emiln2002/BMS/slave_v2/Sources/README.md

# foxBMS 2

foxBMS is a free, open and flexible development environment to design battery
management systems. It is the first modular open source BMS development
platform.

## Documentation

A current build of the documentation of this project can be found
here:
- [latest documentation build (of the most recent release)](https://iisb-foxbms.iisb.fraunhofer.de/foxbms/gen2/docs/html/latest/)
- [list of all available documentation builds](https://iisb-foxbms.iisb.fraunhofer.de/foxbms/gen2/docs/html/)

## Changelog

The project changelog is found in
[docs/general/changelog.rst](./docs/general/changelog.rst).

## License

The license information of the project is found in [LICENSE.md](./LICENSE.md).

Basically, the software is covered by the
[**BSD 3-Clause License (SPDX short identifier: BSD-3-Clause)**](https://opensource.org/licenses/BSD-3-Clause)
and the hardware and documentation by the
[**Creative Commons Attribution 4.0 International License (SPDX short identifier: CC-BY-4.0)**](https://creativecommons.org/licenses/by/4.0/legalcode).

## Open Source Hardware Certification

foxBMS 2 has been certified as open source hardware by the
Open Source Hardware Association under the OSHWA UID
[DE000128](https://certification.oshwa.org/de000128.html).

## Acknowledgment

For funding acknowledgements and instructions on how to acknowledge foxBMS 2
please see [foxbms.org/acknowledgements](https://foxbms.org/acknowledgements/).
