emiln2002/BMS/master-v1.2.3-0/Sources/Project Outputs for foxbms2-master/pdf/foxbms2-master-Bill of Materials-v1.2.3-0.PDF

BR2477A/HBN 22u/10V | CoinCell Battery3V 1000mAHHITEMP MLCC | BT6401 C1100, C1101, C5000, C5001, C5002, C5007, C5010, C5013, C5016, C5017, C5018, C5019, C5020, C7210, C7211, C7212, C7220, C7239, C7240, C7247, C7248, C7250, C7251 | BR2477A-HBN CAPC3216X18N | BR2477A/HBN gen_C_ceramic_22u_1 0V_X7R_1206 | 1 23

100n/50V | MLCC | C1102, C1109_1, C1109_2, C1112_1, C1112_2, C1115, C1203, C1205, C1207, C1211, C1213, C1217, C1219, C1220, C1221, C1222, C1223, C1602, C3000, C4345, C4346, C4503_1, C4503_2, C4505_1, C4505_2, C5003, C5004, C5005, C5006, C5008, C5011, C5014, C5015, C5021, C5022, C5023, C5024, C5025, C5026, C5027, C5028, C6100, C6101, C6201, C6202, C6204, C6206, C6301_1, C6301_2, C6301_3, C6400, C6401, C6403, C6500, C6600, C6605, C7113, C7114, C7213, C7215, C7221, C7222, C7223, C7227, C7228, C7230, C7231, C7232, C7234, C7238, C7242, C7246, C7249, C7300_1, C7300_2, C8003, C8007, C8009 | CAPC1005X06N | gen_C_ceramic_100n_ 50V_X7R_0402 | 78

100n/100V | MLCC | C1103_1, C1103_2, C4501_1, C4501_2, C7000, C7109, C7111, C7115, C7206, C7218, C7226 | CAPC1608X08N | gen_C_ceramic_100n_ 100V_X7R_0603 | 11

1u/100V 10u/100V | MLCC | C1104_1, C1104_2 C1105_1, C1105_2, C7105, C7106, C7107, C7108, C7207, C7208, C7209, C7301_1, C7301_2, C7302_1, C7302_2 | CAPC3216X18N CAPC5750X28N | gen_C_ceramic_1u_10 0V_X7R_1206 gen_C_ceramic_10u_1 00V_X7S_2220 | 2 13

4n7/50V | MLCC | C1106_1, C1106_2 | CAPC1005X06N | gen_C_ceramic_4n7_5 0V_X7R_0402 | 2

10u/16V | MLCC | C1107_1, C1107_2, C1110_1, C1110_2, C1200, C1208, C1214, C6402, C7216, C7224, C7229, C7233, C7235, C7241, C8006, C8008, C8012 | CAPC2012X14N | gen_C_ceramic_10u_1 6V_X7R_0805 | 17

1u/50V | MLCC | C1108_1, C1108_2, C1111_1, C1111_2, C1202, C1204, C1206, C1210, C1212, C1216, C1218, C1600, C1601, C4344, C4347, C6200, C6203, C6205, C6300_1, C6300_2, C6300_3, C6606, C7110, C7116 | CAPC1608X08N | gen_C_ceramic_1u_50 V_X7R_0603 | 24

10n/25V | MLCC | C1201, C1209, C1215, C5009, C5012, C7001, C7244, C7245 | CAPC1005X06N | gen_C_ceramic_10n_2 5V_X7R_0402 | 8

1n/3000V | MLCC | C1224 | CAPC2220(5750)230_ N | gen_C_ceramic_1n_30 00V_X7R_2220 | 1

220n/35V 4u7/25V 150p/50V | MLCC MLCC MLCC | C1604, C7305_1, C7305_2 C1603 C4400, C4401, C7118, C7119, C7201 | CAPC1005X06N CAPC2012X14N CAPC1005X06N | gen_C_ceramic_220n_ gen_C_ceramic_4u7_2 5V_X7R_0805 gen_C_ceramic_150p_ 50V_C0G_0402 35V_X7R_0402 | 1 5 3

100µF/63V 10n/100V | SMDElectrolytic Capacitor MLCC | C4500_1, C4500_2 C4502_1, C4502_2, C4504_1, C4504_2, C4506_1, C4506_2, C4507_1, C4507_2 | ELECTROLYTIC_CAP_ PANASONIC_G CAPC1608X08N | EEE-TG1J101UP gen_C_ceramic_10n_1 00V_X7R_0603 | 2 8

47n/50V | MLCC | C6601, C7117, C7214, C7243, C7303_1, C7303_2 | CAPC1005X06N | gen_C_ceramic_47n_5 0V_X7R_0402 | 6

22n/50V | MLCC | C6602, C6604, C8000, C8001, C8002, C8004, C8005, C8010, C8011, C8013, C8014 | CAPC1005X06N | gen_C_ceramic_22n_5 0V_X7R_0402 | 11

27p/50V 22u/25V | MLCC | C6603 C7100, C7101, C7102, C7103, C7104 | CAPC1608X08N CAPC3225X25N | gen_C_ceramic_27p_5 gen_C_ceramic_22u_2 5V_X7R_1210 0V_NP0_0603 | 5 1

47p/50V 8n2/50V 5n6/50V | MLCC MLCC MLCC | C7112 C7200 C7120 | CAPC1005X06N CAPC1608X08N CAPC1608X08N | gen_C_ceramic_47p_5 0V_C0G_0402 gen_C_ceramic_8n2_5 gen_C_ceramic_5n6_5 0V_C0G_0603 0V_C0G_0603 | 1 1 1

33µF/100V 47n/100V 1n/100V 4u7/100V | SMDElectrolytic Capacitor MLCC MLCC MLCC | C7205 C7217, C7225 C7219, C7236, C7237 C7304_1, C7304_2 | ELECTROLYTIC_CAP_ PANASONIC_G CAPC1608X08N CAPC1005X06N CAPC3225X25N | EEE-TG2A330P gen_C_ceramic_47n_1 00V_X7R_0603 gen_C_ceramic_1n_10 0V_X7R_0402 gen_C_ceramic_4u7_1 00V_X7S_1210 | 1 2 3 2

1N4148WQ-7-F | Diode | D1100, D4400, D4401, D6400, D7004, D7006, D7303_1, D7303_2, D7305_1, D7305_2, D8000 | SOD-123_CASE-425-04-ISSUE-G | 1N4148WQ-7-F | 11

SM24CANB-02HTG puregreen | CANESDProtection DiodeArray TLMP1100-GS08 | D1102_1, D1102_2 D1200, D1201, D5000, D6601, D7000, D7001, D7002, D7005, D7200 | LF_SOT23-3 LEDC1608X07N | SM24CANB-02HTG LED_0603_pure_green _AECQ | 2 9

SZMMSZ4688T1G | Zener Diode | D4200_1, D4200_2, D4200_3, D4200_4, D4200_5, D4200_6, D4200_7, D4200_8, D6401, D7202 D4500_1, D4500_2, | SOD-123_CASE-425-04-ISSUE-G | SZMMSZ4688T1G | 10

SMA6J60A-Q | TVS-DiodeDO-214AC (SMA) | D4501_1, D4501_2, D4502_1, D4502_2, D4503_1, D4503_2 | BOURNS_DO-214AC_SMA | SMA6J60A-Q | 8

DFLS1100Q-7 DFLS130LQ-7 SZMMSZ5261BT1G SZMMSZ5237BT1G SZNUP2301MW6T1G | SchottkyDiode SchottkyDiode Zener Diode Zener Diode TVSdiodearray | D7100, D7101, D7102, D7201 D7203 D7307_1, D7307_2 D7306_1, D7306_2 D8001 | PowerDI123 PowerDI123 SOD-123_CASE-425-SOD-123_CASE-425-04-ISSUE-G ONSEMI_SC-88_SOT-363 04-ISSUE-G | DFLS130LQ-7 DFLS1100Q-7 SZMMSZ5237BT1G SZNUP2301MW6T1G SZMMSZ5261BT1G | 1 4 2 1 2

600Ω 64900429522 | FerriteBead | FB5000, FB5001, FB5002 J2000, J2002, J2003, J2004, J2006, J2007, J2008, J2010, J2021, J2024, J2034 | RESC1005X04N 64900429522 | gen_Ferrite_600R_040 2 CMP-1502-00518-2 | 3 11

64900829522 64900229522 64900629522 samtec_FTSH-103-01-L-DV | Board-To-Board Connector, 6pin, 1.27mm | J2009 J2033 J2013 J3000 | 64900829522 64900229522 64900629522 SAMTEC_FTSH-103-01-L-DV | CMP-1502-00520-2 CMP-1502-00517-2 CMP-1502-00519-2 samtec_FTSH-103-01-L-DV | 1 1

TE_2-5767004-2 ERM8-020-09.0-L-DV-K-TR | EdgeRateruggedhigh-Connector, SMT, 38 POS, MICTOR speedconnector strips | J3008 J9000 | TE_2-5767004-2 SAMTEC_ERM8-020-09.0-L-DV-K | TE_2-5767004-2 SAMTEC_ERM8-020-09.0-L-DV-K-TR | 1 1

ERM8-030-09.0-L-DV-K-TR | EdgeRateruggedhigh-speedconnector strips | J9001 | SAMTEC_ERM8-030-09.0-L-DV-K | SAMTEC_ERM8-030-09.0-L-DV-K-TR | 1

ERM8-060-09.0-L-DV-K-TR | EdgeRateruggedhigh-speedconnector strips | J9002 | SAMTEC_ERM8-060-09.0-L-DV-K | SAMTEC_ERM8-060-09.0-L-DV-K-TR | 1

WE_615008137421 | Modular Jack WR-MJ, TabUp | J? | WE_615008137421 | WE_615008137421 | 1

2.2µH 10µH 100uH 1µH 6.8µH | Power Inductor Power Inductor CommonModeChoke Power Inductor Power Inductor | L7100 L1600 L1100_1, L1100_2 L7200 L7201 | COILCRAFT_XAL1010 INDC2012X14N MURATA_DLW32SH ASPIAIG-S4035 PA4342.XXXNLT_Foot print_2 | XAL1010-222MEB LQM21DH100M70L DLW32SH101XF2L ASPIAIG-S4035-1R0M-T PA4342.682NLT | 1 1 2 1 1

4.7µH 1µH DMP10H4D2S-7 | Power Inductor Power Inductor MOSFET-Transistor, p-Kanal, 0.27A, 100V, 4.2 ohm | L7202 L7203, L7204, L7205 Q1101_1, Q1101_2, Q4400 | ASPIAIG-S4035 TDK_TFM252012 SOT95P237X110-3N | ASPIAIG-S4035-4R7M-TFM252012ALMA1R0 MTAA T DMP10H4D2S-7 | 3 1 3

SI2302CDS-T1-GE | MOSFET, NCHANNEL, 20V, 0.045OHM, 2.6A, TO-236 | Q4200 | SOT95P237X112-3N | SI2302CDS-T1-GE | 1

DMN10H220L-7 | MOSFET-Transistor, n-Kanal, 1.6A, 100V, 0.250ohm | Q4401 | SOT95P237X110-3N | DMN10H220L-7 | 1

STL115N10F7AG | N-Channel MOSFET, 100V, 107A, 5mOhm | Q4402, Q7100, Q7101, Q7102, Q7103, Q7300_1, Q7300_2, Q7301_1, Q7301_2, Q8000 | ST_PowerFLAT_5x6_W F_type_C | STL115N10F7AG | 10

SP000870646 BUK9K13-60EX | Dual N-channel 60V, MOSFETsN-Ch100V 190mASOT-23-3 12.5 mΩlogic level MOSFET | Q6400 Q7202 | SOT95P237X110-3N NXP-SOT1205_N | SP000870646 BUK9K13-60EX | 1 1

ZXTN4240F-7 SQ2309ES-T1_GE3 0R | Single NPNTransistor MOSFET-Transistor, p-channel, -1.7A, -60V SMDResistor 0R0402 | Q7302_1, Q7302_2 Q7203 R1100, R1101, R1102, R1106, R1107_1, R1107_2, R1108_1, R1108_2, R1208, R1209, R1210, R1211, R4408, R4410, R4514_1, R4514_2, R4515_1, R4515_2, R4516_1, R4516_2, R4517_1, R4517_2, R6602, R6603, R6606, R6607, R7219, R7247, R7248, R7249, R7310_1, R7310_2, R8026, R8027 R1103_1, R1103_2, | DIODES_SOT23_NPN SOT95P237X110-3N RESC1005X04N | ZXTN4240F-7 SQ2309ES-T1_GE3 gen_R_0R_0402 | 2 1 34

10k | SMDResistor 10k 0402 | R1104_1, R1104_2, R1105_1, R1105_2, R1109_1, R1109_2, R1114_1, R1114_2, R1116_1, R1116_2, R1117_1, R1117_2, R1223, R1601, R1602, R1603, R1604, R1605, R1606, R1607, R1608, R4201, R4401, R4402, R4403, R4412, R4413, R4500, R4504_1, R4504_2, R4505_1, R4505_2, R4506_1, R4506_2, R4507_1, R4507_2, R4509_1, R4509_2, R4510_1, R4510_2, R4511_1, R4511_2, R4512_1, R4512_2, R6100, R6101, R6302_1, R6302_2, R6302_3, R6303_1, R6303_2, R6303_3, R6304_1, R6304_2, R6304_3, R6305_1, R6305_2, R6305_3, R6306_1, | RESC1005X04N | gen_R_10k_0402 | 181

120R | SMDResistor 120R 1206 | R6306_2, R6306_3, R1110_1, R1110_2, R1111_1, R1111_2, R1112_1, R1112_2, R1113_1, R1113_2 | RESC3216X06N | gen_R_120R_1206 | 8

100R | SMDResistor 100R 0402 | R1115_1, R1115_2, R4200, R4400, R6407, R7101, R7102, R7107, R7109, R7202 | RESC1005X04N | gen_R_100R_0402 | 10

2k49 | SMDResistor 2k49 0402 | R1200, R1201, R1202, R1203, R1212, R1213, R1214, R1215, R1224, R1225, R1226, R4205_1, R4205_2, R4205_3, R4205_4, R4205_5, R4205_6, R4205_7, R4205_8, R6300, R6301, R6403, R6404, R6500, R6501, R7103, R7236, R7237, R8011, R8012, R8022 | RESC1005X04N | gen_R_2k49_0402 | 31

120R 75R 11k | SMDResistor 120R SMDResistor 75R 0402 0402 SMDResistor 11k 0402 | R1204, R1205, R1206, R1207 R1216, R1217, R1218, R1219, R1220 R1221 R1222, R3000, R3004, | RESC1005X04N RESC1005X04N RESC1005X04N | gen_R_120R_0402 gen_R_75R_0402 gen_R_11k_0402 | 4 5 1

5k1 | SMDResistor 5k1 0402 | R3009, R7207, R7229, R7231, R7232, R7235, R7240, R7241, R7242, R7243 | RESC1005X04N | gen_R_5k1_0402 | 13

2k2 | SMDResistor 2k2 0402 | R1227 | RESC1005X04N | gen_R_2k2_0402 | 1

2R 390R 220R | SMDResistor 2R0805 SMDResistor 390R 0402 SMDResistor 220R 0402 | R1600, R8016 R1611, R6608, R7002, R1609, R1610, R1612, R1613 R7007, R7234, R7244, R7250 | RESC2012X05N RESC1005X04N RESC1005X04N | gen_R_2R_0805 gen_R_390R_0402 gen_R_220R_0402 | 2 4 7

22R 86R6 | SMDResistor Array 04028x SMDResistor 86R6 2010 | R4202_1, R4202_2, R3150 R4202_3, R4202_4, R4202_5, R4202_6, R4202_7, R4202_8 | PANASONIC_EXB2HV RESC5025X07N | EXB2HV220JV gen_R_86R6_2010 | 1 8

5k6 | SMDResistor 5k6 0402 | R4203_1, R4203_2, R4203_3, R4203_4, R4203_5, R4203_6, R4203_7, R4203_8, R4206_1, R4206_2, R4206_3, R4206_4, R4206_5, R4206_6, R4206_7, R4206_8, R7000, R7004, R8002, R8010 | RESC1005X04N | gen_R_5k6_0402 | 20

33R | SMDResistor 33R 2010 | R4204_1, R4204_2, R4204_3, R4204_4, R4204_5, R4204_6, R4204_7, R4204_8 | RESC5025X07N | gen_R_33R_2010 | 8

1k5 680R 47k | SMDResistor 1k5 SMDResistor 680R 0402 0402 SMDResistor 47k 0402 | R4405, R4407, R4411 R4404, R4406, R4409 R4501_1, R4501_2, R4502_1, R4502_2, R4503_1, R4503_2, R4508_1, R4508_2 | RESC1005X04N RESC1005X04N RESC1005X04N | gen_R_680R_0402 gen_R_1k5_0402 gen_R_47k_0402 | 3 3 8

47k5 33R | SMDResistor 47k5 SMDResistor 33R 0402 0402 | R5000, R7306_1, R7306_2 R4513_1, R4513_2 | RESC1005X04N | gen_R_33R_0402 gen_R_47k5_0402 | 3 2

100k | SMDResistor 100k 0402 | R6200, R6201, R6202, R6203, R6204, R6205, R6206, R6207, R6408, R6409, R6410, R6411, R7238, R7251, R7307_1, R7307_2 | RESC1005X04N | gen_R_100k_0402 | 16

10k 20k 1k91 | SMDResistor 10k 0603 SMDResistor 20k 0402 SMDResistor 1k91 0402 | R6402, R6412, R6413 R6604, R7113, R7205 R7001, R7206 | RESC1608X05N RESC1005X04N RESC1005X04N | gen_R_10k_0603 gen_R_20k_0402 gen_R_1k91_0402 | 3 3 2

0R005 866R 10R | SMDShunt Resistor SMDResistor 866R 0402 SMDResistor 10R 0R005 0402 | R7100, R7108, R7008 R7104, R7303_1, R7301_1, R7301_2 R7303_2, R8014, R8017 | RESC1005X04N PANASONIC_ERJMS4H ERJ-MS4HF5M0U RESC1005X04N | gen_R_866R_0402 gen_R_10R_0402 | 1 4 5

93k1 23k7 280k | SMDResistor 93k1 SMDResistor 23k7 0402 0402 SMDResistor 280k 0402 | R7111 R7110 R7112 | RESC1005X04N RESC1005X04N RESC1005X04N | gen_R_23k7_0402 gen_R_93k1_0402 gen_R_280k_0402 | 1 1 1

0R 4k7 26k7 | SMDResistor 0R2512 SMDResistor 4k7 0402 SMDResistor 26k7 0402 | R7115 R7114, R7209, R7210 R7208 | RESC6331X07N RESC1005X04N RESC1005X04N | gen_R_0R_2512 gen_R_4k7_0402 gen_R_26k7_0402 | 1 3 1

0R015 470k 1M | SMDShunt Resistor 0R015 SMDResistor 470k 0402 SMDResistor 1M0402 | R7226 R7233 R7227, R7228 | PANASONIC_ERJ-B1 RESC1005X04N RESC1005X04N | ERJ-B1CFR015U gen_R_470k_0402 gen_R_1M_0402 | 1 1 2

240k | SMDResistor 240k 0402 | R7304_1, R7304_2, R7305_1, R7305_2, R7311_1, R7311_2, R8021 | RESC1005X04N | gen_R_240k_0402 | 7

330R | SMDResistor 330R 0603 | R8000 | RESC1608X05N | gen_R_330R_0603 | 1

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
