emiln2002/BMS/interface-nxp-mc33664-v1.0.2/Assembly default-no-alarm/bom-online/bom-online-foxbms2-interface-mc33664(default-no-alarm).xlsx

Sheet: BOM
BOM for foxbms2-interface-mc33664, Variant default-no-alarm
Generated on 2023-01-12 18:06
Line # | Designator | Quantity | Name | Description | Case EIA | Manufacturer 1 | Manufacturer Part Number 1 | Supplier 1 | Supplier Part Number 1
1 | C200_1, C200_2, C203_1, C203_2, C204_1, C204_2 | 6 | 1u/50V | MLCC | 0805 | TDK | CGA4J3X7R1H105K125AE | Farnell | 2464630
2 | C201_1, C201_2, C202_1, C202_2 | 4 | 100n/50V | MLCC | 0603 | Murata | GCM188L81H104KA57D | Digi-Key | 490-6049-1-ND
3 | C205_1, C205_2, C206_1, C206_2, C301_1, C301_2 | 6 | 100p/50V | MLCC | 0603 | KEMET | C0603C101K5GACAUTO | Farnell | 2478236
4 | C300_1, C300_2 | 2 | 4n7/50V | MLCC | 0603 | KEMET | C0603C472J5RACAUTO | Farnell | 2904754
6 | D200_1, D200_2, D201_1, D201_2 | 4 | PESD5V0V1BB | Very low capacitance bidirectional ESD protection diode |  | Nexperia | PESD5V0V1BB,115 | Farnell | 2069367
7 | J100 | 1 | ERF8-020-05.0-L-DV-K | Edge Rate rugged high-speed connector strips |  | Samtec | ERF8-020-05.0-L-DV-L-K-TR | Digi-Key | SAM13550CT-ND
8 | J101, J102 | 2 | molex_microfit_3_01x2_THT | Micro-Fit 3.0 Right Angle Header, 3.00mm Pitch, Dual Row, 2 Circuits, with Snap-in Plastic Peg PCB Lock, Tin, Glow Wire Capable, Black, 43045-0200 |  | Molex | 43045-0200 | Farnell | 1012251
20 | MP100 | 1 | VCC_LPCR050CTP | Lightpipe Clear LPCR Series |  | Visual Communications | LPCR050CTP | Digi-Key | LPCR050CTP-ND
21 | MP101 | 1 | VCC_RTN_150 | Grommet Retainer for LPC and LPCR Series Light Pipe |  | Visual Communications | RTN_150 | Digi-Key | RTN_150-ND
22 | MP102, MP103, MP104, MP105 | 4 | WE_9774140360R | WA-SMSI SMT Steel Spacer with internal thread M 3 |  | Wurth Electronics | 9774140360R | Digi-Key | 732-5281-1-ND
11 | R100, R102, R203_1, R203_2, R204_1, R204_2, R205_1, R205_2 | 8 | 0R | SMD Resistor 0R 0603 | 0603 | Vishay Semiconductors | RCA06030000ZSEA | Farnell | 2616580
12 | R200_1, R200_2, R201_1, R201_2, R202_1, R202_2, R206_1, R206_2, R207_1, R207_2, R208_1, R208_2 | 12 | 10k | SMD Resistor 10k 0603 | 0603 | Multicomp | MCMR06X1002FTL | Farnell | 2073349
13 | R300_1, R300_2, R301_1, R301_2 | 4 | 75R | SMD Resistor 75R 0603 | 0603 | Panasonic | ERJ-UP3F75R0V | Mouser | 667-ERJ-UP3F75R0V
15 | T300_1, T300_2 | 2 | HM2102NLT | Pulse HM2102NLT BMS Transformer |  | Pulse | HM2102NLT | Mouser | 673-HM2102NLT
16 | U200_1, U200_2 | 2 | MC33664ATL1EG | Isolated network high-speed transceiver |  | NXP Freescale | MC33664ATL1EG | Farnell | 2890308

Sheet: DATA
foxbms2-interface-mc33664.PrjPcb
2023-01-12 18:06
default-no-alarm
