emiln2002/BMS/master-v1.2.3-0/Assembly production/bom/foxbms2-master-bom-v1.2.3-0.xlsx

Project: | foxbms2-master.PrjPcb
Generated: | 31.03.2025 12:12
Variant: | production
Line # | Designator | Quantity | Name | Description | Case EIA | Manufacturer 1 | Manufacturer Part Number 1 | Supplier 1 | Supplier Part Number 1 | Automotive Qualified | AEC-Q Norm | AEC-Q Grade | ECCN
81 | R1105_1, R1105_2, R1109_1, R1109_2, R1114_1, R1116_1, R1116_2, R1117_1, R1117_2, R1223, R1605, R1606, R1607, R1608, R4201, R4401, R4402, R4403, R4412, R4413, R4500, R4509_1, R4509_2, R4510_1, R4510_2, R4511_1, R4511_2, R4512_1, R4512_2, R6317_1, R6318_1, R6318_2, R6318_3, R6319_1, R6319_2, R6319_3, R6320_2, R6320_3, R6321_2, R6321_3, R6322_2, R6322_3, R6323_2, R6323_3, R6324_2, R6324_3, R6325_2, R6325_3, R6326_2, R6326_3, R6327_2, R6327_3, R6328_1, R6328_2, R6328_3, R6329_1, R6329_2, R6329_3, R6330_1, R6330_2, R6330_3, R6331_1, R6331_2, R6331_3, R6332_1, R6332_2, R6332_3, R6333_1, R6333_2, R6333_3, R6334_1, R6334_2, R6334_3, R6335_2, R6335_3, R6400, R6401, R6600, R6601, R6605, R7005, R7006, R7200, R7201, R7203, R7204, R7230, R7239, R7245, R7246, R7308_1, R7308_2, R7309_1, R7309_2, R8001, R8003, R8005, R8006, R8007, R8008, R8009, R8015, R8020, R8024 | 104 | 10k | SMD Resistor 10k 0402 | 402 | Panasonic | ERJ-2GEJ103X | Farnell | 2059239 | TRUE | AEC-Q200 |  | EAR99
2 | C1102, C1109_1, C1109_2, C1112_1, C1112_2, C1115, C1203, C1205, C1207, C1211, C1213, C1217, C1219, C1220, C1221, C1222, C1223, C1602, C3000, C4345, C4346, C4503_1, C4503_2, C4505_1, C4505_2, C5003, C5004, C5005, C5006, C5008, C5011, C5014, C5015, C5021, C5022, C5023, C5024, C5025, C5026, C5027, C5028, C6100, C6101, C6201, C6202, C6204, C6206, C6301_1, C6301_2, C6301_3, C6400, C6401, C6403, C6500, C6600, C6605, C7213, C7215, C7221, C7222, C7223, C7227, C7228, C7230, C7231, C7232, C7234, C7238, C7242, C7246, C7249, C7300_1, C7300_2, C8003, C8007, C8009 | 76 | 100n/50V | MLCC | 402 | TDK | CGA2B3X7R1H104K050BB | Farnell | 2210822 | TRUE | AEC-Q200 |  | EAR99
23 | C1100, C1101, C5000, C5001, C5002, C5007, C5010, C5013, C5016, C5017, C5018, C5019, C5020, C7210, C7211, C7212, C7220, C7239, C7240, C7247, C7248, C7250, C7251 | 23 | 22u/10V | MLCC | 1206 | Taiyo Yuden | LMJ316BB7226KLHT | Digi-Key | 587-4243-1-ND | TRUE
3 | C1108_1, C1108_2, C1111_1, C1111_2, C1202, C1204, C1206, C1210, C1212, C1216, C1218, C1600, C1601, C4344, C4347, C6200, C6203, C6205, C6300_1, C6300_2, C6300_3, C6606 | 22 | 1u/50V | MLCC | 603 | Taiyo Yuden | UMK107AB7105KA-T | Farnell | 2779055 | FALSE
108 | R4203_1, R4203_2, R4203_3, R4203_4, R4203_5, R4203_6, R4203_7, R4203_8, R4206_1, R4206_2, R4206_3, R4206_4, R4206_5, R4206_6, R4206_7, R4206_8, R7000, R7004, R8002, R8010 | 20 | 5k6 | SMD Resistor 5k6 0402 | 402 | TE Connectivity | CRGCQ0402F5K6 | Digi-Key | A129636CT-ND | TRUE | AEC-Q200 | Grade 0 | EAR99
84 | R1202, R1215, R1225, R4205_1, R4205_2, R4205_3, R4205_4, R4205_5, R4205_6, R4205_7, R4205_8, R6300, R6301, R7236, R7237, R8011, R8012, R8022 | 18 | 2k49 | SMD Resistor 2k49 0402 | 402 | Panasonic | ERJ-2RKF2491X | Farnell | 2059135 | TRUE
8 | C1107_1, C1107_2, C1110_1, C1110_2, C1200, C1208, C1214, C6402, C7216, C7224, C7229, C7233, C7235, C7241, C8006, C8008, C8012 | 17 | 10u/16V | MLCC | 805 | TDK | CGA4J1X7S1C106K125AC | Digi-Key | 445-16110-1-ND | TRUE | AEC-Q200 | Grade 1 | EAR99
80 | R1100, R1101, R1102, R1107_1, R1107_2, R1108_1, R1108_2, R1209, R1211, R4408, R6602, R7247, R7248, R7249, R8026, R8027 | 16 | 0R | SMD Resistor 0R 0402 | 402 | Panasonic | ERJ-2GE0R00X | Farnell | 2059190 | TRUE | AEC-Q200 |  | EAR99
97 | R6200, R6201, R6202, R6203, R6204, R6205, R6206, R6207, R6408, R6409, R6410, R6411, R7238, R7251, R7307_1, R7307_2 | 16 | 100k | SMD Resistor 100k 0402 | 402 | Panasonic | ERJ-2RKF1003X | Farnell | 2302839 | TRUE
88 | R1222, R3000, R3004, R3009, R7207, R7229, R7231, R7232, R7235, R7240, R7241, R7242, R7243 | 13 | 5k1 | SMD Resistor 5k1 0402 | 402 | Panasonic | ERJ-2RKF5101X | Farnell | 2302709 | TRUE | AEC-Q200 | Grade 0 | EAR99
19 | C6602, C6604, C8000, C8001, C8002, C8004, C8005, C8010, C8011, C8013, C8014 | 11 | 22n/50V | MLCC | 402 | Murata | GCM155R71H223KA55D | Digi-Key | 490-4763-1-ND | TRUE | AEC-Q200 | Grade 1 | EAR99
35 | D1100, D4400, D4401, D6400, D7004, D7006, D7303_1, D7303_2, D7305_1, D7305_2, D8000 | 11 | 1N4148WQ-7-F | Diode |  | Diodes Zetex | 1N4148WQ-7-F | Digi-Key | 1N4148WQ-7-FDICT-ND | TRUE
53 | J2000, J2002, J2003, J2004, J2006, J2007, J2008, J2010, J2021, J2024, J2034 | 11 | molex_microfit_3_02x2_THT | Micro-Fit 3.0 Right Angle Header, 3.00mm Pitch, Dual Row, 4 Circuits, with Snap-in Plastic Peg PCB Lock, Tin, Glow Wire Capable, Black, 43045-0400 |  | Molex | 430450400 | Farnell | 9733019 | FALSE |  |  | EAR99
44 | D4200_1, D4200_2, D4200_3, D4200_4, D4200_5, D4200_6, D4200_7, D4200_8, D6401, D7202 | 10 | SZMMSZ4688T1G | Zener Diode |  | ON Semiconductor | SZMMSZ4688T1G | Farnell | 2774579 | TRUE
6 | C1105_1, C1105_2, C7207, C7208, C7209, C7301_1, C7301_2, C7302_1, C7302_2 | 9 | 10u/100V | MLCC | 2220 | TDK | CGA9N3X7S2A106M230KB | Digi-Key | 445-13152-1-ND | TRUE | AEC-Q200 | Grade 0 | EAR99
37 | D1200, D1201, D5000, D6601, D7000, D7001, D7002, D7005, D7200 | 9 | pure green | TLMP1100-GS08 |  | Vishay | TLMP1100-GS08 | Farnell | 1328306 | TRUE
 | R4501_1, R4501_2, R4502_1, R4502_2, R4503_1, R4503_2, R4508_1, R4508_2 | 8 | 47k | SMD Resistor 47k 0402 | 402 | TE Connectivity | CRGCQ0402F47K | Digikey | A129647CT-ND | TRUE | AEC-Q200 | Grade 0 | EAR99
4 | C1103_1, C1103_2, C4501_1, C4501_2, C7000, C7206, C7218, C7226 | 8 | 100n/100V | MLCC | 603 | Murata | GCJ188R72A104KA01D | Digi-Key | 490-13420-1-ND | TRUE
9 | C1201, C1209, C1215, C5009, C5012, C7001, C7244, C7245 | 8 | 10n/25V | MLCC | 402 | TDK | CGA2B2X7R1E103K050BA | Farnell | 2210793 | TRUE
22 | C4502_1, C4502_2, C4504_1, C4504_2, C4506_1, C4506_2, C4507_1, C4507_2 | 8 | 10n/100V | MLCC | 603 | TDK | CGA3E2X7R2A103K080AA | Farnell | 2210878 | TRUE | AEC-Q200 |  | EAR99
48 | D4500_1, D4500_2, D4501_1, D4501_2, D4502_1, D4502_2, D4503_1, D4503_2 | 8 | SMA6J60A-Q | TVS-Diode DO-214AC (SMA) |  |  |  | Mouser | 652-SMA6J60A-Q | TRUE | AEC-Q101 | Grade 0 | EAR99
82 | R1110_1, R1110_2, R1111_1, R1111_2, R1112_1, R1112_2, R1113_1, R1113_2 | 8 | 120R | SMD Resistor 120R 1206 | 1206 | TE Connectivity | CRGCQ1206F120R | Digi-Key | A129799CT-ND | TRUE | AEC-Q200 | Grade 0 | EAR99
122 | R7304_1, R7304_2, R7305_1, R7305_2, R7311_1, R7311_2, R8021 | 7 | 240k | SMD Resistor 240k 0402 | 402 | Panasonic | ERJ-2RKF2403X | Digi-Key | P240KLCT-ND | TRUE | AEC-Q200 | Grade 0 | EAR99
76 | Q4402, Q7300_1, Q7300_2, Q7301_1, Q7301_2, Q8000 | 6 | STL115N10F7AG | N-Channel MOSFET, 100 V, 107 A, 5 mOhm |  | STMicroelectronics | STL115N10F7AG | Mouser | 511-STL115N10F7AG | TRUE | AEC-Q101 | Grade 0 | EAR99
93 | R6608, R7002, R7007, R7234, R7244, R7250 | 6 | 220R | SMD Resistor 220R 0402 | 402 | TE Connectivity | CRGCQ0402F220R | Digi-Key | A129619CT-ND | TRUE | AEC-Q200 | Grade 0 | EAR99
24 | C6601, C7214, C7243, C7303_1, C7303_2 | 5 | 47n/50V | MLCC | 402 | TDK | CGA2B3X7R1H473K050BB | Farnell | 2210827 | TRUE
83 | R1115_1, R4200, R4400, R6407, R7202 | 5 | 100R | SMD Resistor 100R 0402 | 402 | Panasonic | ERJ-2RKF1000X | Farnell | 2302528 | TRUE | AEC-Q200 |  | EAR99
86 | R1216, R1217, R1218, R1219, R1220 | 5 | 75R | SMD Resistor 75R 0402 | 402 | Panasonic | ERJ-2RKF75R0X | Farnell | 2059111 | TRUE | AEC-Q200 | Grade 0 | EAR99
102 | R7303_1, R7303_2, R8014, R8017 | 4 | 10R | SMD Resistor 10R 0402 | 402 | Panasonic | ERJ-2RKF10R0X | Farnell | 2302417 | TRUE
12 | C1604, C7305_1, C7305_2 | 3 | 220n/35V | MLCC | 402 | TDK | CGA2B1X7R1V224K050BE | Digi-Key | 445-173767-1-ND | TRUE | AEC-Q200 | Grade 1 | EAR99
15 | C7219, C7236, C7237 | 3 | 1n/100V | MLCC | 402 | Murata | GCM155R72A102KA37D | Digi-Key | 490-4764-1-ND | TRUE
28 | C4400, C4401, C7201 | 3 | 150p/50V | MLCC | 402 | Murata | GCM1555C1H151JA16D | Digi-Key | 490-4926-1-ND | TRUE
50 | FB5000, FB5001, FB5002 | 3 | 600Ω | Ferrite Bead |  | TDK | MMZ1005B601CTD25 | Digi-Key | 445-172776-1-ND | TRUE
71 | L7203, L7204, L7205 | 3 | 1µH | Power Inductor |  | TDK | TFM252012ALMA1R0MTAA | Digi-Key | 445-175183-1-ND | TRUE
104 | R4404, R4406, R4409 | 3 | 1k5 | SMD Resistor 1k5 0402 | 402 | Vishay | CRCW04021K50FKED | Farnell | 1653201 | TRUE
105 | R4405, R4407, R4411 | 3 | 680R | SMD Resistor 680R 0402 | 402 | Panasonic | ERJ-2RKF6800X | Farnell | 2302619 | TRUE | AEC-Q200 | Grade 0 | EAR99
106 | R5000, R7306_1, R7306_2 | 3 | 33R | SMD Resistor 33R 0402 | 402 | TE Connectivity | CRGCQ0402F33R | Digi-Key | A129609CT-ND | TRUE | AEC-Q200 | Grade 0 | EAR99
131 | R6402, R6412, R6413 | 3 | 10k | SMD Resistor 10k 0603 | 603 | Panasonic | ERJ-3EKF1002V | Farnell | 2303192 | TRUE | AEC-Q200 |  | EAR99
147 | U6300_1, U6300_2, U6300_3 | 3 | PCA9539PW | 16-bit I2C-bus and SMBus low power I/O port with interrupt and reset |  | NXP Semiconductors | PCA9539PW/Q900,118 | Mouser | 771-PCA9539PW/Q90011 | FALSE
 | L1100_1, L1100_2 | 2 | 100uH | Common Mode Choke |  | Murata | DLW32SH101XF2L | Farnell | 3639227 | TRUE | AEC-Q200
5 | C1104_1, C1104_2 | 2 | 1u/100V | MLCC | 1206 | Kyocera AVX | 12061C105K4Z2A | Farnell | 1833855 | TRUE
7 | C1106_1, C1106_2 | 2 | 4n7/50V | MLCC | 402 | Murata | GCM155R71H472KA37J | Digi-Key | 490-14739-1-ND | TRUE | AEC-Q200 | Grade 1 | EAR99
21 | C4500_1, C4500_2 | 2 | 100µF/63V | SMD Electrolytic Capacitor |  | Panasonic | EEE-TG1J101UP | Digi-Key | PCE4086CT-ND | TRUE
33 | C7217, C7225 | 2 | 47n/100V | MLCC | 603 | KEMET | C0603C473K1RECAUTO | Farnell | 2708699 | TRUE
34 | C7304_1, C7304_2 | 2 | 4u7/100V | MLCC | 1210 | TDK | CGA6M3X7S2A475K200AB | Farnell | 2211140 | TRUE
36 | D1102_1, D1102_2 | 2 | SM24CANB-02HTG | CAN ESD Protection Diode Array |  | Littelfuse | SM24CANB-02HTG | Digi-Key | F6707CT-ND | TRUE
46 | D7306_1, D7306_2 | 2 | SZMMSZ5237BT1G | Zener Diode |  | ON Semiconductor | SZMMSZ5237BT1G | Digi-Key | SZMMSZ5237BT1GOSCT-ND | TRUE
47 | D7307_1, D7307_2 | 2 | SZMMSZ5261BT1G | Zener Diode |  | ON Semiconductor | SZMMSZ5261BT1G | Digi-Key | SZMMSZ5261BT1GOSCT-ND | TRUE
72 | Q1101_1, Q4400 | 2 | DMP10H4D2S-7 | MOSFET-Transistor, p-Kanal, 0.27 A, 100 V, 4.2 ohm |  | Diodes | DMP10H4D2S-7 | Farnell | 3127354 | TRUE
79 | Q7302_1, Q7302_2 | 2 | ZXTN4240F-7 | Single NPN Transistor |  | Diodes | ZXTN4240F-7 | Digi-Key | ZXTN4240F-7DICT-ND | TRUE
85 | R1204, R1206 | 2 | 120R | SMD Resistor 120R 0402 | 402 | Panasonic | ERJ-2RKF1200X | Farnell | 2302535 | TRUE | AEC-Q200 |  | EAR99
91 | R1600, R8016 | 2 | 2R | SMD Resistor 2R 0805 | 805 |  |  | Digikey | P19275CT-ND | TRUE | AEC-Q200 | Grade 0 | EAR99
95 | R4513_1, R4513_2 | 2 | 47k5 | SMD Resistor 47k5 0402 | 402 | Panasonic | ERA-2AEB4752X | Farnell | 2563598 | TRUE | AEC-Q200 | Grade 0 | EAR99
107 | R6604, R7205 | 2 | 20k | SMD Resistor 20k 0402 | 402 | Panasonic | ERJ-2GEJ203X | Farnell | 2059242 | TRUE | AEC-Q200 |  | EAR99
110 | R7301_1, R7301_2 | 2 | 0R005 | SMD Shunt Resistor 0R005 | 2512 | Panasonic | ERJ-MS4HF5M0U | Digi-Key | P17093CT-ND | TRUE
115 | R7209, R7210 | 2 | 4k7 | SMD Resistor 4k7 0402 | 402 | Panasonic | ERJ-2RKF4701X | Farnell | 2302707 | TRUE
116 | R7001, R7206 | 2 | 1k91 | SMD Resistor 1k91 0402 | 402 | Panasonic | ERJ-2RKF1911X | Digi-Key | P1.91KLCT-ND | TRUE | AEC-Q200 | Grade 0 | EAR99
121 | R7227, R7228 | 2 | 1M | SMD Resistor 1M 0402 | 402 | TE Connectivity | CRGCQ0402F1M0 | Digi-Key | A129663CT-ND | TRUE | AEC-Q200 | Grade 0 | EAR99
123 | R8004, R8013 | 2 | 3k9 | SMD Resistor 3k9 0402 | 402 | Panasonic | ERJ-2RKF3901X | Farnell | 2302698 | TRUE | AEC-Q200 | Grade 0 | EAR99
126 | S4500, S6600 | 2 | WS-DISV | WS-DISV Small Compact SMT DipSwitch |  | Wurth Electronics | 416131160801 | Digi-Key | 732-3851-1-ND | FALSE
128 | T1200, T1201 | 2 | SM91074ALE | 10/100 Base-T Transformer |  | Bourns | SM91074AL-E | Farnell | 2932105 | TRUE
132 | U1101_1, U1101_2 | 2 | TCAN1043HDQ1 | Low-Power Fault Protected CAN Transceiver with CAN FD and Wake |  | Texas Instruments | TCAN1043HDQ1 | Mouser | 595-TCAN1043HDQ1 | TRUE | AEC-Q100 | Grade 1 | EAR99
141 | U4500_1, U4500_2 | 2 | MC33XS2410EL | Quad 100 mΩ / dual 50 mΩ, 3.0 V to 60 V high-side switch |  |  |  |  |  | TRUE
153 | U7300_1, U7300_2 | 2 | LTC4380HMS-4#PBF | Low Quiescent Current Surge Stopper |  | Analog Devices / Linear Technology | LTC4380HMS-4#PBF | Digi-Key | LTC4380HMS-4#PBF-ND | FALSE
 | R1227 | 1 | 2k2 | SMD Resistor 2k2 0402 | 402 | Panasonic | ERJ-U02F2201X | Farnell | 4136977 | TRUE | AEC-Q200
 | Y6101 | 1 | SiT1618BA-31-33N-25.000000 | Automotive & High Temp Oscillators |  | SiTime | SIT1618BA-31-33N-25.000000 | Digikey | 1473-SIT1618BA-31-33N-25.000000-ND | FALSE |  |  | EAR99
 | Y6100 | 1 | SiT1618BA-32-33N-20.000000 | Automotive & High Temp Oscillators |  | SiTime | SIT1618BA-32-33N-20.000000 | Digikey | 1473-SIT1618BA-32-33N-20.000000-ND | FALSE |  |  | EAR99
1 | BT6400 | 1 | SMTU_1225-1-LF | SMTU 1225-1-LF, Battery Holder 1225 |  | Renata | SMTU1225-LF | Farnell | 1216353 | FALSE
10 | C1224 | 1 | 1n/3000V | MLCC | 2220 | KEMET | C2220C102KHRACAUTO | Digi-Key | 399-16803-1-ND | TRUE | AEC-Q200 | Grade 0 | EAR99
11 | C1603 | 1 | 4u7/25V | MLCC | 805 | TDK | CGA4J1X7R1E475K125AC | Farnell | 2346968 | TRUE | AEC-Q200 |  | EAR99
25 | C6603 | 1 | 27p/50V | MLCC | 603 | KEMET | C0603X270J5GACAUTO | Farnell | 2219430 | TRUE
30 | C7200 | 1 | 8n2/50V | MLCC | 603 | TDK | CGJ3E2C0G1H822J080AA | Digi-Key | 445-8114-1-ND | TRUE
32 | C7205 | 1 | 33µF/100V | SMD Electrolytic Capacitor |  | Panasonic | EEE-TG2A330P | Digi-Key | PCE4126CT-ND | TRUE
38 | D7203 | 1 | DFLS1100Q-7 | Schottky Diode |  | Diodes | DFLS1100Q-7 | Farnell | 3127293 | TRUE
45 | D7201 | 1 | DFLS130LQ-7 | Schottky Diode |  | Diodes | DFLS130LQ-7 | Digi-Key | DFLS130LQ-7DICT-ND | TRUE
49 | D8001 | 1 | SZNUP2301MW6T1G | TVS diode array |  | ON Semiconductor | SZNUP2301MW6T1G | Mouser | 863-SZNUP2301MW6T1G | TRUE | AEC-Q101 | Grade 0 | EAR99
54 | J2001 | 1 | WE_615008137421 | Modular Jack WR-MJ, Tab Up |  | Wurth Electronics | 615008137421 | Mouser | 710-615008137421 | FALSE |  |  | EAR99
55 | J2009 | 1 | molex_microfit_3_04x2_THT | Micro-Fit 3.0 Right Angle Header, 3.00mm Pitch, Dual Row, 8 Circuits, with Snap-in Plastic Peg PCB Lock, Tin, Glow Wire Capable, Black, 43045-0800 |  | Molex | 43045-0800 | Farnell | 1012254 | FALSE |  |  | EAR99
56 | J2013 | 1 | molex_microfit_3_03x2_THT | Micro-Fit 3.0 Right Angle Header, 3.00mm Pitch, Dual Row, 6 Circuits, with Snap-in Plastic Peg PCB Lock, Tin, Glow Wire Capable, Black, 43045-0600 |  | Molex | 430450600 | Farnell | 1012252 | FALSE |  |  | EAR99
57 | J2033 | 1 | molex_microfit_3_01x2_THT | Micro-Fit 3.0 Right Angle Header, 3.00mm Pitch, Dual Row, 2 Circuits, with Snap-in Plastic Peg PCB Lock, Tin, Glow Wire Capable, Black, 43045-0200 |  | Molex | 43045-0200 | Farnell | 1012251 | FALSE |  |  | EAR99
62 | J3008 | 1 | TE_2-5767004-2 | Connector, SMT, 38 POS, MICTOR |  | AMP - TE CONNECTIVITY | 2-5767004-2 | Farnell | 1076633 | FALSE |  |  | EAR99
63 | J9000 | 1 | ERM8-020-09.0-L-DV-K-TR | Edge Rate rugged high-speed connector strips |  | Samtec | ERM8-020-09.0-L-DV-K-TR | Farnell | 3551150 | FALSE |  |  | EAR99
65 | L1600 | 1 | 10µH | Power Inductor |  | Murata | LQM21DH100M70L | Digi-Key | 490-18463-1-ND | TRUE
66 | J9001 | 1 | ERM8-030-09.0-L-DV-K-TR | Edge Rate rugged high-speed connector strips |  | Samtec | ERM8-030-09.0-L-DV-K-TR | Mouser | 200-ERM8030090LDVKTR | FALSE |  |  | EAR99
68 | L7200 | 1 | 1µH | Power Inductor |  | Abracon | ASPIAIG-S4035-1R0M-T | Farnell | 2848347 | TRUE
69 | L7201 | 1 | 6.8µH | Power Inductor |  | Pulse | PA4342.682NLT | Mouser | 673-PA4342.682NLT | TRUE
70 | L7202 | 1 | 4.7µH | Power Inductor |  | Abracon | ASPIAIG-S4035-4R7M-T | Digikey | 535-14227-1-ND | TRUE
73 | Q4200 | 1 | SI2302CDS-T1-GE | MOSFET, N CHANNEL, 20V, 0.045OHM, 2.6A, TO-236 |  | Vishay Siliconix | SI2302CDS-T1-E3 | Digi-Key | SI2302CDS-T1-E3CT-ND | FALSE
74 | Q4401 | 1 | DMN10H220L-7 | MOSFET-Transistor, n-Kanal, 1.6 A, 100 V, 0.250 ohm |  | Diodes | DMN10H220L-7 | Digi-Key | DMN10H220L-7DICT-ND | TRUE
75 | J9002 | 1 | ERM8-060-09.0-L-DV-K-TR | Edge Rate rugged high-speed connector strips |  | Samtec | ERM8-060-09.0-L-DV-K-TR | Mouser | 200-ERM8060090LDVKTR | FALSE |  |  | EAR99
77 | Q7203 | 1 | SQ2309ES-T1_GE3 | MOSFET-Transistor, p-channel, -1.7 A, -60 V |  | Vishay | SQ2309ES-T1_GE3 | Farnell | 2617108 | TRUE
78 | Q7202 | 1 | BUK9K13-60EX | Dual N-channel 60 V, 12.5 mΩ logic level MOSFET |  | Nexperia | BUK9K13-60EX | Mouser | 771-BUK9K13-60EX | TRUE | AEC-Q101 | Grade 0 | EAR99
87 | R1221 | 1 | 11k | SMD Resistor 11k 0402 | 402 | Panasonic | ERA-2AEB113X | Farnell | 2324762 | TRUE | AEC-Q200 |  | EAR99
90 | R8018 | 1 | 1k | SMD Resistor 1k 0402 | 402 | Panasonic | ERJ-2RKF1001X | Farnell | 2302638 | TRUE | AEC-Q200 |  | EAR99
94 | R8019 | 1 | 22k1 | SMD Resistor 22k1 0402 | 402 | Panasonic | ERA-2AEB2212X | Farnell | 2563485 | TRUE | AEC-Q200 | Grade 0 | EAR99
96 | R3150 | 1 | 22R | SMD Resistor Array 0402 8x | EXB2HV | Panasonic | EXB-2HV220JV | Farnell | 2060065 | TRUE | AEC-Q200 | Grade 1 | EAR99
99 | R7008 | 1 | 866R | SMD Resistor 866R 0402 | 402 | Panasonic | ERJ-2RKF8660X | Farnell | 2302631 | TRUE | AEC-Q200 | Grade 0 | EAR99
101 | R8025 | 1 | 330R | SMD Resistor 330R 0402 | 402 | Panasonic | ERJ-2RKF3300X | Farnell | 2302581 | TRUE | AEC-Q200 | Grade 0 | EAR99
117 | R7208 | 1 | 26k7 | SMD Resistor 26k7 0402 | 402 | Panasonic | ERJ-2RKF2672X | Digi-Key | P26.7KLCT-ND | TRUE | AEC-Q200 | Grade 0 | EAR99
120 | R7226 | 1 | 0R015 | SMD Shunt Resistor 0R015 | ERJ-B1 | Panasonic | ERJ-B1CFR015U | Farnell | 2294050 | TRUE
124 | R7115 | 1 | 0R | SMD Resistor 0R 2512 | 2512 | Vishay Dale | CRCW25120000Z0EG | Farnell | 2309110 | TRUE
125 | R8023 | 1 | 10R | SMD Resistor 10R 0805 | 805 | Panasonic | ERJ-P06F10R0V | Farnell | 1750728 | TRUE | AEC-Q200 | Grade 0 | EAR99
127 | S7200 | 1 | WS-DISV | WS-DISV Small Compact SMT DipSwitch |  | Wurth Electronics | 416131160802 | Digi-Key | 732-3852-1-ND | FALSE
129 | U6601 | 1 | TPS7A1650AQDGNRQ1 | Automotive 60-V, 5-µA IQ, 100-mA low-dropout (LDO) voltage regulator with enable and power good |  | Texas Instruments | TPS7A1650AQDGNRQ1 | Mouser | 595-PS7A1650AQDGNRQ1 | TRUE | AEC-Q100 | Grade 1 | EAR99
130 | R8000 | 1 | 330R | SMD Resistor 330R 0603 | 603 | Multicomp | MCMR06X3300FTL | Farnell | 2692155 | TRUE
133 | U1200 | 1 | DP83869HMRGZT | High Immunity 10/100/1000 Ethernet Physical Layer Transceiver and Fiber Interface |  | Texas Instruments | DP83869HMRGZT | Mouser | 595-DP83869HMRGZT | FALSE
135 | U1600 | 1 | LTC2870HUFD | RS-232-IC-Interface RS232/RS485 Multiprotocol Transceiver with Integrated Termination |  | Analog Devices / Linear Technology | LTC2870HUFD#TRPBF | Mouser | 584-LTC2870HUFD#PBF | FALSE
140 | U4301 | 1 | ADR4550BRZ | Ultralow Noise, High Accuracy Voltage Reference |  | Analog Devices | ADR4550BRZ | Farnell | 2112695 | TRUE | AEC-Q100 | unknown | EAR99
142 | U5000 | 1 | TMS5704357BZWTQQ1
143 | U6200 | 1 | S25FL512SDSMFM010 | 512 Mbit (64 Mbyte), 3.0 V SPI Flash Memory |  | Cypress | S25FL512SDSMFM010 | Mouser | 727-S25FL512SSMFM010 | TRUE
144 | U6201 | 1 | CY15B102QN-50SXE | Excelon™-Auto 2-Mbit (256K × 8) Automotive-E Serial (SPI) F-RAM |  | Cypress | CY15B102QN-50SXE | Mouser | 727-CY15B102QN-50SXE | TRUE
148 | U6400 | 1 | PCF2131TF | Ultra low power and high accurate RTC with integrated quartz crystal |  |  |  |  |  | TRUE | AEC-Q100
149 | U6500 | 1 | SHT35-DIS-F | Humidity/Temp Sensor, Digital, Dfn-8 |  | Sensirion | SHT35-DIS-F2.5KS | Farnell | 2886656 | TRUE
150 | U6600 | 1 | MAX16998DAUA/V+ | High-Voltage Watchdog Timers with Adjustable Timeout Delay |  | Maxim | MAX16998DAUA/V+ | Mouser | 700-MAX16998DAUA/V+ | TRUE
152 | U7200 | 1 | MC33FS8530A0ES | Fail-safe system basis chip with multiple SMPS and LDO |  | NXP Semiconductors | MC33FS8530A0ES | Mouser | 771-MC33FS8530A0ES | TRUE | AEC-Q100 | Grade 1 | EAR99
155 | U8001 | 1 | INA240A1QPWRQ1 | Automotive, Wide Common-Mode Range, High- and Low-Side, Bidirectional, Zero-Drift, Current-Sense Amplifier With Enhanced PWM Rejection |  | Texas Instruments | INA240A1QPWRQ1 | Digi-Key | 296-50472-1-ND | TRUE | AEC-Q100 | Grade 1 | EAR99
156 | U8002 | 1 | LM2903QDRQ1 | Automotive Dual Comparators |  | Texas Instruments | LM2903QDRQ1 | Digi-Key | 296-15183-1-ND | TRUE | AEC-Q100 | Grade 1 | EAR99
158 | R7233 | 1 | 470k | SMD Resistor 470k 0402 | 402 | Panasonic | ERJ-2RKF4703X | Farnell | 2302916 | TRUE
159 | U1100 | 1 | ADUM6401CRIZ | Digital Isolator, 4 channel, with power |  | Analog Devices | ADUM6401CRIZ | Digikey | 505-ADUM6401CRIZ-ND | FALSE |  |  | EAR99
161 | Q6400 | 1 | SP000870646 | MOSFETs N-Ch 100V 190mA SOT-23-3 |  | Infineon | BSS123NH6327XTSA1 | Mouser | 726-SP000870646 | TRUE | AEC-Q101 |  | EAR99
