emiln2002/BMS/slave_v2/Sources/bom-online/bom-online-slave-14-mc33775.xlsx

Sheet: BOM
BOM for slave-14-mc33775, Variant None
Generated on 2024-12-18 10:22
Line # | Designator | Quantity | Name | Description | Case EIA | Manufacturer 1 | Manufacturer Part Number 1 | Supplier 1 | Supplier Part Number 1
2 | C200_1, C200_2, C203_1, C203_2, C220_1, C220_2 | 6 | 1u/35V | MLCC | 0603 | TDK | CGA3E1X7R1V105K080AC | Farnell | 2906941
3 | C201_1, C201_2, C212_1, C212_2, C213_1, C213_2, C214_1, C214_2, C215_1, C215_2, C216_1, C216_2, C217_1, C217_2, C218_1, C218_2, C219_1, C219_2, C221_1, C221_2, C400, C601, C603, C604, C605, C606, C613, C617, C807, C850, C852, C900, C920, C921, C922, C923, C924, C925 | 38 | 100n/100V | MLCC | 0603 | Murata | GCJ188R72A104KA01D | Digikey | 490-13420-1-ND
1 | C202_1, C202_2, C204_1, C204_2, C205_1, C205_2, C206_1, C206_2, C207_1, C207_2, C208_1, C208_2, C209_1, C209_2, C210_1, C210_2, C211_1, C211_2, C607, C610 | 20 | 10n/100V | MLCC | 0603 | Kyocera AVX | 06031C103K4Z2A | Farnell | 1301715
4 | C500, C501, C502, C503, C504, C505, C506, C507, C508, C509, C510, C511, C512, C513, C514, C515, C516, C517, C518, C519, C520, C521, C522, C523, C524, C525, C526, C527, C528, C529, C530, C531, C600, C700, C701, C702, C703 | 37 | 47n/100V | MLCC | 0603 | KEMET | C0603C473K1RACAUTO | Farnell | 2478249
5 | C602, C608, C609, C612 | 4 | 220p/50V | MLCC | 0603 | Yageo | AC0603JRNPO9BN221 | Mouser | 603-AC603JRNPO9BN221
6 | C611 | 1 | 470n/50V | MLCC | 0603 | TDK | CGA3E3X7R1H474K080AE | Farnell | 2547051
7 | C614, C615, C616, C618 | 4 | 22p/50V | MLCC | 0402 | Multicomp | MCMT15N220F500CT | Farnell | 1856067
8 | C800, C801 | 2 | 15u/100V | Stacked MLCC | 2220 | Murata | KCM55WR72A156MH01K | Farnell | 2781468
9 | C802, C803 | 2 | 1u/100V | MLCC | 1210 | Kyocera AVX | 12101C105K4Z2A | Farnell | 1301722
10 | C804 | 1 | 3u3/100V | MLCC | 1812 | KEMET | C1812C335K1RACAUTO | Farnell | 2579025
11 | C805, C808 | 2 | 2n2/100V | MLCC | 0402 | Murata | GCM155R72A222KA37D | Digikey | 490-4911-1-ND
12 | C806 | 1 | 2u2/100V | MLCC | 1210 | KEMET | C1210X225K1RACAUTO | Farnell | 2781417
13 | C809 | 1 | 100p/200V | MLCC | 0402 | KEMET | C0402C101J2GACAUTO | Farnell | 2426878
14 | C810 | 1 | 22u/6.3V | MLCC | 1206 | TDK | CGA5L1X7R0J226M160AC | Farnell | 2672216
15 | C851 | 1 | 2u2/10V | MLCC | 0805 | KEMET | C1206C225K8RACAUTO | Farnell | 2478259
16 | D600, D601, D608 | 3 | DFLS1100Q-7 | Schottky Diode |  | Diodes | DFLS1100Q-7 | Mouser | 621-DFLS1-100Q-7
17 | D602 | 1 | PTVS60VS1UR | 400W Transient Voltage Suppressor |  | Nexperia | PTVS60VS1UR,115 | Mouser | 771-PTVS60VS1UR115
20 | D603 | 1 | S1MSP1-7 | 1.0A surface mount glass passivated rectifier |  | Diodes | S1MSP1-7 | Mouser | 621-S1MSP1-7
18 | D604, D605, D606, D607 | 4 | PESD5V0V1BB | Very low capacitance bidirectional ESD protection diode |  | Nexperia | PESD5V0V1BB,115 | Mouser | 771-PESD5V0V1BB115
19 | D609, D610 | 2 | PACDN042Y3R | ESD-Schutzbaustein |  | ON Semiconductor | PACDN042Y3R | Farnell | 2317483
21 | IC920 | 1 | MCP9800A0T-M/OT | 2-Wire High-Accuracy Temperature Sensor, Slave Address 000, 5-Pin SOT-23, -55°C to +125°C Temperature, Tape and Reel |  | Microchip | MCP9800A0T-M/OT
22 | J300 | 1 | molex_microfit_3_12x2_THT | Micro-Fit 3.0 Right Angle Header, 3.00mm Pitch, Dual Row, 24 Circuits, with Snap-in Plastic Peg PCB Lock, Tin, Glow Wire Capable, Black, 43045-2400 |  | Molex | 43045-2400 | Farnell | 1012245
23 | J301, J302, J305, J306 | 4 | molex_microfit_3_01x2_THT | Micro-Fit 3.0 Right Angle Header, 3.00mm Pitch, Dual Row, 2 Circuits, with Snap-in Plastic Peg PCB Lock, Tin, Glow Wire Capable, Black, 43045-0200 |  | Molex | 43045-0200 | Farnell | 1012251
24 | J303 | 1 | gen_pinheader_2.54_2x9 | Standard Pinheader, THD, gerade, 2.54mm, 2-reihig |  | Samtec | TSW-109-07-G-D | Farnell | 2025256
25 | J304, J307 | 2 | molex_microfit_3_08x2_THT | Micro-Fit 3.0 Right Angle Header, 3.00mm Pitch, Dual Row, 16 Circuits, with Snap-in Plastic Peg PCB Lock, Tin, Glow Wire Capable, Black, 43045-1600 |  | Molex | 43045-1600 | Farnell | 9961380
26 | J308, J309 | 2 | gen_pinheader_2.54_2x7 | Standard Pinheader, THD, gerade, 2.54mm, 2-reihig |  | Samtec | TSW-107-07-G-D | Mouser | 200-TSW10707GD
27 | J310, J311, J312 | 3 | gen_pinheader_2.54_2 | Standard Pinheader, THD, gerade, 2.54mm |  | Samtec | TSW-102-07-G-S | Farnell | 2505044
28 | L800 | 1 | 470nH | FIXED IND 470NH 17.5A 4.2 MOHM |  | Bourns | SRP7028A-R47M | Digikey | SRP7028A-R47MCT-ND
29 | L801 | 1 | 47µH | Power Inductor |  | Laird Steward | TYS6045470M-10 | Digikey | 240-2745-1-ND
30 | LD600, LD601, LD800, LD850 | 4 | green | TLMG1100-GS08 |  | Vishay Semiconductors | TLMG1100-GS08 | Farnell | 2293494
31 | Q600 | 1 | MJD31CAJ | 100V, 3A NPN high power bipolar transistor |  | Nexperia | MJD31CAJ | Mouser | 771-MJD31CAJ
32 | Q601, Q602 | 2 | DMN10H220L-7 | MOSFET-Transistor, n-Kanal, 1.6 A, 100 V, 0.250 ohm |  | Diodes | DMN10H220L-7 | Digikey | DMN10H220L-7DICT-ND
33 | R100, R200_1, R200_2, R201_1, R201_2, R202_1, R202_2, R203_1, R203_2, R204_1, R204_2, R205_1, R205_2, R210_1, R210_2, R211_1, R211_2, R212_1, R212_2, R213_1, R213_2, R214_1, R214_2, R215_1, R215_2, R216_1, R216_2, R217_1, R217_2, R230_1, R230_2, R232_1, R232_2, R516, R517, R518, R519, R520, R521, R522, R523, R524, R525, R526, R601, R602, R603, R606, R607, R608, R609, R610, R612, R613, R614, R615, R619, R620, R622, R623, R624, R625, R626, R629, R630, R631, R633, R635, R636, R637, R639, R640, R801, R803, R807, R850, R851, R853 | 78 | 0R | SMD Resistor 0R 0603 | 0603 | Vishay Semiconductors | RCA06030000ZSEA | Farnell | 2616580
34 | R206_1, R206_2, R207_1, R207_2, R208_1, R208_2, R209_1, R209_2, R218_1, R218_2, R219_1, R219_2, R220_1, R220_2, R221_1, R221_2, R500, R501, R502, R503, R504, R505, R506, R507, R508, R509, R510, R511, R512, R513, R514, R515, R700, R701, R702, R703, R810, R916, R920 | 39 | 10k | SMD Resistor 10k 0603 | 0603 | Multicomp | MCMR06X1002FTL | Farnell | 2303192
35 | R222_1, R222_2, R223_1, R223_2, R224_1, R224_2, R225_1, R225_2, R226_1, R226_2, R227_1, R227_2, R228_1, R228_2, R229_1, R229_2, R231_1, R231_2 | 18 | 1k | SMD Resistor 1k 0603 | 0603 | Vishay Dale | CRCW06031K00FKTA | Farnell | 1652848
36 | R400, R401, R616, R617, R627, R641 | 6 | 5k1 | SMD Resistor 5k1 0603 | 0603 | Panasonic | ERJ-3GEYJ512V | Mouser | 667-ERJ-3GEYJ512V
37 | R600 | 1 | 10R | SMD Resistor 10R 0805 | 0805 | Panasonic | ERJ-P06F10R0V | Farnell | 1750728
38 | R604 | 1 | 270R | SMD Resistor 270R 0603 | 0603 | Vishay | CRCW0603270RFKEA | Farnell | 2141320
38-2 | R605 | 1 | 2k7 | SMD Resistor 2k7 0603 | 0603
39 | R611, R621, R628, R632, R634, R642 | 6 | 150R | SMD Resistor 150R 0603 | 0603 | Panasonic | ERJ3EKF1500V | Farnell | 2303076
40 | R618 | 1 | 13R7 | SMD Resistor 13R7 0603 | 0603 |  |  | Farnell | 2561781
41 | R638, R643, R808, R900, R901, R902, R903, R904, R905, R906, R907, R908, R909, R910, R911, R912, R913, R914, R915, R917, R918, R919, R921, R922, R923, R924, R925, R926, R927, R928, R929, R930, R931, R932, R933 | 35 | 100k | SMD Resistor 100k 0603 | 0603 | Panasonic | ERJ3EKF1003V | Farnell | 2303232
42 | R704, R705 | 2 | 10k NTC | SMD Resistor 10k NTC 0402 | 0402 | TDK EPCOS | B57251V5103J060 | Farnell | 2432559
43 | R706, R707, R708, R709, R710, R711, R712, R713 | 8 | ThermaWick | ThermaWick thermal coupling 0603 | 0603 | Vishay | THJP0603AST1 | Mouser | 71-THJP0603AST1
44 | R714, R715, R716, R717, R718, R719, R720, R721, R722, R723, R724, R725, R726, R727, R728, R729, R730, R731, R732, R733, R734, R735, R736, R737, R738, R739, R740, R741 | 28 | 68R | SMD Resistor 68R 2010 | 2010 | Panasonic | ERJ-12ZYJ680U | Farnell | 2323988
45 | R800 | 1 | 100R | SMD Resistor 100R 0603 | 0603 | Panasonic | ERJ3EKF1000V | Mouser | 667-ERJ-PA3F1000V
46 | R802 | 1 | 0R1 | SMD Resistor 0R1 0805 | 0805 | Bourns | CRM0805AJX-R100ELF | Farnell | 2824733
47 | R804, R854 | 2 | 240R | SMD Resistor 240R 0603 | 0603 | Panasonic | ERJ-3EKF2400V | Mouser | 667-ERJ-3EKF2400V
48 | R805 | 1 | 287k | SMD Resistor 287k 0603 | 0603 | Panasonic | ERJ-3EKF2873V | Mouser | 667-ERJ-3EKF2873V
49 | R806 | 1 | 174k | SMD Resistor 174k 0603 | 0603 | Panasonic | ERJ-3EKF1743V | Mouser | 667-ERJ-3EKF1743V
50 | R809 | 1 | 27k4 | SMD Resistor 27k4 0603 | 0603 | Panasonic | ERJ-3EKF2742V | Mouser | 667-ERJ-3EKF2742V
51 | R852 | 1 | 1M | SMD Resistor 1M 0603 | 0603 | Vishay | CRCW06031M00FKEA | Farnell | 2303325
52 | T600, T601 | 2 | HM2102NLT | Pulse HM2102NLT BMS Transformer |  | Pulse | HM2102NLT | Mouser | 673-HM2102NLT
55 | U200_1, U200_2 | 2 | ADR4540BRZ | Ultralow Noise, High Accuracy 4.096V Reference |  | Analog Devices | ADR4540BRZ | Farnell | 2112692
53 | U201_1, U201_2 | 2 | ADG728BRUZ | CMOS, Low Voltage, 2-Wire Serially Controlled, Matrix Switch, -40 to 85 degC, 16-pin SOP (RU-16), Tube |  | Analog Devices | ADG728BRUZ
54 | U202_1, U202_2 | 2 | AD8628ARTZ-R2 | Single Channel RRIO Operational Amplifier, 2.5 MHz BW, 1 V/us SR, Industrial, 5-pin SOT23 (RJ-5), Reel |  | Analog Devices | AD8628ARTZ-R2
 | U400 | 1 | M24M02-DWMN3TP/K | Automotive 2-Mbit serial I²C bus EEPROM with 1 MHz clock |  |  |  | Digikey | 497-16238-1-ND
57 | U600 | 1 | MC33775A | 14 Cells Battery Cell Controller IC
58 | U601 | 1 | ACFL-6211T-000E | 15MBd Dual-channel Bi-directional Optocoupler |  | Broadcom Avago | ACFL-6211T-000E | Digikey | 516-3808-ND
59 | U800 | 1 | LM5163-Q1 | 100-V Input, 0.5-A SynchronousBuck DC/DCConverterwith Ultra-lowIQ |  | Texas Instruments | LM5163QDDARQ1 | Digikey | 296-53561-1-ND
60 | U850 | 1 | TPS7A1633AQDGNRQ1 | Automotive 60-V, 5-µA IQ, 100-mA low-dropout (LDO) voltage regulator with enable and power good |  | Texas Instruments | TPS7A1633AQDGNRQ1 | Digikey | 296-TPS7A1633AQDGNRQ1TR-ND
61 | U851 | 1 | TPS7A1633DRBR | Automotive 60-V, 5-µA IQ, 100-mA low-dropout (LDO) voltage regulator with enable and power good |  |  |  | Mouser | 595-TPS7A1633DRBR 595-TPS7A1633DRBR 595-TPS7A1633DRBR
62 | U900 | 1 | TCA9539PWR | Remote 16-Bit I2C and SMBus, Low-Power I/O Expander with Interrupt Output, Reset & Config. Register, 1.65 to 5.5 V, -40 to 85 degC, 24-pin TSSOP (PW), Green (RoHS & no Sb/Br) |  | Texas Instruments | TCA9539PWR
63 | U920 | 1 | BME280 | Low power pressure, temperature & humidity sensor |  | Bosch Tools | BME280 | Digikey | 828-1063-1-ND
64 | U921 | 1 | SHT35-DIS-F | Humidity/Temp Sensor, Digital, Dfn-8 |  | Sensirion | 1-101465-01 | Farnell | 2886656
65 | U922 | 1 | BME680 | Low power gas, pressure, temperature & humidity sensor |  | Bosch Tools | BME680 | Digikey | 828-1077-1-ND

Sheet: DATA
slave-14-mc33775.PrjPcb
2024-12-18 10:22
None
