emiln2002/BMS/BMS_Slave_KiCad/FootPrints/KCM55WR72A156MH01K/KCM55WR72A156MH01K.step

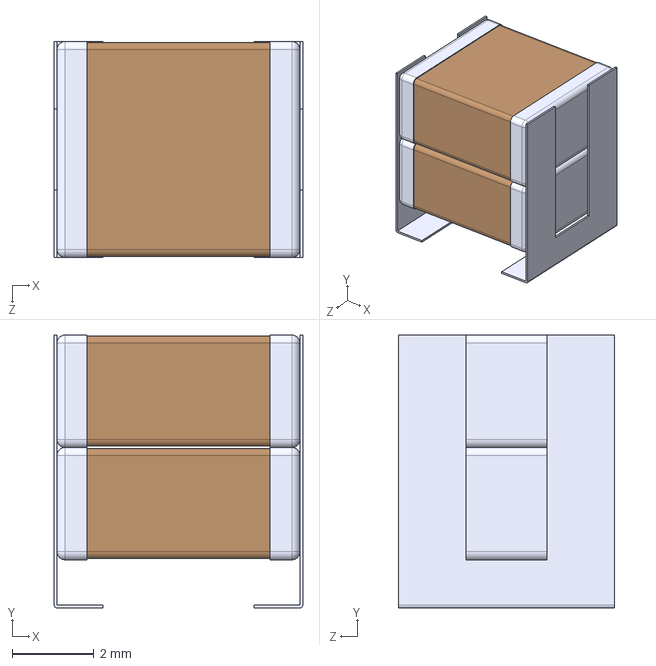
[picture p1: CAD file, 2026-02-12]
BMS_Slave_KiCad/FootPrints/KCM55WR72A156MH01K/KCM55WR72A156MH01K.step
6.10 x 6.70 x 5.30 mm
