emiln2002/BMS/Slave-18-cell/Assembly automotive/step-model/slave(automotive).step

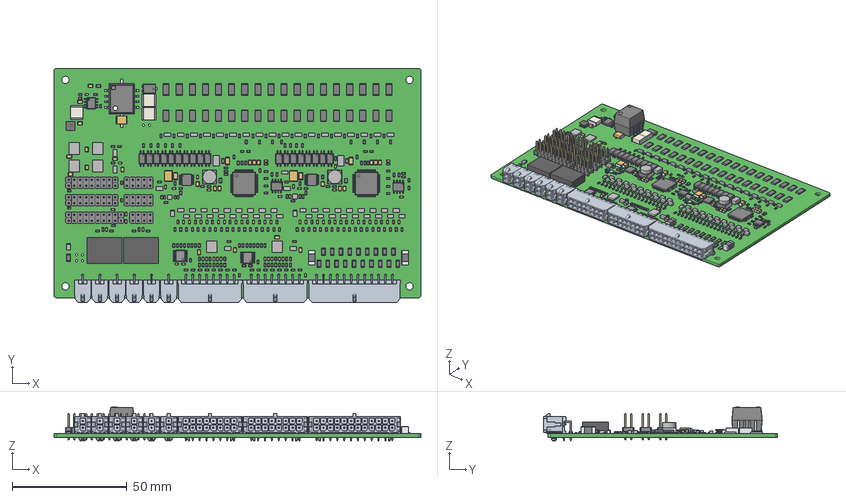
[picture p2: CAD file, 2026-02-16]
Slave-18-cell/Assembly automotive/step-model/slave(automotive).step
160.0 x 102.1 x 14.6 mm
Mid_Body x 230
Mark x 230
Extruded x 89
Leader x 252
BODY_MTC16 x 2
LEAD_MTC16 x 32
SOIC_LT-S8E-8
lead x 3
housing x 3
contact x 2
spule
Glue
STIFTLEISTE_STIFT x 84
STIFTLEISTE_KUNSTSTOFF2 x 36
STIFTLEISTE_KUNSTSTOFF x 12
cover x 2
base x 4
Polarity Mark x 2
