emiln2002/BMS/slave_v2/Assembly foxBMS_14cell_BMS-Slave_NXP775A/step-model/slave-14-mc33775(foxBMS_14cell_BMS-Slave_NXP775A).step

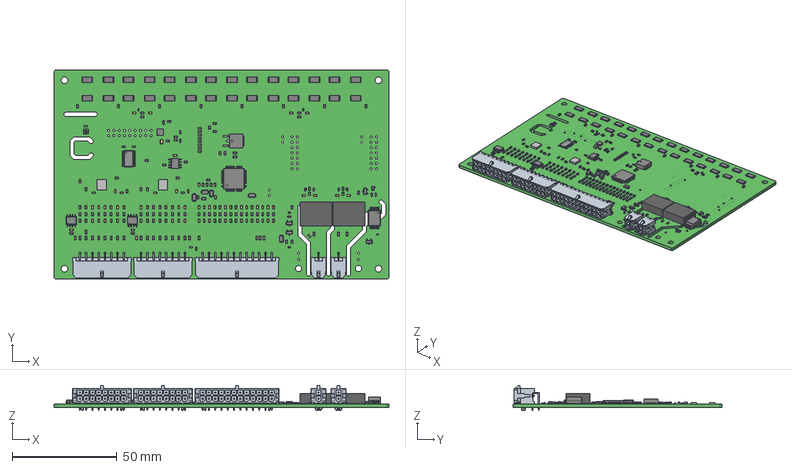
[picture p4: CAD file, 2026-02-12]
slave_v2/Assembly foxBMS_14cell_BMS-Slave_NXP775A/step-model/slave-14-mc33775(foxBMS_14cell_BMS-Slave_NXP775A).step
160.0 x 100.0 x 11.9 mm
Thermal_Shape
Lead x 2
Trimmed_Lead
Leader x 112
Mid_Body x 138
Mark x 138
lead x 18
housing x 3
cover x 3
base x 6
Polarity Mark x 3
Sensirion_Humidity_SHT3x_STEP-file
BODY_MTC24
LEAD_MTC24 x 24
Extruded x 4
