emiln2002/BMS/slave_v2/Assembly foxBMS_14cell_BMS-Slave_NXP775A_minimal/step-model/slave-14-mc33775(foxBMS_14cell_BMS-Slave_NXP775A_minimal).step

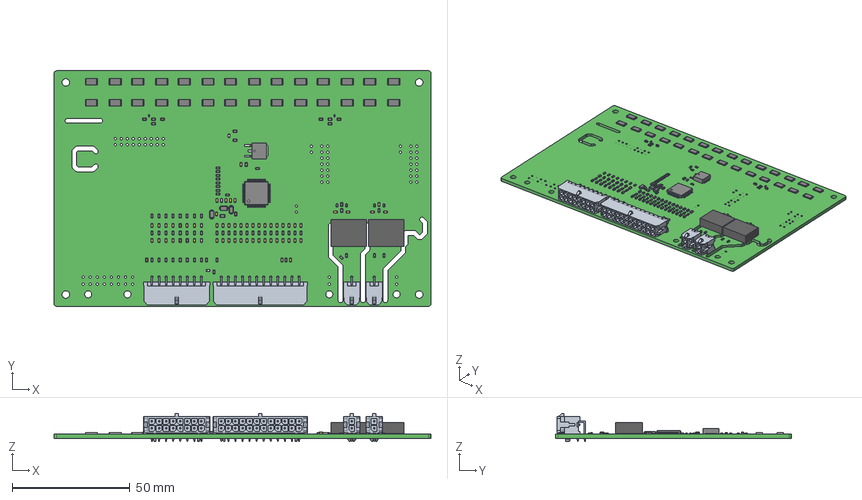
[picture p5: CAD file, 2026-02-12]
slave_v2/Assembly foxBMS_14cell_BMS-Slave_NXP775A_minimal/step-model/slave-14-mc33775(foxBMS_14cell_BMS-Slave_NXP775A_minimal).step
160.0 x 100.0 x 11.9 mm
Lead x 2
Trimmed_Lead
Mid_Body x 97
Mark x 97
lead x 14
housing x 2
cover x 2
base x 4
Polarity Mark x 2
Leader x 64
Extruded x 2
