emiln2002/BMS/slave_v2/Sources/step-model/slave-14-mc33775.step

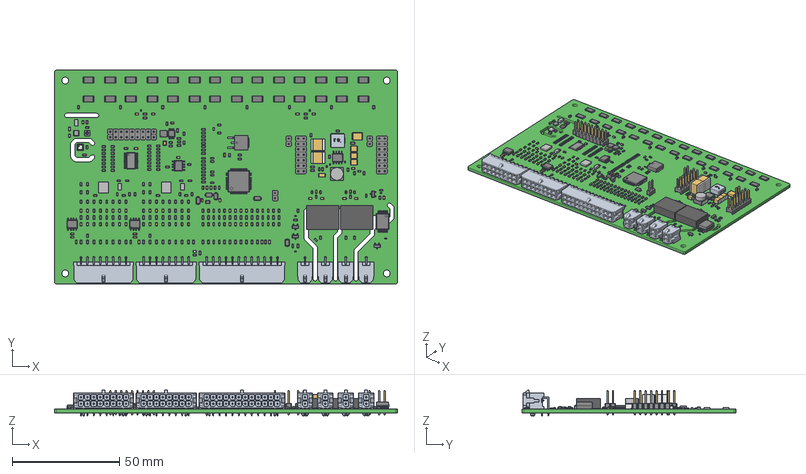
[picture p6: CAD file, 2026-02-12]
slave_v2/Sources/step-model/slave-14-mc33775.step
160.0 x 100.0 x 11.9 mm
Thermal_Shape
Mid_Body x 232
Mark x 232
Lead x 2
Trimmed_Lead
Leader x 128
lead x 18
housing x 4
cover x 4
base x 8
Polarity Mark x 4
STIFTLEISTE_STIFT x 52
STIFTLEISTE_KUNSTSTOFF x 10
BME680--3DModel-STEP-56544
Sensirion_Humidity_SHT3x_STEP-file
Extruded x 9
BODY_MTC24
LEAD_MTC24 x 24
SRP 7028A series
STIFTLEISTE_KUNSTSTOFF2 x 21
