emiln2002/BMS/Slave-18-cell/Fabrication/drc/slave.html

Altium

# Design Rule Verification Report

Date: | | 2024-12-17
Time: | | 17:34:37
Elapsed Time: | | 00:00:06
Filename: | | C:\Users\schwarz\AppData\Local\TempReleases\Snapshot\1\slave.PcbDoc

Warnings: | | 0
Rule Violations: | | 0
Waived Violations: | | 34

## Summary

Warnings | Count
Total | 0

Rule Violations | Count
Clearance Constraint (Gap=0.102mm) (All),(All) | 0
Clearance Constraint (Gap=0.127mm) (IsStitchingVia and InNet('FUSED_CELL_10+')),((IsVia and (Not IsStitchingVia)) Or IsPad) | 0
Short-Circuit Constraint (Allowed=No) (All),(All) | 0
Un-Routed Net Constraint ( (All) ) | 0
Modified Polygon (Allow modified: No), (Allow shelved: No) | 0
Width Constraint (Min=0.102mm) (Max=1.524mm) (Preferred=0.152mm) (All) | 0
SMD To Corner (Distance=0.102mm) (All) | 0
SMD Entry (Side = Allowed) (Corner = Allowed) (Any Angle = Not Allowed) (Ignore First Corner = Allowed) | 0
Power Plane Connect Rule(Direct Connect )(Expansion=0.508mm) (Conductor Width=0.254mm) (Air Gap=0.254mm) (Entries=4) (All) | 0
Minimum Annular Ring (Minimum=0.102mm) (All) | 0
Hole Size Constraint (Min=0.2mm) (Max=5.994mm) (All) | 0
Hole To Hole Clearance (Gap=0.152mm) (All),(All) | 0
Silk To Solder Mask (Clearance=0.102mm) (IsPad),(All) | 0
Silk to Silk (Clearance=0.254mm) (All),(All) | 0
Net Antennae (Tolerance=0mm) (All) | 0
Board Clearance Constraint (Gap=0mm) (All) | 0
Component Clearance Constraint ( Horizontal Gap = 0.254mm, Vertical Gap = 0.254mm ) (All),(All) | 0
Height Constraint (Min=0mm) (Max=25.4mm) (Prefered=12.7mm) (All) | 0
Total | 0

Waived Violations | Count
Silk to Silk (Clearance=0.254mm) (All),(All) | 29
Board Clearance Constraint (Gap=0mm) (All) | 5
Total | 34

## Rule Violations

## Waived Violations

Silk to Silk (Clearance=0.254mm) (All),(All)

Silk To Silk Clearance Constraint: (0.189mm < 0.254mm) Between Text "DC-" (2.54mm,19.05mm) on Top Overlay And Track (1.587mm,17.609mm)(1.587mm,21.273mm) on Top Overlay Silk Text to Silk Clearance [0.189mm]
Waived by Sebastian Wacker at 2018-05-28 14:16:50
checked - ok

Silk To Silk Clearance Constraint: (0.205mm < 0.254mm) Between Text "DC-" (2.54mm,19.05mm) on Top Overlay And Track (2.857mm,18.224mm)(2.857mm,21.273mm) on Top Overlay Silk Text to Silk Clearance [0.205mm]
Waived by Sebastian Wacker at 2018-05-28 14:16:50
checked - ok

Silk To Silk Clearance Constraint: (0.189mm < 0.254mm) Between Text "DC-" (4.128mm,19.05mm) on Top Overlay And Track (3.175mm,18.098mm)(3.175mm,21.273mm) on Top Overlay Silk Text to Silk Clearance [0.189mm]
Waived by Sebastian Wacker at 2018-05-28 14:16:50
checked - ok

Silk To Silk Clearance Constraint: (0.205mm < 0.254mm) Between Text "DC-" (4.128mm,19.05mm) on Top Overlay And Track (4.445mm,18.098mm)(4.445mm,21.273mm) on Top Overlay Silk Text to Silk Clearance [0.205mm]
Waived by Sebastian Wacker at 2018-05-28 14:16:50
checked - ok

Silk To Silk Clearance Constraint: (0.189mm < 0.254mm) Between Text "DC+" (2.54mm,15.875mm) on Top Overlay And Track (1.587mm,14.91mm)(1.587mm,17.609mm) on Top Overlay Silk Text to Silk Clearance [0.189mm]
Waived by Sebastian Wacker at 2018-05-28 14:16:50
checked - ok

Silk To Silk Clearance Constraint: (0.205mm < 0.254mm) Between Text "DC+" (2.54mm,15.875mm) on Top Overlay And Track (2.857mm,14.91mm)(2.857mm,18.244mm) on Top Overlay Silk Text to Silk Clearance [0.205mm]
Waived by Sebastian Wacker at 2018-05-28 14:16:50
checked - ok

Silk To Silk Clearance Constraint: (0.189mm < 0.254mm) Between Text "DC+" (4.128mm,15.875mm) on Top Overlay And Track (3.175mm,14.922mm)(3.175mm,18.244mm) on Top Overlay Silk Text to Silk Clearance [0.189mm]
Waived by Sebastian Wacker at 2018-05-28 14:16:50
checked - ok

Silk To Silk Clearance Constraint: (0.205mm < 0.254mm) Between Text "DC+" (4.128mm,15.875mm) on Top Overlay And Track (4.445mm,14.922mm)(4.445mm,18.244mm) on Top Overlay Silk Text to Silk Clearance [0.205mm]
Waived by Sebastian Wacker at 2018-05-28 14:16:50
checked - ok

Silk To Silk Clearance Constraint: (0.187mm < 0.254mm) Between Text "IC101_1" (7.303mm,68.104mm) on Top Overlay And Track (7.29mm,67.637mm)(10.49mm,67.637mm) on Top Overlay Silk Text to Silk Clearance [0.187mm]
Waived by Sebastian Wacker at 2018-09-10 14:50:10
checked - ok

Silk To Silk Clearance Constraint: (0.187mm < 0.254mm) Between Text "IC104_1" (17.462mm,68.104mm) on Top Overlay And Track (17.45mm,67.637mm)(20.65mm,67.637mm) on Top Overlay Silk Text to Silk Clearance [0.187mm]
Waived by Sebastian Wacker at 2018-09-10 14:50:10
checked - ok

Silk To Silk Clearance Constraint: (0.2mm < 0.254mm) Between Text "IN-" (49.53mm,19.05mm) on Top Overlay And Track (48.578mm,18.098mm)(48.578mm,21.273mm) on Top Overlay Silk Text to Silk Clearance [0.2mm]
Waived by Sebastian Wacker at 2018-05-28 14:16:50
checked - ok

Silk To Silk Clearance Constraint: (0.216mm < 0.254mm) Between Text "IN-" (49.53mm,19.05mm) on Top Overlay And Track (49.847mm,18.098mm)(49.847mm,21.273mm) on Top Overlay Silk Text to Silk Clearance [0.216mm]
Waived by Sebastian Wacker at 2018-05-28 14:16:50
checked - ok

Silk To Silk Clearance Constraint: (0.2mm < 0.254mm) Between Text "IN+" (49.53mm,15.875mm) on Top Overlay And Track (48.578mm,14.922mm)(48.578mm,18.244mm) on Top Overlay Silk Text to Silk Clearance [0.2mm]
Waived by Sebastian Wacker at 2018-05-28 14:16:50
checked - ok

Silk To Silk Clearance Constraint: (0.216mm < 0.254mm) Between Text "IN+" (49.53mm,15.875mm) on Top Overlay And Track (49.847mm,14.922mm)(49.847mm,18.244mm) on Top Overlay Silk Text to Silk Clearance [0.216mm]
Waived by Sebastian Wacker at 2018-05-28 14:16:50
checked - ok

Silk To Silk Clearance Constraint: (0.189mm < 0.254mm) Between Text "OUT-" (47.943mm,18.733mm) on Top Overlay And Track (46.99mm,17.609mm)(46.99mm,21.273mm) on Top Overlay Silk Text to Silk Clearance [0.189mm]
Waived by Sebastian Wacker at 2018-05-28 14:16:50
checked - ok

Silk To Silk Clearance Constraint: (0.204mm < 0.254mm) Between Text "OUT-" (47.943mm,18.733mm) on Top Overlay And Track (48.26mm,18.224mm)(48.26mm,21.273mm) on Top Overlay Silk Text to Silk Clearance [0.204mm]
Waived by Sebastian Wacker at 2018-05-28 14:16:50
checked - ok

Silk To Silk Clearance Constraint: (0.189mm < 0.254mm) Between Text "OUT+" (47.943mm,15.24mm) on Top Overlay And Track (46.99mm,14.91mm)(46.99mm,17.609mm) on Top Overlay Silk Text to Silk Clearance [0.189mm]
Waived by Sebastian Wacker at 2018-05-28 14:16:50
checked - ok

Silk To Silk Clearance Constraint: (0.228mm < 0.254mm) Between Text "OUT+" (47.943mm,15.24mm) on Top Overlay And Track (46.99mm,14.91mm)(48.26mm,14.91mm) on Top Overlay Silk Text to Silk Clearance [0.228mm]
Waived by Sebastian Wacker at 2018-05-28 14:16:50
checked - ok

Silk To Silk Clearance Constraint: (0.204mm < 0.254mm) Between Text "OUT+" (47.943mm,15.24mm) on Top Overlay And Track (48.26mm,14.91mm)(48.26mm,18.244mm) on Top Overlay Silk Text to Silk Clearance [0.204mm]
Waived by Sebastian Wacker at 2018-05-28 14:16:50
checked - ok

Silk To Silk Clearance Constraint: (0.216mm < 0.254mm) Between Text "Primary" (133.826mm,61.436mm) on Top Overlay And Track (133.509mm,60.96mm)(133.509mm,62.675mm) on Top Overlay Silk Text to Silk Clearance [0.216mm]
Waived by Sebastian Wacker at 2018-09-10 14:50:10
checked - ok

Silk To Silk Clearance Constraint: (0.086mm < 0.254mm) Between Text "Primary" (133.826mm,61.436mm) on Top Overlay And Track (133.509mm,60.96mm)(139.065mm,60.96mm) on Top Overlay Silk Text to Silk Clearance [0.086mm]
Waived by Sebastian Wacker at 2018-09-10 14:50:10
checked - ok

Silk To Silk Clearance Constraint: (0.16mm < 0.254mm) Between Text "Primary" (133.826mm,61.436mm) on Top Overlay And Track (133.509mm,62.675mm)(139.065mm,62.675mm) on Top Overlay Silk Text to Silk Clearance [0.16mm]
Waived by Sebastian Wacker at 2018-09-10 14:50:10
checked - ok

Silk To Silk Clearance Constraint: (0.18mm < 0.254mm) Between Text "Primary" (133.826mm,61.436mm) on Top Overlay And Track (139.065mm,60.96mm)(139.065mm,62.675mm) on Top Overlay Silk Text to Silk Clearance [0.18mm]
Waived by Sebastian Wacker at 2018-09-10 14:50:10
checked - ok

Silk To Silk Clearance Constraint: (0.216mm < 0.254mm) Between Text "Secondary" (81.28mm,61.404mm) on Top Overlay And Track (80.963mm,60.96mm)(80.963mm,62.675mm) on Top Overlay Silk Text to Silk Clearance [0.216mm]
Waived by Sebastian Wacker at 2018-09-10 14:50:10
checked - ok

Silk To Silk Clearance Constraint: (0.055mm < 0.254mm) Between Text "Secondary" (81.28mm,61.404mm) on Top Overlay And Track (80.963mm,60.96mm)(88.582mm,60.96mm) on Top Overlay Silk Text to Silk Clearance [0.055mm]
Waived by Sebastian Wacker at 2018-09-10 14:50:10
checked - ok

Silk To Silk Clearance Constraint: (0.174mm < 0.254mm) Between Text "Secondary" (81.28mm,61.404mm) on Top Overlay And Track (80.963mm,62.675mm)(88.582mm,62.675mm) on Top Overlay Silk Text to Silk Clearance [0.174mm]
Waived by Sebastian Wacker at 2018-09-10 14:50:10
checked - ok

Silk To Silk Clearance Constraint: (0.131mm < 0.254mm) Between Text "TP902" (42.704mm,70.644mm) on Top Overlay And Text "TP903" (41.751mm,71.438mm) on Top Overlay Silk Text to Silk Clearance [0.131mm]
Waived by Sebastian Wacker at 2018-09-11 12:07:55
checked - ok

Silk To Silk Clearance Constraint: (0.11mm < 0.254mm) Between Text "X900" (40.481mm,73.184mm) on Top Overlay And Track (38.052mm,74.047mm)(42.593mm,74.047mm) on Top Overlay Silk Text to Silk Clearance [0.11mm]
Waived by Sebastian Wacker at 2018-09-11 12:07:55
checked - ok

Silk To Silk Clearance Constraint: (0.179mm < 0.254mm) Between Text "X900" (40.481mm,73.184mm) on Top Overlay And Track (42.593mm,74.047mm)(42.793mm,74.247mm) on Top Overlay Silk Text to Silk Clearance [0.179mm]
Waived by Sebastian Wacker at 2018-09-11 12:07:55
checked - ok

Back to top

Board Clearance Constraint (Gap=0mm) (All)

Board Outline Clearance(Cutout Edge): (Collision < 0.203mm) Between Board Cutout (Multi-Layer)Region (0 hole(s)) Multi-Layer And Track (24.103mm,80.027mm)(34.953mm,80.027mm) on Top Overlay
Waived by Sebastian Wacker at 2018-09-11 12:07:55
checked - ok

Board Outline Clearance(Cutout Edge): (Collision < 0.203mm) Between Board Cutout (Multi-Layer)Region (0 hole(s)) Multi-Layer And Track (24.103mm,93.327mm)(34.953mm,93.327mm) on Top Overlay
Waived by Sebastian Wacker at 2018-09-11 12:07:55
checked - ok

Board Outline Clearance(Cutout Edge): (Collision < 0.203mm) Between Board Cutout (Multi-Layer)Region (0 hole(s)) Multi-Layer And Track (28.777mm,75.82mm)(30.277mm,75.82mm) on Top Overlay
Waived by Sebastian Wacker at 2018-09-11 12:07:55
checked - ok

Board Outline Clearance(Cutout Edge): (Collision < 0.203mm) Between Board Cutout (Multi-Layer)Region (0 hole(s)) Multi-Layer And Track (28.777mm,79.12mm)(30.277mm,79.12mm) on Top Overlay
Waived by Sebastian Wacker at 2018-09-11 12:07:55
checked - ok

Board Outline Clearance(Cutout Edge): (0.057mm < 0.203mm) Between Board Cutout (Multi-Layer)Region (0 hole(s)) Multi-Layer And Track (29.527mm,95.567mm)(29.527mm,98.108mm) on Top Overlay
Waived by Sebastian Wacker at 2018-09-11 12:07:55
checked - ok

Back to top
