emiln2002/BMS/interface-nxp-mc33664-v1.0.2/Fabrication/erc/foxbms2-interface-mc33664.html

Altium

# Electrical Rule Check Report

Date: | | 2023-01-12
Time: | | 18:03:11
Filename: | | C:\Users\schwarz\AppData\Local\TempReleases\Snapshot\2\Fabrication\erc\foxbms2-interface-mc33664.html

Class | Document | Message
Warning | alarm-interface.SchDoc | GND_1 contains Input Sheet Entry and Unspecified Sheet Entry objects (Sheet Entry digital-isolator-alarm-1_INA(Input), Sheet Entry digital-isolator-alarm-1_INB(Input), Sheet Entry digital-isolator-alarm-1_INC(Input), Sheet Entry digital-isolator-alarm-1_GND(Passive)).
Warning | alarm-interface.SchDoc | GND_1 contains Unspecified Port and Input Sheet Entry objects (Port GND, Sheet Entry digital-isolator-alarm-1_INA(Input), Sheet Entry digital-isolator-alarm-1_INB(Input), Sheet Entry digital-isolator-alarm-1_INC(Input)).
Warning | alarm-interface.SchDoc | GND_2 contains Input Sheet Entry and Unspecified Sheet Entry objects (Sheet Entry digital-isolator-alarm-1_INA(Input), Sheet Entry digital-isolator-alarm-1_INB(Input), Sheet Entry digital-isolator-alarm-1_INC(Input), Sheet Entry digital-isolator-alarm-1_GND(Passive)).
Warning | alarm-interface.SchDoc | GND_2 contains Unspecified Port and Input Sheet Entry objects (Port GND, Sheet Entry digital-isolator-alarm-1_INA(Input), Sheet Entry digital-isolator-alarm-1_INB(Input), Sheet Entry digital-isolator-alarm-1_INC(Input)).
Warning | foxbms2-interface-mc33664.SchDoc | Net \MCU_SPI1.CS1 has no driving source (Pin J100-6, Pin R200-1, Pin TP_SPI1.CS1-1, Pin U200-2)
Warning | foxbms2-interface-mc33664.SchDoc | Net \MCU_SPI1.CS2 has no driving source (Pin J100-7, Pin R200-1, Pin TP_SPI1.CS2-1, Pin U200-2)
Warning | foxbms2-interface-mc33664.SchDoc | Net ALARM_1_IND has no driving source (Pin C401-2, Pin D400-1, Pin R401-1, Pin R402-1, Pin U400-11)
Warning | foxbms2-interface-mc33664.SchDoc | Net ALARM_2_IND has no driving source (Pin C401-2, Pin D400-1, Pin R401-1, Pin R402-1, Pin U400-11)
Warning | foxbms2-interface-mc33664.SchDoc | Net EN_1 has no driving source (Pin R100-2, Pin R101-2, Pin R206-2, Pin TP_EN1-1, Pin U200-4)
Warning | foxbms2-interface-mc33664.SchDoc | Net EN_2 has no driving source (Pin R102-2, Pin R103-2, Pin R206-2, Pin TP_EN2-1, Pin U200-4)
Warning | foxbms2-interface-mc33664.SchDoc | Net MCU_SPI1.CLK has no driving source (Pin J100-5, Pin TP_SPI1.CLK-1, Pin U200-1, Pin U200-1)
Warning | foxbms2-interface-mc33664.SchDoc | Net MCU_SPI1.SIMO0 has no driving source (Pin J100-3, Pin TP_SPI1.SIMO0-1, Pin U200-3, Pin U200-3)
Warning | foxbms2-interface-mc33664.SchDoc | Nets Wire \IF_INT0 has multiple names (Net Label \IF_INT0 (2), Net Label \INT_1 (2), Port \INT_1, Sheet Entry TPL-transceiver-1-\INT(Output))
Warning | foxbms2-interface-mc33664.SchDoc | Nets Wire \IF_INT1 has multiple names (Net Label \IF_INT1 (2), Net Label \INT_2 (2), Port \INT_2, Sheet Entry TPL-transceiver-2-\INT(Output))
Warning | foxbms2-interface-mc33664.SchDoc | Nets Wire \MCU_SPI1.CS1 has multiple names (Net Label \MCU_SPI1.CS1 (2), Port \CS_TX_1, Sheet Entry TPL-transceiver-1-\CS_TX(Input))
Warning | foxbms2-interface-mc33664.SchDoc | Nets Wire \MCU_SPI1.CS2 has multiple names (Net Label \MCU_SPI1.CS2 (2), Port \CS_TX_2, Sheet Entry TPL-transceiver-2-\CS_TX(Input))
Warning | foxbms2-interface-mc33664.SchDoc | Nets Wire \MCU_SPI4.CS0 has multiple names (Net Label \MCU_SPI4.CS0 (2), Port \CS_RX_1, Sheet Entry TPL-transceiver-1-\CS_RX(Output))
Warning | foxbms2-interface-mc33664.SchDoc | Nets Wire \MCU_SPI4.CS1 has multiple names (Net Label \MCU_SPI4.CS1 (2), Port \CS_RX_2, Sheet Entry TPL-transceiver-2-\CS_RX(Output))
Warning | foxbms2-interface-mc33664.SchDoc | Nets Wire ALARM_1._P has multiple names (Net Label ALARM_1._P, Net Label ALARM_1_P, Port ALARM_IN._P_1, Sheet Entry alarm-interface-1-ALARM_IN._P(Passive))
Warning | foxbms2-interface-mc33664.SchDoc | Nets Wire ALARM_1_IND has multiple names (Net Label ALARM_1_IND, Net Label IND_1 (2), Port 2_IND_1, Port ALARM_UNUSED.6_1, Sheet Entry alarm-interface-1-ALARM_UNUSED.6(Passive), Sheet Entry digital-isolator-alarm-2_IND_1(Input))
Warning | foxbms2-interface-mc33664.SchDoc | Nets Wire ALARM_2._P has multiple names (Net Label ALARM_2._P, Net Label ALARM_2_P, Port ALARM_IN._P_2, Sheet Entry alarm-interface-2-ALARM_IN._P(Passive))
Warning | foxbms2-interface-mc33664.SchDoc | Nets Wire ALARM_2_IND has multiple names (Net Label ALARM_2_IND, Net Label IND_2 (2), Port 2_IND_2, Port ALARM_UNUSED.6_2, Sheet Entry alarm-interface-2-ALARM_UNUSED.6(Passive), Sheet Entry digital-isolator-alarm-2_IND_2(Input))
Warning | foxbms2-interface-mc33664.SchDoc | Nets Wire EN_1 has multiple names (Net Label EN_1 (2), Port EN_1, Sheet Entry TPL-transceiver-1-EN(Input))
Warning | foxbms2-interface-mc33664.SchDoc | Nets Wire EN_2 has multiple names (Net Label EN_2 (2), Port EN_2, Sheet Entry TPL-transceiver-2-EN(Input))

Warning

foxbms2-interface-mc33664.SchDoc

Nets Wire GND has multiple names (Port 1_GND_1, Port 1_GND_2, Port 1_INA_1, Port 1_INA_2, Port 1_INB_1, Port 1_INB_2, Port 1_INC_1, Port 1_INC_2, Port GND_1 (3), Port GND_2 (3), Power Object GND (9), Power Object GND1_1, Power Object GND1_2, Power Object GND_1 (16), Power Object GND_2 (16), Sheet Entry alarm-interface-1-GND(Passive), Sheet Entry alarm-interface-2-GND(Passive), Sheet Entry digital-isolator-alarm-1_GND_1(Passive), Sheet Entry digital-isolator-alarm-1_GND_2(Passive), Sheet Entry digital-isolator-alarm-1_INA_1(Input), Sheet Entry digital-isolator-alarm-1_INA_2(Input), Sheet Entry digital-isolator-alarm-1_INB_1(Input), Sheet Entry digital-isolator-alarm-1_INB_2(Input), Sheet Entry digital-isolator-alarm-1_INC_1(Input), Sheet Entry digital-isolator-alarm-1_INC_2(Input), Sheet Entry TPL-transceiver-1-GND(Passive), Sheet Entry TPL-transceiver-2-GND(Passive), Sheet Entry TPL-transformer-1-GND(Passive), Sheet Entry TPL-transformer-2-GND(Passive))
Warning | foxbms2-interface-mc33664.SchDoc | Nets Wire GND_ISO_1 has multiple names (Net Label ALARM_1._N, Net Label ALARM_1_N, Port 2_GND_1, Port ALARM_IN._N_1, Power Object GND2_1 (2), Power Object GND_ISO_1, Sheet Entry alarm-interface-1-ALARM_IN._N(Passive), Sheet Entry digital-isolator-alarm-2_GND_1(Passive))
Warning | foxbms2-interface-mc33664.SchDoc | Nets Wire GND_ISO_2 has multiple names (Net Label ALARM_2._N, Net Label ALARM_2_N, Port 2_GND_2, Port ALARM_IN._N_2, Power Object GND2_2 (2), Power Object GND_ISO_2, Sheet Entry alarm-interface-2-ALARM_IN._N(Passive), Sheet Entry digital-isolator-alarm-2_GND_2(Passive))
Warning | foxbms2-interface-mc33664.SchDoc | Nets Wire MCU_SPI1.CLK has multiple names (Net Label MCU_SPI1.CLK (3), Port SCLK_TX_1, Port SCLK_TX_2, Sheet Entry TPL-transceiver-1-SCLK_TX(Input), Sheet Entry TPL-transceiver-2-SCLK_TX(Input))
Warning | foxbms2-interface-mc33664.SchDoc | Nets Wire MCU_SPI1.SIMO0 has multiple names (Net Label MCU_SPI1.SIMO0 (3), Port DATA_TX_1, Port DATA_TX_2, Sheet Entry TPL-transceiver-1-DATA_TX(Input), Sheet Entry TPL-transceiver-2-DATA_TX(Input))
Warning | foxbms2-interface-mc33664.SchDoc | Nets Wire MCU_SPI4.CLK has multiple names (Net Label MCU_SPI4.CLK (3), Port SCLK_RX_1, Port SCLK_RX_2, Sheet Entry TPL-transceiver-1-SCLK_RX(Output), Sheet Entry TPL-transceiver-2-SCLK_RX(Output))
Warning | foxbms2-interface-mc33664.SchDoc | Nets Wire MCU_SPI4.SIMO has multiple names (Net Label MCU_SPI4.SIMO (3), Port DATA_RX_1, Port DATA_RX_2, Sheet Entry TPL-transceiver-1-DATA_RX(Output), Sheet Entry TPL-transceiver-2-DATA_RX(Output))
Warning | foxbms2-interface-mc33664.SchDoc | Nets Wire PER_3.3V has multiple names (Port 1_VCC_1, Port 1_VCC_2, Port VCC_1, Port VCC_2, Port VIO_1, Port VIO_2, Power Object PER_3.3V (7), Power Object VCC1_1, Power Object VCC1_2, Power Object VCC_1, Power Object VCC_2, Power Object VIO_1 (4), Power Object VIO_2 (4), Sheet Entry alarm-interface-1-VCC(Passive), Sheet Entry alarm-interface-2-VCC(Passive), Sheet Entry digital-isolator-alarm-1_VCC_1(Passive), Sheet Entry digital-isolator-alarm-1_VCC_2(Passive), Sheet Entry TPL-transceiver-1-VIO(Passive), Sheet Entry TPL-transceiver-2-VIO(Passive))
Warning | foxbms2-interface-mc33664.SchDoc | Nets Wire PER_5.0V has multiple names (Port VCC_5.0V_1, Port VCC_5.0V_2, Power Object PER_5.0V (4), Power Object VCC_5.0V_1, Power Object VCC_5.0V_2, Sheet Entry TPL-transceiver-1-VCC_5.0V(Passive), Sheet Entry TPL-transceiver-2-VCC_5.0V(Passive))
Warning | foxbms2-interface-mc33664.SchDoc | Nets Wire TPL_1._N has multiple names (Net Label TPL_1._N, Net Label TPL_1_N, Net Label TPL_EXT_1_N, Port TPL_EXT._N_1, Sheet Entry TPL-transformer-1-TPL_EXT._N(Passive))
Warning | foxbms2-interface-mc33664.SchDoc | Nets Wire TPL_1._P has multiple names (Net Label TPL_1._P, Net Label TPL_1_P, Net Label TPL_EXT_1_P, Port TPL_EXT._P_1, Sheet Entry TPL-transformer-1-TPL_EXT._P(Passive))
Warning | foxbms2-interface-mc33664.SchDoc | Nets Wire TPL_2._N has multiple names (Net Label TPL_2._N, Net Label TPL_2_N, Net Label TPL_EXT_2_N, Port TPL_EXT._N_2, Sheet Entry TPL-transformer-2-TPL_EXT._N(Passive))
Warning | foxbms2-interface-mc33664.SchDoc | Nets Wire TPL_2._P has multiple names (Net Label TPL_2._P, Net Label TPL_2_P, Net Label TPL_EXT_2_P, Port TPL_EXT._P_2, Sheet Entry TPL-transformer-2-TPL_EXT._P(Passive))
Warning | foxbms2-interface-mc33664.SchDoc | Nets Wire TPL_INT_1_N has multiple names (Net Label TPL_1_N, Net Label TPL_INT_1_N, Port TPL._N_1, Port TPL_INT._N_1, Sheet Entry TPL-transceiver-1-TPL._N(Passive), Sheet Entry TPL-transformer-1-TPL_INT._N(Passive))
Warning | foxbms2-interface-mc33664.SchDoc | Nets Wire TPL_INT_1_P has multiple names (Net Label TPL_1_P, Net Label TPL_INT_1_P, Port TPL._P_1, Port TPL_INT._P_1, Sheet Entry TPL-transceiver-1-TPL._P(Passive), Sheet Entry TPL-transformer-1-TPL_INT._P(Passive))
Warning | foxbms2-interface-mc33664.SchDoc | Nets Wire TPL_INT_2_N has multiple names (Net Label TPL_2_N, Net Label TPL_INT_2_N, Port TPL._N_2, Port TPL_INT._N_2, Sheet Entry TPL-transceiver-2-TPL._N(Passive), Sheet Entry TPL-transformer-2-TPL_INT._N(Passive))
Warning | foxbms2-interface-mc33664.SchDoc | Nets Wire TPL_INT_2_P has multiple names (Net Label TPL_2_P, Net Label TPL_INT_2_P, Port TPL._P_2, Port TPL_INT._P_2, Sheet Entry TPL-transceiver-2-TPL._P(Passive), Sheet Entry TPL-transformer-2-TPL_INT._P(Passive))

Back to top
