emiln2002/BMS/master-v1.2.3-0/Fabrication/drc/foxbms2-master-drc-v1.2.3-0.html

Altium

# Design Rule Verification Report

Date: | | 31.03.2025
Time: | | 12:06:28
Elapsed Time: | | 00:00:35
Filename: | | C:\Users\grau\AppData\Local\TempReleases\Snapshot\2\foxbms2-master.PcbDoc

Warnings: | | 0
Rule Violations: | | 0
Waived Violations: | | 20

## Summary

Warnings | Count
Total | 0

Rule Violations | Count
Clearance Constraint (Gap=0.3mm) (InNetClass('iso_CAN2')),(Not InNetClass('iso_CAN2')) | 0
Clearance Constraint (Gap=0.102mm) (All),(All) | 0
Clearance Constraint (Gap=0.102mm) (WithinRoom('mcu_fanout')),(All) | 0
Clearance Constraint (Gap=0.3mm) (InNetClass('ETHERNET')),(Not InNetClass('ETHERNET')) | 0
Short-Circuit Constraint (Allowed=No) (All),(All) | 0
Un-Routed Net Constraint ( (All) ) | 0
Modified Polygon (Allow modified: No), (Allow shelved: No) | 0
Creepage Distance Constraint =(10mm) (InNetClass('ETHERNET')),(Not InNetClass('ETHERNET')) | 0
Creepage Distance Constraint =(10mm) (InNetClass('iso_CAN2')),(Not InNetClass('iso_CAN2')) | 0
Width Constraint (Min=0.102mm) (Max=0.102mm) (Preferred=0.102mm) (WithinRoom('mcu_fanout')) | 0
Width Constraint (Min=0.152mm) (Max=1.524mm) (Preferred=0.152mm) (All) | 0
Routing Via (MinHoleWidth=0.2mm) (MaxHoleWidth=0.2mm) (PreferredHoleWidth=0.2mm) (MinWidth=0.45mm) (MaxWidth=0.45mm) (PreferedWidth=0.45mm) (WithinRoom('mcu_fanout')) | 0
Routing Via (Templates Used To Check Via: 0.2mm_tented, 0.3mm_tented, 0.4mm_tented, 0.5mm_tented, 0.6mm_tented, 0.8mm_tented, 1.0mm_tented) (All) | 0
Differential Pairs Uncoupled Length using the Gap Constraints (Min=0.152mm) (Max=0.318mm) (Prefered=0.318mm) and Width Constraints (Min=0.102mm) (Max=0.254mm) (Prefered=0.152mm) (InNet('ETHERNET.RX1_1_P')) | 0
Differential Pairs Uncoupled Length using the Gap Constraints (Min=0.152mm) (Max=0.318mm) (Prefered=0.318mm) and Width Constraints (Min=0.102mm) (Max=0.254mm) (Prefered=0.152mm) (InNet('ETHERNET.RX1_1_N')) | 0
Differential Pairs Uncoupled Length using the Gap Constraints (Min=0.152mm) (Max=0.318mm) (Prefered=0.318mm) and Width Constraints (Min=0.102mm) (Max=0.254mm) (Prefered=0.152mm) (InNet('ETHERNET.TX1_1_P')) | 0
Differential Pairs Uncoupled Length using the Gap Constraints (Min=0.152mm) (Max=0.318mm) (Prefered=0.318mm) and Width Constraints (Min=0.102mm) (Max=0.254mm) (Prefered=0.152mm) (InNet('ETHERNET.TX2_1_N')) | 0
Differential Pairs Uncoupled Length using the Gap Constraints (Min=0.152mm) (Max=0.318mm) (Prefered=0.318mm) and Width Constraints (Min=0.102mm) (Max=0.254mm) (Prefered=0.152mm) (InNet('ETHERNET.TX2_1_P')) | 0
Differential Pairs Uncoupled Length using the Gap Constraints (Min=0.152mm) (Max=0.318mm) (Prefered=0.318mm) and Width Constraints (Min=0.102mm) (Max=0.254mm) (Prefered=0.152mm) (InNet('ETHERNET.RX2_1_N')) | 0
Differential Pairs Uncoupled Length using the Gap Constraints (Min=0.152mm) (Max=0.318mm) (Prefered=0.318mm) and Width Constraints (Min=0.102mm) (Max=0.254mm) (Prefered=0.152mm) (InNet('ETHERNET.RX2_1_P')) | 0
Differential Pairs Uncoupled Length using the Gap Constraints (Min=0.152mm) (Max=0.318mm) (Prefered=0.318mm) and Width Constraints (Min=0.102mm) (Max=0.254mm) (Prefered=0.152mm) (InNet('ETHERNET.TX1_1_N')) | 0
Differential Pairs Uncoupled Length using the Gap Constraints (Min=0.152mm) (Max=0.318mm) (Prefered=0.318mm) and Width Constraints (Min=0.102mm) (Max=0.254mm) (Prefered=0.152mm) (InNetClass('ETHERNET_INT')) | 0
SMD To Corner (Distance=0.102mm) (All) | 0
SMD Entry (Side = Allowed) (Corner = Allowed) (Any Angle = Not Allowed) (Ignore First Corner = Allowed) | 0
Power Plane Connect Rule(Direct Connect )(Expansion=0.508mm) (Conductor Width=0.254mm) (Air Gap=0.254mm) (Entries=4) (All) | 0
Minimum Annular Ring (Minimum=0.102mm) (All) | 0
Hole Size Constraint (Min=0.2mm) (Max=5.994mm) (All) | 0
Pads and Vias to follow the Drill pairs settings | 0
Hole To Hole Clearance (Gap=0.152mm) (All),(All) | 0
Silk To Solder Mask (Clearance=0.102mm) (IsPad),(All) | 0
Silk to Silk (Clearance=0.254mm) (All),(All) | 0
Net Antennae (Tolerance=0mm) (All) | 0
Board Clearance Constraint (Gap=0mm) (All) | 0
Room flash (Bounding Region = (152.241mm, 115.094mm, 169.069mm, 129.222mm) (InComponentClass('flash')) | 0
Room smart-switch2 (Bounding Region = (111.601mm, 45.403mm, 136.684mm, 65.881mm) (InComponentClass('smart-switch2')) | 0
Room sensor-hum-temp (Bounding Region = (91.757mm, 106.362mm, 96.52mm, 111.919mm) (InComponentClass('sensor-hum-temp')) | 0
Room smart-switches (Bounding Region = (58.42mm, 48.895mm, 67.627mm, 59.214mm) (InComponentClass('smart-switches')) | 0
Room can-transceiver2 (Bounding Region = (210.185mm, 38.1mm, 223.361mm, 70.168mm) (InComponentClass('can-transceiver2')) | 0
Room contactor-feedback (Bounding Region = (58.42mm, 44.609mm, 67.627mm, 48.736mm) (InComponentClass('contactor-feedback')) | 0
Room window-watchdog (Bounding Region = (192.088mm, 73.978mm, 207.963mm, 85.566mm) (InComponentClass('window-watchdog')) | 0
Room port-expander1 (Bounding Region = (98.266mm, 46.831mm, 110.966mm, 65.881mm) (InComponentClass('port-expander1')) | 0
Room mram (Bounding Region = (143.034mm, 120.968mm, 150.812mm, 130.493mm) (InComponentClass('mram')) | 0
Room fram (Bounding Region = (141.923mm, 111.919mm, 152.083mm, 120.968mm) (InComponentClass('fram')) | 0
Room port-expander2 (Bounding Region = (100.013mm, 107.156mm, 119.062mm, 119.856mm) (InComponentClass('port-expander2')) | 0
Room rs232-rs485-transceiver (Bounding Region = (181.61mm, 60.325mm, 194.469mm, 71.914mm) (InComponentClass('rs232-rs485-transceiver')) | 0
Room port-expanders (Bounding Region = (115.888mm, 117.475mm, 119.062mm, 119.856mm) (InComponentClass('port-expanders')) | 0
Room port-expander3 (Bounding Region = (122.237mm, 107.156mm, 141.287mm, 119.856mm) (InComponentClass('port-expander3')) | 0
Room oscillator-25MHz (Bounding Region = (174.308mm, 60.325mm, 180.657mm, 66.04mm) (InComponentClass('oscillator-25MHz')) | 0
Room insulation-monitoring (Bounding Region = (154.623mm, 44.45mm, 167.799mm, 60.642mm) (InComponentClass('insulation-monitoring')) | 0
Room mcu_fanout (Bounding Region = (160.814mm, 83.344mm, 178.911mm, 101.441mm) (InComponent('U5000')) | 0
Room oscillator-20MHz (Bounding Region = (188.912mm, 90.329mm, 195.262mm, 96.044mm) (InComponentClass('oscillator-20MHz')) | 0
Room rtc (Bounding Region = (59.531mm, 105.251mm, 88.582mm, 144.145mm) (InComponentClass('rtc')) | 0
Room smart-switch1 (Bounding Region = (67.786mm, 45.403mm, 92.869mm, 65.881mm) (InComponentClass('smart-switch1')) | 0
Room can-transceiver1 (Bounding Region = (194.786mm, 43.974mm, 207.963mm, 74.49mm) (InComponentClass('can-transceiver1')) | 0
Room vref-5.0V (Bounding Region = (139.382mm, 76.835mm, 148.114mm, 84.455mm) (InComponentClass('vref-5.0V')) | 0
Room ethernet-phy (Bounding Region = (188.278mm, 88.106mm, 223.202mm, 136.366mm) (InComponentClass('ethernet-phy')) | 0
Room digital-isolator-can (Bounding Region = (209.391mm, 66.516mm, 223.202mm, 86.201mm) (InComponentClass('digital-isolator-can')) | 0
Room sbc-mcu (Bounding Region = (99.695mm, 66.675mm, 139.224mm, 104.14mm) (InComponentClass('sbc-mcu')) | 0
Room interlock (Bounding Region = (167.958mm, 38.894mm, 194.469mm, 59.69mm) (InComponentClass('interlock')) | 0
Room buck-boost-converter (Bounding Region = (29.369mm, 80.328mm, 56.197mm, 133.35mm) (InComponentClass('buck-boost-converter')) | 0
Room supply-protection-30C (Bounding Region = (29.369mm, 59.214mm, 54.292mm, 80.01mm) (InComponentClass('supply-protection-30C')) | 0
Room supply-protection-30 (Bounding Region = (29.369mm, 38.1mm, 54.292mm, 58.896mm) (InComponentClass('supply-protection-30')) | 0
Component Clearance Constraint ( Horizontal Gap = 0.2mm, Vertical Gap = 0.5mm ) (All),(All) | 0
Component Clearance Constraint ( Horizontal Gap = -100mm, Vertical Gap = -100mm ) (InComponent('BT6401')),(All) | 0
Height Constraint (Min=0mm) (Max=25.4mm) (Prefered=12.7mm) (All) | 0
Total | 0

Waived Violations | Count
Routing Via (Templates Used To Check Via: 0.2mm_tented, 0.3mm_tented, 0.4mm_tented, 0.5mm_tented, 0.6mm_tented, 0.8mm_tented, 1.0mm_tented) (All) | 20
Total | 20

## Rule Violations

## Waived Violations

Routing Via (Templates Used To Check Via: 0.2mm_tented, 0.3mm_tented, 0.4mm_tented, 0.5mm_tented, 0.6mm_tented, 0.8mm_tented, 1.0mm_tented) (All)

Routing Via Style: Via (45.584mm,30.724mm) from Top to Bottom Actual Size : 0.5mm Actual Hole Size : 0.2mm
Waived by Oliver Grau at 17.12.2024 17:10:30

Routing Via Style: Via (45.584mm,31.824mm) from Top to Bottom Actual Size : 0.5mm Actual Hole Size : 0.2mm
Waived by Oliver Grau at 17.12.2024 17:10:39

Routing Via Style: Via (46.684mm,30.724mm) from Top to Bottom Actual Size : 0.5mm Actual Hole Size : 0.2mm
Waived by Oliver Grau at 17.12.2024 17:10:46

Routing Via Style: Via (46.684mm,31.824mm) from Top to Bottom Actual Size : 0.5mm Actual Hole Size : 0.2mm
Waived by Oliver Grau at 17.12.2024 17:10:53

Routing Via Style: Via (47.784mm,30.724mm) from Top to Bottom Actual Size : 0.5mm Actual Hole Size : 0.2mm
Waived by Oliver Grau at 17.12.2024 17:11:00

Routing Via Style: Via (47.784mm,31.824mm) from Top to Bottom Actual Size : 0.5mm Actual Hole Size : 0.2mm
Waived by Oliver Grau at 17.12.2024 17:11:07

Routing Via Style: Via (48.884mm,30.724mm) from Top to Bottom Actual Size : 0.5mm Actual Hole Size : 0.2mm
Waived by Oliver Grau at 17.12.2024 17:11:13

Routing Via Style: Via (48.884mm,31.824mm) from Top to Bottom Actual Size : 0.5mm Actual Hole Size : 0.2mm
Waived by Oliver Grau at 17.12.2024 17:11:21

Routing Via Style: Via (49.984mm,30.724mm) from Top to Bottom Actual Size : 0.5mm Actual Hole Size : 0.2mm
Waived by Oliver Grau at 17.12.2024 17:11:29

Routing Via Style: Via (49.984mm,31.824mm) from Top to Bottom Actual Size : 0.5mm Actual Hole Size : 0.2mm
Waived by Oliver Grau at 17.12.2024 17:11:36

Routing Via Style: Via (89.557mm,30.724mm) from Top to Bottom Actual Size : 0.5mm Actual Hole Size : 0.2mm
Waived by Oliver Grau at 17.12.2024 17:11:43

Routing Via Style: Via (89.557mm,31.824mm) from Top to Bottom Actual Size : 0.5mm Actual Hole Size : 0.2mm
Waived by Oliver Grau at 17.12.2024 17:11:50

Routing Via Style: Via (90.657mm,30.724mm) from Top to Bottom Actual Size : 0.5mm Actual Hole Size : 0.2mm
Waived by Oliver Grau at 17.12.2024 17:11:56

Routing Via Style: Via (90.657mm,31.824mm) from Top to Bottom Actual Size : 0.5mm Actual Hole Size : 0.2mm
Waived by Oliver Grau at 17.12.2024 17:12:08

Routing Via Style: Via (91.757mm,30.724mm) from Top to Bottom Actual Size : 0.5mm Actual Hole Size : 0.2mm
Waived by Oliver Grau at 17.12.2024 17:12:08

Routing Via Style: Via (91.757mm,31.824mm) from Top to Bottom Actual Size : 0.5mm Actual Hole Size : 0.2mm
Waived by Oliver Grau at 17.12.2024 17:12:08

Routing Via Style: Via (92.857mm,30.724mm) from Top to Bottom Actual Size : 0.5mm Actual Hole Size : 0.2mm
Waived by Oliver Grau at 17.12.2024 17:12:08

Routing Via Style: Via (92.857mm,31.824mm) from Top to Bottom Actual Size : 0.5mm Actual Hole Size : 0.2mm
Waived by Oliver Grau at 17.12.2024 17:12:08

Routing Via Style: Via (93.957mm,30.724mm) from Top to Bottom Actual Size : 0.5mm Actual Hole Size : 0.2mm
Waived by Oliver Grau at 17.12.2024 17:12:08

Routing Via Style: Via (93.957mm,31.824mm) from Top to Bottom Actual Size : 0.5mm Actual Hole Size : 0.2mm
Waived by Oliver Grau at 17.12.2024 17:12:08

Back to top
