emiln2002/BMS/slave_v2/Fabrication/drc/slave-14-mc33775.html

Altium

# Design Rule Verification Report

Date: | | 2024-12-18
Time: | | 10:20:31
Elapsed Time: | | 00:00:14
Filename: | | C:\Users\schwarz\AppData\Local\TempReleases\Snapshot\2\slave-14-mc33775.PcbDoc

Warnings: | | 0
Rule Violations: | | 0
Waived Violations: | | 38

## Summary

Warnings | Count
Total | 0

Rule Violations | Count
Clearance Constraint (Gap=43.307mil) (InNetClass('TPL_high')),(Not InNetClass('TPL_high')) | 0
Clearance Constraint (Gap=43.307mil) (InNetClass('ALARM_in')),(Not InNetClass('ALARM_in')) | 0
Clearance Constraint (Gap=43.307mil) (InNetClass('TPL_low')),(Not InNetClass('TPL_low')) | 0
Clearance Constraint (Gap=4mil) (All),(All) | 0
Short-Circuit Constraint (Allowed=No) (All),(All) | 0
Un-Routed Net Constraint ( (All) ) | 0
Modified Polygon (Allow modified: No), (Allow shelved: No) | 0
Creepage Distance Constraint =(629.921mil) (InNetClass('TPL_low')),(Not InNetClass('TPL_low')) | 0
Creepage Distance Constraint =(629.921mil) (InNetClass('TPL_high')),(Not InNetClass('TPL_high')) | 0
Creepage Distance Constraint =(4mil) (Disabled)(All),(All) | 0
Creepage Distance Constraint =(629.921mil) (InNetClass('ALARM_in')),(Not InNetClass('ALARM_in')) | 0
Width Constraint (Min=4mil) (Max=60mil) (Preferred=6mil) (All) | 0
SMD To Corner (Distance=4mil) (All) | 0
SMD Entry (Side = Allowed) (Corner = Allowed) (Any Angle = Not Allowed) (Ignore First Corner = Allowed) | 0
Power Plane Connect Rule(Direct Connect )(Expansion=20mil) (Conductor Width=10mil) (Air Gap=10mil) (Entries=4) (All) | 0
Minimum Annular Ring (Minimum=3.93mil) (All) | 0
Hole Size Constraint (Min=7.874mil) (Max=236mil) (All) | 0
Hole To Hole Clearance (Gap=6mil) (All),(All) | 0
Minimum Solder Mask Sliver (Gap=4mil) (All),(All) | 0
Silk To Solder Mask (Clearance=4mil) (IsPad),(All) | 0
Silk to Silk (Clearance=10mil) (All),(All) | 0
Net Antennae (Tolerance=0mil) (All) | 0
Board Clearance Constraint (Gap=0mil) (All) | 0
Room U_ldo (Bounding Region = (4926.909mil, 5348.513mil, 5360.492mil, 5900.354mil) (InComponentClass('U_ldo')) | 0
Room U_input_filter (Bounding Region = (5692.362mil, 3599.646mil, 7173.386mil, 4303.898mil) (InComponentClass('U_input_filter')) | 0
Room U_passive_balancing (Bounding Region = (3404.862mil, 5901.221mil, 8910.886mil, 6713.74mil) (InComponentClass('U_passive_balancing')) | 0
Room U_analog_in_bank1 (Bounding Region = (3208.701mil, 3600.63mil, 4446.417mil, 4828.307mil) (InComponentClass('U_analog_in_bank1')) | 0
Room U_sensors (Bounding Region = (3242.362mil, 5224.252mil, 3694.646mil, 5928.898mil) (InComponentClass('U_sensors')) | 0
Room U_eeprom (Bounding Region = (5020.709mil, 4947.48mil, 5545.039mil, 5255.276mil) (InComponentClass('U_eeprom')) | 0
Room U_analog_in_bank0 (Bounding Region = (4358.701mil, 3600.63mil, 5596.417mil, 4828.307mil) (InComponentClass('U_analog_in_bank0')) | 0
Room U_dcdc-converter (Bounding Region = (7681.831mil, 4769.921mil, 8733.917mil, 5740.807mil) (InComponentClass('U_dcdc-converter')) | 0
Room U_digital_io (Bounding Region = (3850.63mil, 4941.969mil, 4974.961mil, 5469.055mil) (InComponentClass('U_digital_io')) | 0
Height Constraint (Min=0mil) (Max=1000mil) (Prefered=500mil) (All) | 0
Total | 0

Waived Violations | Count
Minimum Solder Mask Sliver (Gap=4mil) (All),(All) | 38
Total | 38

## Rule Violations

## Waived Violations

Minimum Solder Mask Sliver (Gap=4mil) (All),(All)

Minimum Solder Mask Sliver Constraint: (3.874mil < 4mil) Between Pad U601-1(6103.74mil,1337.992mil) on Top Copper And Pad U601-2(6072.244mil,1337.992mil) on Top Copper [Top Solder] Mask Sliver [3.874mil]
Waived by Patrick Kanzler at 2021-06-25 16:24:44
Allow minimum solder mask sliver violations.

Minimum Solder Mask Sliver Constraint: (3.874mil < 4mil) Between Pad U601-10(6040.748mil,962.008mil) on Top Copper And Pad U601-11(6072.244mil,962.008mil) on Top Copper [Top Solder] Mask Sliver [3.874mil]
Waived by Patrick Kanzler at 2021-06-25 16:24:44
Allow minimum solder mask sliver violations.

Minimum Solder Mask Sliver Constraint: (3.874mil < 4mil) Between Pad U601-10(6040.748mil,962.008mil) on Top Copper And Pad U601-9(6009.252mil,962.008mil) on Top Copper [Top Solder] Mask Sliver [3.874mil]
Waived by Patrick Kanzler at 2021-06-25 16:24:44
Allow minimum solder mask sliver violations.

Minimum Solder Mask Sliver Constraint: (3.874mil < 4mil) Between Pad U601-11(6072.244mil,962.008mil) on Top Copper And Pad U601-12(6103.74mil,962.008mil) on Top Copper [Top Solder] Mask Sliver [3.874mil]
Waived by Patrick Kanzler at 2021-06-25 16:24:44
Allow minimum solder mask sliver violations.

Minimum Solder Mask Sliver Constraint: (3.874mil < 4mil) Between Pad U601-2(6072.244mil,1337.992mil) on Top Copper And Pad U601-3(6040.748mil,1337.992mil) on Top Copper [Top Solder] Mask Sliver [3.874mil]
Waived by Patrick Kanzler at 2021-06-25 16:24:44
Allow minimum solder mask sliver violations.

Minimum Solder Mask Sliver Constraint: (3.874mil < 4mil) Between Pad U601-3(6040.748mil,1337.992mil) on Top Copper And Pad U601-4(6009.252mil,1337.992mil) on Top Copper [Top Solder] Mask Sliver [3.874mil]
Waived by Patrick Kanzler at 2021-06-25 16:24:44
Allow minimum solder mask sliver violations.

Minimum Solder Mask Sliver Constraint: (3.874mil < 4mil) Between Pad U601-4(6009.252mil,1337.992mil) on Top Copper And Pad U601-5(5977.756mil,1337.992mil) on Top Copper [Top Solder] Mask Sliver [3.874mil]
Waived by Patrick Kanzler at 2021-06-25 16:24:44
Allow minimum solder mask sliver violations.

Minimum Solder Mask Sliver Constraint: (3.874mil < 4mil) Between Pad U601-5(5977.756mil,1337.992mil) on Top Copper And Pad U601-6(5946.26mil,1337.992mil) on Top Copper [Top Solder] Mask Sliver [3.874mil]
Waived by Patrick Kanzler at 2021-06-25 16:24:44
Allow minimum solder mask sliver violations.

Minimum Solder Mask Sliver Constraint: (3.874mil < 4mil) Between Pad U601-7(5946.26mil,962.008mil) on Top Copper And Pad U601-8(5977.756mil,962.008mil) on Top Copper [Top Solder] Mask Sliver [3.874mil]
Waived by Patrick Kanzler at 2021-06-25 16:24:44
Allow minimum solder mask sliver violations.

Minimum Solder Mask Sliver Constraint: (3.874mil < 4mil) Between Pad U601-8(5977.756mil,962.008mil) on Top Copper And Pad U601-9(6009.252mil,962.008mil) on Top Copper [Top Solder] Mask Sliver [3.874mil]
Waived by Patrick Kanzler at 2021-06-25 16:24:44
Allow minimum solder mask sliver violations.

Minimum Solder Mask Sliver Constraint: (1.906mil < 4mil) Between Pad U850-1(2111.614mil,2674.902mil) on Top Copper And Pad U850-2(2137.205mil,2674.902mil) on Top Copper [Top Solder] Mask Sliver [1.906mil]
Waived by Patrick Kanzler at 2021-07-13 10:00:23
Allow minimum solder mask sliver violation.

Minimum Solder Mask Sliver Constraint: (1.906mil < 4mil) Between Pad U850-2(2137.205mil,2674.902mil) on Top Copper And Pad U850-3(2162.795mil,2674.902mil) on Top Copper [Top Solder] Mask Sliver [1.906mil]
Waived by Patrick Kanzler at 2021-07-13 10:00:23
Allow minimum solder mask sliver violation.

Minimum Solder Mask Sliver Constraint: (1.906mil < 4mil) Between Pad U850-3(2162.795mil,2674.902mil) on Top Copper And Pad U850-4(2188.386mil,2674.902mil) on Top Copper [Top Solder] Mask Sliver [1.906mil]
Waived by Patrick Kanzler at 2021-07-13 10:00:23
Allow minimum solder mask sliver violation.

Minimum Solder Mask Sliver Constraint: (1.906mil < 4mil) Between Pad U850-5(2188.386mil,2850.099mil) on Top Copper And Pad U850-6(2162.795mil,2850.099mil) on Top Copper [Top Solder] Mask Sliver [1.906mil]
Waived by Patrick Kanzler at 2021-06-25 16:24:44
Allow minimum solder mask sliver violations.

Minimum Solder Mask Sliver Constraint: (1.906mil < 4mil) Between Pad U850-6(2162.795mil,2850.099mil) on Top Copper And Pad U850-7(2137.205mil,2850.099mil) on Top Copper [Top Solder] Mask Sliver [1.906mil]
Waived by Patrick Kanzler at 2021-07-13 10:00:23
Allow minimum solder mask sliver violation.

Minimum Solder Mask Sliver Constraint: (1.906mil < 4mil) Between Pad U850-7(2137.205mil,2850.099mil) on Top Copper And Pad U850-8(2111.614mil,2850.099mil) on Top Copper [Top Solder] Mask Sliver [1.906mil]
Waived by Patrick Kanzler at 2021-07-13 10:00:23
Allow minimum solder mask sliver violation.

Minimum Solder Mask Sliver Constraint: (3.874mil < 4mil) Between Pad U900-1(1284.842mil,2406.496mil) on Top Copper And Pad U900-2(1284.842mil,2380.905mil) on Top Copper [Top Solder] Mask Sliver [3.874mil]
Waived by Patrick Kanzler at 2021-06-25 16:24:44
Allow minimum solder mask sliver violations.

Minimum Solder Mask Sliver Constraint: (3.874mil < 4mil) Between Pad U900-10(1284.842mil,2176.181mil) on Top Copper And Pad U900-11(1284.842mil,2150.591mil) on Top Copper [Top Solder] Mask Sliver [3.874mil]
Waived by Patrick Kanzler at 2021-06-25 16:24:44
Allow minimum solder mask sliver violations.

Minimum Solder Mask Sliver Constraint: (3.874mil < 4mil) Between Pad U900-10(1284.842mil,2176.181mil) on Top Copper And Pad U900-9(1284.842mil,2201.772mil) on Top Copper [Top Solder] Mask Sliver [3.874mil]
Waived by Patrick Kanzler at 2021-06-25 16:24:44
Allow minimum solder mask sliver violations.

Minimum Solder Mask Sliver Constraint: (3.874mil < 4mil) Between Pad U900-11(1284.842mil,2150.591mil) on Top Copper And Pad U900-12(1284.842mil,2125mil) on Top Copper [Top Solder] Mask Sliver [3.874mil]
Waived by Patrick Kanzler at 2021-06-25 16:24:44
Allow minimum solder mask sliver violations.

Minimum Solder Mask Sliver Constraint: (3.874mil < 4mil) Between Pad U900-13(1525mil,2125mil) on Top Copper And Pad U900-14(1525mil,2150.591mil) on Top Copper [Top Solder] Mask Sliver [3.874mil]
Waived by Patrick Kanzler at 2021-06-25 16:24:44
Allow minimum solder mask sliver violations.

Minimum Solder Mask Sliver Constraint: (3.874mil < 4mil) Between Pad U900-14(1525mil,2150.591mil) on Top Copper And Pad U900-15(1525mil,2176.181mil) on Top Copper [Top Solder] Mask Sliver [3.874mil]
Waived by Patrick Kanzler at 2021-06-25 16:24:44
Allow minimum solder mask sliver violations.

Minimum Solder Mask Sliver Constraint: (3.874mil < 4mil) Between Pad U900-15(1525mil,2176.181mil) on Top Copper And Pad U900-16(1525mil,2201.772mil) on Top Copper [Top Solder] Mask Sliver [3.874mil]
Waived by Patrick Kanzler at 2021-06-25 16:24:44
Allow minimum solder mask sliver violations.

Minimum Solder Mask Sliver Constraint: (3.874mil < 4mil) Between Pad U900-16(1525mil,2201.772mil) on Top Copper And Pad U900-17(1525mil,2227.362mil) on Top Copper [Top Solder] Mask Sliver [3.874mil]
Waived by Patrick Kanzler at 2021-06-25 16:24:44
Allow minimum solder mask sliver violations.

Minimum Solder Mask Sliver Constraint: (3.874mil < 4mil) Between Pad U900-17(1525mil,2227.362mil) on Top Copper And Pad U900-18(1525mil,2252.953mil) on Top Copper [Top Solder] Mask Sliver [3.874mil]
Waived by Patrick Kanzler at 2021-06-25 16:24:44
Allow minimum solder mask sliver violations.

Minimum Solder Mask Sliver Constraint: (3.874mil < 4mil) Between Pad U900-18(1525mil,2252.953mil) on Top Copper And Pad U900-19(1525mil,2278.543mil) on Top Copper [Top Solder] Mask Sliver [3.874mil]
Waived by Patrick Kanzler at 2021-06-25 16:24:44
Allow minimum solder mask sliver violations.

Minimum Solder Mask Sliver Constraint: (3.874mil < 4mil) Between Pad U900-19(1525mil,2278.543mil) on Top Copper And Pad U900-20(1525mil,2304.134mil) on Top Copper [Top Solder] Mask Sliver [3.874mil]
Waived by Patrick Kanzler at 2021-06-25 16:24:44
Allow minimum solder mask sliver violations.

Minimum Solder Mask Sliver Constraint: (3.874mil < 4mil) Between Pad U900-2(1284.842mil,2380.905mil) on Top Copper And Pad U900-3(1284.842mil,2355.315mil) on Top Copper [Top Solder] Mask Sliver [3.874mil]
Waived by Patrick Kanzler at 2021-06-25 16:24:44
Allow minimum solder mask sliver violations.

Minimum Solder Mask Sliver Constraint: (3.874mil < 4mil) Between Pad U900-20(1525mil,2304.134mil) on Top Copper And Pad U900-21(1525mil,2329.724mil) on Top Copper [Top Solder] Mask Sliver [3.874mil]
Waived by Patrick Kanzler at 2021-06-25 16:24:44
Allow minimum solder mask sliver violations.

Minimum Solder Mask Sliver Constraint: (3.874mil < 4mil) Between Pad U900-21(1525mil,2329.724mil) on Top Copper And Pad U900-22(1525mil,2355.315mil) on Top Copper [Top Solder] Mask Sliver [3.874mil]
Waived by Patrick Kanzler at 2021-06-25 16:24:44
Allow minimum solder mask sliver violations.

Minimum Solder Mask Sliver Constraint: (3.874mil < 4mil) Between Pad U900-22(1525mil,2355.315mil) on Top Copper And Pad U900-23(1525mil,2380.905mil) on Top Copper [Top Solder] Mask Sliver [3.874mil]
Waived by Patrick Kanzler at 2021-06-25 16:24:44
Allow minimum solder mask sliver violations.

Minimum Solder Mask Sliver Constraint: (3.874mil < 4mil) Between Pad U900-23(1525mil,2380.905mil) on Top Copper And Pad U900-24(1525mil,2406.496mil) on Top Copper [Top Solder] Mask Sliver [3.874mil]
Waived by Patrick Kanzler at 2021-06-25 16:24:44
Allow minimum solder mask sliver violations.

Minimum Solder Mask Sliver Constraint: (3.874mil < 4mil) Between Pad U900-3(1284.842mil,2355.315mil) on Top Copper And Pad U900-4(1284.842mil,2329.724mil) on Top Copper [Top Solder] Mask Sliver [3.874mil]
Waived by Patrick Kanzler at 2021-06-25 16:24:44
Allow minimum solder mask sliver violations.

Minimum Solder Mask Sliver Constraint: (3.874mil < 4mil) Between Pad U900-4(1284.842mil,2329.724mil) on Top Copper And Pad U900-5(1284.842mil,2304.134mil) on Top Copper [Top Solder] Mask Sliver [3.874mil]
Waived by Patrick Kanzler at 2021-06-25 16:24:44
Allow minimum solder mask sliver violations.

Minimum Solder Mask Sliver Constraint: (3.874mil < 4mil) Between Pad U900-5(1284.842mil,2304.134mil) on Top Copper And Pad U900-6(1284.842mil,2278.543mil) on Top Copper [Top Solder] Mask Sliver [3.874mil]
Waived by Patrick Kanzler at 2021-06-25 16:24:44
Allow minimum solder mask sliver violations.

Minimum Solder Mask Sliver Constraint: (3.874mil < 4mil) Between Pad U900-6(1284.842mil,2278.543mil) on Top Copper And Pad U900-7(1284.842mil,2252.953mil) on Top Copper [Top Solder] Mask Sliver [3.874mil]
Waived by Patrick Kanzler at 2021-06-25 16:24:44
Allow minimum solder mask sliver violations.

Minimum Solder Mask Sliver Constraint: (3.874mil < 4mil) Between Pad U900-7(1284.842mil,2252.953mil) on Top Copper And Pad U900-8(1284.842mil,2227.362mil) on Top Copper [Top Solder] Mask Sliver [3.874mil]
Waived by Patrick Kanzler at 2021-06-25 16:24:44
Allow minimum solder mask sliver violations.

Minimum Solder Mask Sliver Constraint: (3.874mil < 4mil) Between Pad U900-8(1284.842mil,2227.362mil) on Top Copper And Pad U900-9(1284.842mil,2201.772mil) on Top Copper [Top Solder] Mask Sliver [3.874mil]
Waived by Patrick Kanzler at 2021-06-25 16:24:44
Allow minimum solder mask sliver violations.

Back to top
