emiln2002/BMS/slave_v2/Fabrication/erc/slave-14-mc33775.html

Altium

# Electrical Rule Check Report

Date: | | 2024-12-18
Time: | | 10:20:27
Filename: | | C:\Users\schwarz\AppData\Local\TempReleases\Snapshot\2\Fabrication\erc\slave-14-mc33775.html

Class | Document | Message
Warning | digital_io.SchDoc | DIGITAL-IO_1 contains IO Pin and Output Pin objects (Pin U900-5, Pin U921-3).
Warning | mc33775.SchDoc | Global Power-Object VMODULE at 1800mil,8700mil has been reduced to local level by presence of port at 300mil,8600mil
Warning | analog_in.SchDoc | Net A0_1 has no driving source (Pin R201-1, Pin R204-2, Pin U201-16)
Warning | analog_in.SchDoc | Net A0_2 has no driving source (Pin R201-1, Pin R204-2, Pin U201-16)
Warning | analog_in.SchDoc | Net A1_1 has no driving source (Pin R202-1, Pin R205-2, Pin U201-15)
Warning | analog_in.SchDoc | Net A1_2 has no driving source (Pin R202-1, Pin R205-2, Pin U201-15)
Warning | slave-14-mc33775.SchDoc | Net AL_IN._P has no driving source (Pin C616-1, Pin D610-1, Pin D610-2, Pin J305-1, Pin U601-11)
Warning | slave-14-mc33775.SchDoc | Net CT0 has no driving source (Pin C527-2, Pin R513-1, Pin U600-16)
Warning | slave-14-mc33775.SchDoc | Net CT1 has no driving source (Pin C523-2, Pin R511-1, Pin U600-15)
Warning | slave-14-mc33775.SchDoc | Net CT2 has no driving source (Pin C519-2, Pin R509-1, Pin U600-14)
Warning | slave-14-mc33775.SchDoc | Net CT3 has no driving source (Pin C515-2, Pin R507-1, Pin U600-13)
Warning | slave-14-mc33775.SchDoc | Net CT4 has no driving source (Pin C511-2, Pin R505-1, Pin U600-12)
Warning | slave-14-mc33775.SchDoc | Net CT5 has no driving source (Pin C507-2, Pin R503-1, Pin U600-11)
Warning | slave-14-mc33775.SchDoc | Net CT6 has no driving source (Pin C503-2, Pin R501-1, Pin U600-10)
Warning | slave-14-mc33775.SchDoc | Net CT7 has no driving source (Pin C529-2, Pin R514-1, Pin U600-9)
Warning | slave-14-mc33775.SchDoc | Net CT8 has no driving source (Pin C525-2, Pin R512-1, Pin U600-8)
Warning | slave-14-mc33775.SchDoc | Net CT9 has no driving source (Pin C521-2, Pin R510-1, Pin U600-7)
Warning | slave-14-mc33775.SchDoc | Net CT10 has no driving source (Pin C517-2, Pin R508-1, Pin U600-6)
Warning | slave-14-mc33775.SchDoc | Net CT11 has no driving source (Pin C513-2, Pin R506-1, Pin U600-5)
Warning | slave-14-mc33775.SchDoc | Net CT12 has no driving source (Pin C509-2, Pin R504-1, Pin U600-4)
Warning | slave-14-mc33775.SchDoc | Net CT13 has no driving source (Pin C505-2, Pin R502-1, Pin U600-3)
Warning | slave-14-mc33775.SchDoc | Net CT14 has no driving source (Pin C501-2, Pin R500-1, Pin U600-2)
Warning | analog_in.SchDoc | Net D_1 has no driving source (Pin R230-1, Pin R232-1, Pin U201-8, Pin U202-3)
Warning | analog_in.SchDoc | Net D_2 has no driving source (Pin R230-1, Pin R232-1, Pin U201-8, Pin U202-3)
Warning | dcdc-converter.SchDoc | Net Enable_DCDC has no driving source (Pin enable_DCDC-1, Pin R807-2, Pin R810-1, Pin U800-3)
Warning | ldo.SchDoc | Net Enable_LDO has no driving source (Pin R851-1, Pin U850-5, Pin U851-5)
Warning | dcdc-converter.SchDoc | Net Feedback has no driving source (Pin C809-1, Pin R806-1, Pin R808-2, Pin U800-5)
Warning | mc33775.SchDoc | Net Imon_VDDC has no driving source (Pin Q600-3, Pin R618-2, Pin U600-41)
Warning | dcdc-converter.SchDoc | Net NetC805_1 has no driving source (Pin C805-1, Pin U800-7)
Warning | digital_io.SchDoc | Net PE_NRESET has no driving source (Pin R916-2, Pin U900-3)
Warning | dcdc-converter.SchDoc | Net Ron has no driving source (Pin R809-2, Pin U800-4)
Warning | slave-14-mc33775.SchDoc | Net VMODULE has no driving source (Pin C531-2, Pin R515-1, Pin U600-17, Pin Vmodule-1)
Warning | slave-14-mc33775.SchDoc | Nets Bus Slice T-SENSOR_[8..15] has multiple names (Net Label T-SENSOR_[0..7]_2, Net Label T-SENSOR_[8..15])
Warning | slave-14-mc33775.SchDoc | Nets Element[0]: T-SENSOR_8 has multiple names (Net Label T-SENSOR_0_2, Net Label T-SENSOR_0_2 (Inferred), Net Label T-SENSOR_8, Net Label T-SENSOR_8 (Inferred))
Warning | slave-14-mc33775.SchDoc | Nets Element[1]: CIN1 has multiple names (Net Label BAL.CB_COM1 (2), Net Label CB_COM1 (3), Net Label CIN1 (3), Net Label CIN1 (Inferred) (4))
Warning | slave-14-mc33775.SchDoc | Nets Element[1]: T-SENSOR_9 has multiple names (Net Label T-SENSOR_1_2, Net Label T-SENSOR_1_2 (Inferred), Net Label T-SENSOR_9, Net Label T-SENSOR_9 (Inferred))
Warning | slave-14-mc33775.SchDoc | Nets Element[2]: T-SENSOR_10 has multiple names (Net Label T-SENSOR_2_2, Net Label T-SENSOR_2_2 (Inferred), Net Label T-SENSOR_10, Net Label T-SENSOR_10 (Inferred))
Warning | slave-14-mc33775.SchDoc | Nets Element[3]: CIN3 has multiple names (Net Label BAL.CB_COM3 (2), Net Label CB_COM3 (3), Net Label CIN3 (3), Net Label CIN3 (Inferred) (4))
Warning | slave-14-mc33775.SchDoc | Nets Element[3]: T-SENSOR_11 has multiple names (Net Label T-SENSOR_3_2, Net Label T-SENSOR_3_2 (Inferred), Net Label T-SENSOR_11, Net Label T-SENSOR_11 (Inferred))
Warning | slave-14-mc33775.SchDoc | Nets Element[4]: T-SENSOR_12 has multiple names (Net Label T-SENSOR_4_2, Net Label T-SENSOR_4_2 (Inferred), Net Label T-SENSOR_12, Net Label T-SENSOR_12 (Inferred))
Warning | slave-14-mc33775.SchDoc | Nets Element[5]: CIN5 has multiple names (Net Label BAL.CB_COM5 (2), Net Label CB_COM5 (3), Net Label CIN5 (4), Net Label CIN5 (Inferred) (4))
Warning | slave-14-mc33775.SchDoc | Nets Element[5]: T-SENSOR_13 has multiple names (Net Label T-SENSOR_5_2, Net Label T-SENSOR_5_2 (Inferred), Net Label T-SENSOR_13, Net Label T-SENSOR_13 (Inferred))
Warning | slave-14-mc33775.SchDoc | Nets Element[6]: T-SENSOR_14 has multiple names (Net Label T-SENSOR_6_2, Net Label T-SENSOR_6_2 (Inferred), Net Label T-SENSOR_14, Net Label T-SENSOR_14 (Inferred))
Warning | slave-14-mc33775.SchDoc | Nets Element[7]: CIN7 has multiple names (Net Label BAL.CB_COM7 (2), Net Label CB_COM7 (3), Net Label CIN7 (4), Net Label CIN7 (Inferred) (4))
Warning | slave-14-mc33775.SchDoc | Nets Element[7]: T-SENSOR_15 has multiple names (Net Label T-SENSOR_7_2, Net Label T-SENSOR_7_2 (Inferred), Net Label T-SENSOR_15, Net Label T-SENSOR_15 (Inferred))
Warning | slave-14-mc33775.SchDoc | Nets Element[9]: CIN9 has multiple names (Net Label BAL.CB_COM9 (2), Net Label CB_COM9 (3), Net Label CIN9 (4), Net Label CIN9 (Inferred) (4))
Warning | slave-14-mc33775.SchDoc | Nets Element[11]: CIN11 has multiple names (Net Label BAL.CB_COM11 (2), Net Label CB_COM11 (3), Net Label CIN11 (4), Net Label CIN11 (Inferred) (4))
Warning | slave-14-mc33775.SchDoc | Nets Element[13]: CIN13 has multiple names (Net Label BAL.CB_COM13 (2), Net Label CB_COM13 (4), Net Label CIN13 (4), Net Label CIN13 (Inferred) (4))
Warning | slave-14-mc33775.SchDoc | Nets Wire BAL.CB_HI2 has multiple names (Net Label BAL.CB_HI2 (2), Net Label CB_HI2 (3))
Warning | slave-14-mc33775.SchDoc | Nets Wire BAL.CB_HI4 has multiple names (Net Label BAL.CB_HI4 (2), Net Label CB_HI4 (3))
Warning | slave-14-mc33775.SchDoc | Nets Wire BAL.CB_HI6 has multiple names (Net Label BAL.CB_HI6 (2), Net Label CB_HI6 (3))
Warning | slave-14-mc33775.SchDoc | Nets Wire BAL.CB_HI8 has multiple names (Net Label BAL.CB_HI8 (2), Net Label CB_HI8 (3))
Warning | slave-14-mc33775.SchDoc | Nets Wire BAL.CB_HI10 has multiple names (Net Label BAL.CB_HI10 (2), Net Label CB_HI10 (3))
Warning | slave-14-mc33775.SchDoc | Nets Wire BAL.CB_HI12 has multiple names (Net Label BAL.CB_HI12 (2), Net Label CB_HI12 (3))
Warning | slave-14-mc33775.SchDoc | Nets Wire BAL.CB_HI14 has multiple names (Net Label BAL.CB_HI14 (2), Net Label CB_HI14 (3))
Warning | slave-14-mc33775.SchDoc | Nets Wire BAL.CB_LO0 has multiple names (Net Label BAL.CB_LO0 (2), Net Label CB_LO0 (3))
Warning | slave-14-mc33775.SchDoc | Nets Wire BAL.CB_LO2 has multiple names (Net Label BAL.CB_LO2 (2), Net Label CB_LO2 (3))
Warning | slave-14-mc33775.SchDoc | Nets Wire BAL.CB_LO4 has multiple names (Net Label BAL.CB_LO4 (2), Net Label CB_LO4 (3))
Warning | slave-14-mc33775.SchDoc | Nets Wire BAL.CB_LO6 has multiple names (Net Label BAL.CB_LO6 (2), Net Label CB_LO6 (3))
Warning | slave-14-mc33775.SchDoc | Nets Wire BAL.CB_LO8 has multiple names (Net Label BAL.CB_LO8 (2), Net Label CB_LO8 (3))
Warning | slave-14-mc33775.SchDoc | Nets Wire BAL.CB_LO10 has multiple names (Net Label BAL.CB_LO10 (2), Net Label CB_LO10 (3))
Warning | slave-14-mc33775.SchDoc | Nets Wire BAL.CB_LO12 has multiple names (Net Label BAL.CB_LO12 (2), Net Label CB_LO12 (3))
Warning | slave-14-mc33775.SchDoc | Nets Wire GPIO2_ext has multiple names (Net Label GPIO2_ext (4), Net Label GPIO_ext.GPIO2_ext (2))
Warning | slave-14-mc33775.SchDoc | Nets Wire GPIO3_ext has multiple names (Net Label GPIO3_ext (4), Net Label GPIO_ext.GPIO3_ext (2))
Warning | slave-14-mc33775.SchDoc | Nets Wire GPIO6_ext has multiple names (Net Label GPIO6_ext (4), Net Label GPIO_ext.GPIO6_ext (2))
Warning | slave-14-mc33775.SchDoc | Nets Wire GPIO7_ext has multiple names (Net Label GPIO7_ext (4), Net Label GPIO_ext.GPIO7_ext (2))
Warning | slave-14-mc33775.SchDoc | Nets Wire I2C.SCL has multiple names (Net Label I2C.SCL (5), Net Label I2C.SCL_1, Net Label I2C.SCL_2, Net Label SCL (11), Net Label SCL_1, Net Label SCL_2)
Warning | slave-14-mc33775.SchDoc | Nets Wire I2C.SDA has multiple names (Net Label I2C.SDA (5), Net Label I2C.SDA_1, Net Label I2C.SDA_2, Net Label SDA (11), Net Label SDA_1, Net Label SDA_2)
Warning | analog_in.SchDoc | Nets Wire VDDC has multiple names (Net Label Vin (2), Power Object VDDC (12))
Warning | sensors.SchDoc | VDDIO contains IO Pin and Power Pin objects (Pin U922-5, Pin IC920-1, Pin U201-13, Pin U201-13, Pin U202-5, Pin U202-5, Pin U400-8, Pin U600-39, Pin U900-24, Pin U920-6, Pin U920-8, Pin U921-5, Pin U922-6).
Warning | mc33775.SchDoc | VMODULE contains Input Pin and Unspecified Port objects (Pin U600-17, Port Vmodule).

Back to top
