emiln2002/BMS/interface-nxp-mc33664-v1.0.2/Sources/CHANGELOG.rst

.. include:: ./../../../macros.txt
.. include:: ./../../../units.txt

.. _CHANGELOG_FOR_INTERFACE_MC33664:

Changelog for Interface MC33664
===============================

.. _CHANGELOG_FOR_INTERFACE_MC33664_V1_0_2:

v1.0.2
------

- added detailed license description to hardware release

.. _CHANGELOG_FOR_INTERFACE_MC33664_V1_0_1:

v1.0.1
------

- connected DATA_RX of TPL transceivers to MCU SIMO instead of SOMI (MCU acts as slave)
- adjusted mounting holes to fit SMT spacers

.. _CHANGELOG_FOR_INTERFACE_MC33664_V1_0_0:

v1.0.0
------

- initial release
