emiln2002/BMS/slave_v2/Sources/CHANGELOG.rst

.. include:: ./../../../macros.txt
.. include:: ./../../../units.txt

.. _CHANGELOG_FOR_SLAVE_MC33775:

Changelog for Slave MC33775
=============================

.. _CHANGELOG_FOR_SLAVE_MC33775_V1_0_2:

v1.0.2
------

- design variants updated and variant "foxBMS_14cell_BMS-Slave_reduced" added
- option to bypass supply diode with 0R added
- cleanup and reduction of design variants
- adding design variants readme

.. _CHANGELOG_FOR_SLAVE_MC33775_V1_0_1:

v1.0.1
------

- project settings update

.. _CHANGELOG_FOR_SLAVE_MC33775_V1_0_0:

v1.0.0
------

- initial release
