emiln2002/BMS/Slave-18-cell/Assembly automotive/pdf/placement-plan.PDF

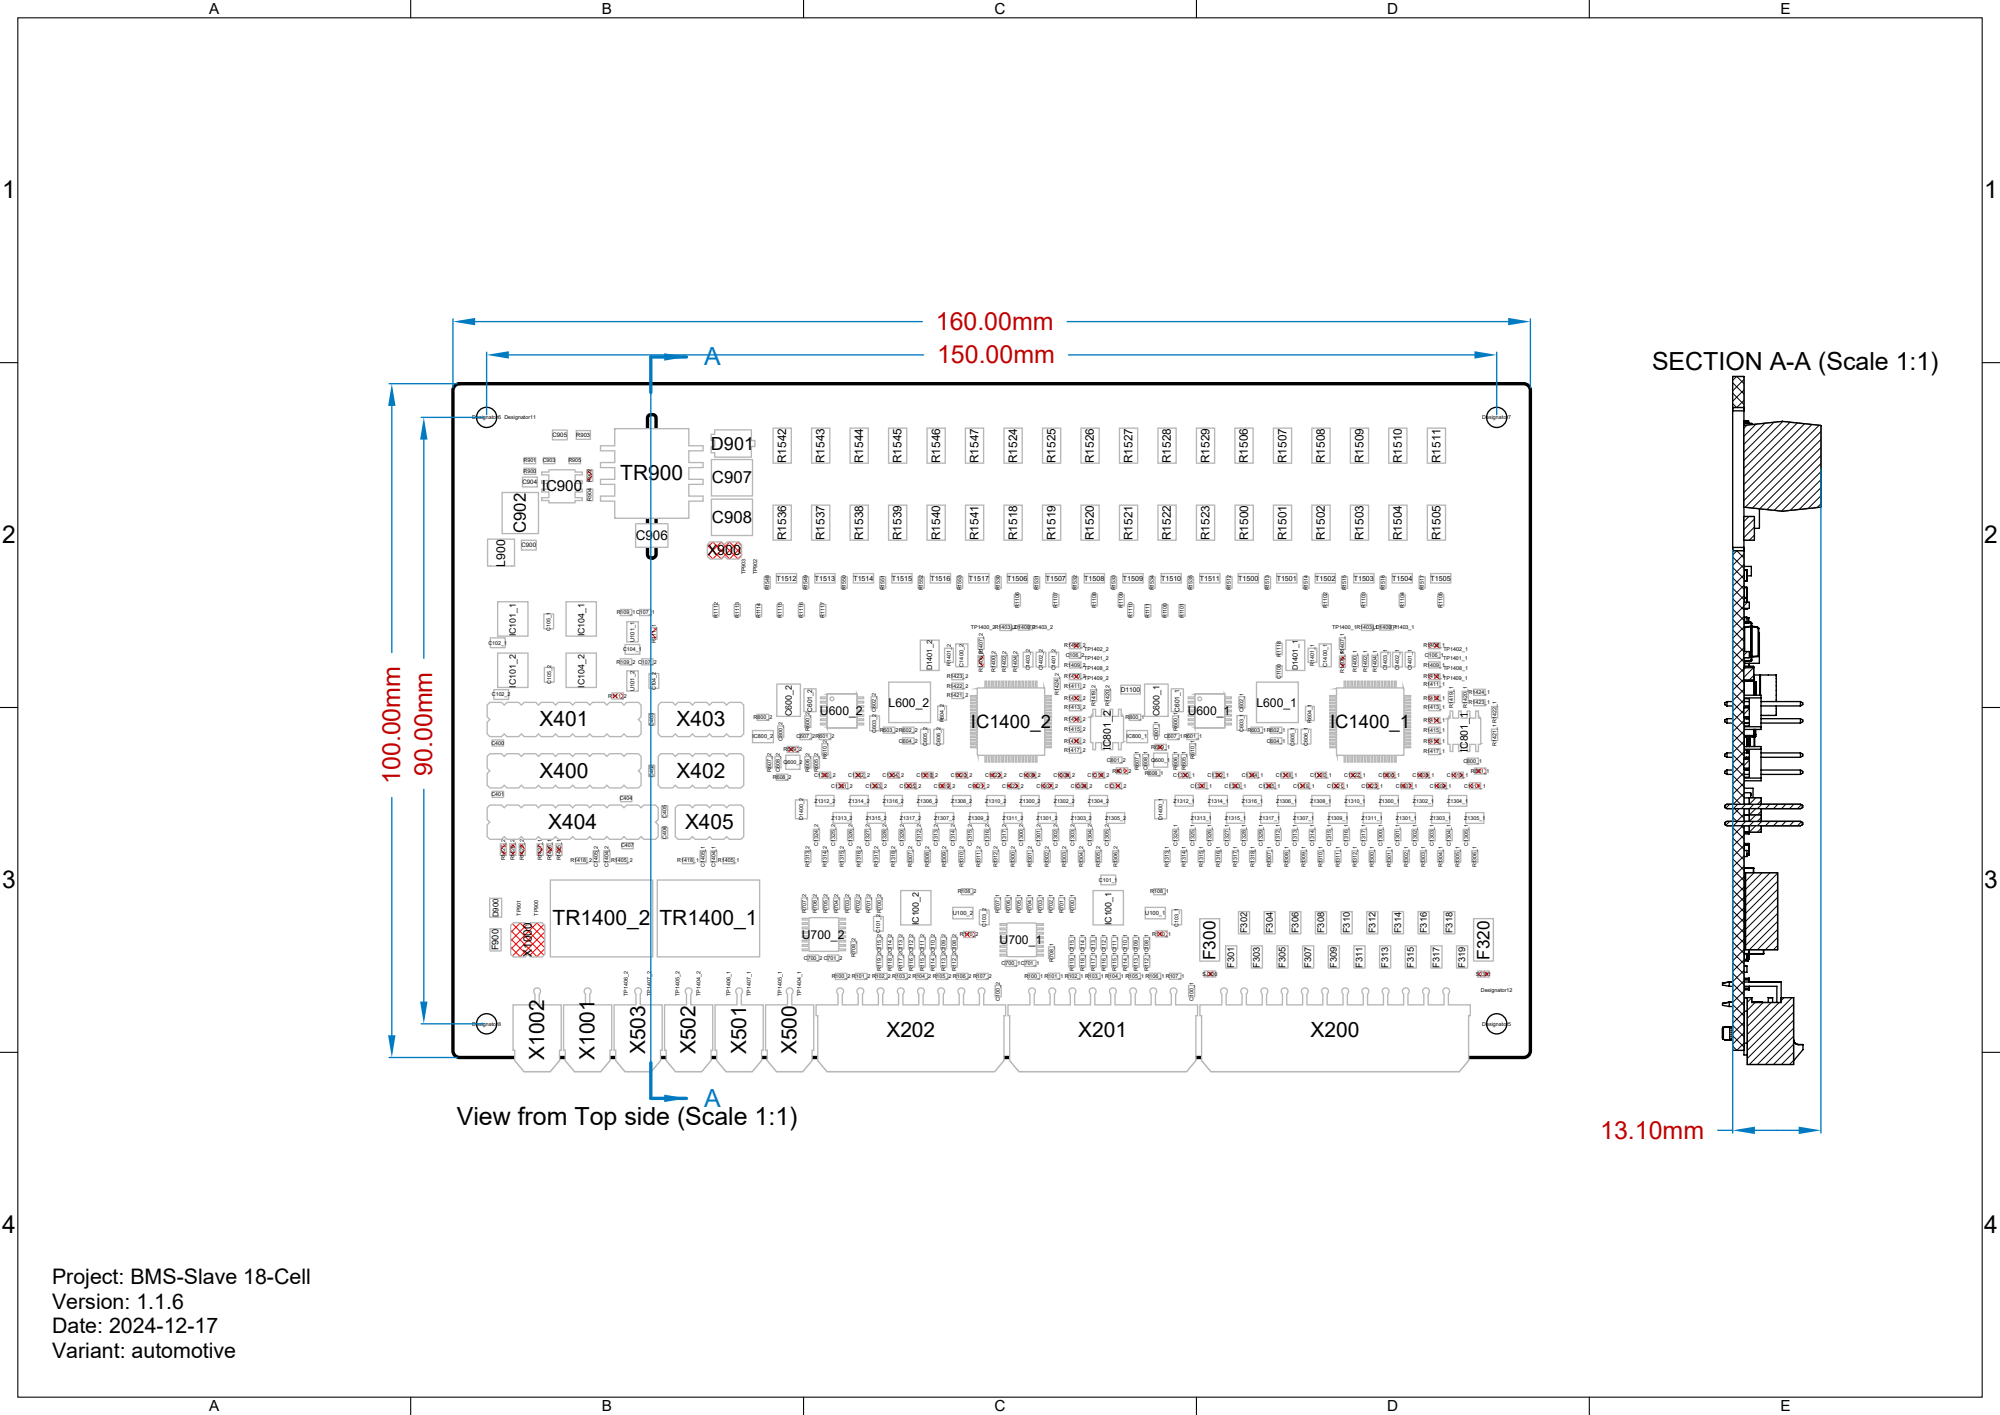
[picture p7: page 1]

View from Top side (Scale 1:1)

Project: BMS-Slave 18-Cell
Version: 1.1.6
Date: 2024-12-17
Variant: automotive

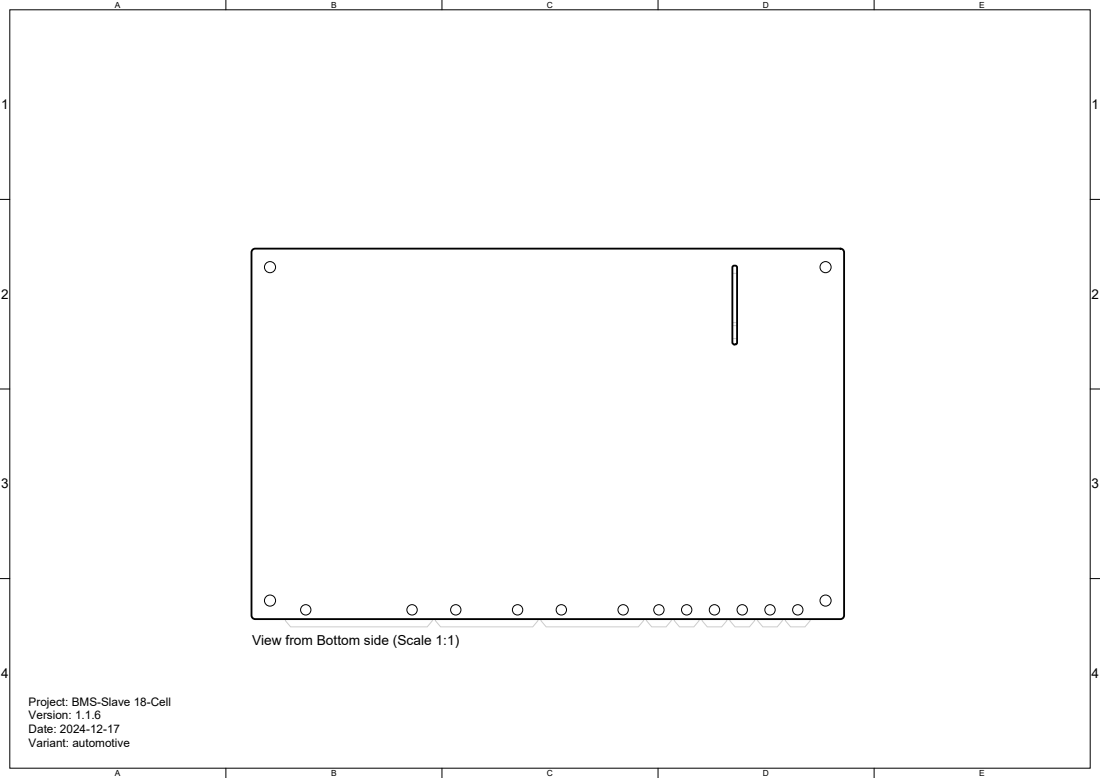
[picture p8: page 2]

View from Bottom side (Scale 1:1)

Project: BMS-Slave 18-Cell
Version: 1.1.6
Date: 2024-12-17
Variant: automotive
