emiln2002/BMS/Slave-18-cell/Assembly automotive/pdf/schematics.PDF

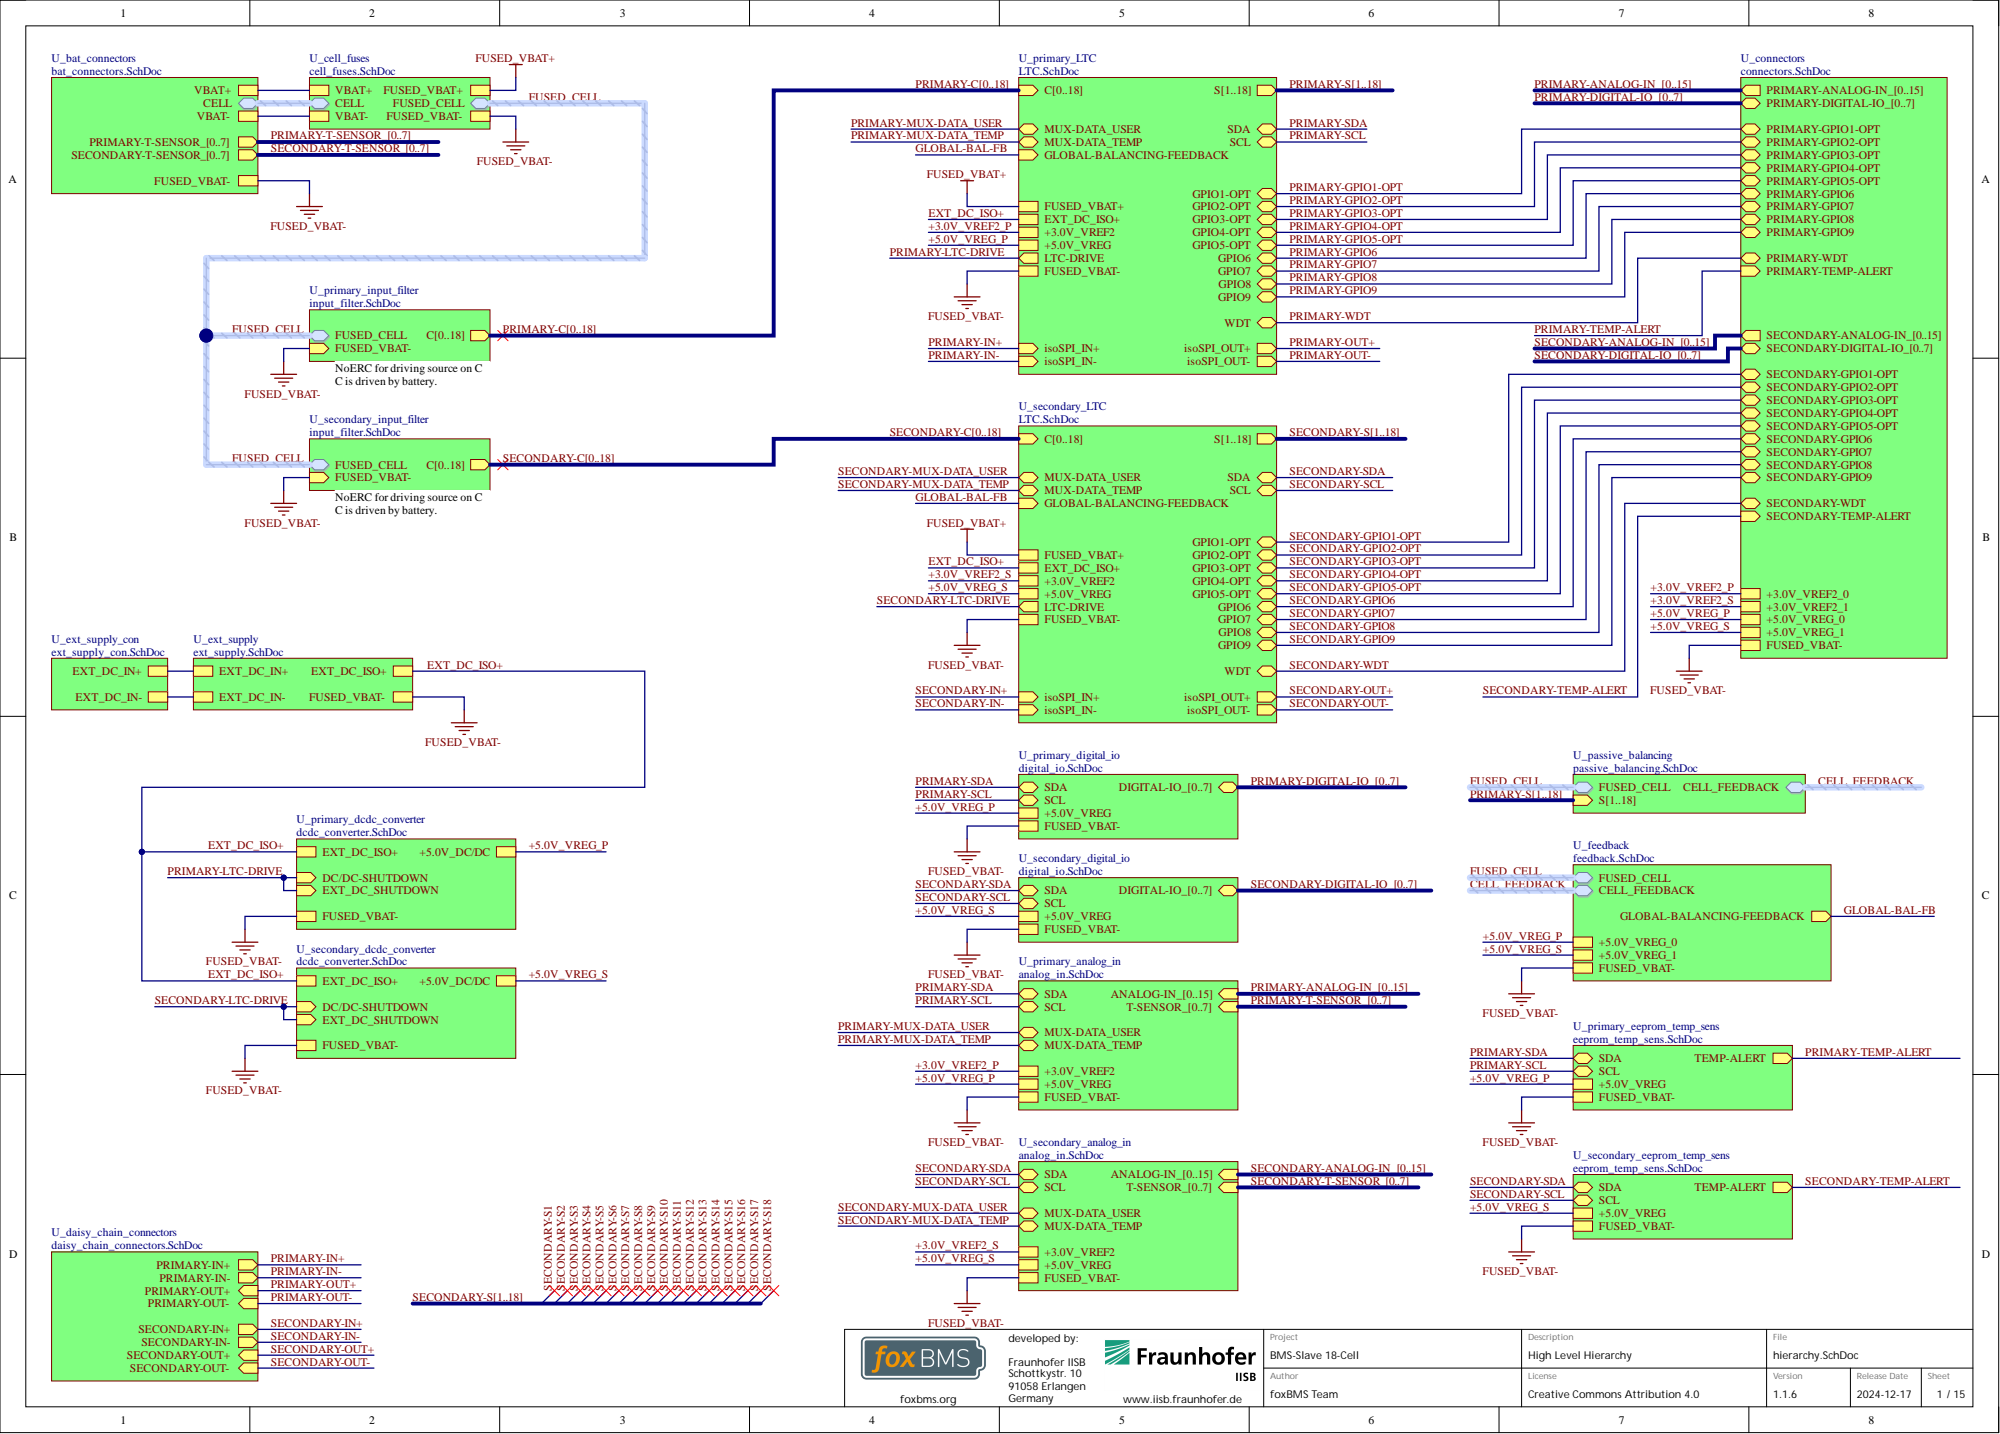
[picture p9: page 1]

PRIMARY-WDT

FUSED_VBAT-
NoERC for driving source on C
C is driven by battery.

PRIMARY-TEMP-ALERT

C[0..18] S[1..18] MUX-DATA_USER SDA MUX-DATA_TEMP SCL GLOBAL-BALANCING-FEEDBACK GPIO1-OPT LTC-DRIVE GPIO6 GPIO8 GPIO9 WDT isoSPI_IN+ isoSPI_OUT+ isoSPI_IN-isoSPI_OUT- | SECONDARY-S[1..18]

FUSED_CELL C[0..18] FUSED_VBAT- | SECONDARY-C[0..18]

SECONDARY-GPIO2-OPT
SECONDARY-GPIO3-OPT
SECONDARY-GPIO4-OPT
SECONDARY-GPIO5-OPT | +3.0V_VREF2_P
SECONDARY-GPIO6 | +3.0V_VREF2_S
SECONDARY-GPIO7 | +5.0V_VREG_P
SECONDARY-GPIO8 | +5.0V_VREG_S
SECONDARY-GPIO9

SECONDARY-WDT

SECONDARY-TEMP-ALERT FUSED_VBAT-

MUX-DATA_USER
PRIMARY-TEMP-ALERT MUX-DATA_TEMP

www.iisb.fraunhofer.de

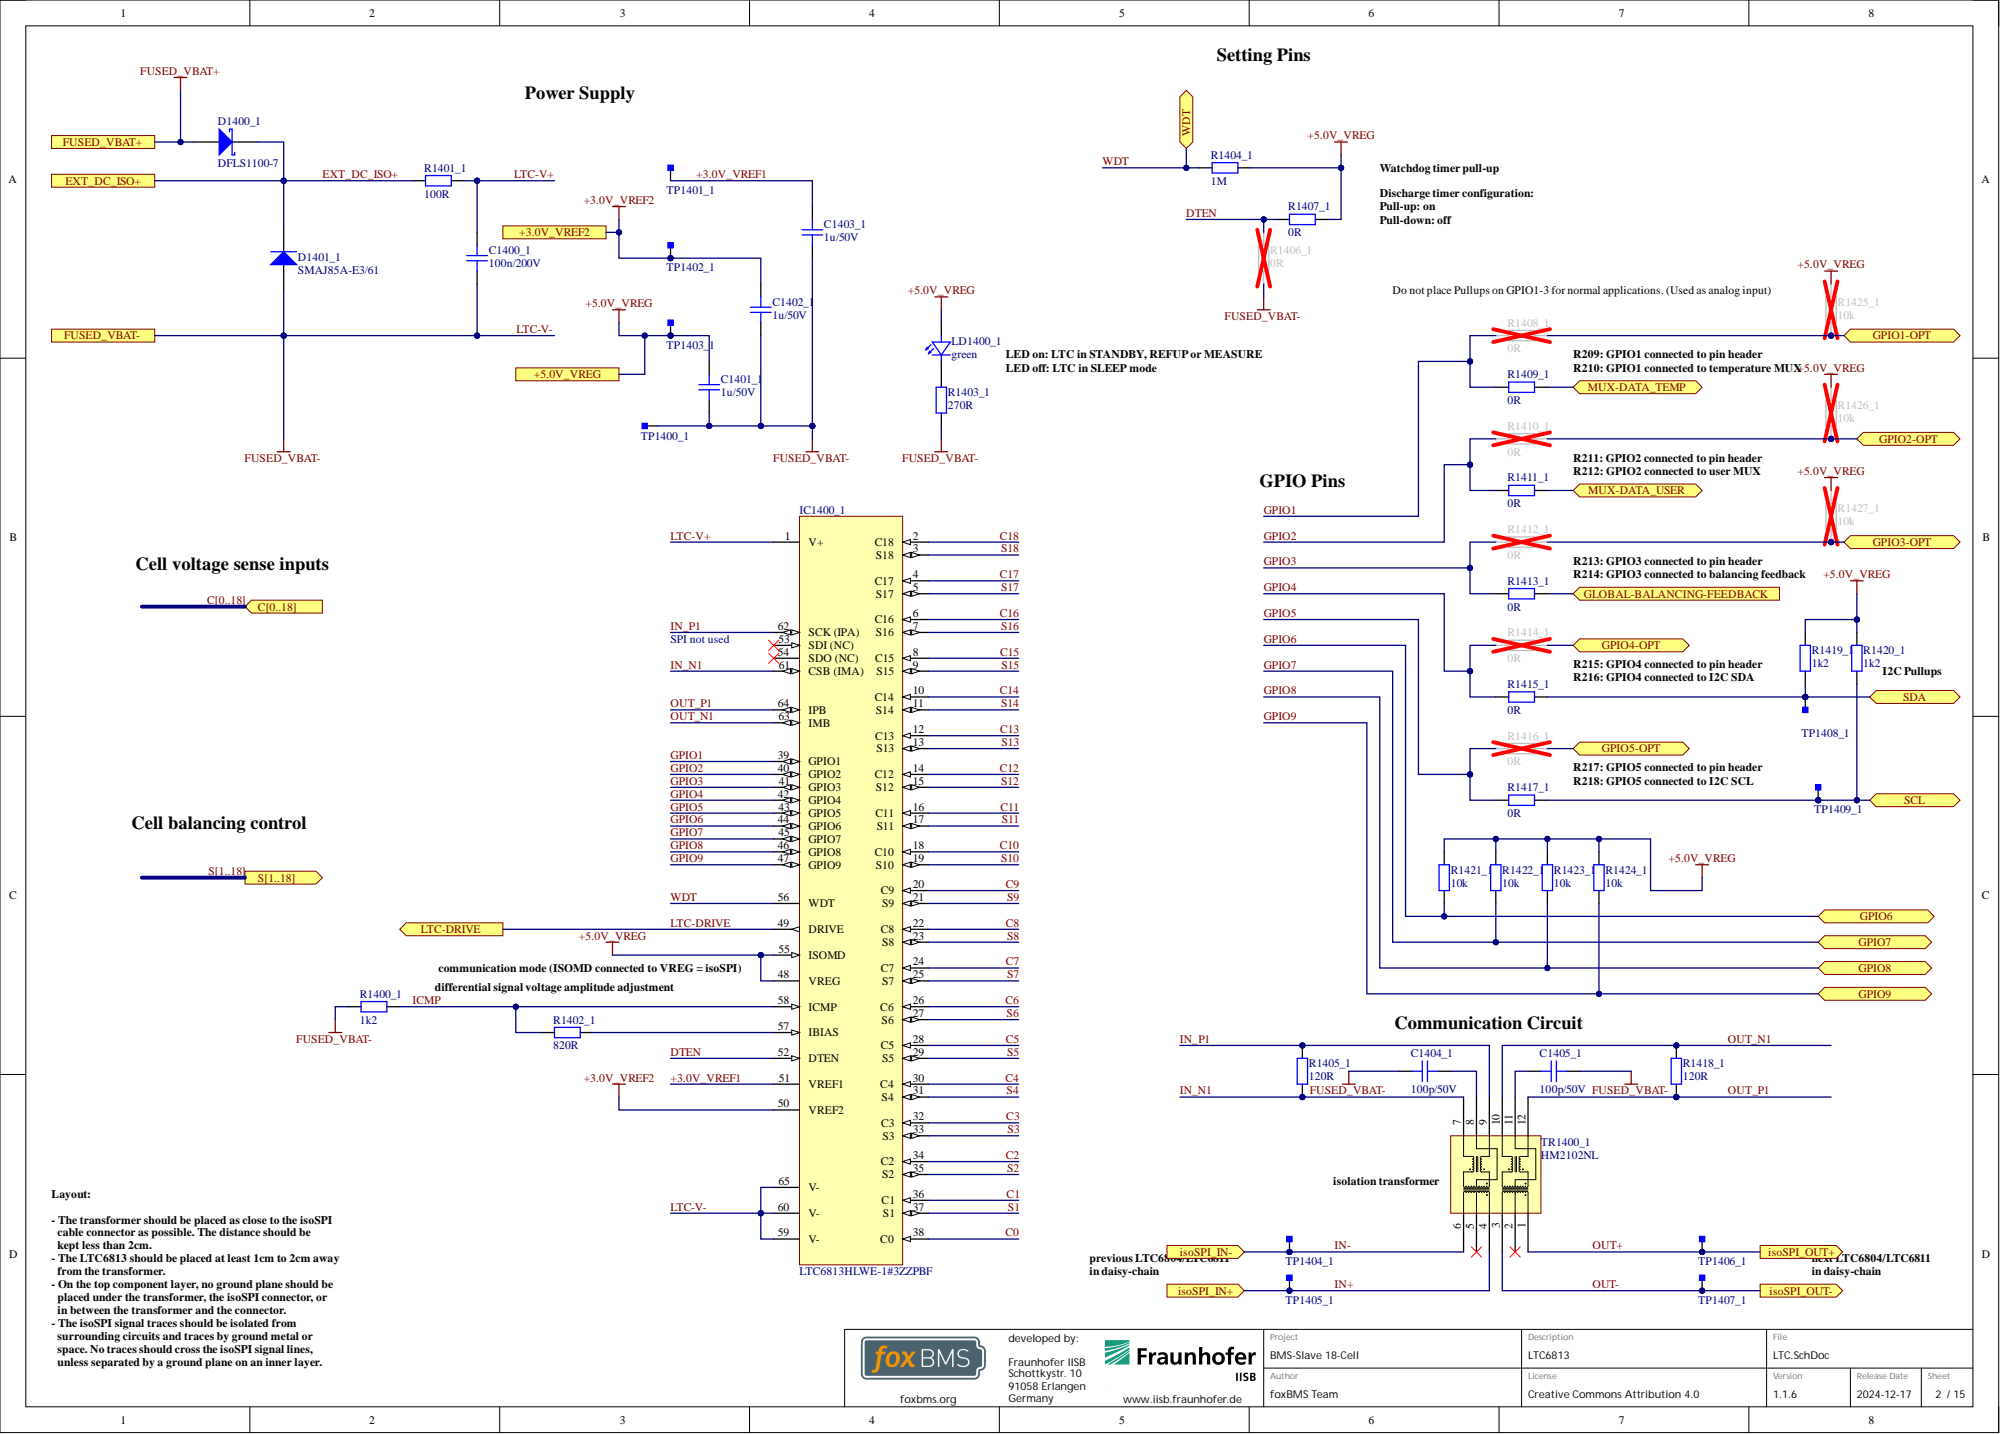
[picture p10: page 2]

Watchdog timer pull-up

Do not place Pullups on GPIO1-3 for normal applications. (Used as analog input)

LED on: LTC in STANDBY, REFUP or MEASURE
LED off: LTC in SLEEP mode

R209: GPIO1 connected to pin header
R210: GPIO1 connected to temperature MUX
MUX-DATA_TEMP

R211: GPIO2 connected to pin header
R212: GPIO2 connected to user MUX
MUX-DATA_USER

Cell voltage sense inputs

R213: GPIO3 connected to pin header
R214: GPIO3 connected to balancing feedback
GLOBAL-BALANCING-FEEDBACK

GPIO4-OPT
R215: GPIO4 connected to pin header
R216: GPIO4 connected to I2C SDA

GPIO5-OPT
R217: GPIO5 connected to pin header
R218: GPIO5 connected to I2C SCL

ISOMD 55

communication mode (ISOMD connected to VREG = isoSPI)
differential signal voltage amplitude adjustment
ICMP

VREG 48

- The transformer should be placed as close to the isoSPI
cable connector as possible. The distance should be
kept less than 2cm.
- The LTC6813 should be placed at least 1cm to 2cm away
from the transformer.
- On the top component layer, no ground plane should be
placed under the transformer, the isoSPI connector, or
in between the transformer and the connector.
- The isoSPI signal traces should be isolated from
surrounding circuits and traces by ground metal or
space. No tracesshould cross the isoSPI signal lines,
unless separated by a ground plane on an inner layer.

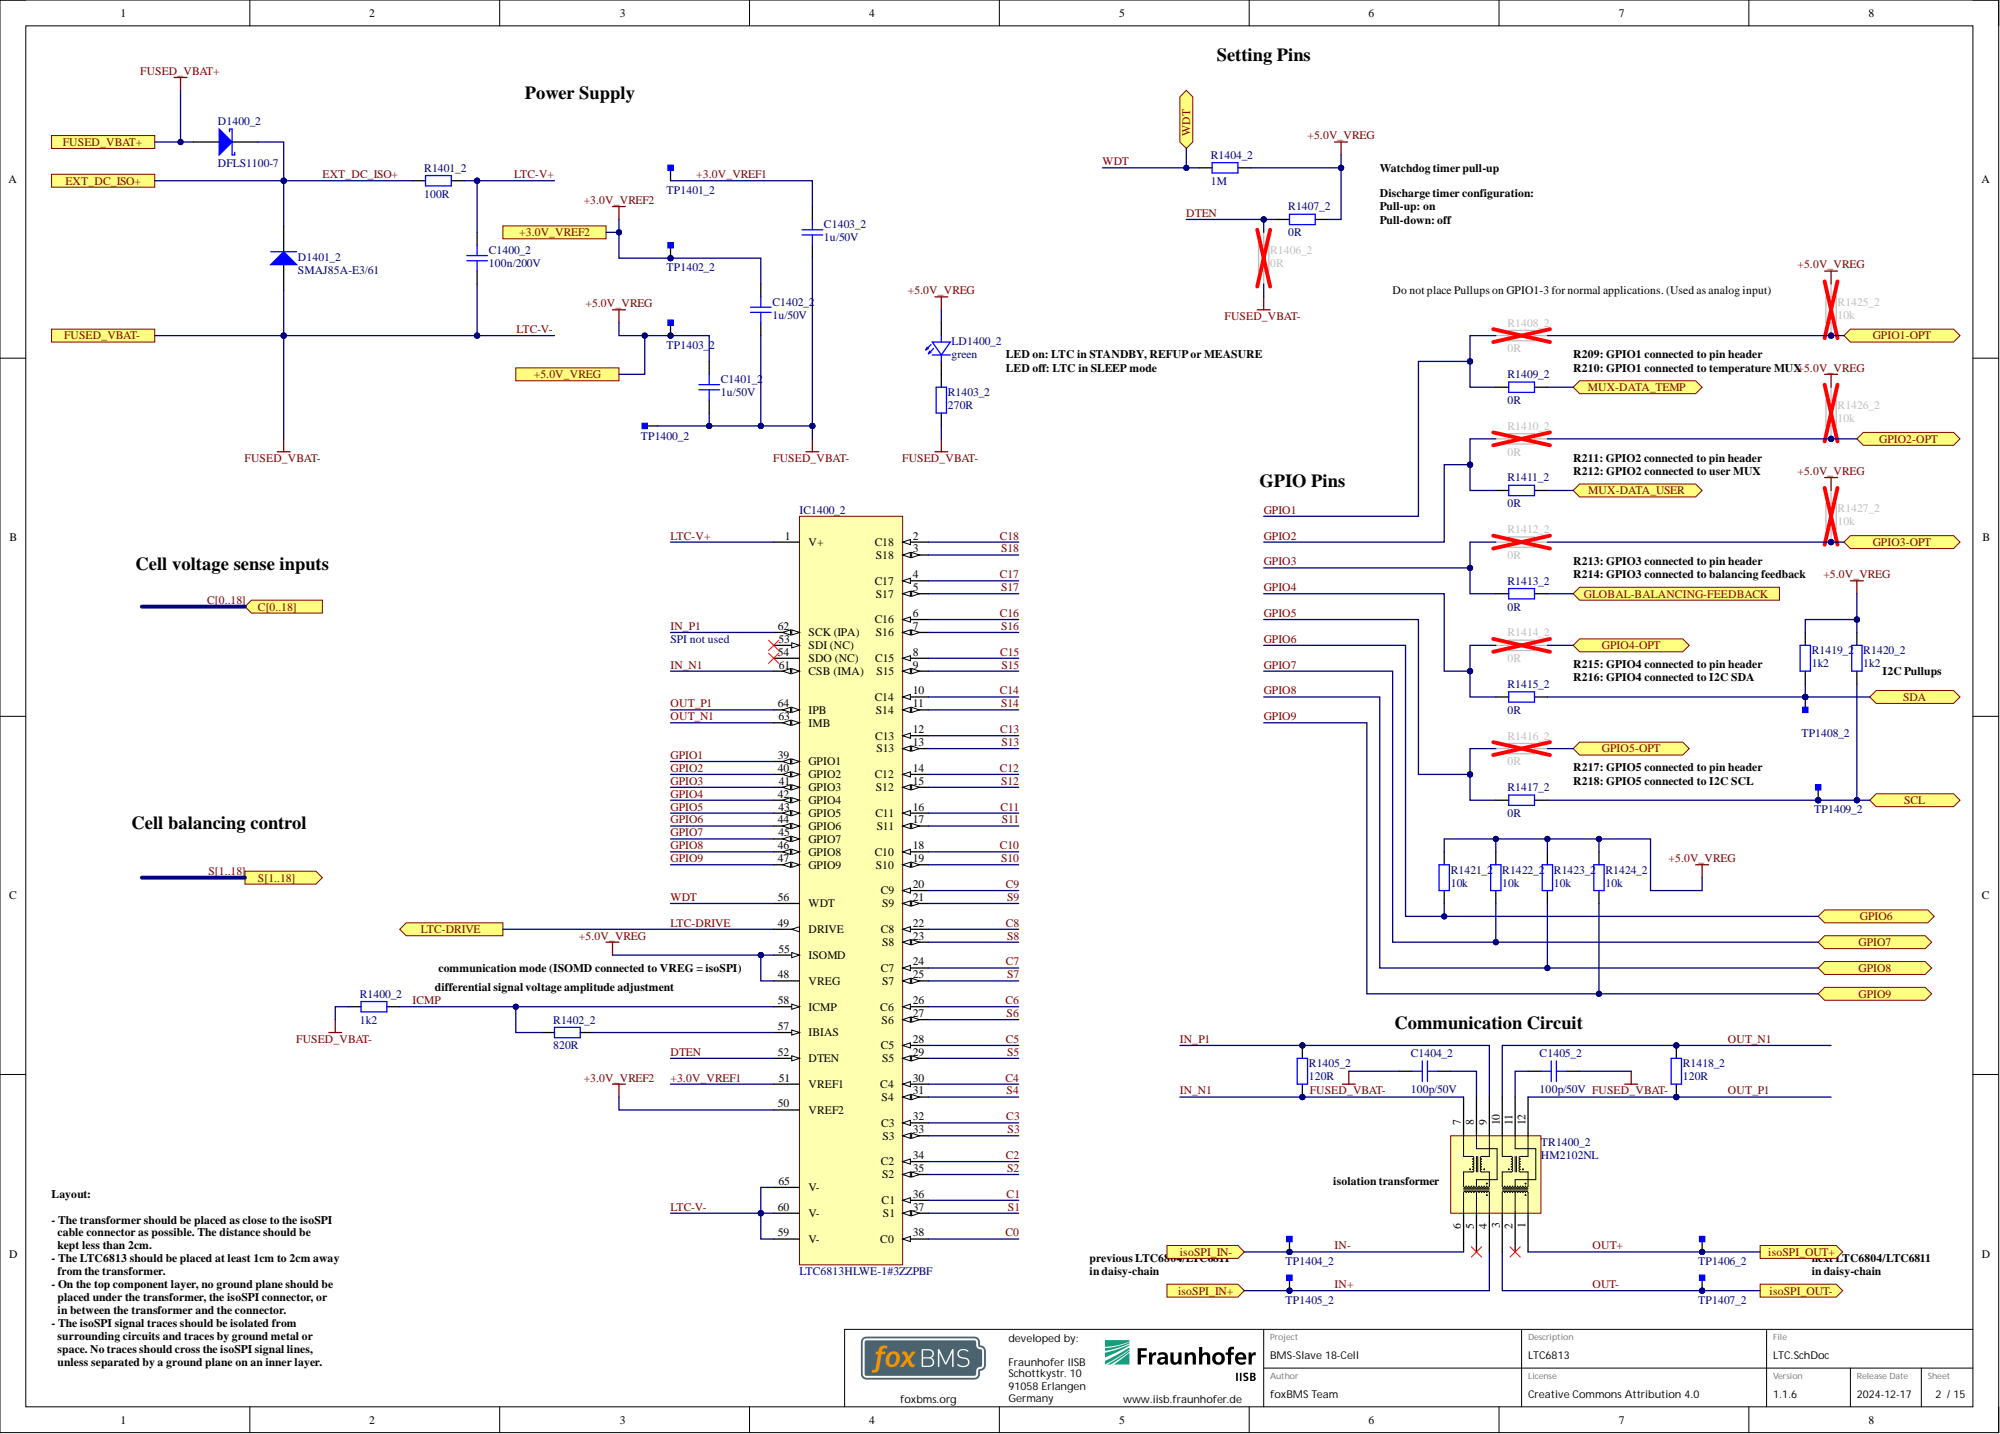
[picture p11: page 3]

Watchdog timer pull-up

Do not place Pullups on GPIO1-3 for normal applications. (Used as analog input)

LED on: LTC in STANDBY, REFUP or MEASURE
LED off: LTC in SLEEP mode

R209: GPIO1 connected to pin header
R210: GPIO1 connected to temperature MUX
MUX-DATA_TEMP

R211: GPIO2 connected to pin header
R212: GPIO2 connected to user MUX
MUX-DATA_USER

Cell voltage sense inputs

R213: GPIO3 connected to pin header
R214: GPIO3 connected to balancing feedback
GLOBAL-BALANCING-FEEDBACK

GPIO4-OPT
R215: GPIO4 connected to pin header
R216: GPIO4 connected to I2C SDA

GPIO5-OPT
R217: GPIO5 connected to pin header
R218: GPIO5 connected to I2C SCL

ISOMD 55

communication mode (ISOMD connected to VREG = isoSPI)
differential signal voltage amplitude adjustment
ICMP

VREG 48

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

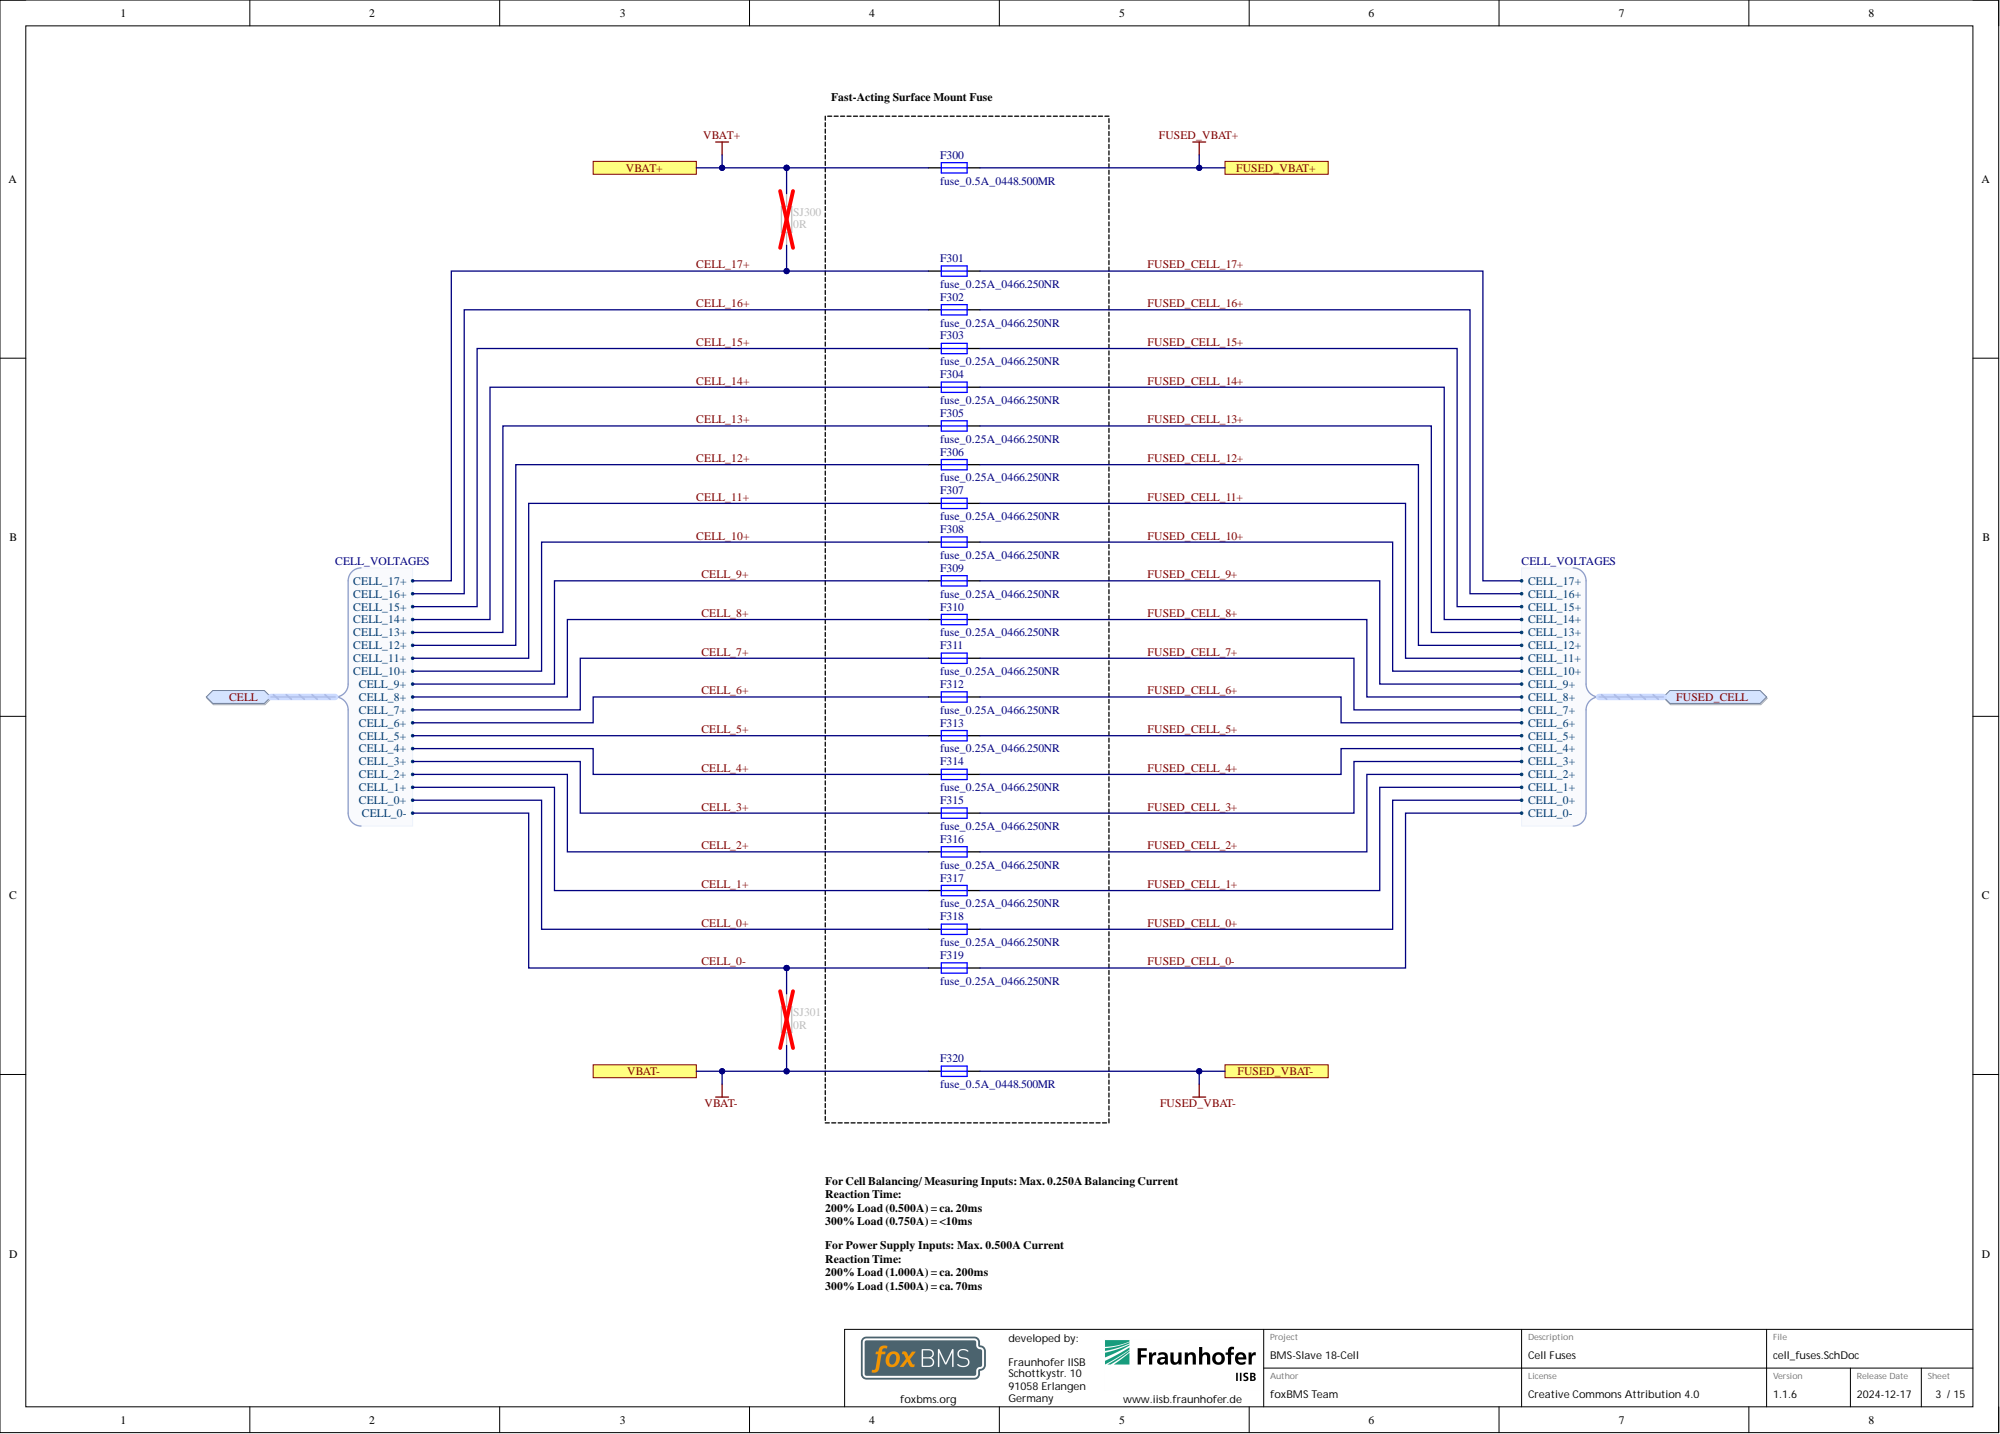
[picture p12: page 4]

CE L L_ 1 6 + | 0.2 | 5 A _ 0 4 6 6 . 2 5 0 N R FUSE D _CE L L_ 1 6 +

CE L L_ 1 5 + | fu se_ 0.2 F3 0 3 | 5 A _ 0 4 6 6 . 2 5 0 N R FUSE D _CE L L_ 1 5 +

CE L L_ 1 4 + | 0.2 | 5 A _ 0 4 6 6 . 2 5 0 N R FUSE D _CE L L_ 1 4 +

CE L L_ 1 3 + | 0.2 | 5 A _ 0 4 6 6 . 2 5 0 N R FUSE D _CE L L_ 1 3 +

CE L L_ 1 2 + | 0.2 | 5 A _ 0 4 6 6 . 2 5 0 N R FUSE D _CE L L_ 1 2 +

CE L L_ 1 1 + | 0.2 | 5 A _ 0 4 6 6 . 2 5 0 N R FUSE D _CE L L_ 1 1 +

CE L L_ 1 0 + | 0.2 | 5 A _ 0 4 6 6 . 2 5 0 N R FUSE D _CE L L_ 1 0 +

E S CE L L_ 9 + | 0.2 | 5 A _ 0 4 6 6 . 2 5 0 N R FUSE D _CE L L_ 9 +

CE L L_ 8 + | | FUSE D _CE L L_ 8 +

CE L L_ 7 + | | FUSE D _CE L L_ 7 +

CE L L_ 6 + | | FUSE D _CE L L_ 6 +

CE L L_ 2 + | | 0.2 | 5 A _ 0 4 6 6 . 2 5 0 N R FUSE D _CE L L_ 2 +

CE L L_ 1 + | | 0.2 | 5 A _ 0 4 6 6 . 2 5 0 N R FUSE D _CE L L_ 1 +

CE L L_ 0 + | | 0.2 | 5 A _ 0 4 6 6 . 2 5 0 N R FUSE D _CE L L_ 0 +

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

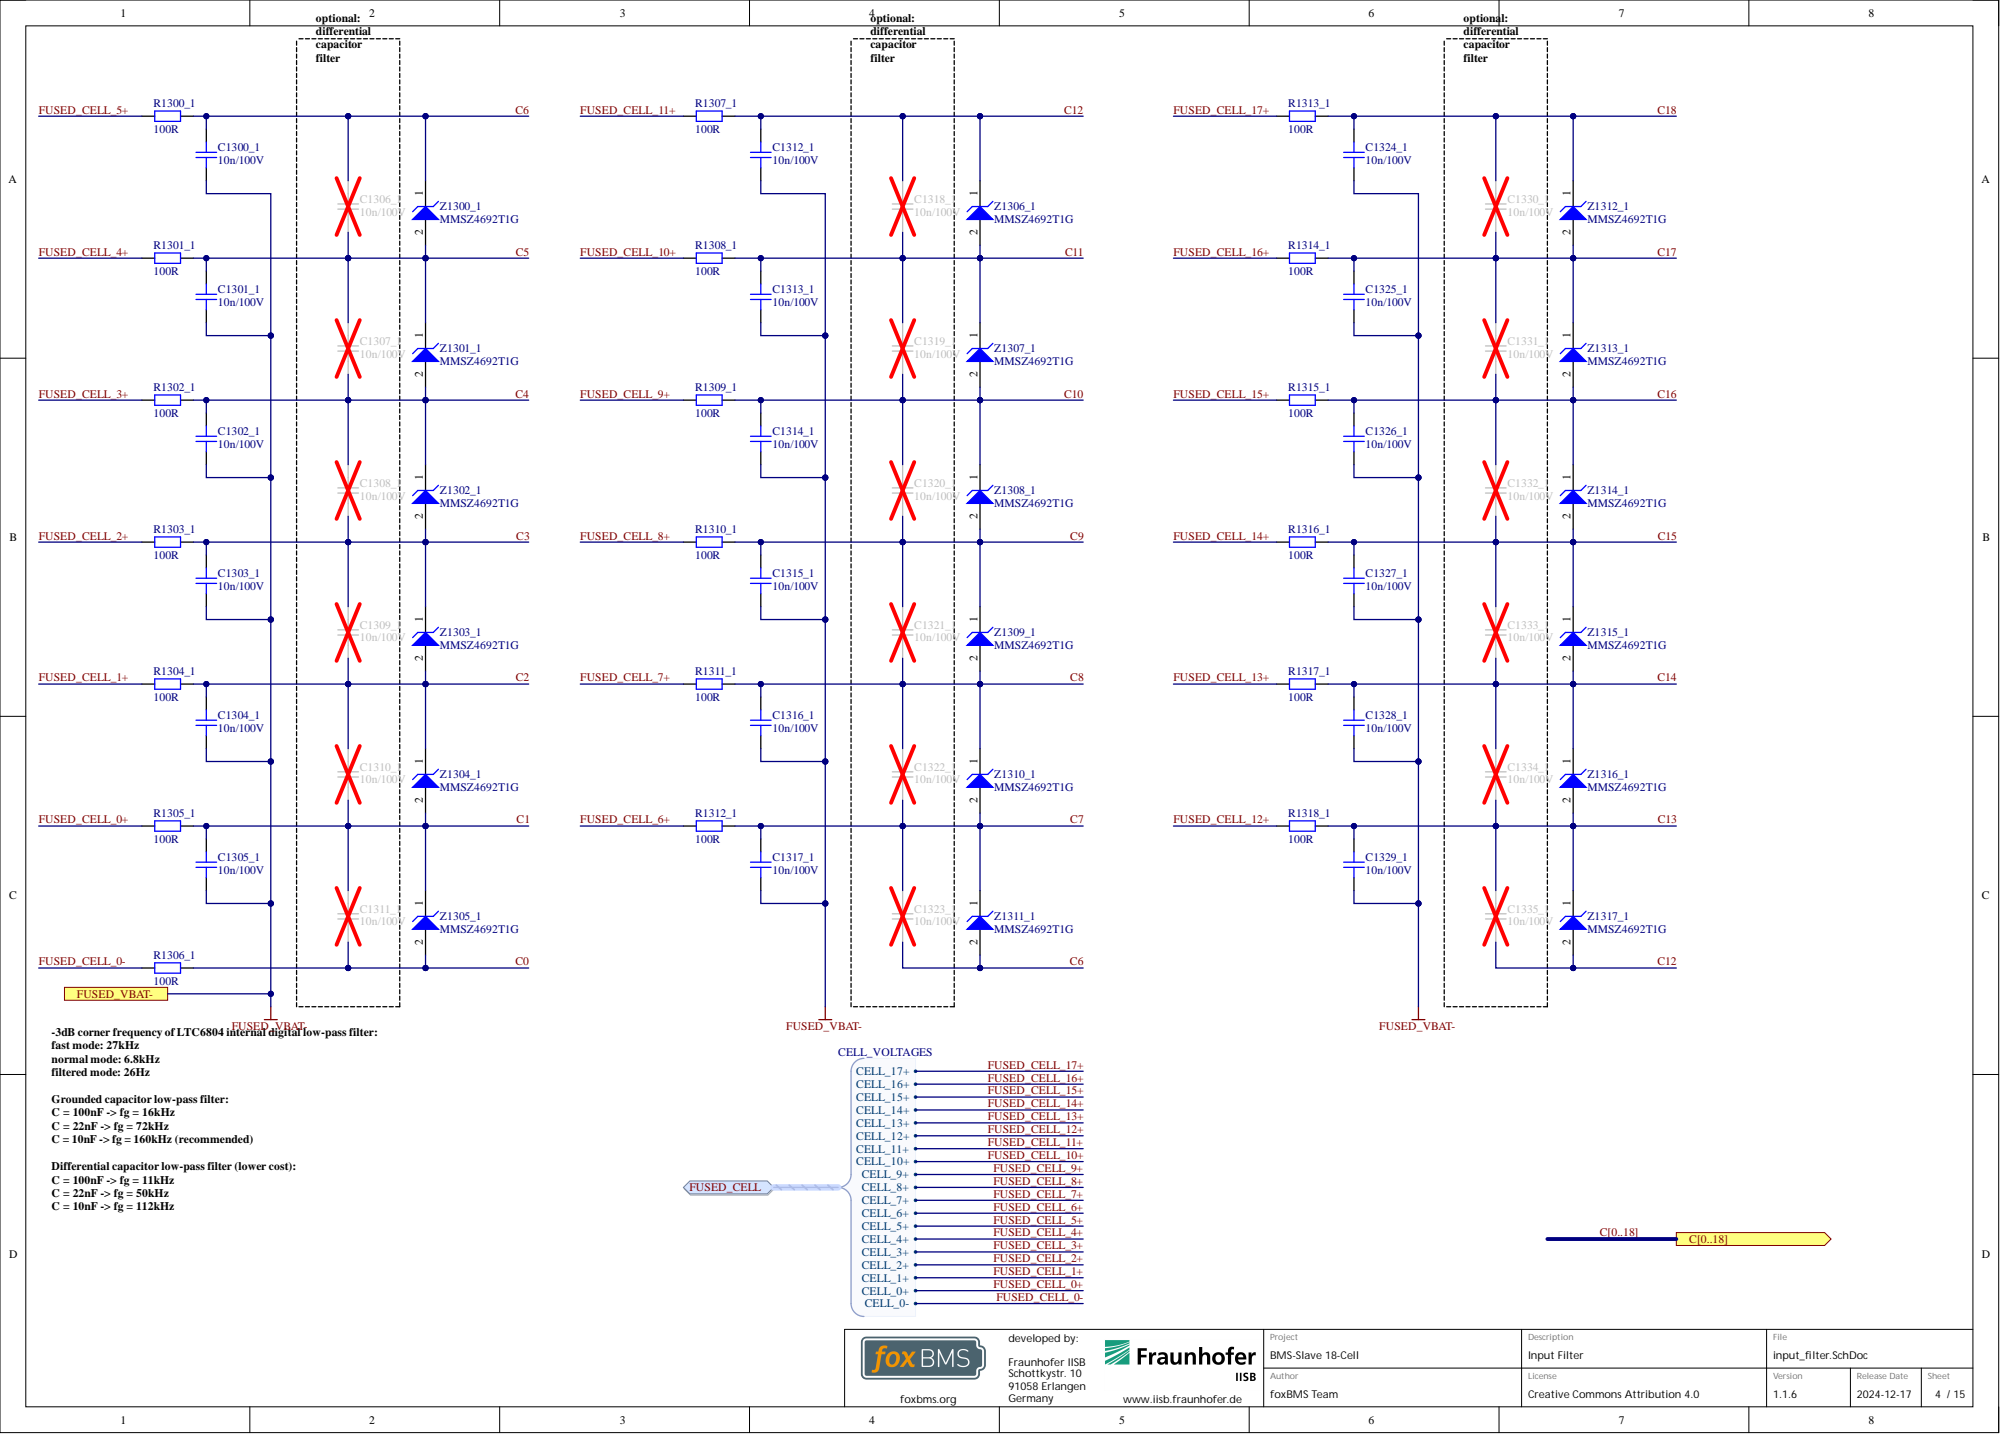
[picture p13: page 5]

-3dB corner frequency of LTC6804 internal digital low-pass filter:
fast mode: 27kHz
normal mode: 6.8kHz
filtered mode: 26Hz

Grounded capacitor low-pass filter:
C = 100nF -> fg = 16kHz
C = 22nF -> fg = 72kHz
C = 10nF -> fg = 160kHz (recommended)

Differential capacitor low-pass filter (lower cost):
C = 100nF -> fg = 11kHz
C = 22nF -> fg = 50kHz
C = 10nF -> fg = 112kHz

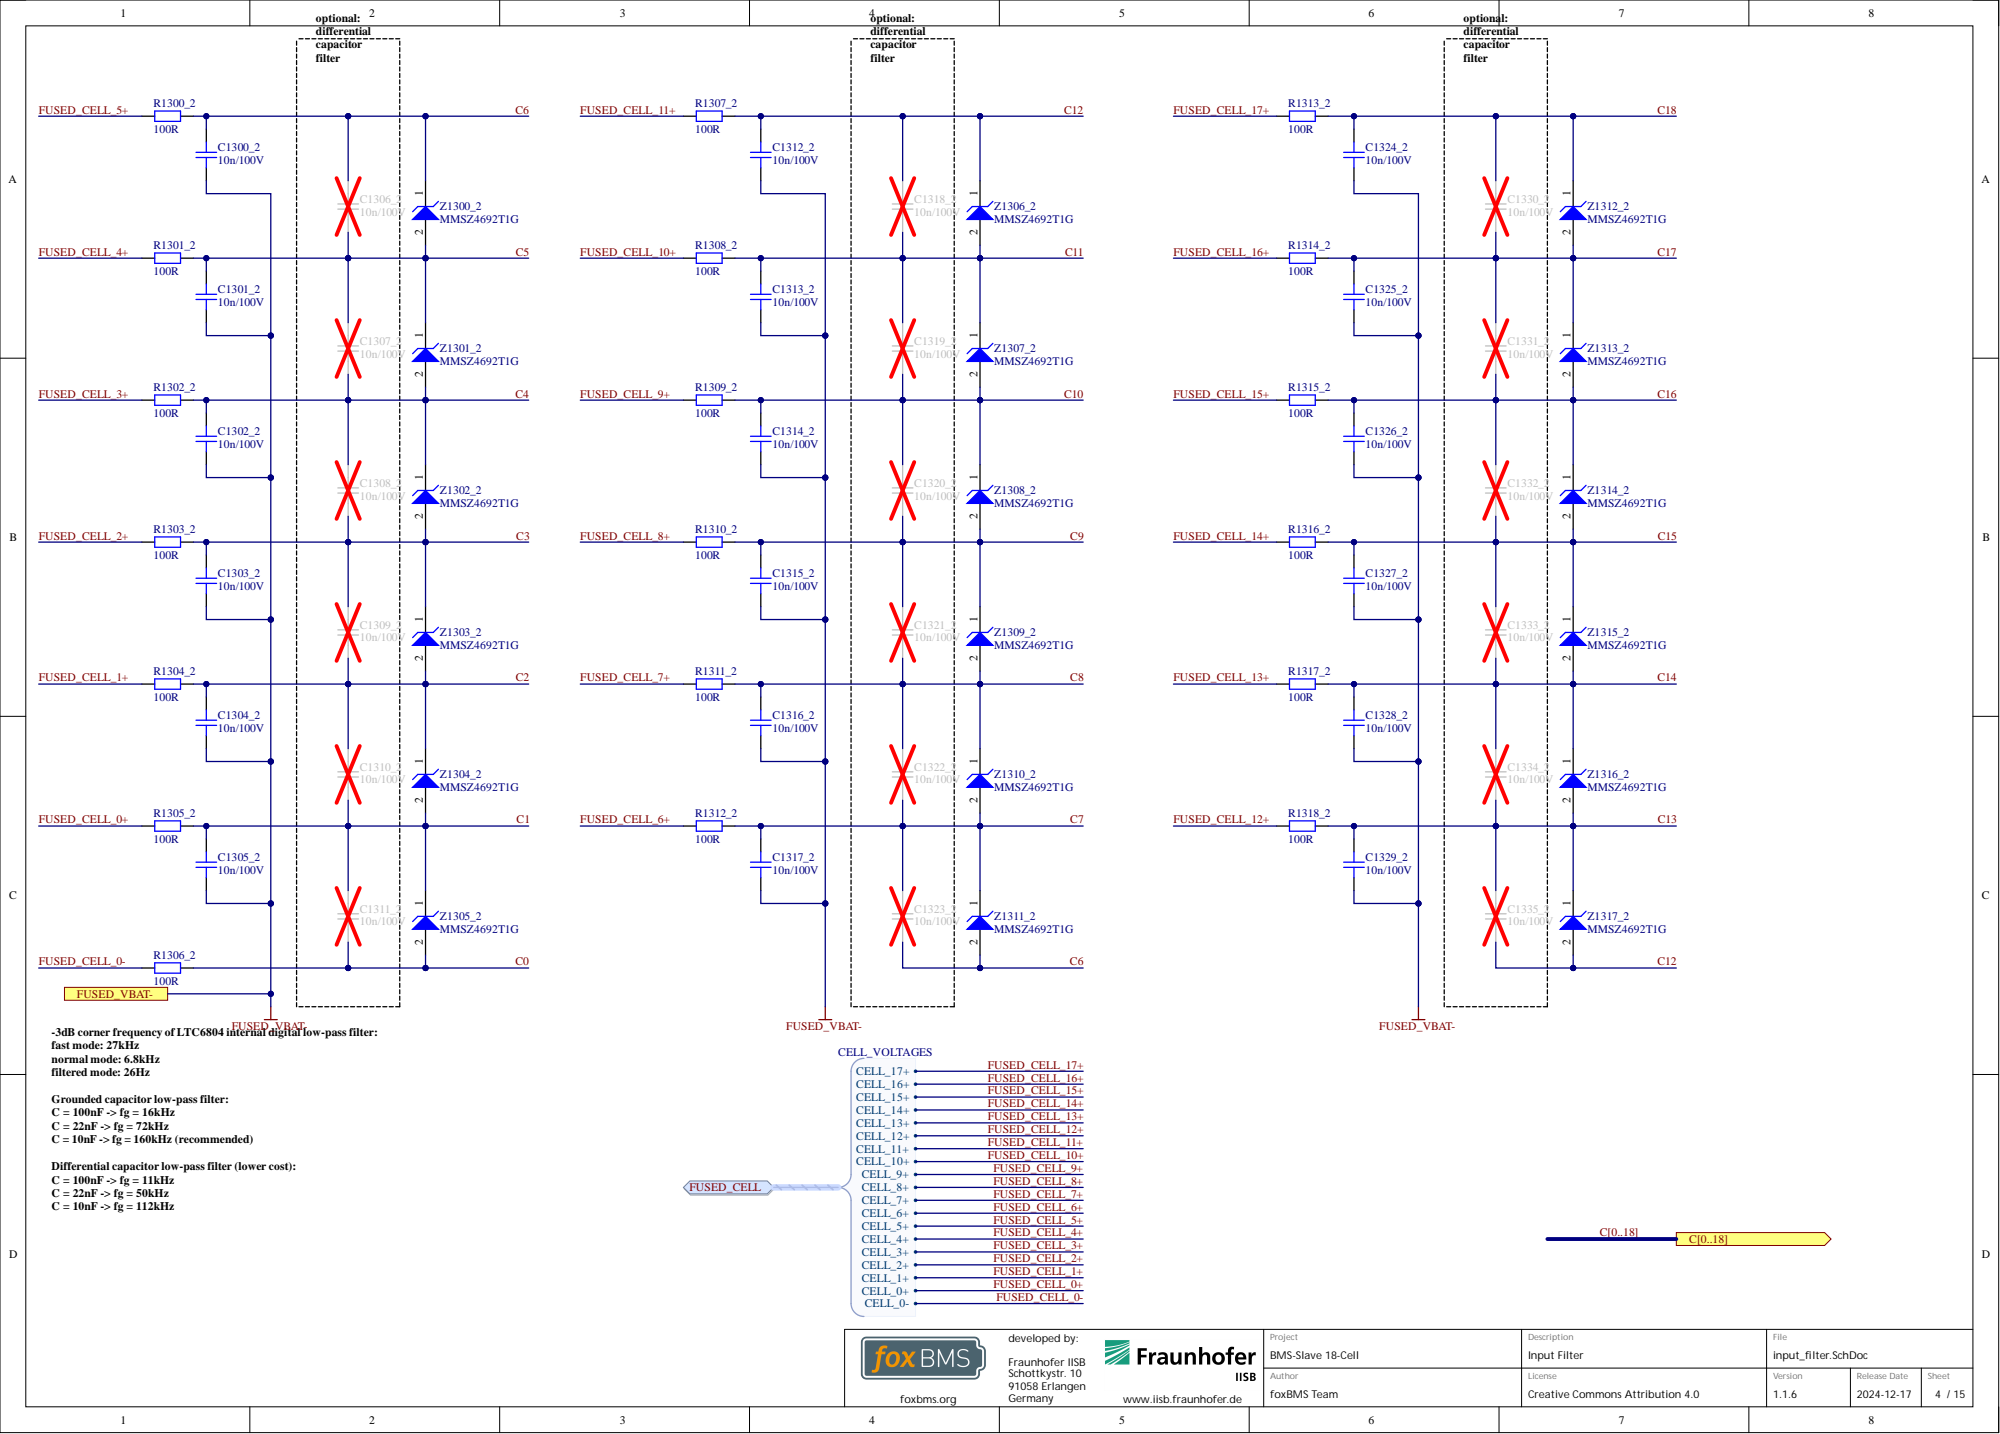
[picture p14: page 6]

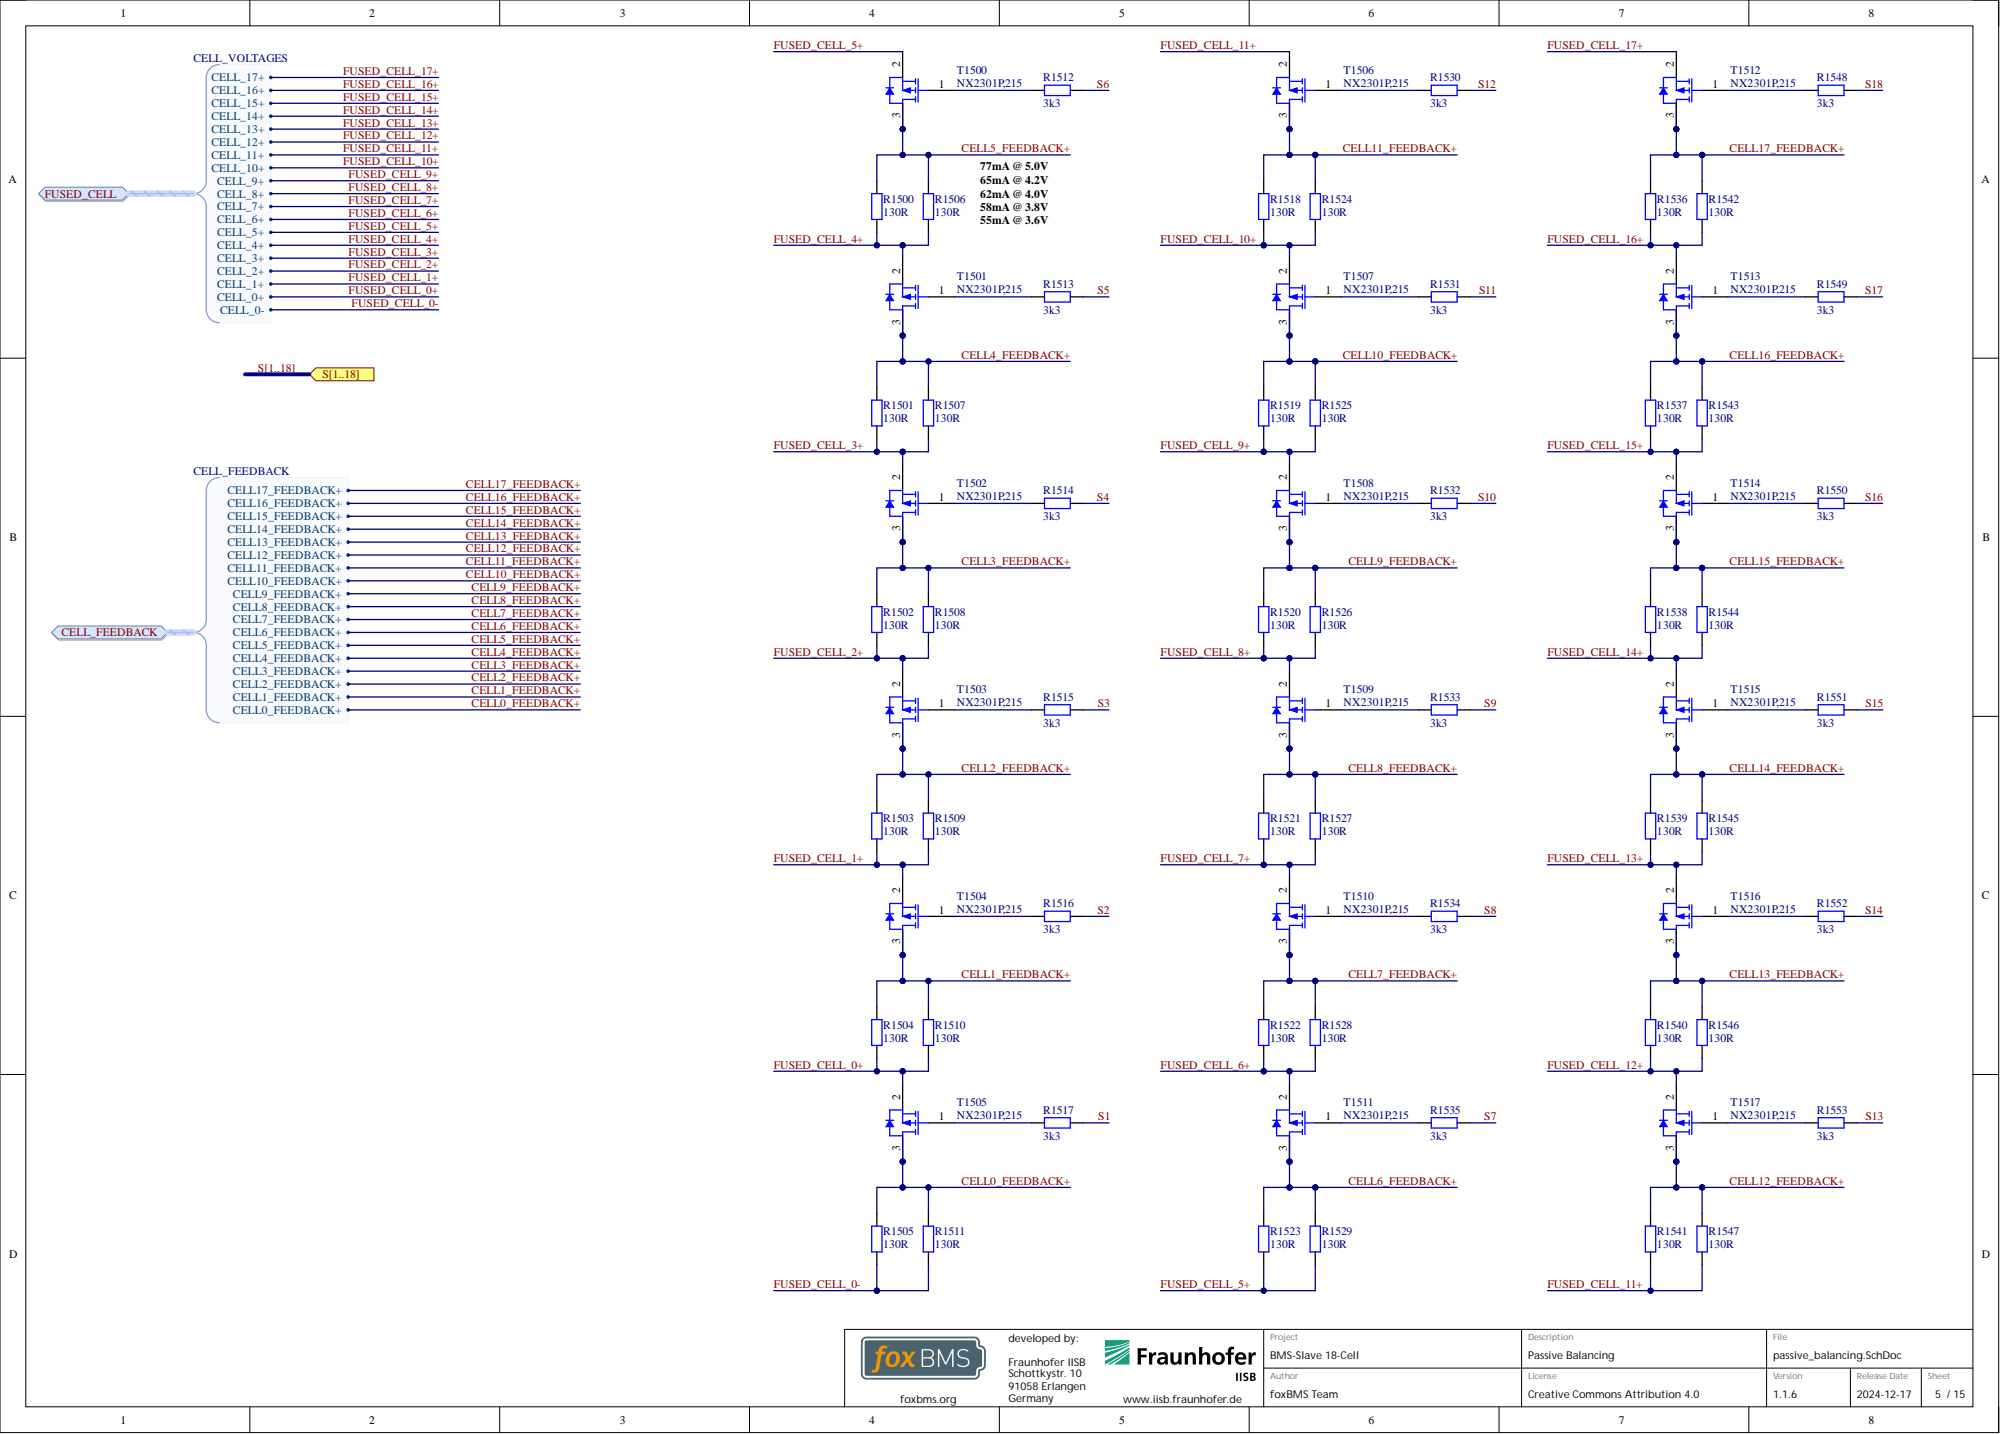
[picture p15: page 7]

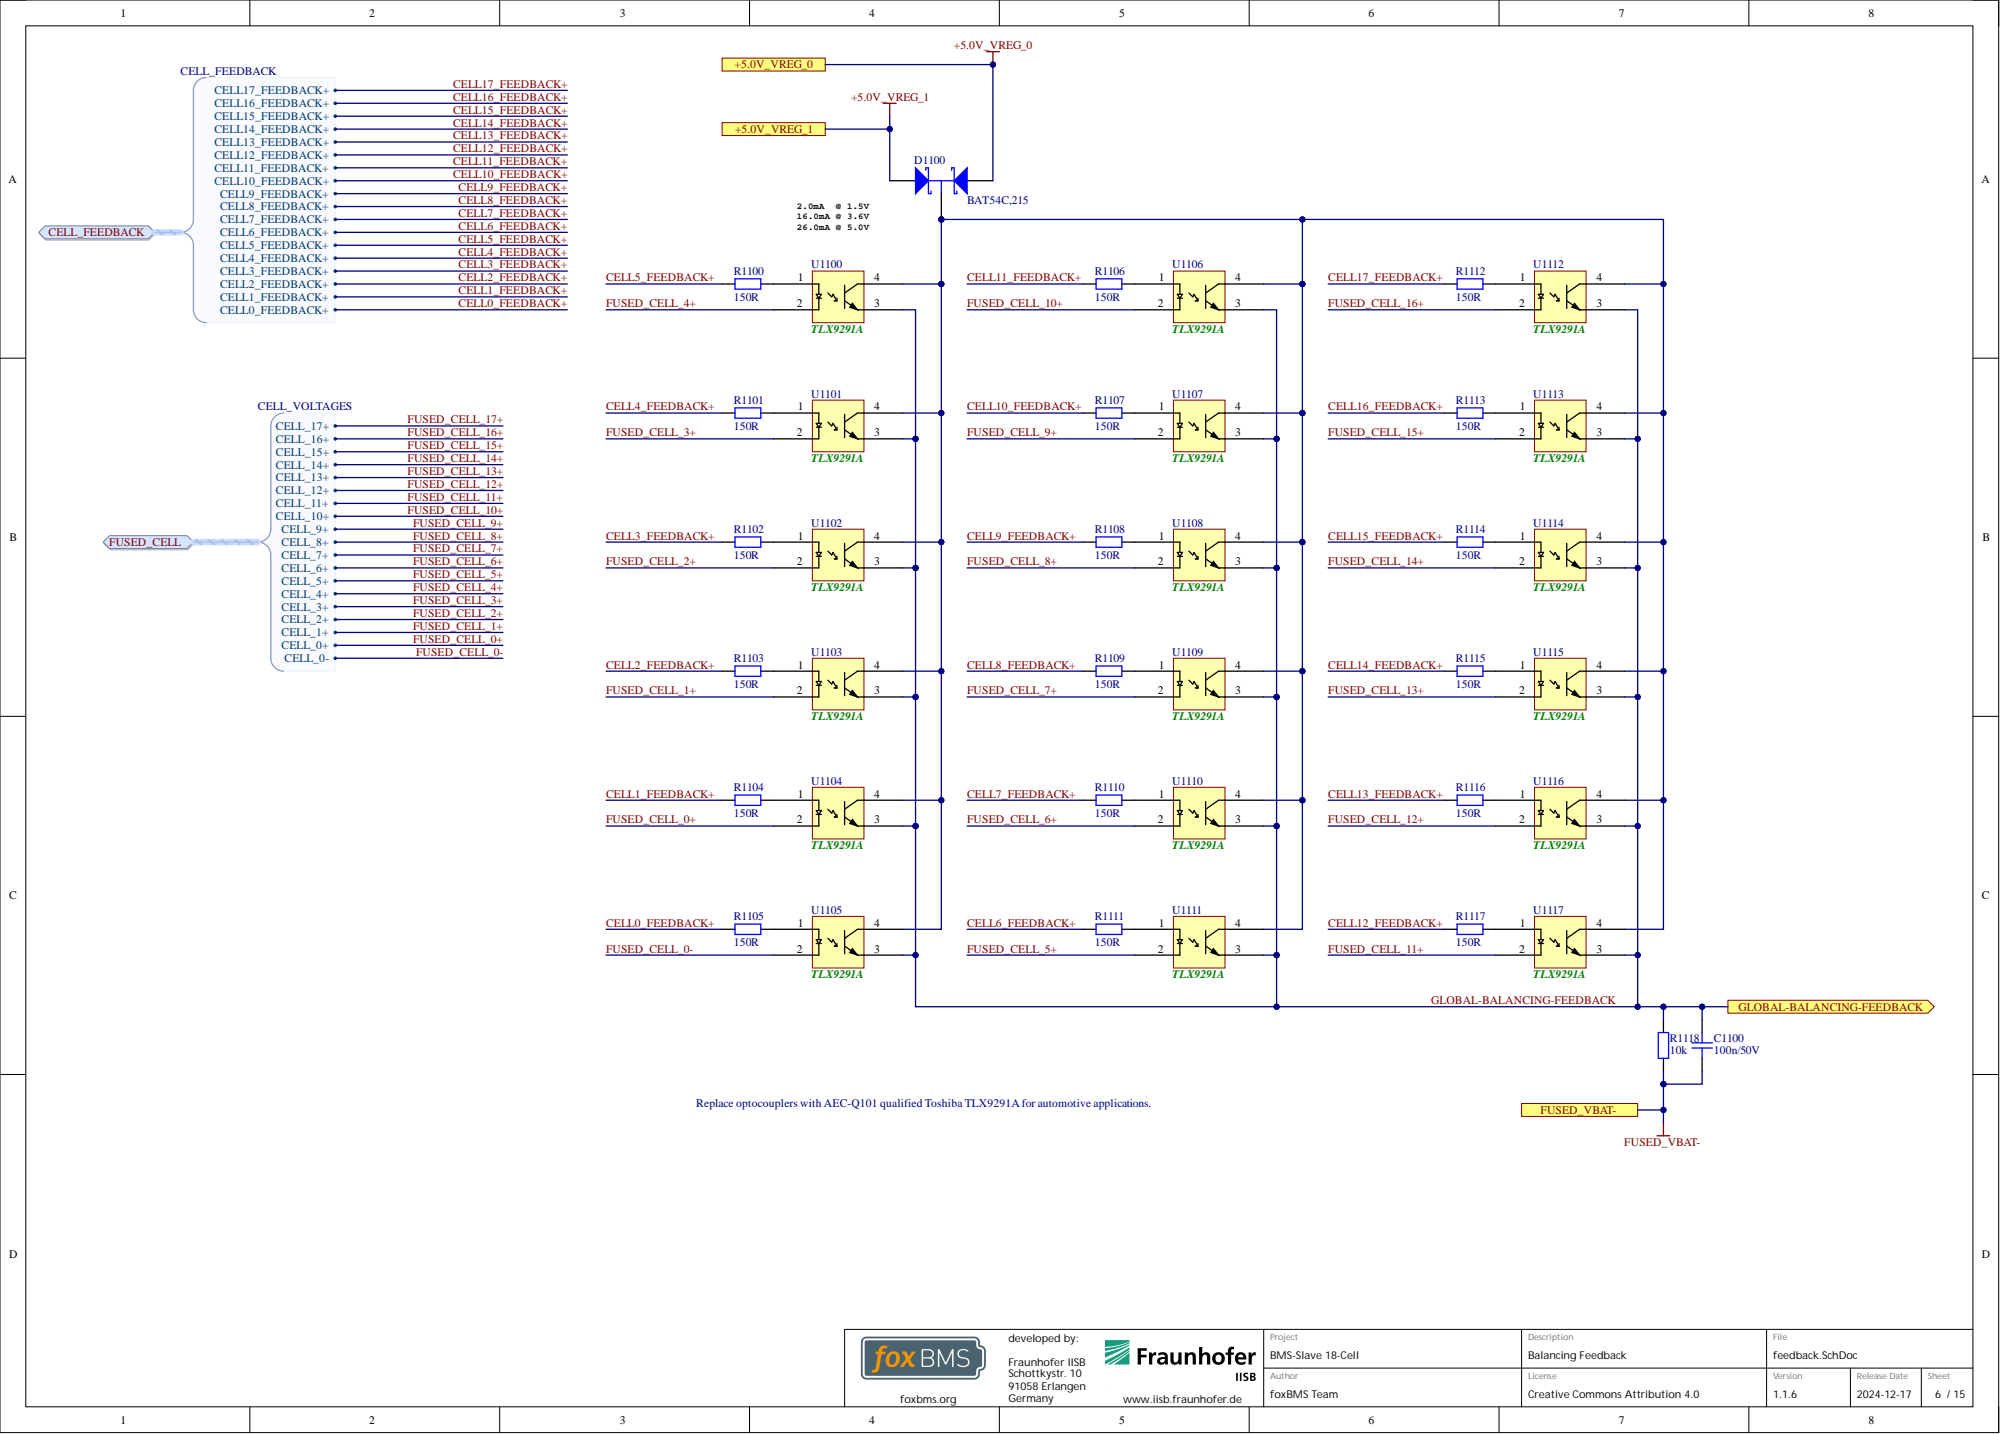
[picture p16: page 8]

Replace optocouplers with AEC-Q101 qualified Toshiba TLX9291A for automotive applications.

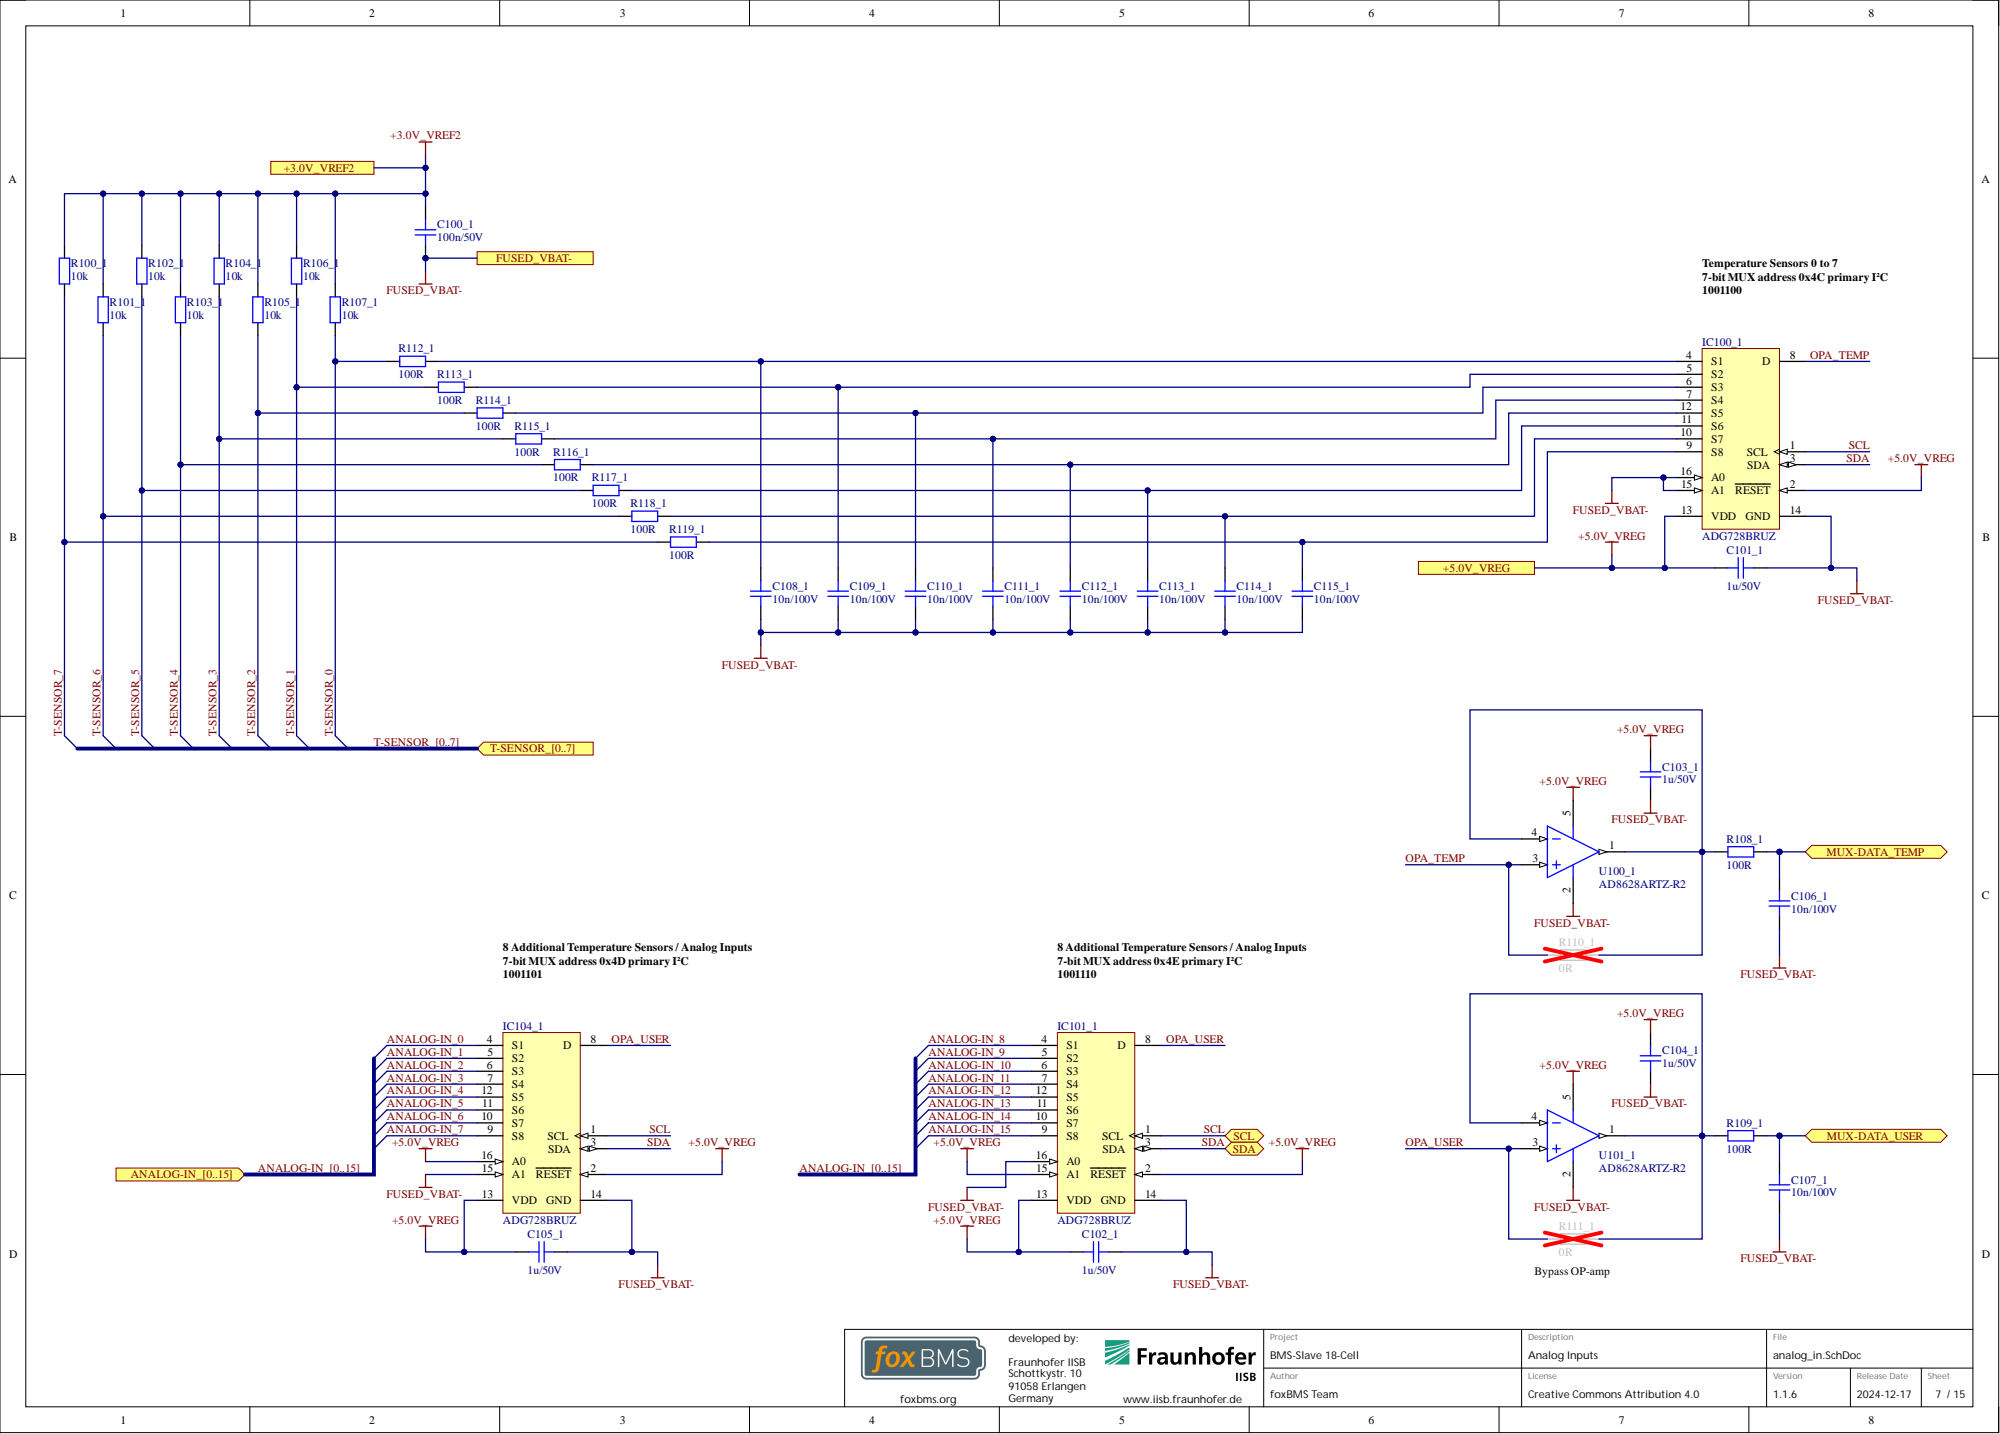
[picture p17: page 9]

Temperature Sensors 0 to 7
7-bit MUX address 0x4C primary I²C

+5.0V_VREG

R110_1 | U100_1 AD8628ARTZ-R2

8 Additional Temperature Sensors / Analog Inputs
7-bit MUX address 0x4D primary I²C

7-bit MUX address 0x4E primary I²C

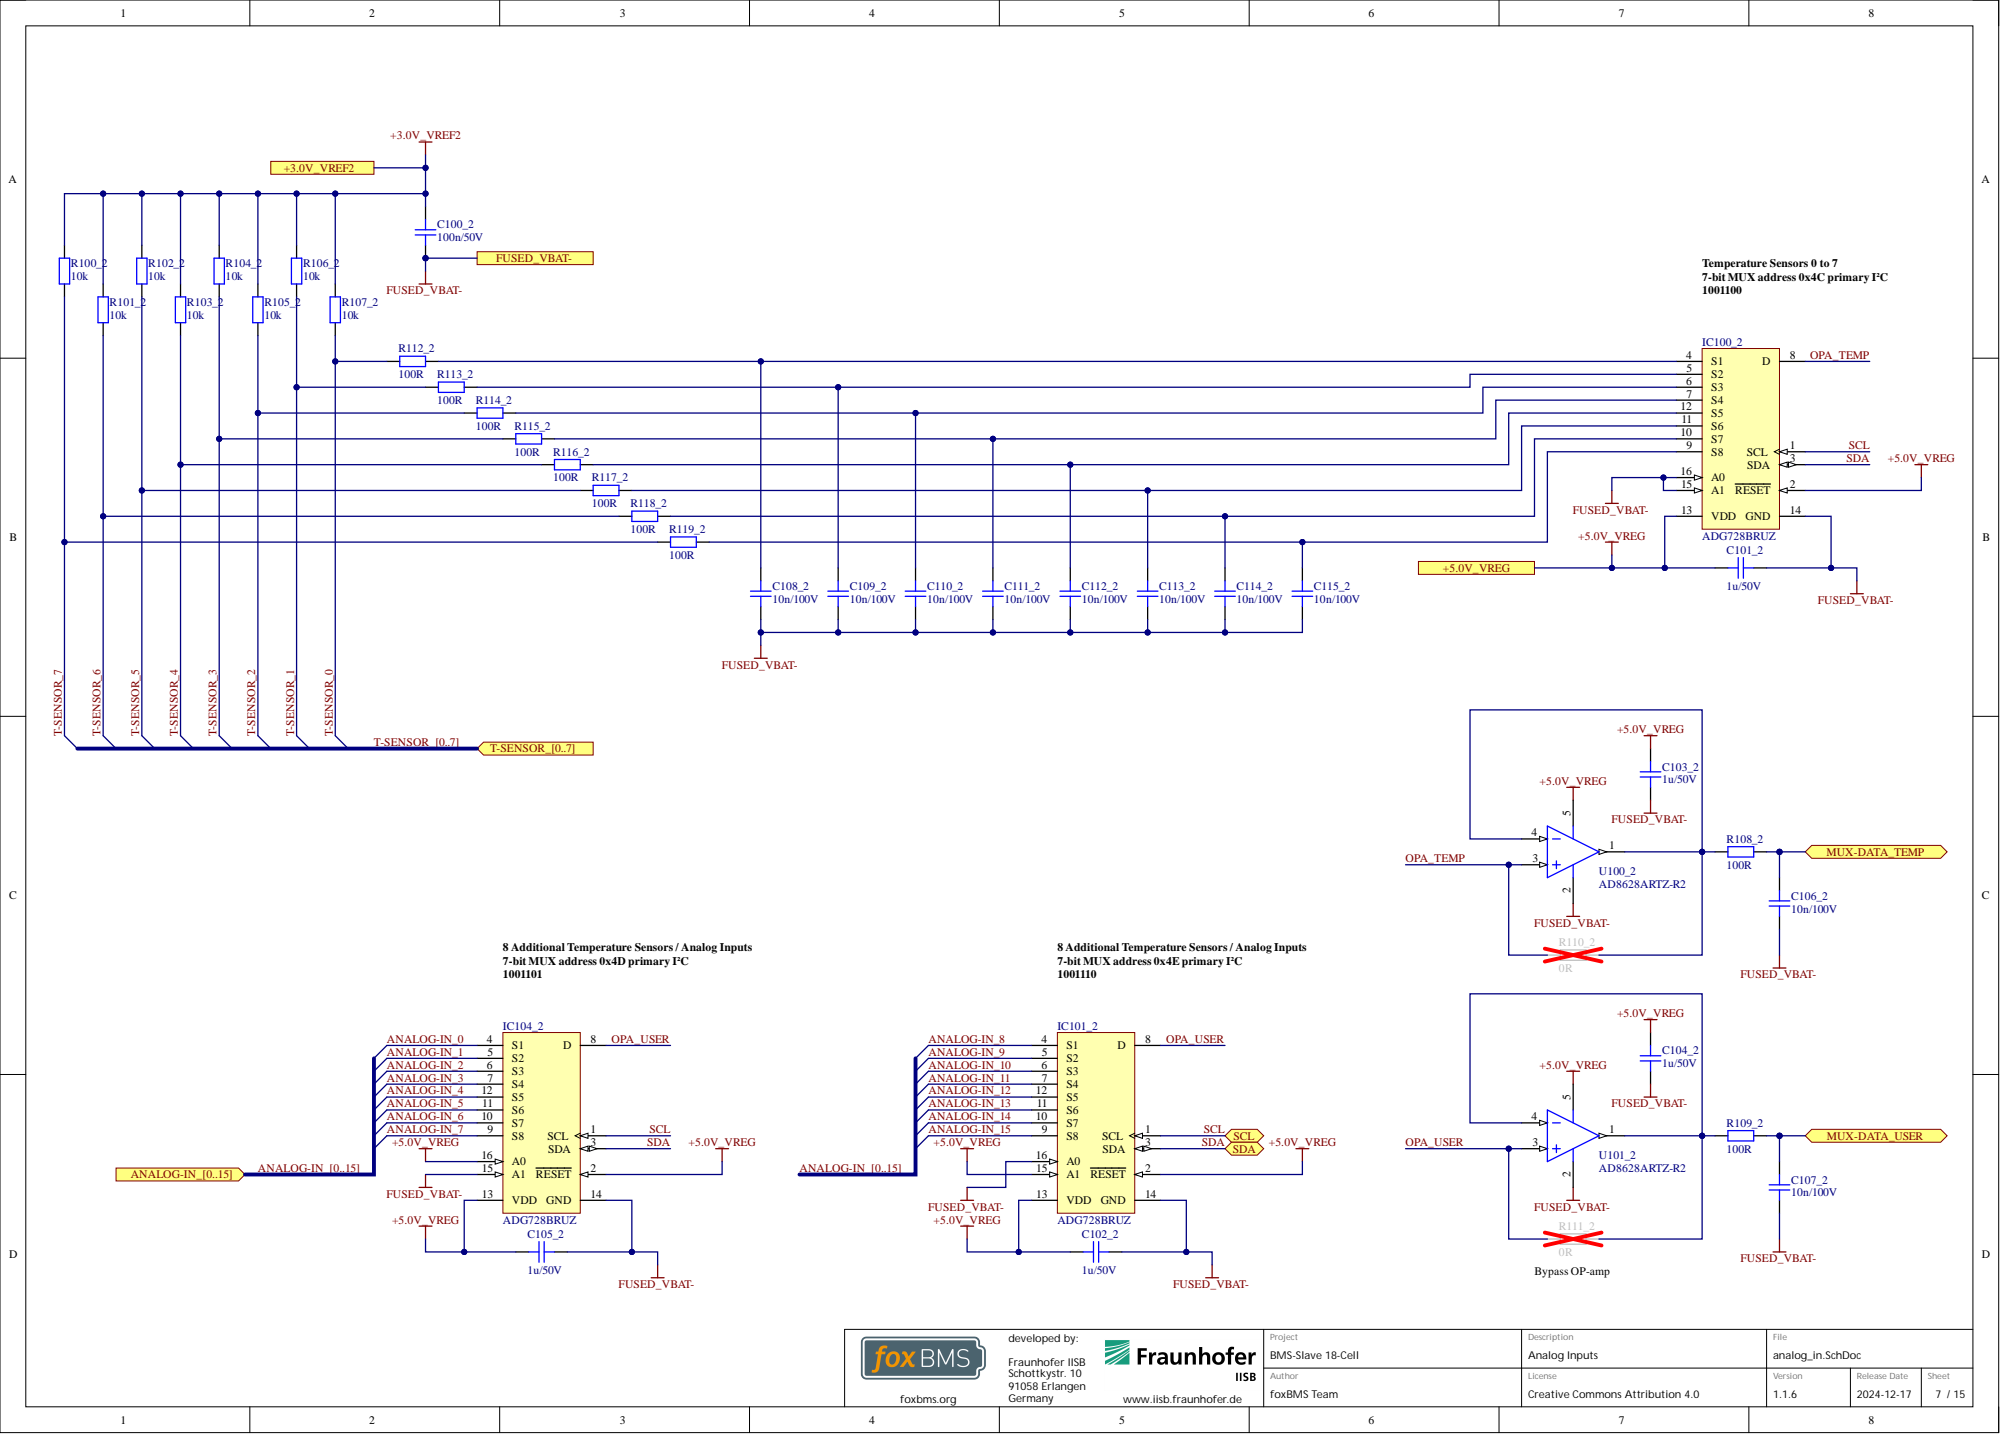
[picture p18: page 10]

Temperature Sensors 0 to 7
7-bit MUX address 0x4C primary I²C

+5.0V_VREG

R110_2 | U100_2 AD8628ARTZ-R2

8 Additional Temperature Sensors / Analog Inputs
7-bit MUX address 0x4D primary I²C

7-bit MUX address 0x4E primary I²C

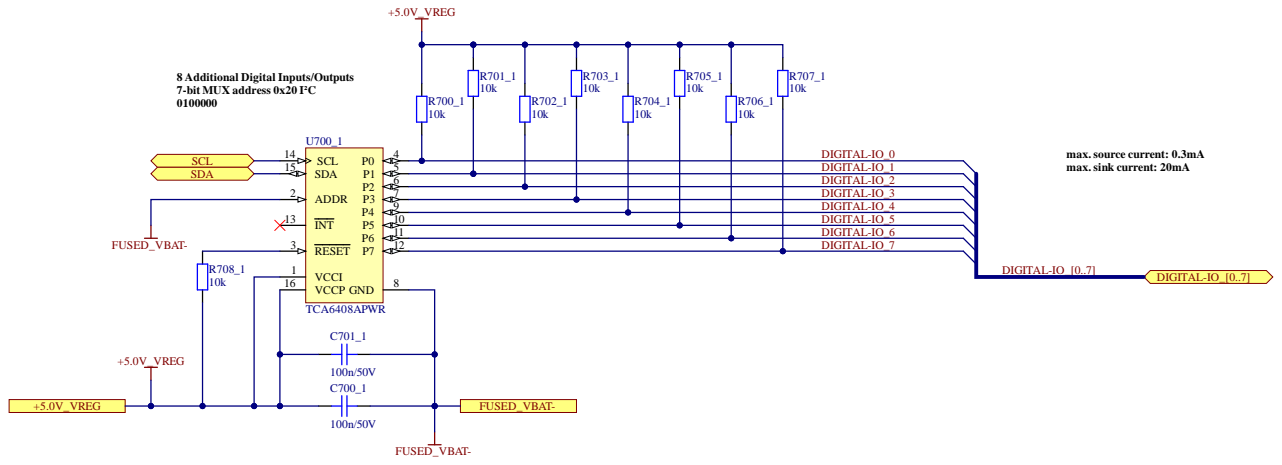
[picture p19: page 11]

8 Additional Digital Inputs/Outputs
7-bit MUX address 0x20 I²C

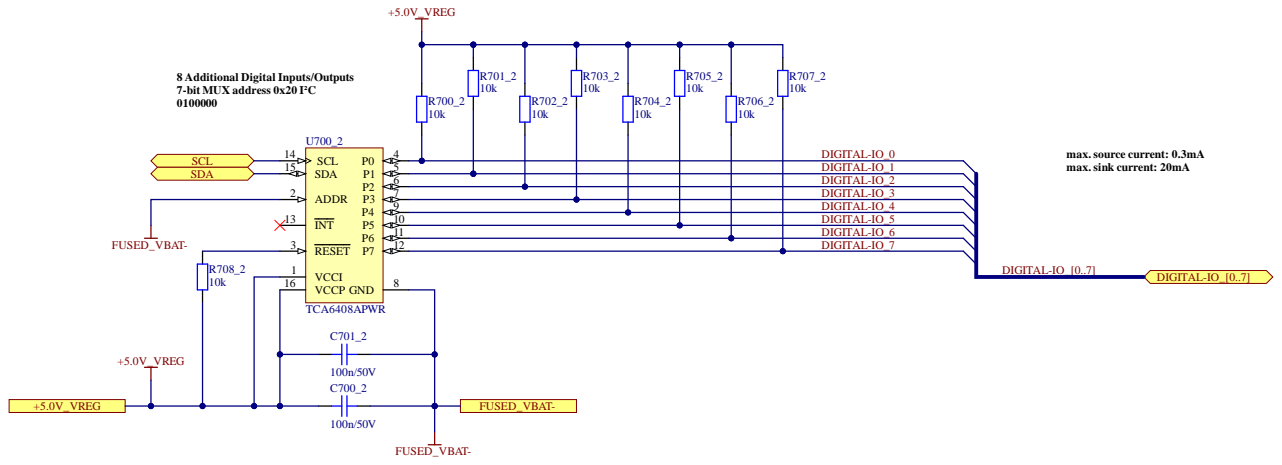
[picture p20: page 12]

8 Additional Digital Inputs/Outputs
7-bit MUX address 0x20 I²C

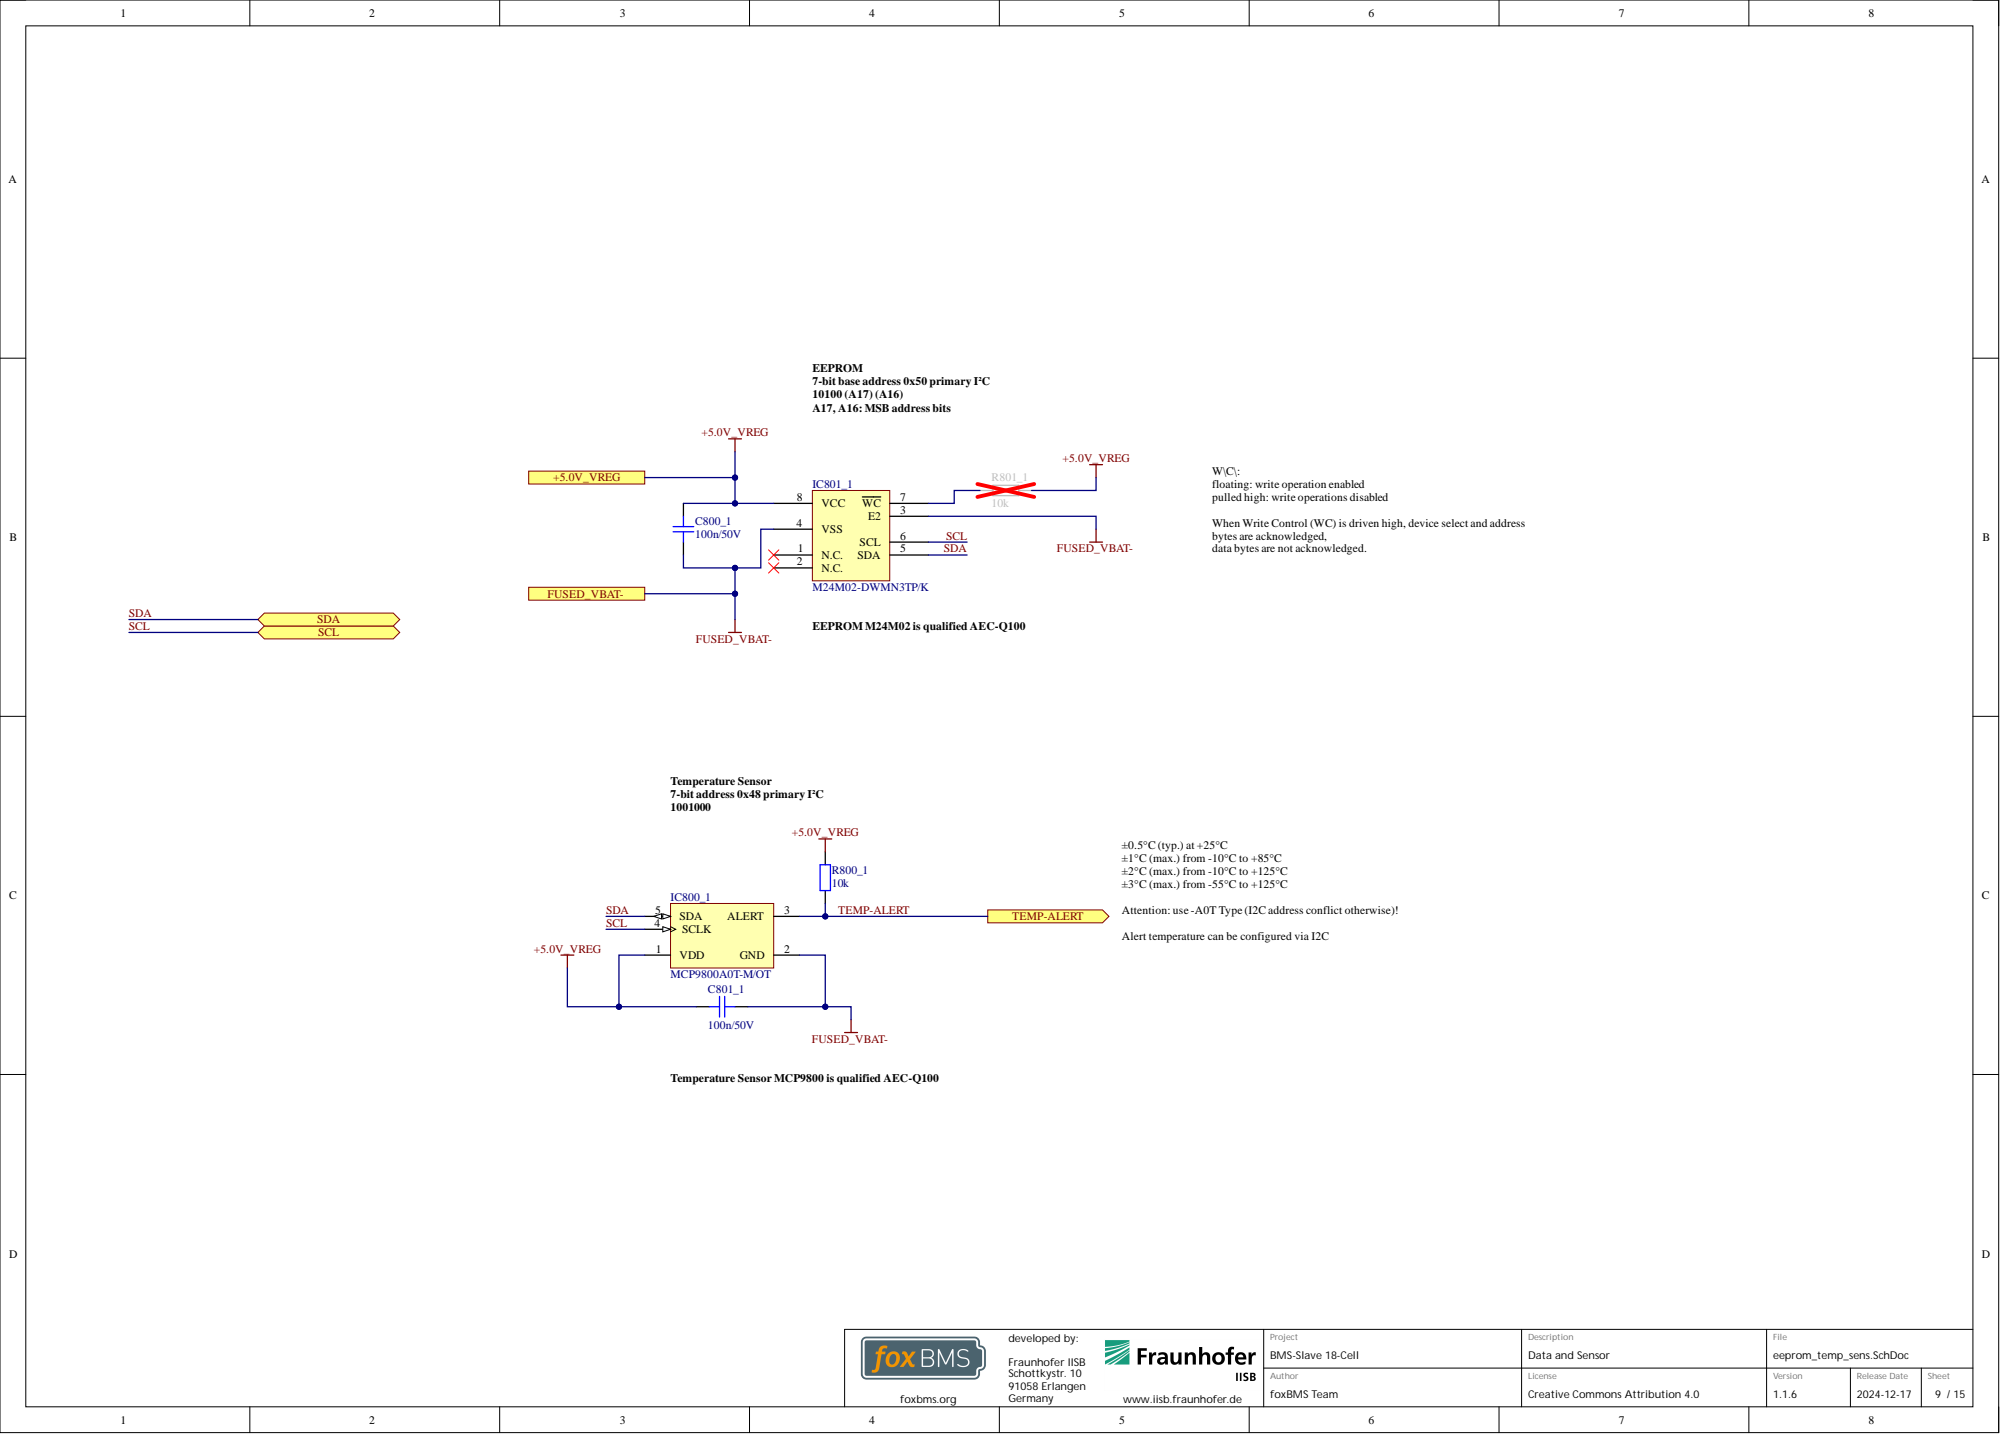
[picture p21: page 13]

EEPROM
7-bit base address 0x50 primary I²C
A17, A16: MSB address bits

floating: write operation enabled
pulled high: write operations disabled

When Write Control (WC) is driven high, device select and address
bytes are acknowledged,
data bytes are not acknowledged.

EEPROM M24M02 is qualified AEC-Q100

Temperature Sensor
7-bit address 0x48 primary I²C

Attention: use -A0T Type (I2C address conflict otherwise)!

Alert temperature can be configured via I2C

Temperature Sensor MCP9800 is qualified AEC-Q100

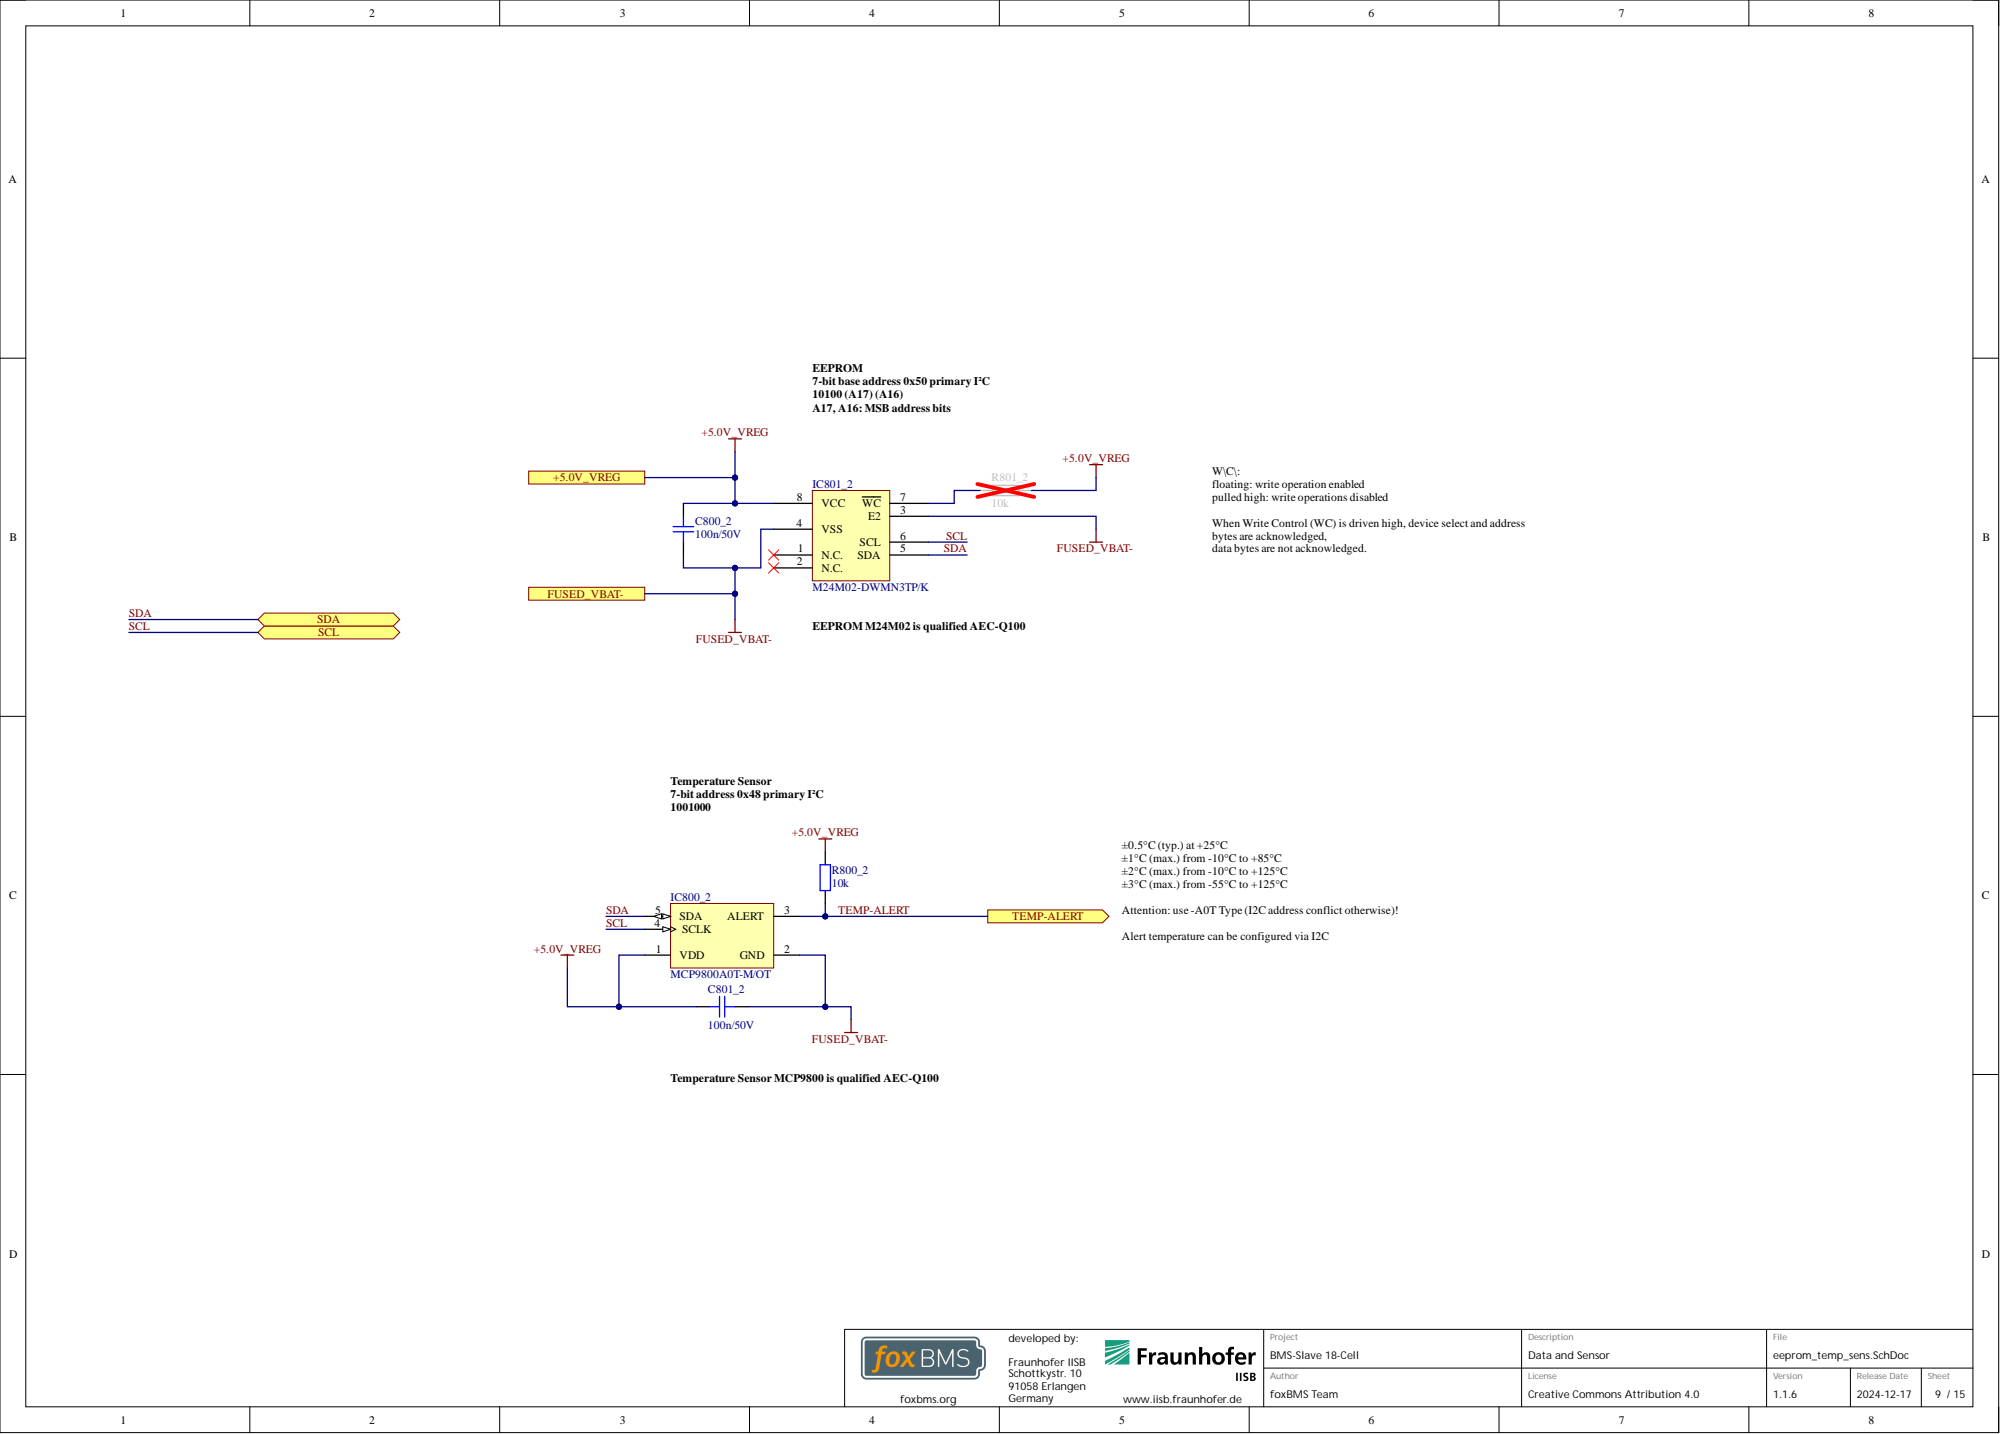
[picture p22: page 14]

EEPROM
7-bit base address 0x50 primary I²C
A17, A16: MSB address bits

floating: write operation enabled
pulled high: write operations disabled

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

EEPROM M24M02 is qualified AEC-Q100

Temperature Sensor
7-bit address 0x48 primary I²C

Attention: use -A0T Type (I2C address conflict otherwise)!

Alert temperature can be configured via I2C

Temperature Sensor MCP9800 is qualified AEC-Q100

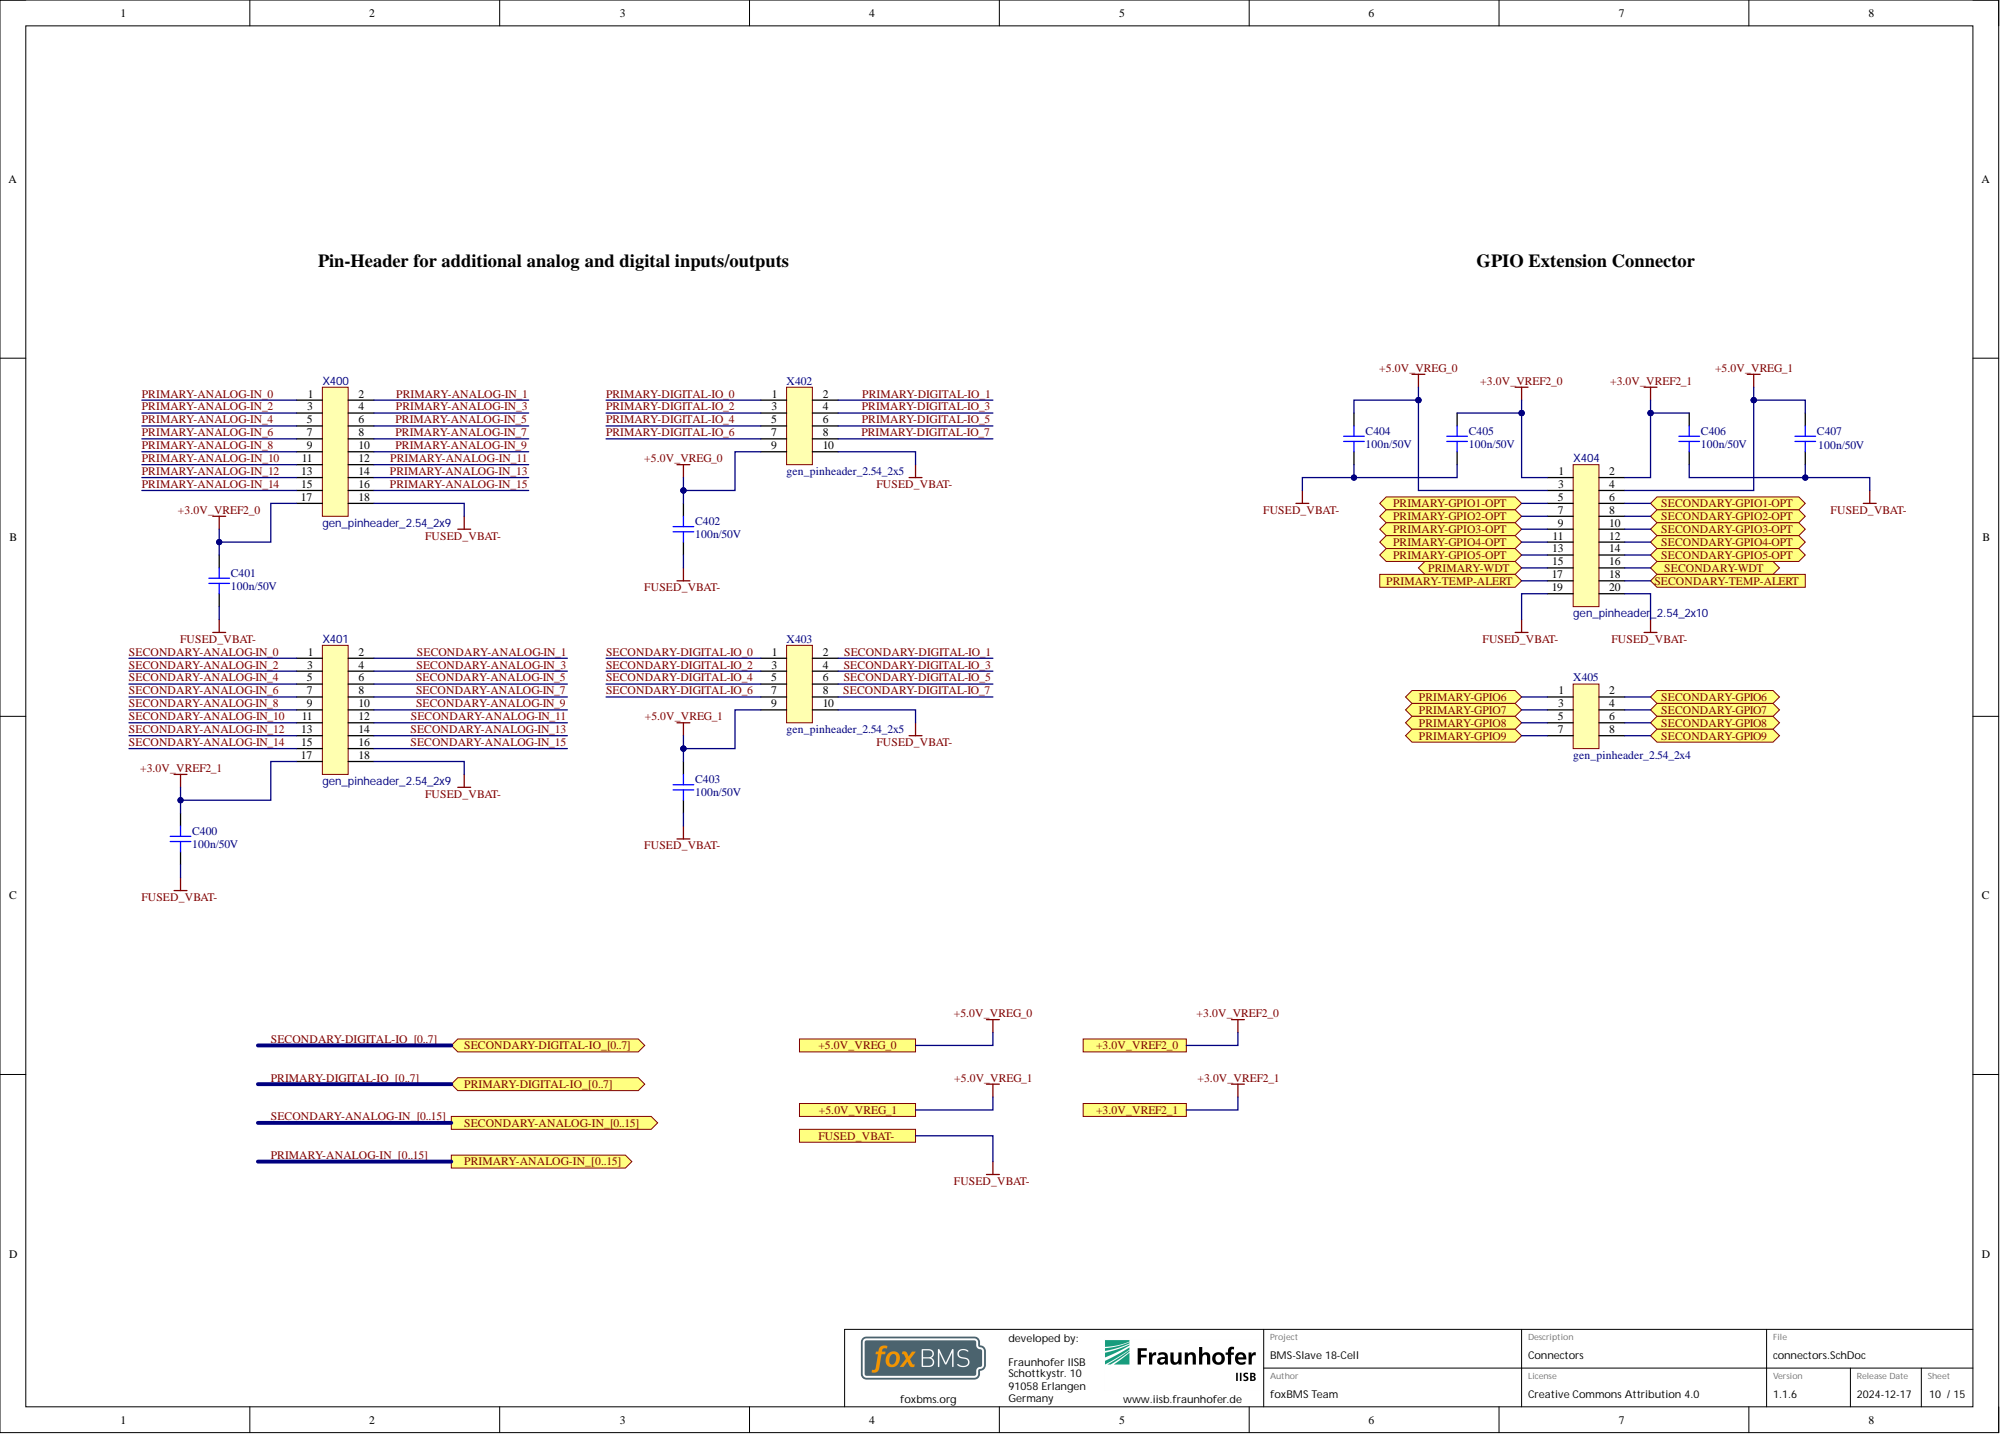
[picture p23: page 15]

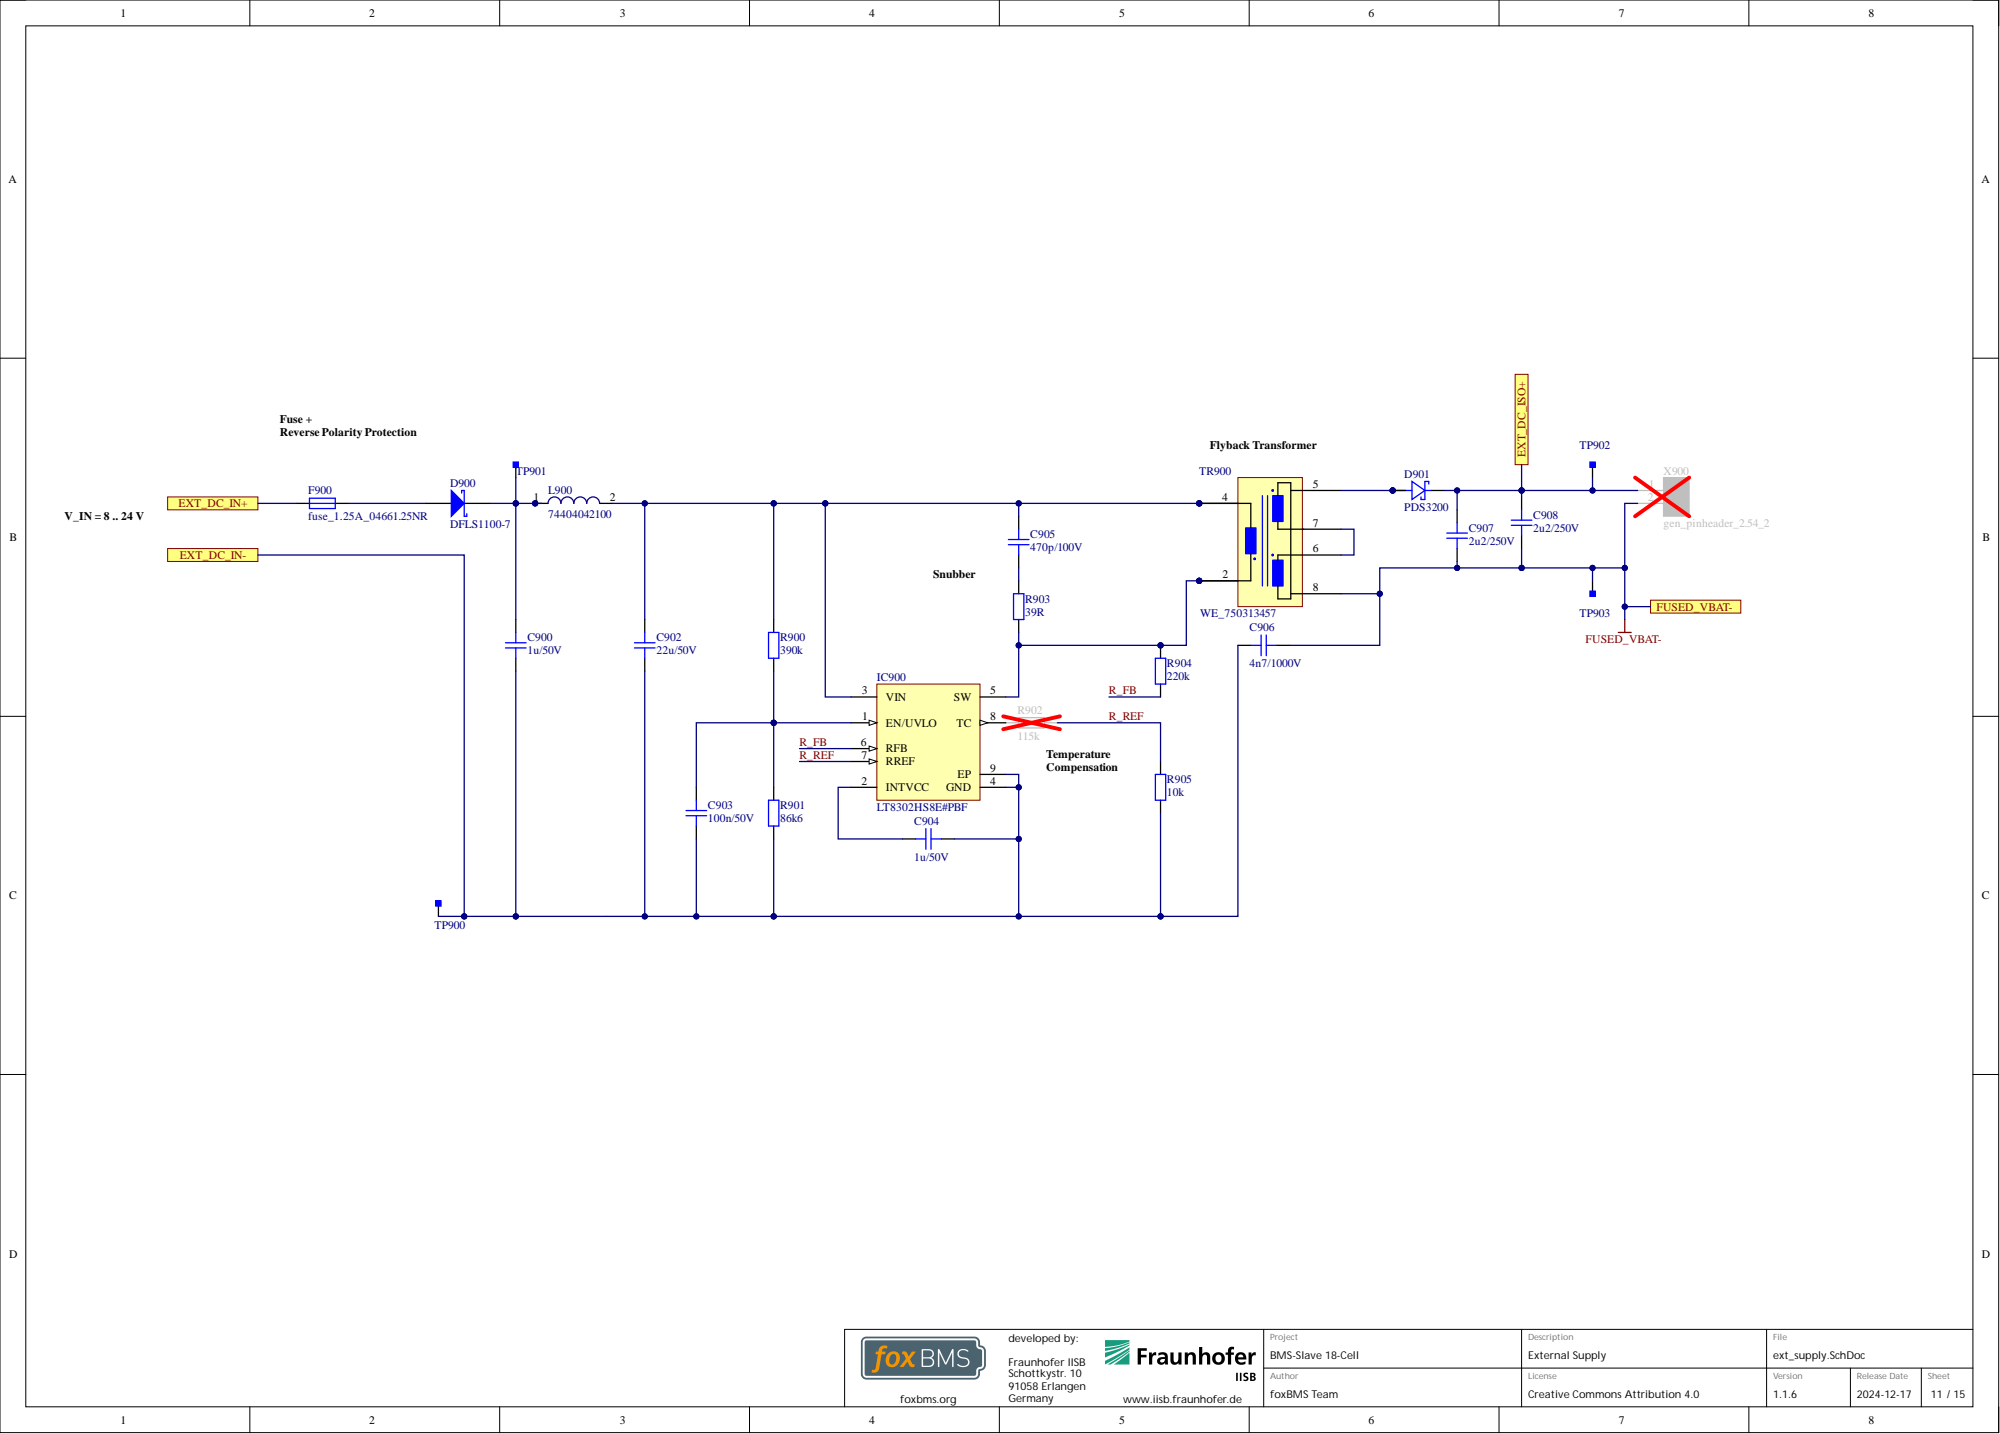
[picture p24: page 16]

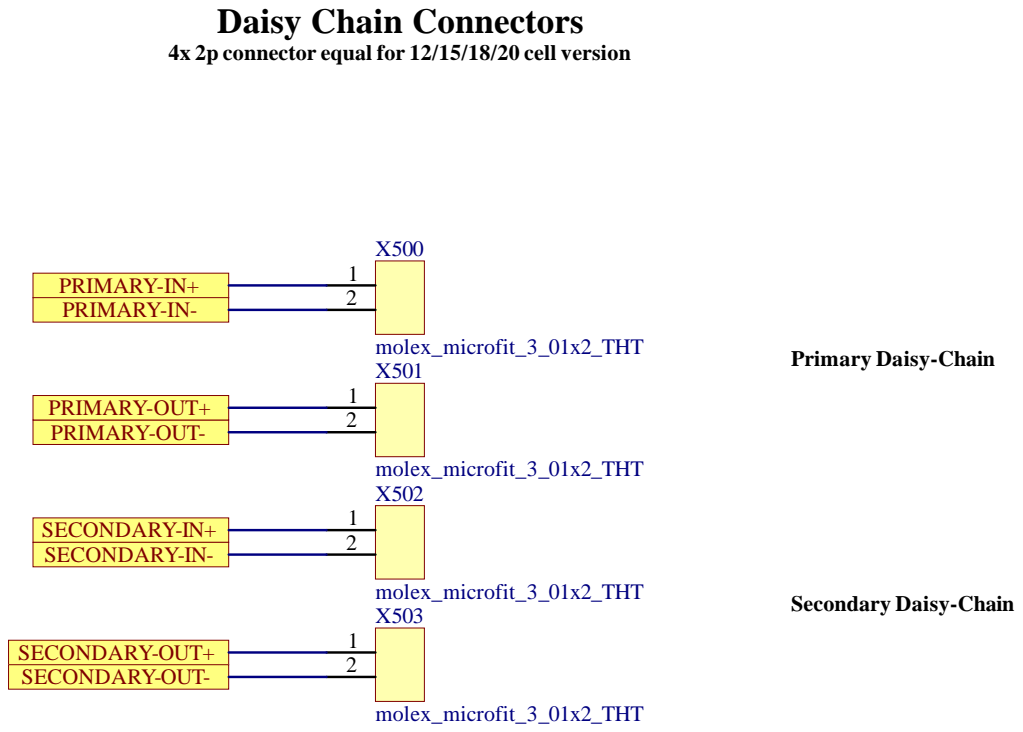
[picture p25: page 17]

Daisy Chain Connectors
4x 2p connector equal for 12/15/18/20 cell version

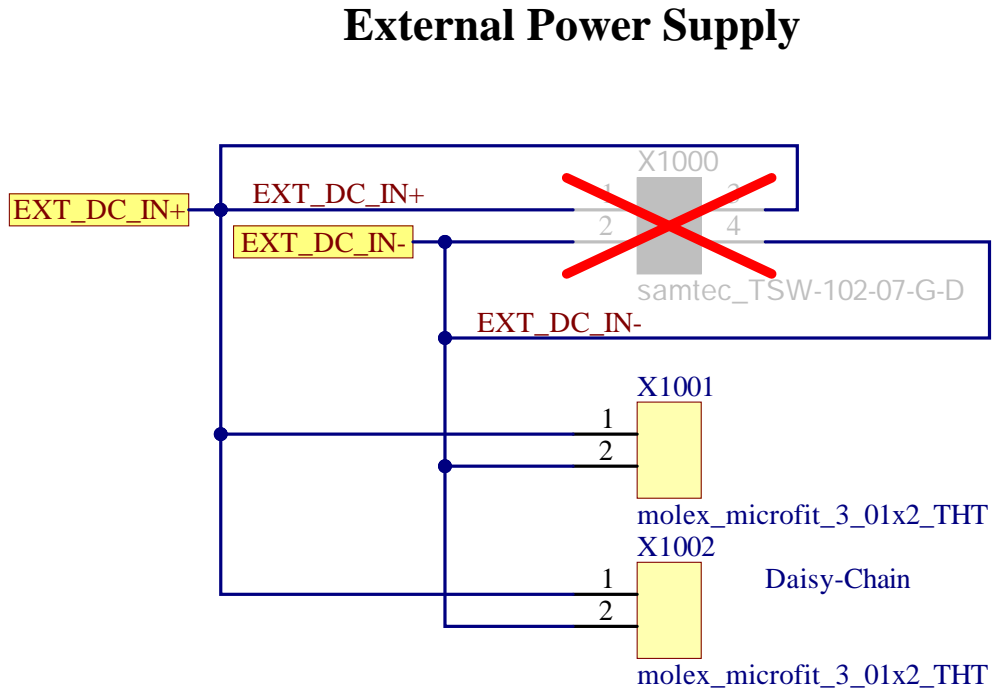
[picture p26: page 18]

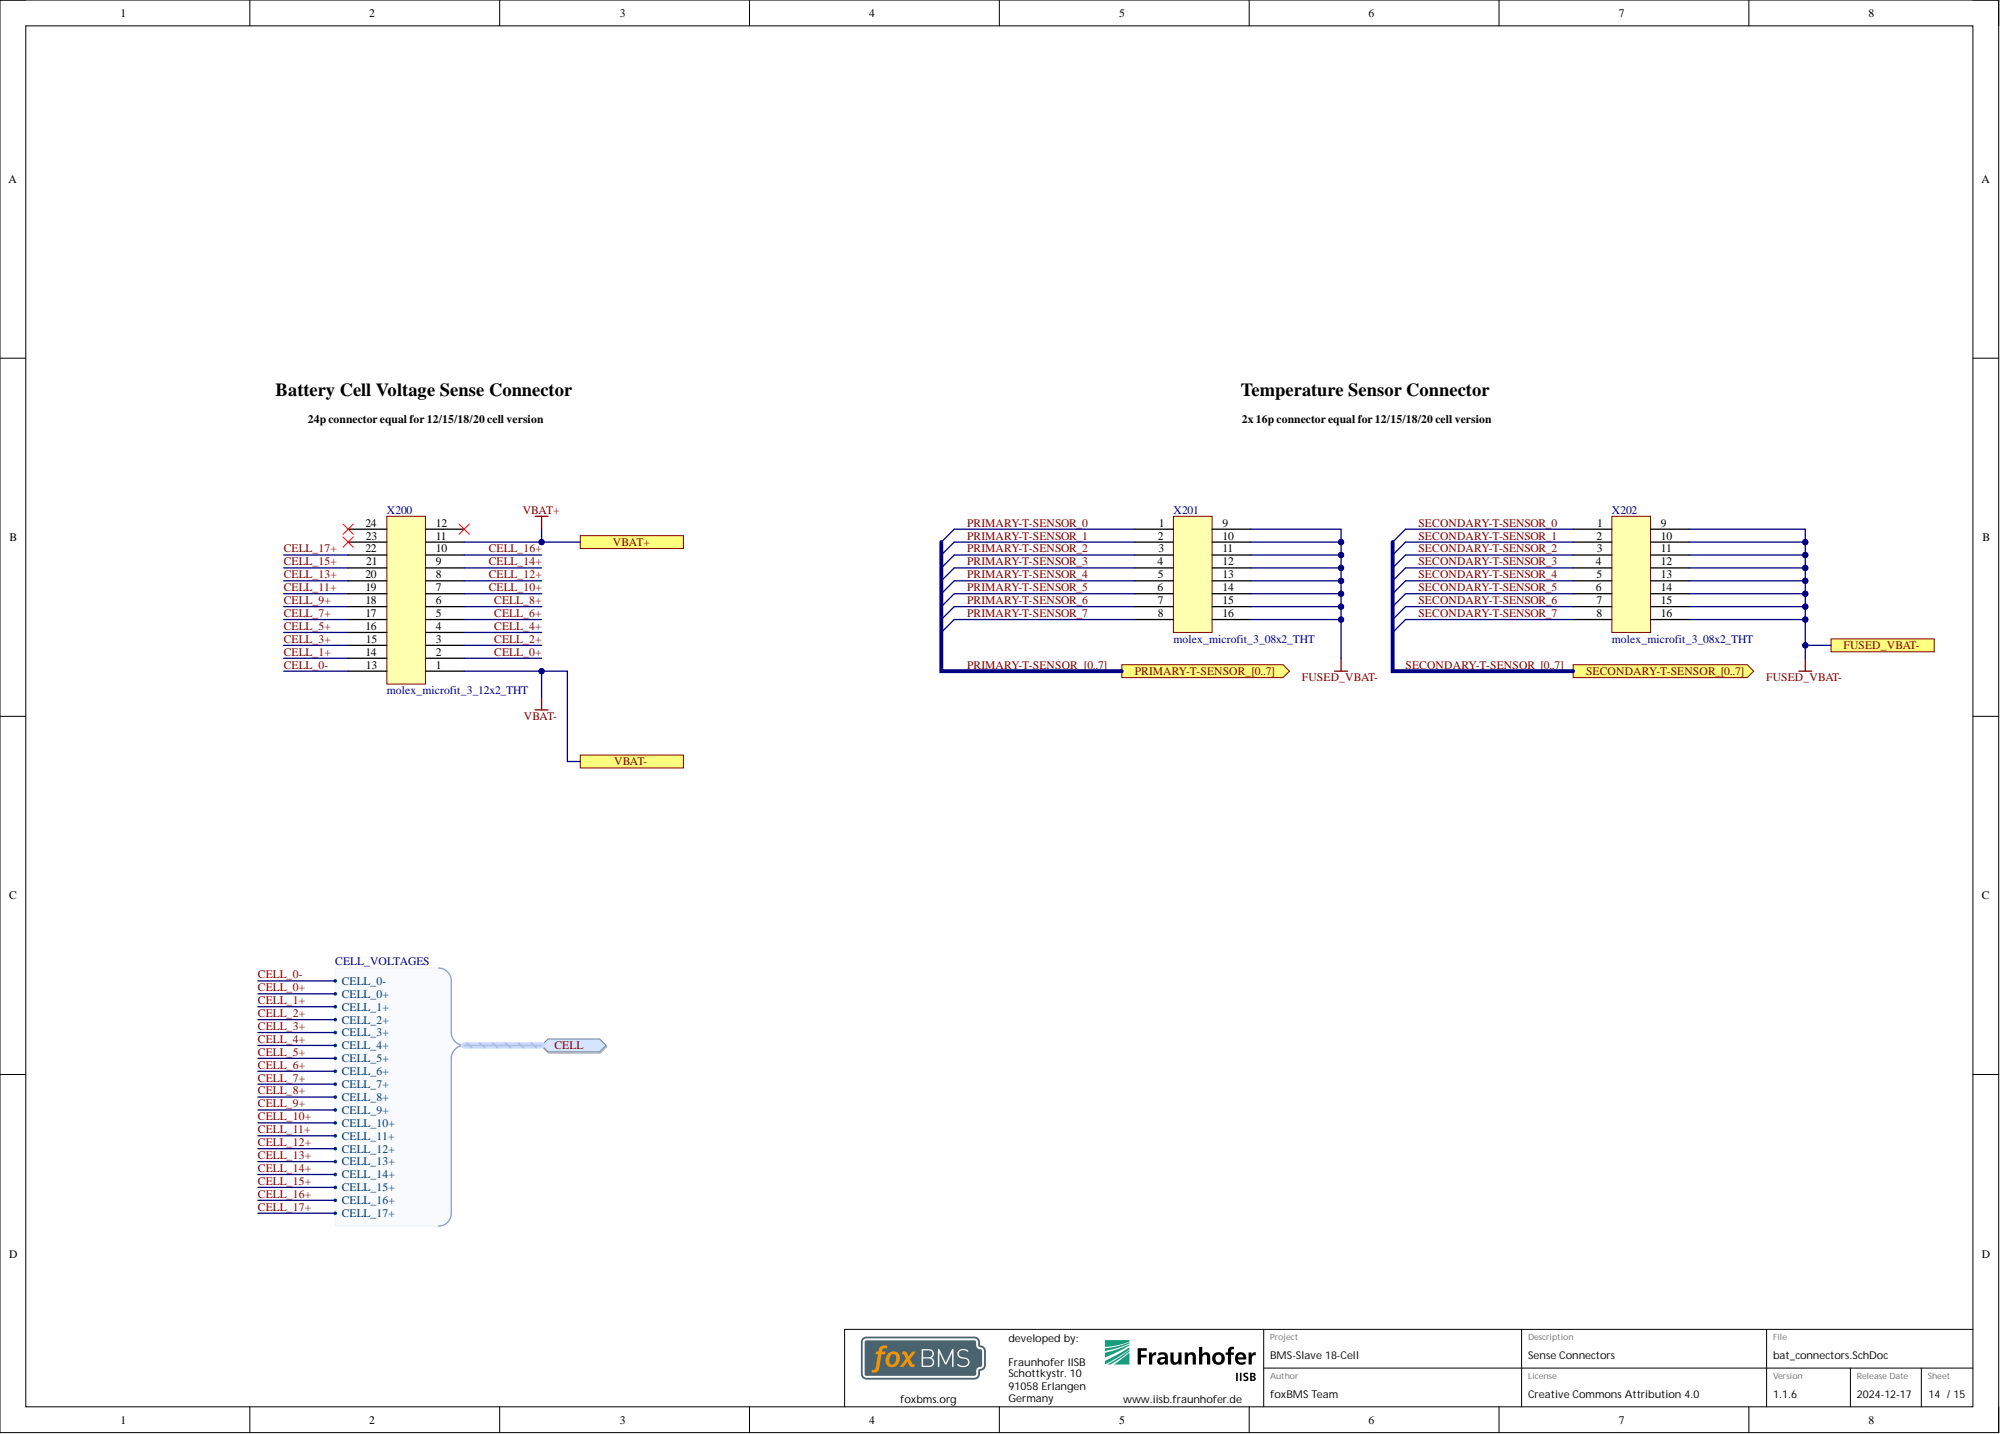
[picture p27: page 19]

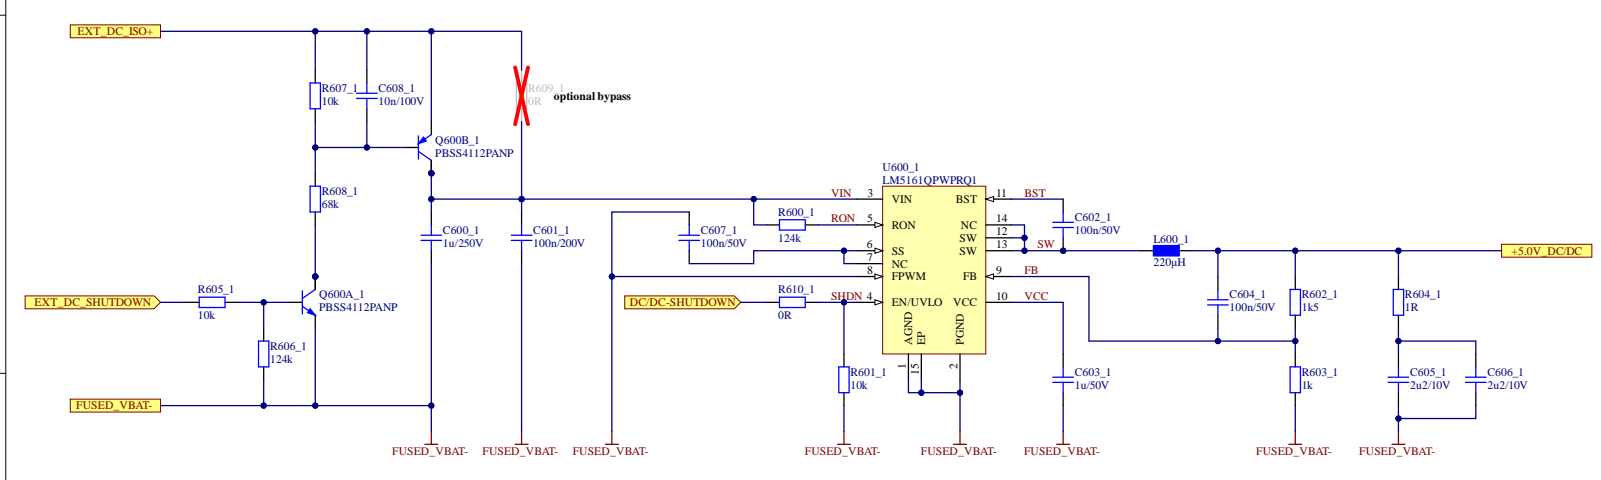
[picture p28: page 20]

RON 5

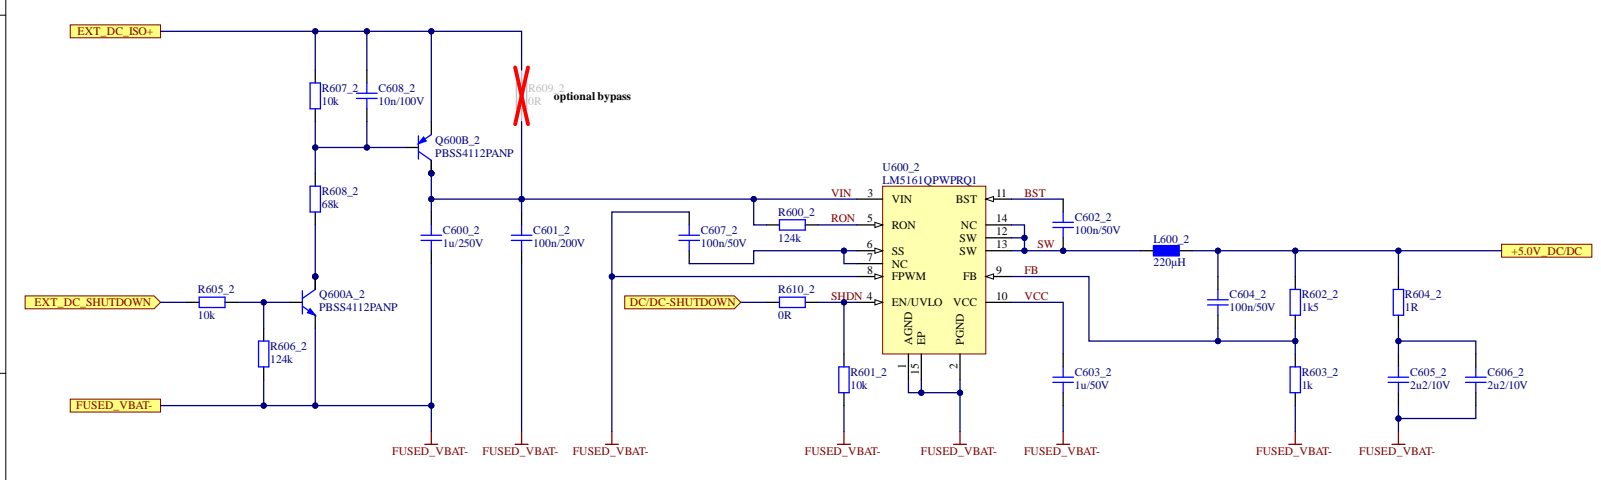
[picture p29: page 21]
