emiln2002/BMS/Slave-18-cell/Assembly automotive_single-AFE/pdf/placement-plan.PDF

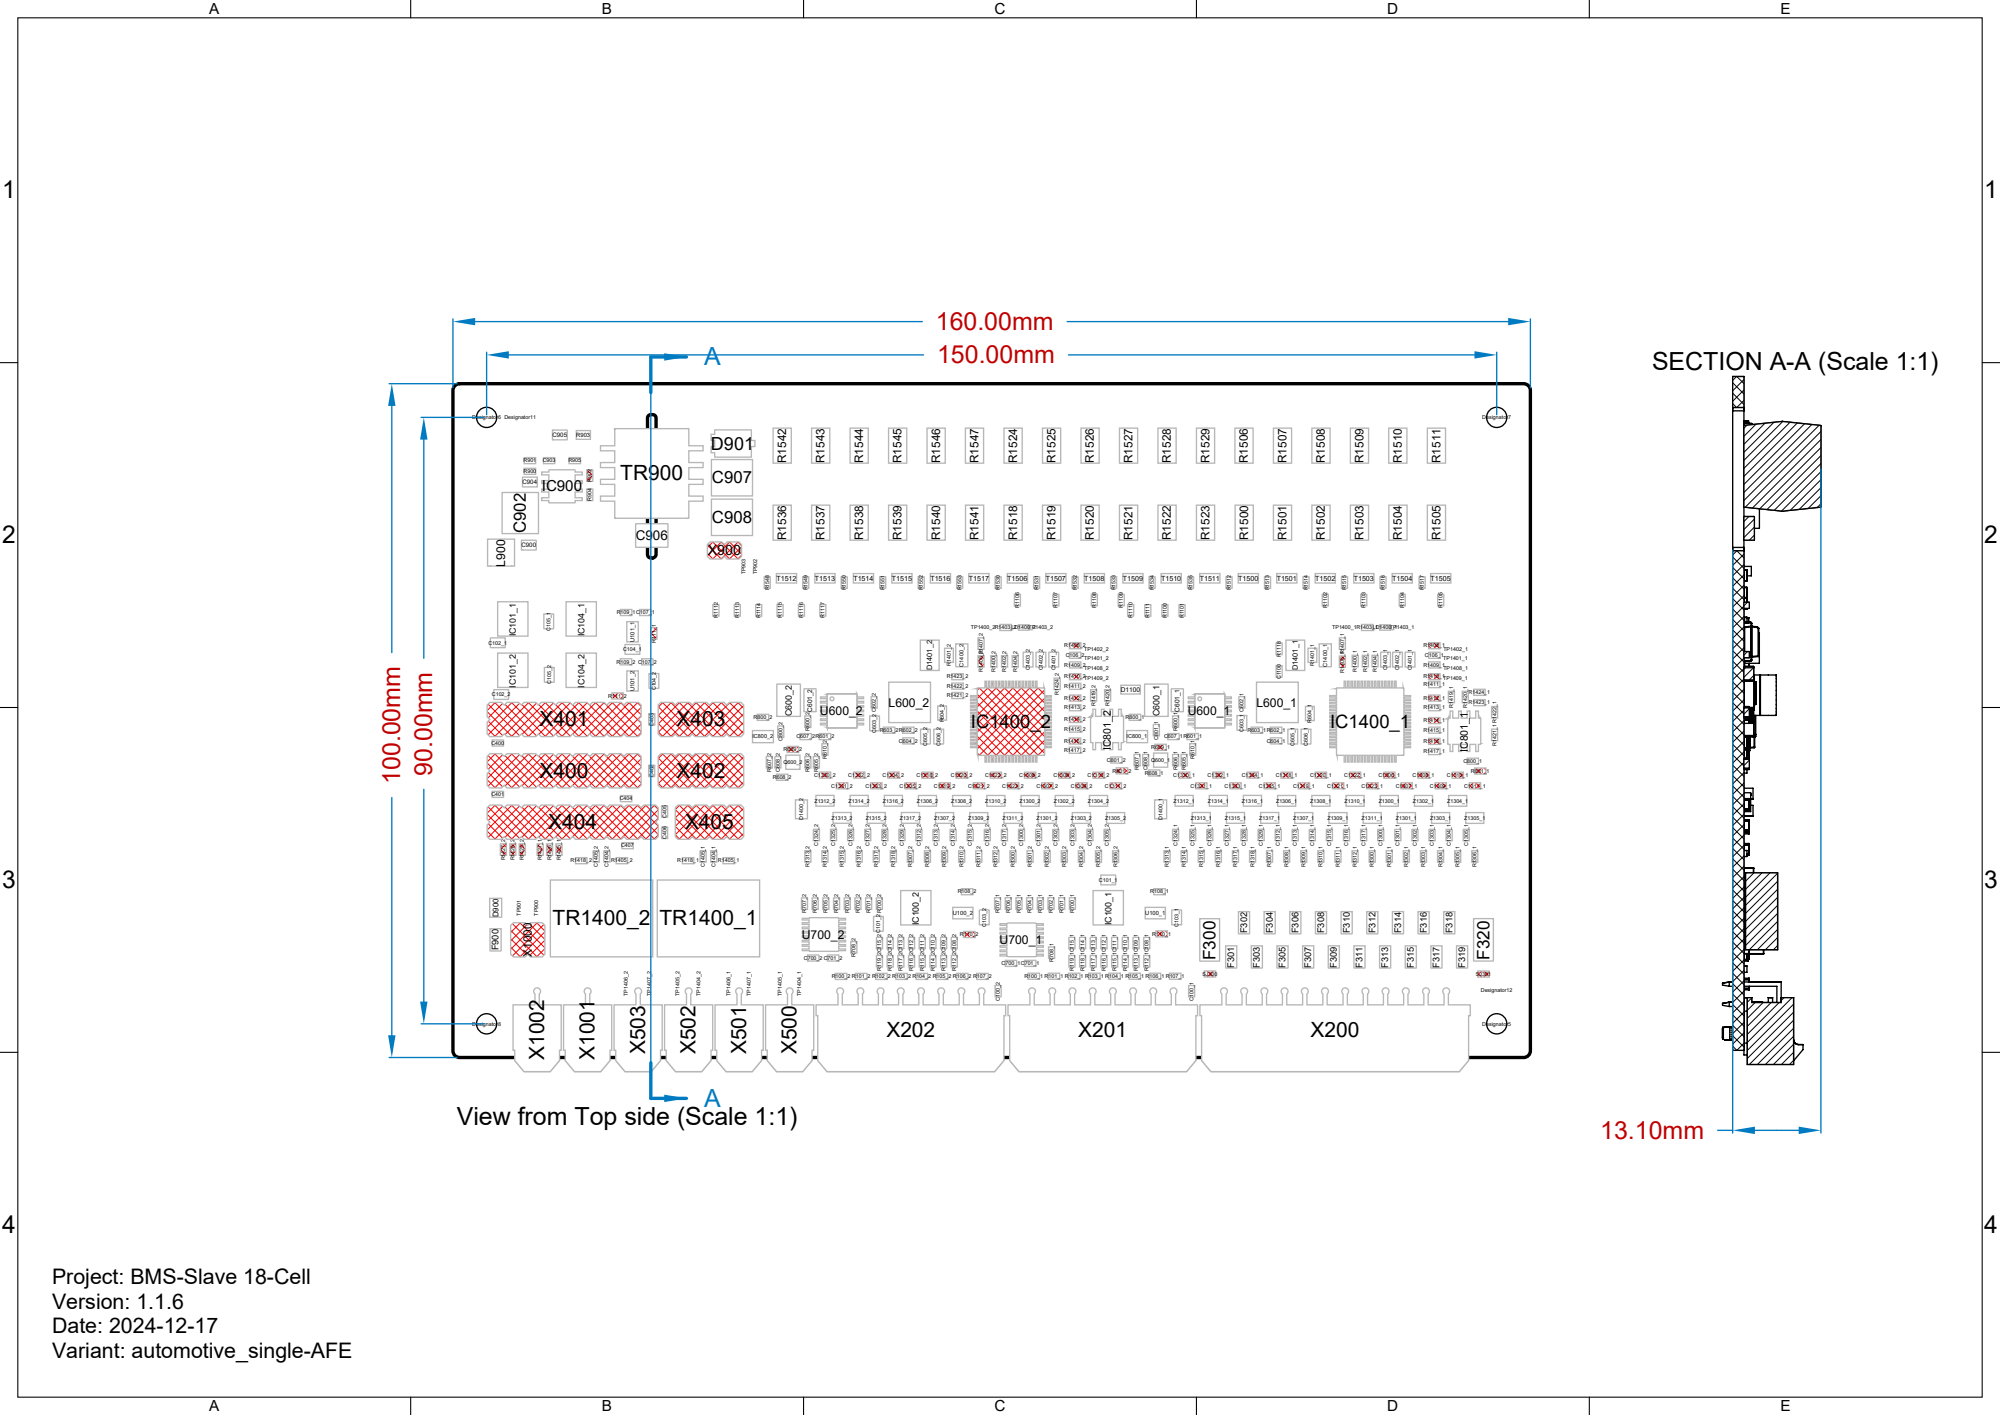
[picture p30: page 1]

View from Top side (Scale 1:1)

Project: BMS-Slave 18-Cell
Version: 1.1.6
Date: 2024-12-17
Variant: automotive_single-AFE

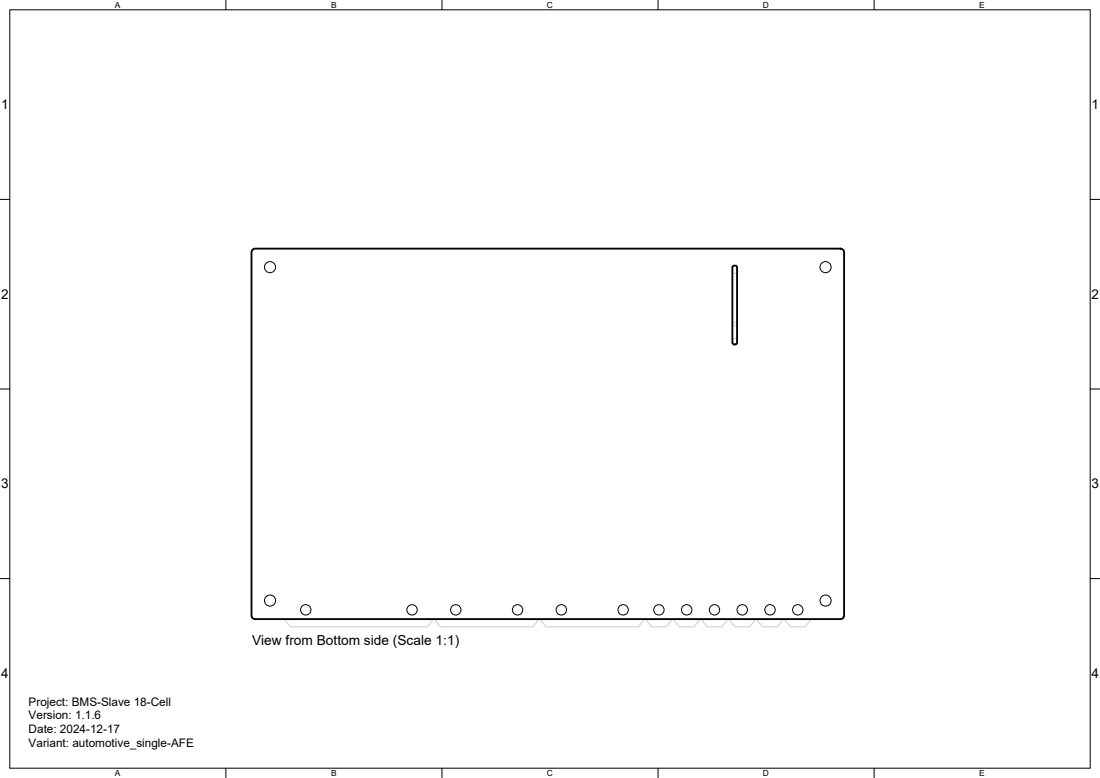
[picture p31: page 2]

View from Bottom side (Scale 1:1)

Project: BMS-Slave 18-Cell
Version: 1.1.6
Date: 2024-12-17
Variant: automotive_single-AFE
