emiln2002/BMS/Slave-18-cell/Fabrication/pdf/board-stack.PDF

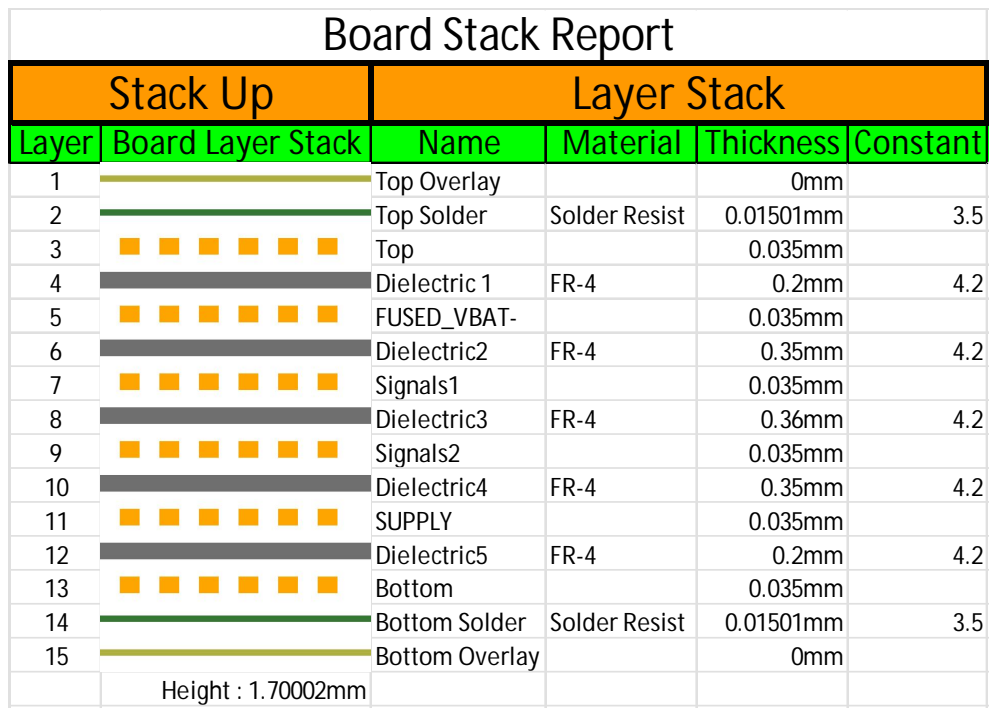
[picture p34: page 1]

Layer | Board Layer Stack | Name | Material | Thickness | Constant
1 | | Top Overlay | | 0mm
2 | | Top Solder | Solder Resist | 0.01501mm | 3.5
3 | | Top | | 0.035mm
4 | | Dielectric 1 | FR-4 | 0.2mm | 4.2
5 | | FUSED_VBAT- | | 0.035mm
6 | | Dielectric2 | FR-4 | 0.35mm | 4.2
7 | | Signals1 | | 0.035mm
8 | | Dielectric3 | FR-4 | 0.36mm | 4.2
9 | | Signals2 | | 0.035mm
10 | | Dielectric4 | FR-4 | 0.35mm | 4.2
11 | | SUPPLY | | 0.035mm
12 | | Dielectric5 | FR-4 | 0.2mm | 4.2
13 | | Bottom | | 0.035mm
14 | | Bottom Solder | Solder Resist | 0.01501mm | 3.5
15 | | Bottom Overlay | | 0mm

Height : 1.70002mm
