emiln2002/BMS/master-v1.2.3-0/Sources/Project Outputs for foxbms2-master/pdf/foxbms2-master-dimensions-mechanical-v1.2.3-0.PDF

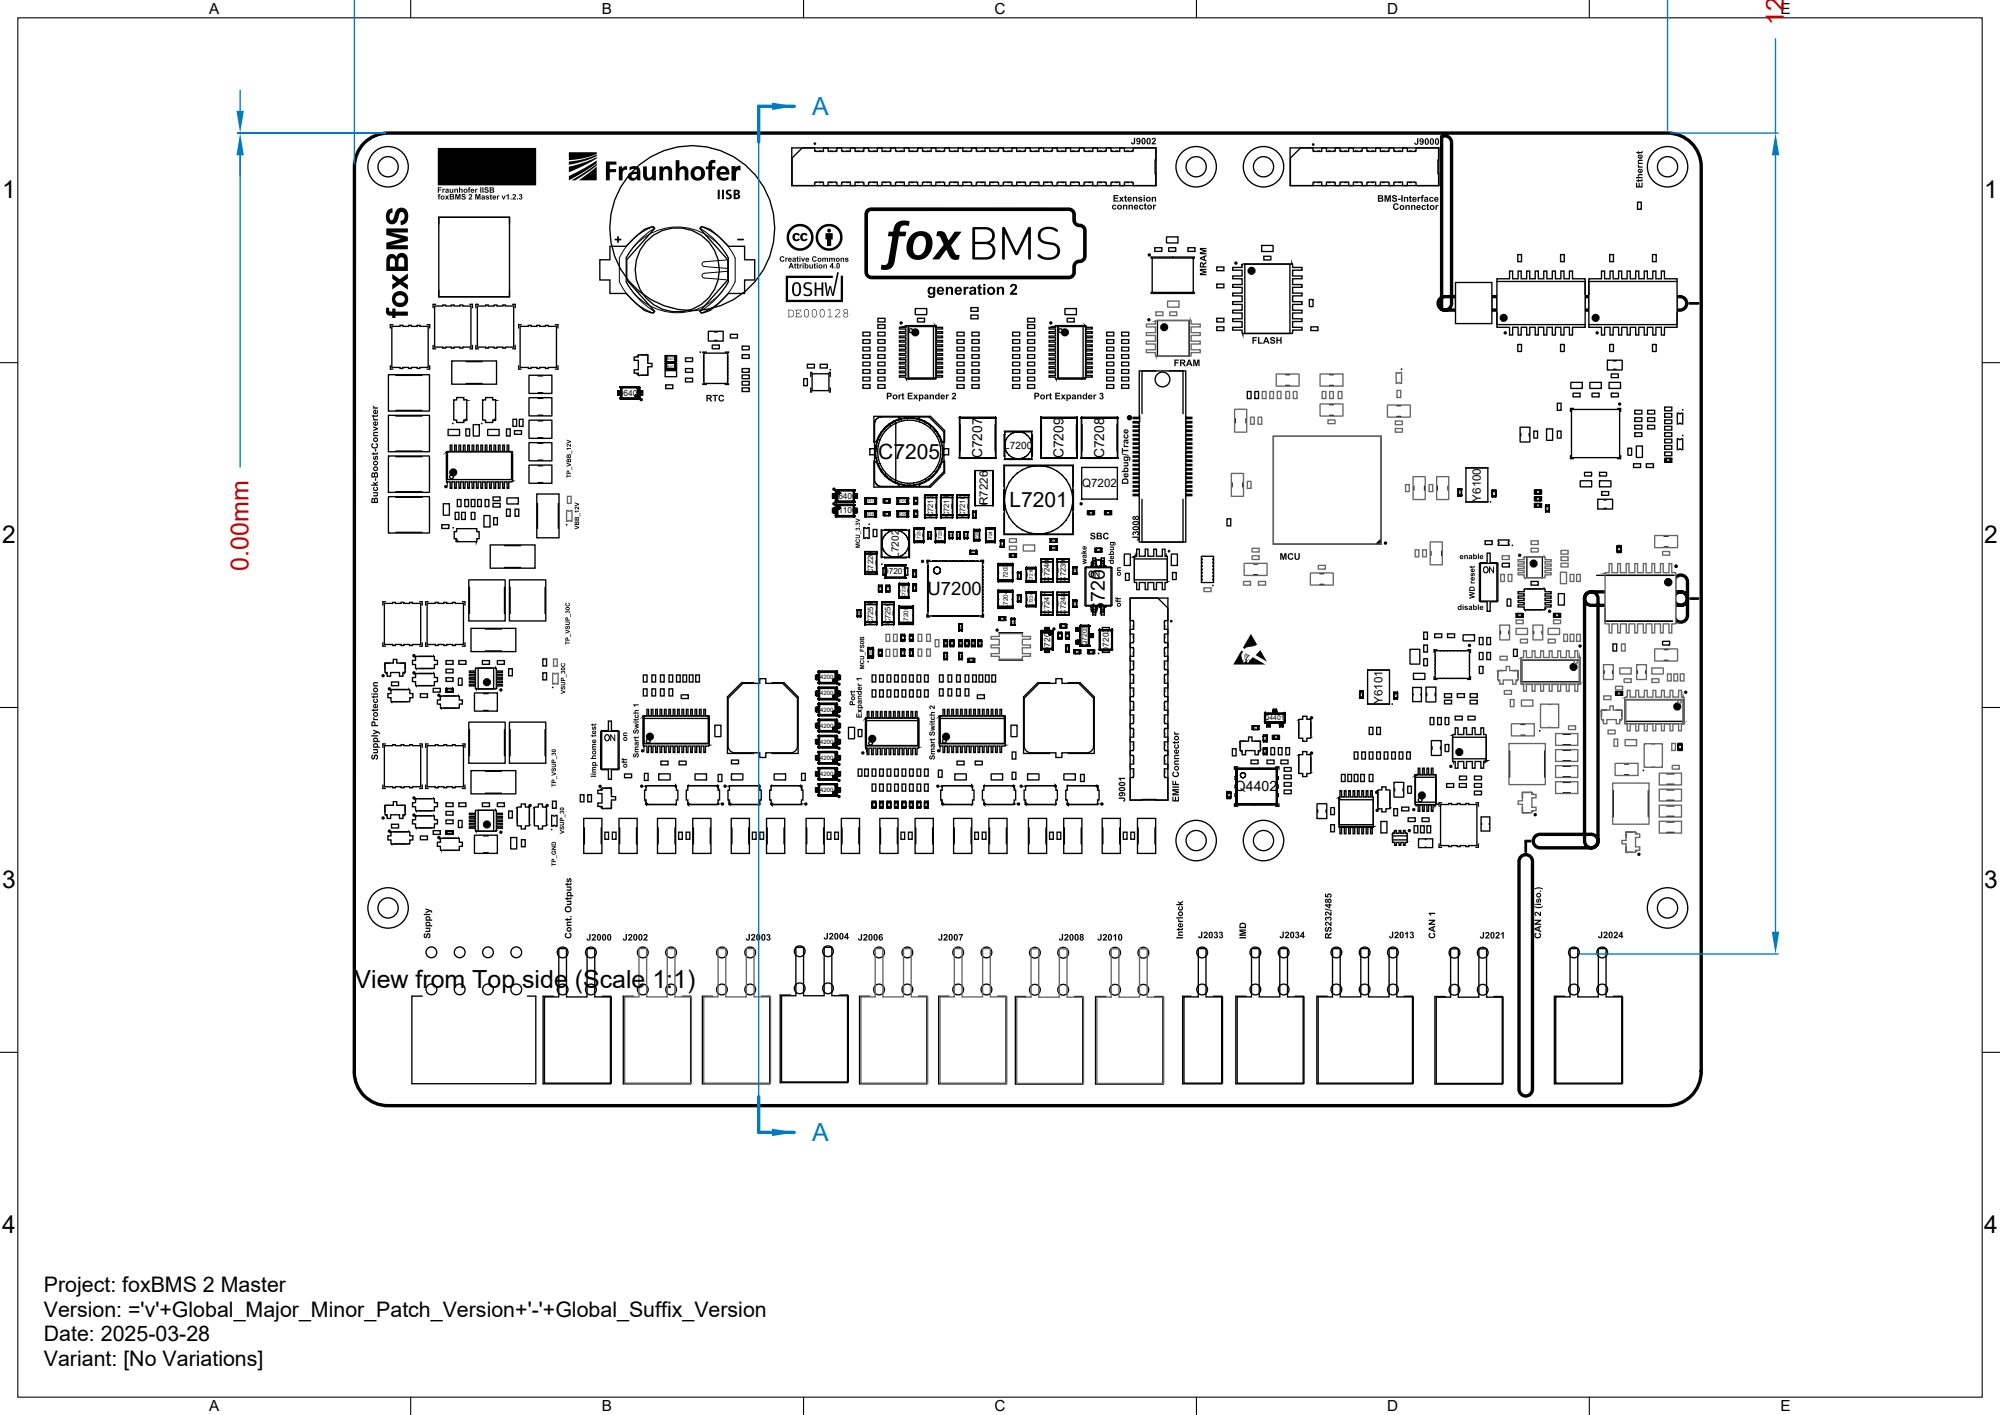
[picture p44: page 1]

View from Top side (Scale 1:1)

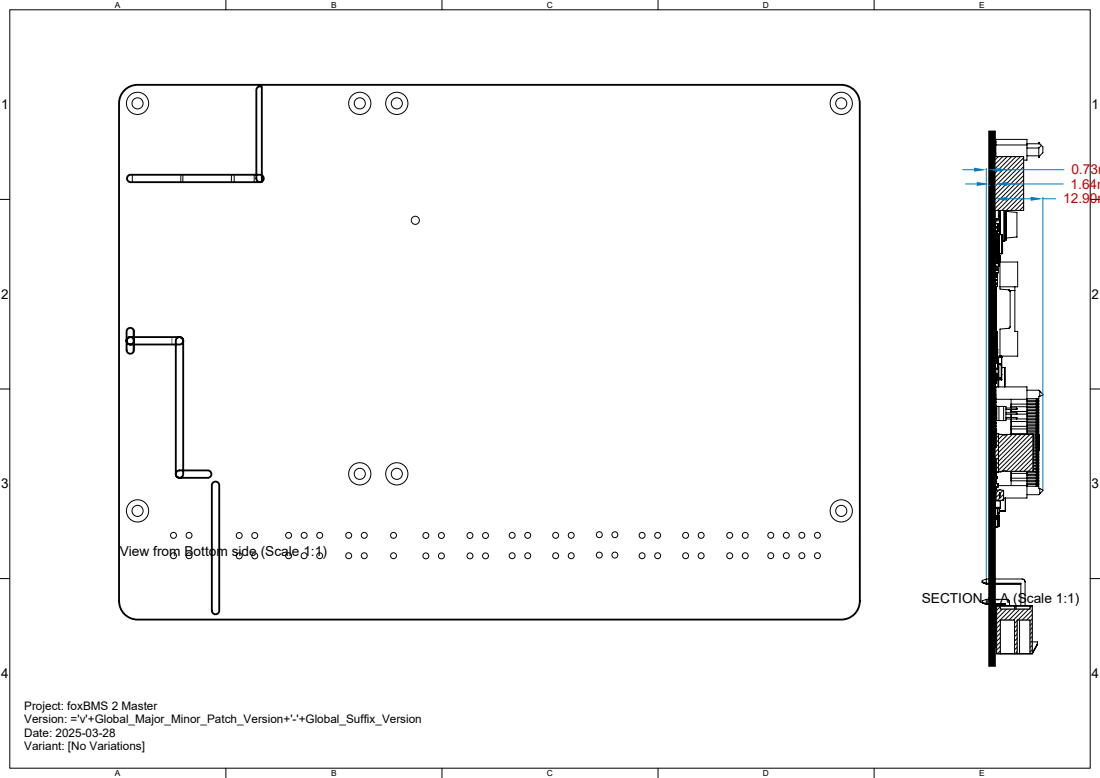
[picture p45: page 2]

View from Bottom side (Scale 1:1)
