emiln2002/BMS/master-v1.2.3-0/Sources/Project Outputs for foxbms2-master/pdf/foxbms2-master-placement-plan-v1.2.3-0.PDF

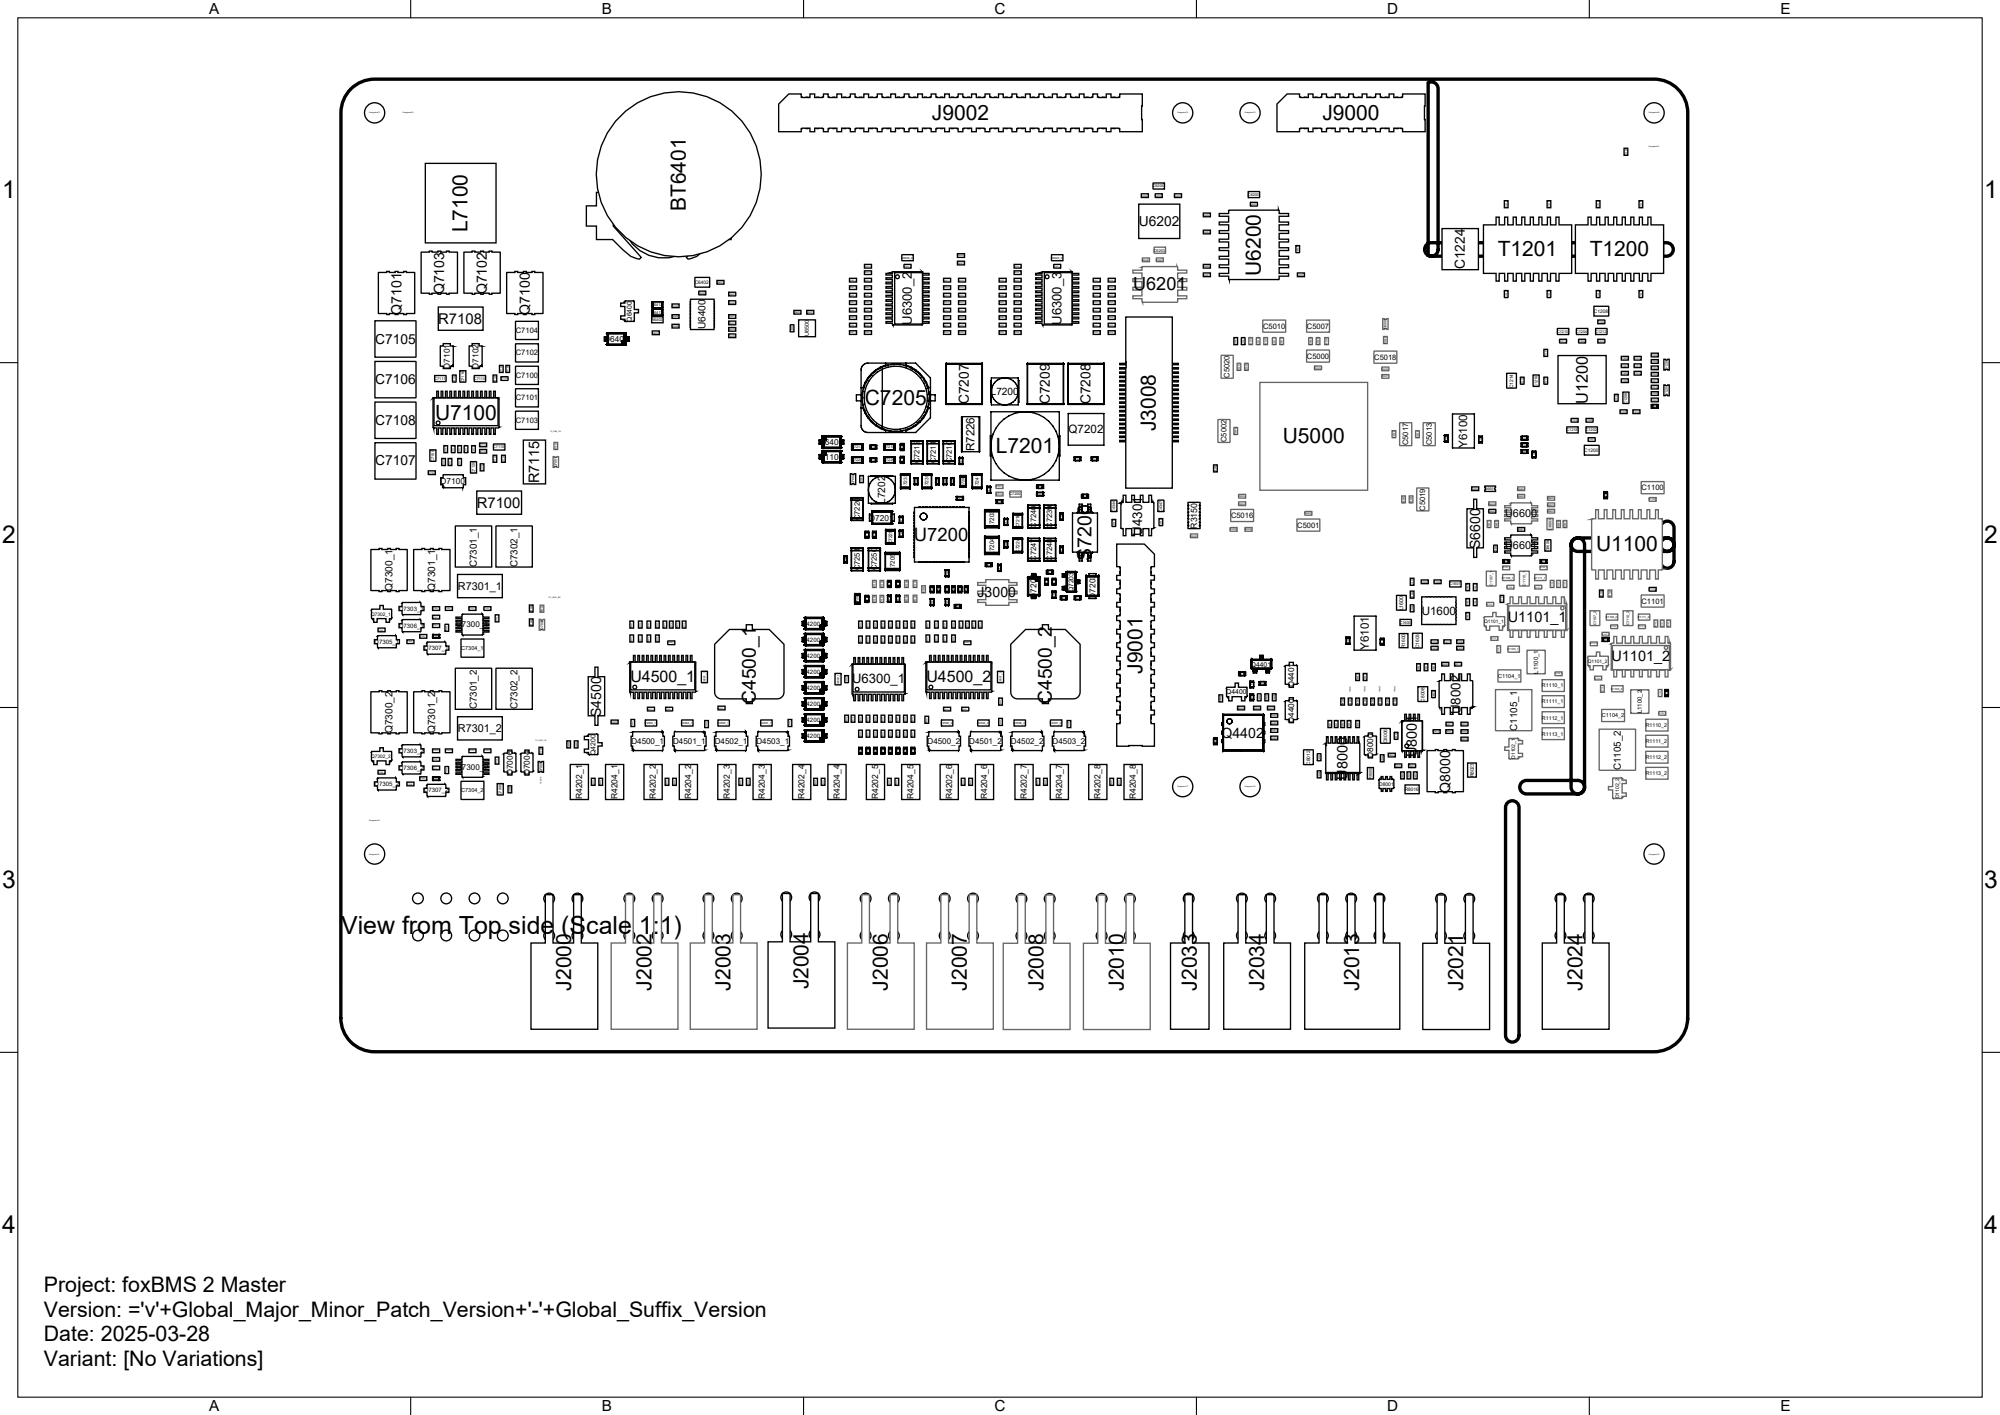
[picture p46: page 1]

View from Top side (Scale 1:1)

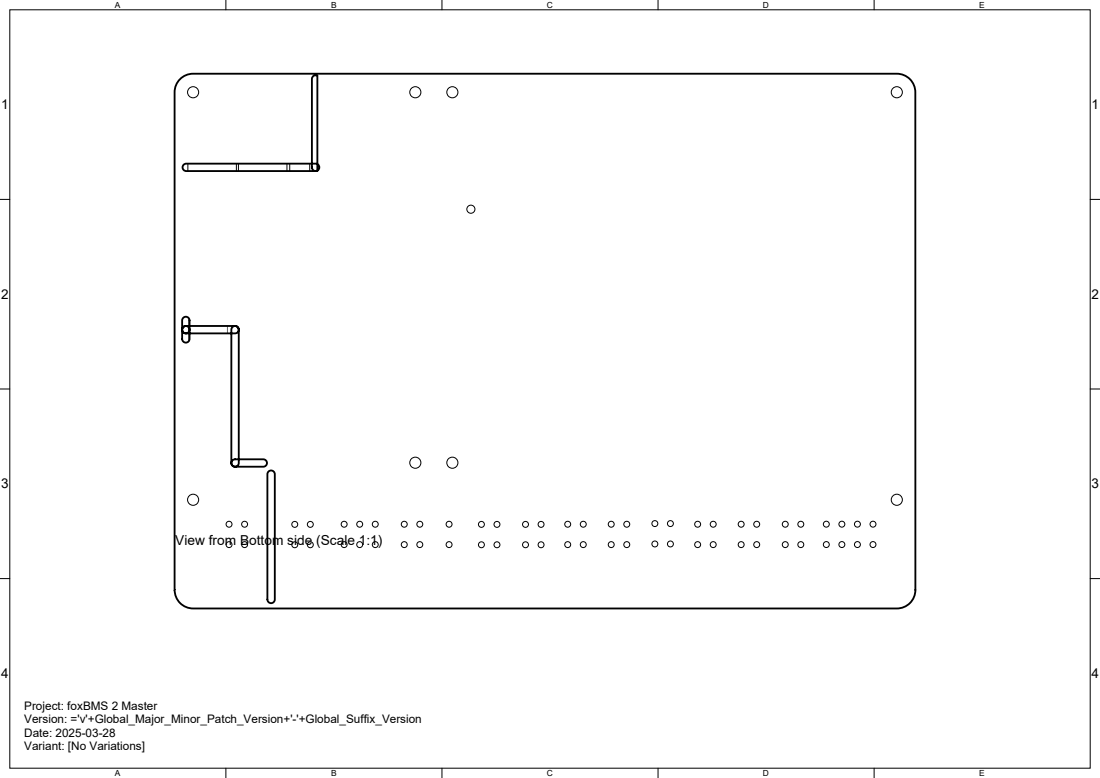
[picture p47: page 2]

View from Bottom side (Scale 1:1)
