emiln2002/BMS/slave_v2/Assembly foxBMS_14cell_BMS-Slave_NXP775A/pdf/schematics.PDF

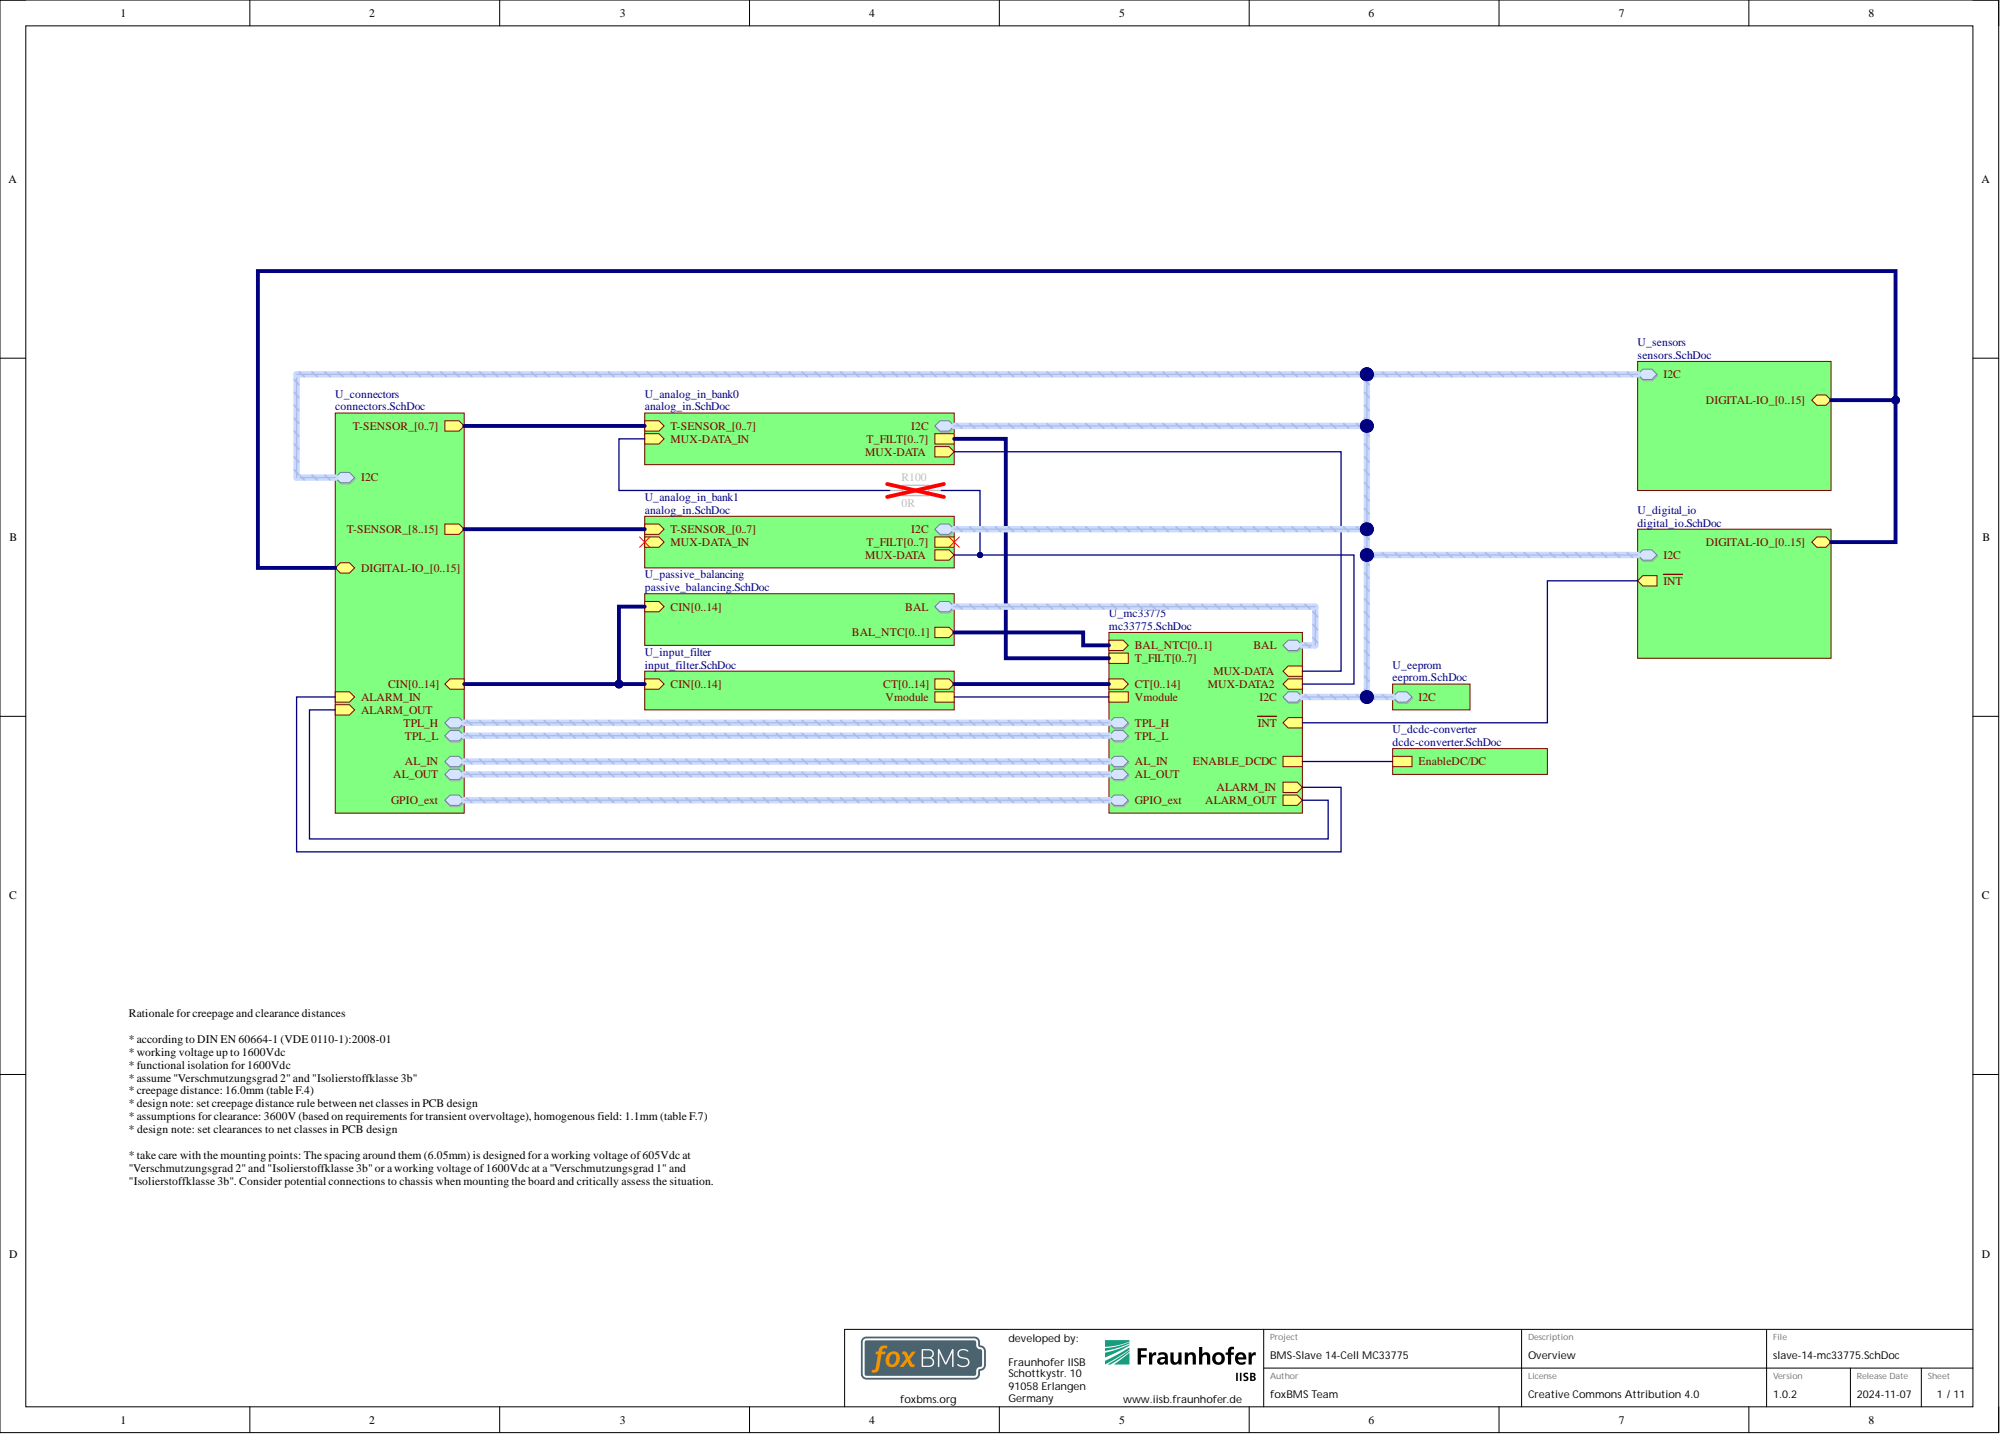
[picture p48: page 1]

U_mc33775 mc33775.SchDoc

U_input_filter input_filter.SchDoc

BAL_NTC[0..1] BAL MUX-DATA

U_eeprom

CT[0..14] | CT[0..14] MUX-DATA2 | eeprom.SchDoc CIN[0..14]

TPL_H TPL_L AL_OUT ALARM_IN GPIO_ext ALARM_OUT | I2C

Rationale for creepage and clearance distances

* according to DIN EN 60664-1 (VDE 0110-1):2008-01
* working voltage up to 1600Vdc
* functional isolation for 1600Vdc
* assume "Verschmutzungsgrad 2" and "Isolierstoffklasse 3b"
* creepage distance: 16.0mm (table F.4)
* design note:set creepage distance rule between net classes in PCB design
* assumptions for clearance: 3600V (based on requirements for transient overvoltage), homogenous field: 1.1mm (table F.7)
* design note: set clearances to net classes in PCB design

* take care with the mounting points: The spacing around them (6.05mm) is designed for a working voltage of 605Vdc at
"Verschmutzungsgrad 2" and "Isolierstoffklasse 3b" or a working voltage of 1600Vdc at a "Verschmutzungsgrad 1" and
"Isolierstoffklasse 3b". Consider potential connections to chassis when mounting the board and critically assess the situation.

www.iisb.fraunhofer.de

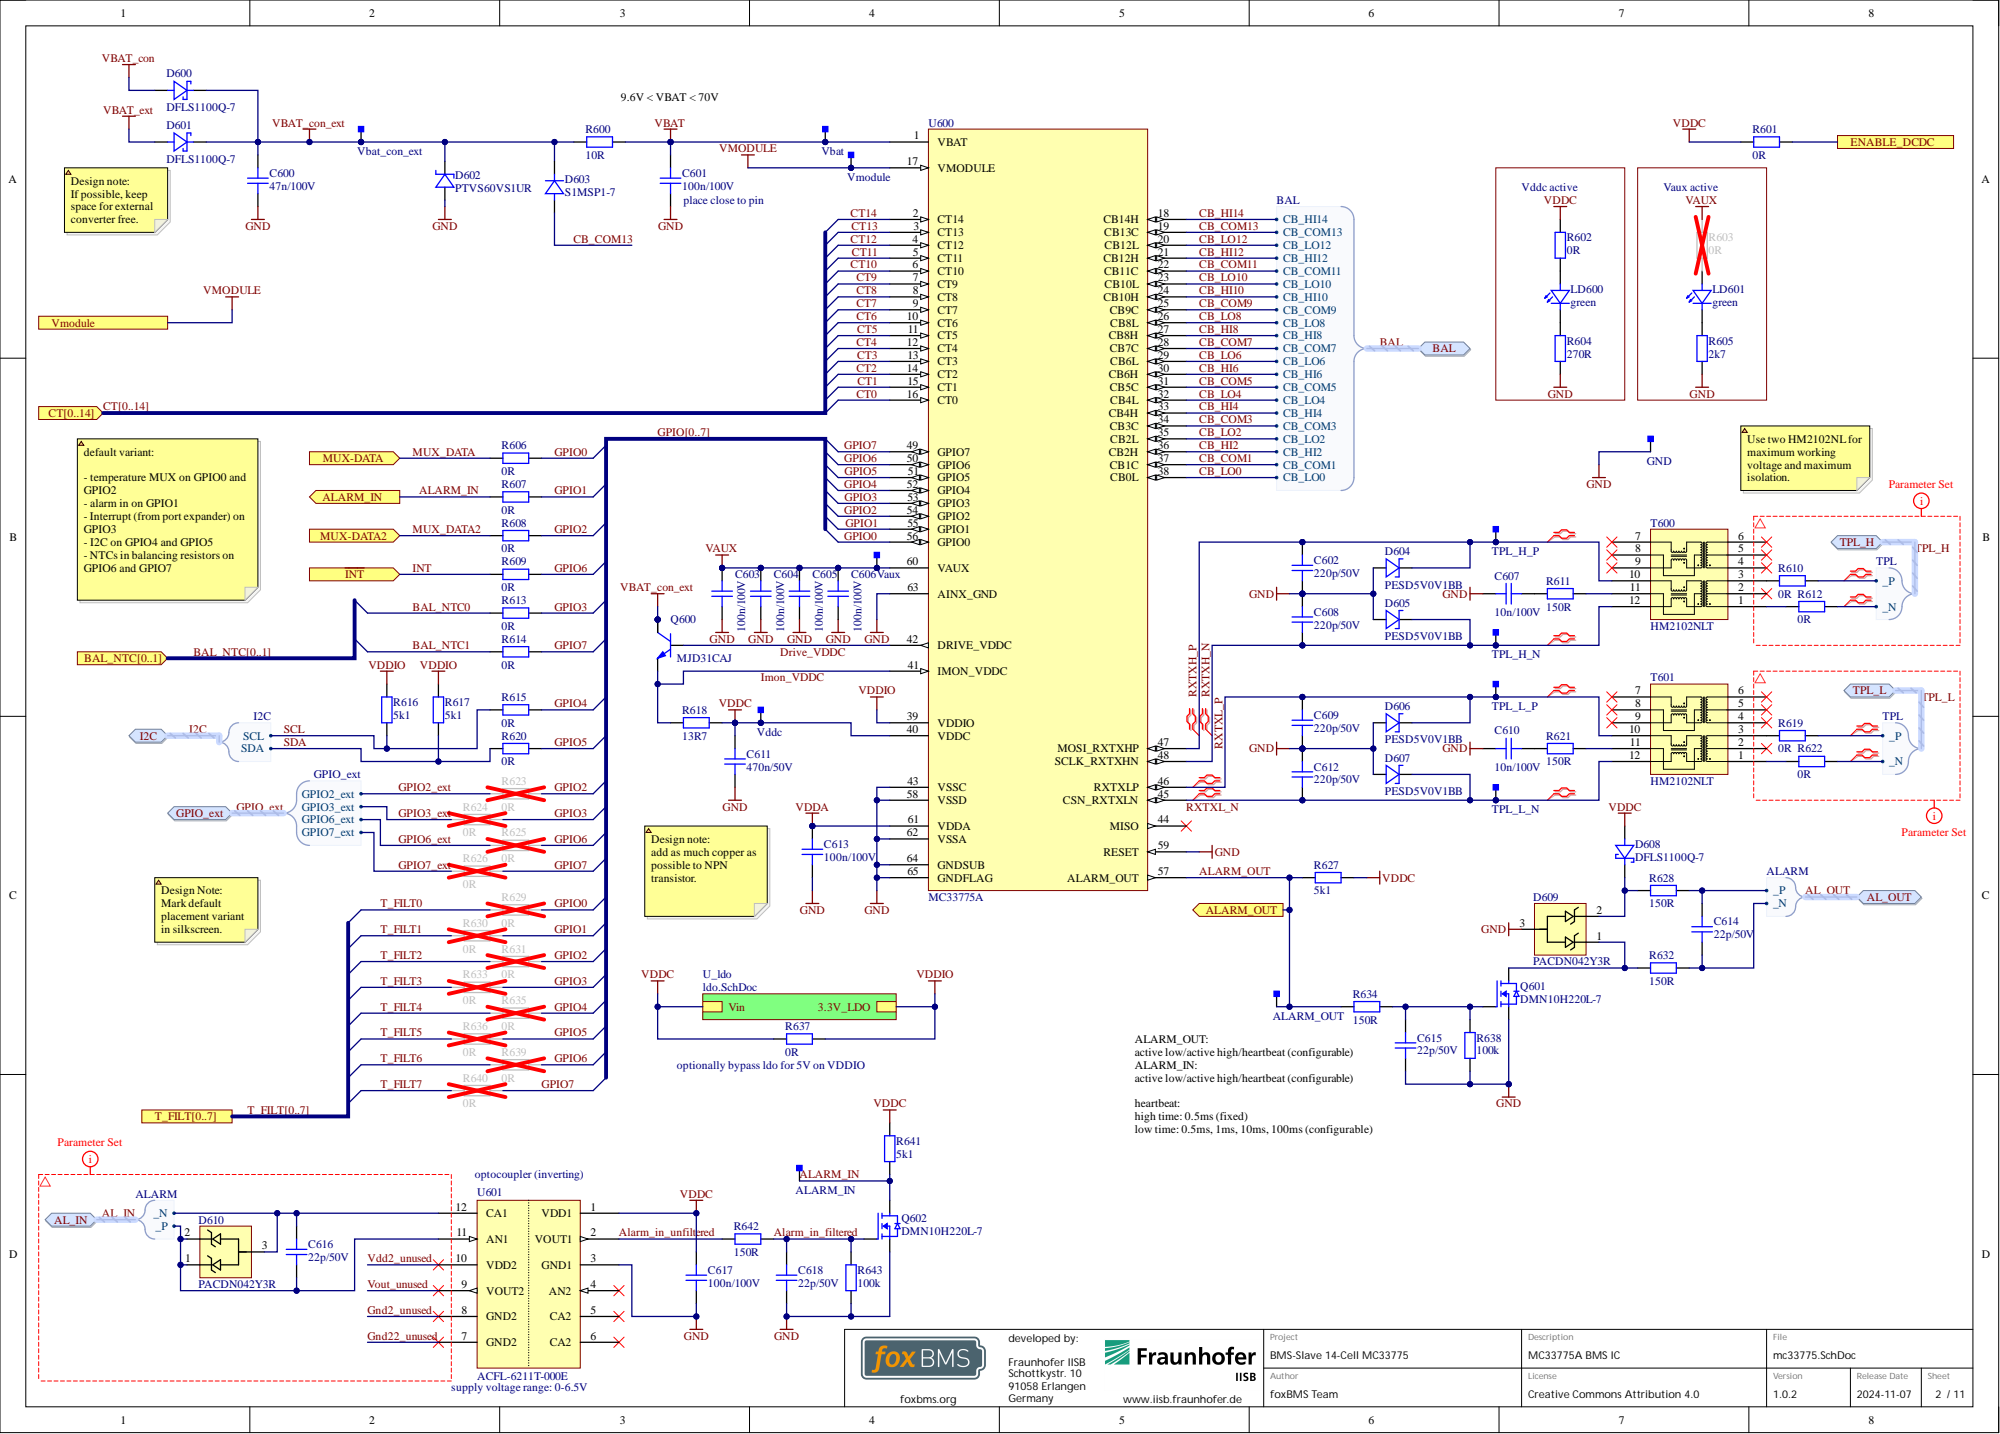
[picture p49: page 2]

- temperature MUX on GPIO0 and
GPIO2
- alarm in on GPIO1
- Interrupt (from port expander) on
GPIO3
- I2C on GPIO4 and GPIO5
- NTCsin balancing resistors on
GPIO6 and GPIO7

Imon_VDDC | | | VDDIO 39

VDDC | VDDIO

VSSD 58

VDDA 61
VSSA 62

Design note:
add as much copper as
possible to NPN
transistor.

GNDSUB 64
GNDFLAG 65

ALARM_OUT:
active low/active high/heartbeat (configurable)
ALARM_IN:

optionally bypass ldo for 5V on VDDIO

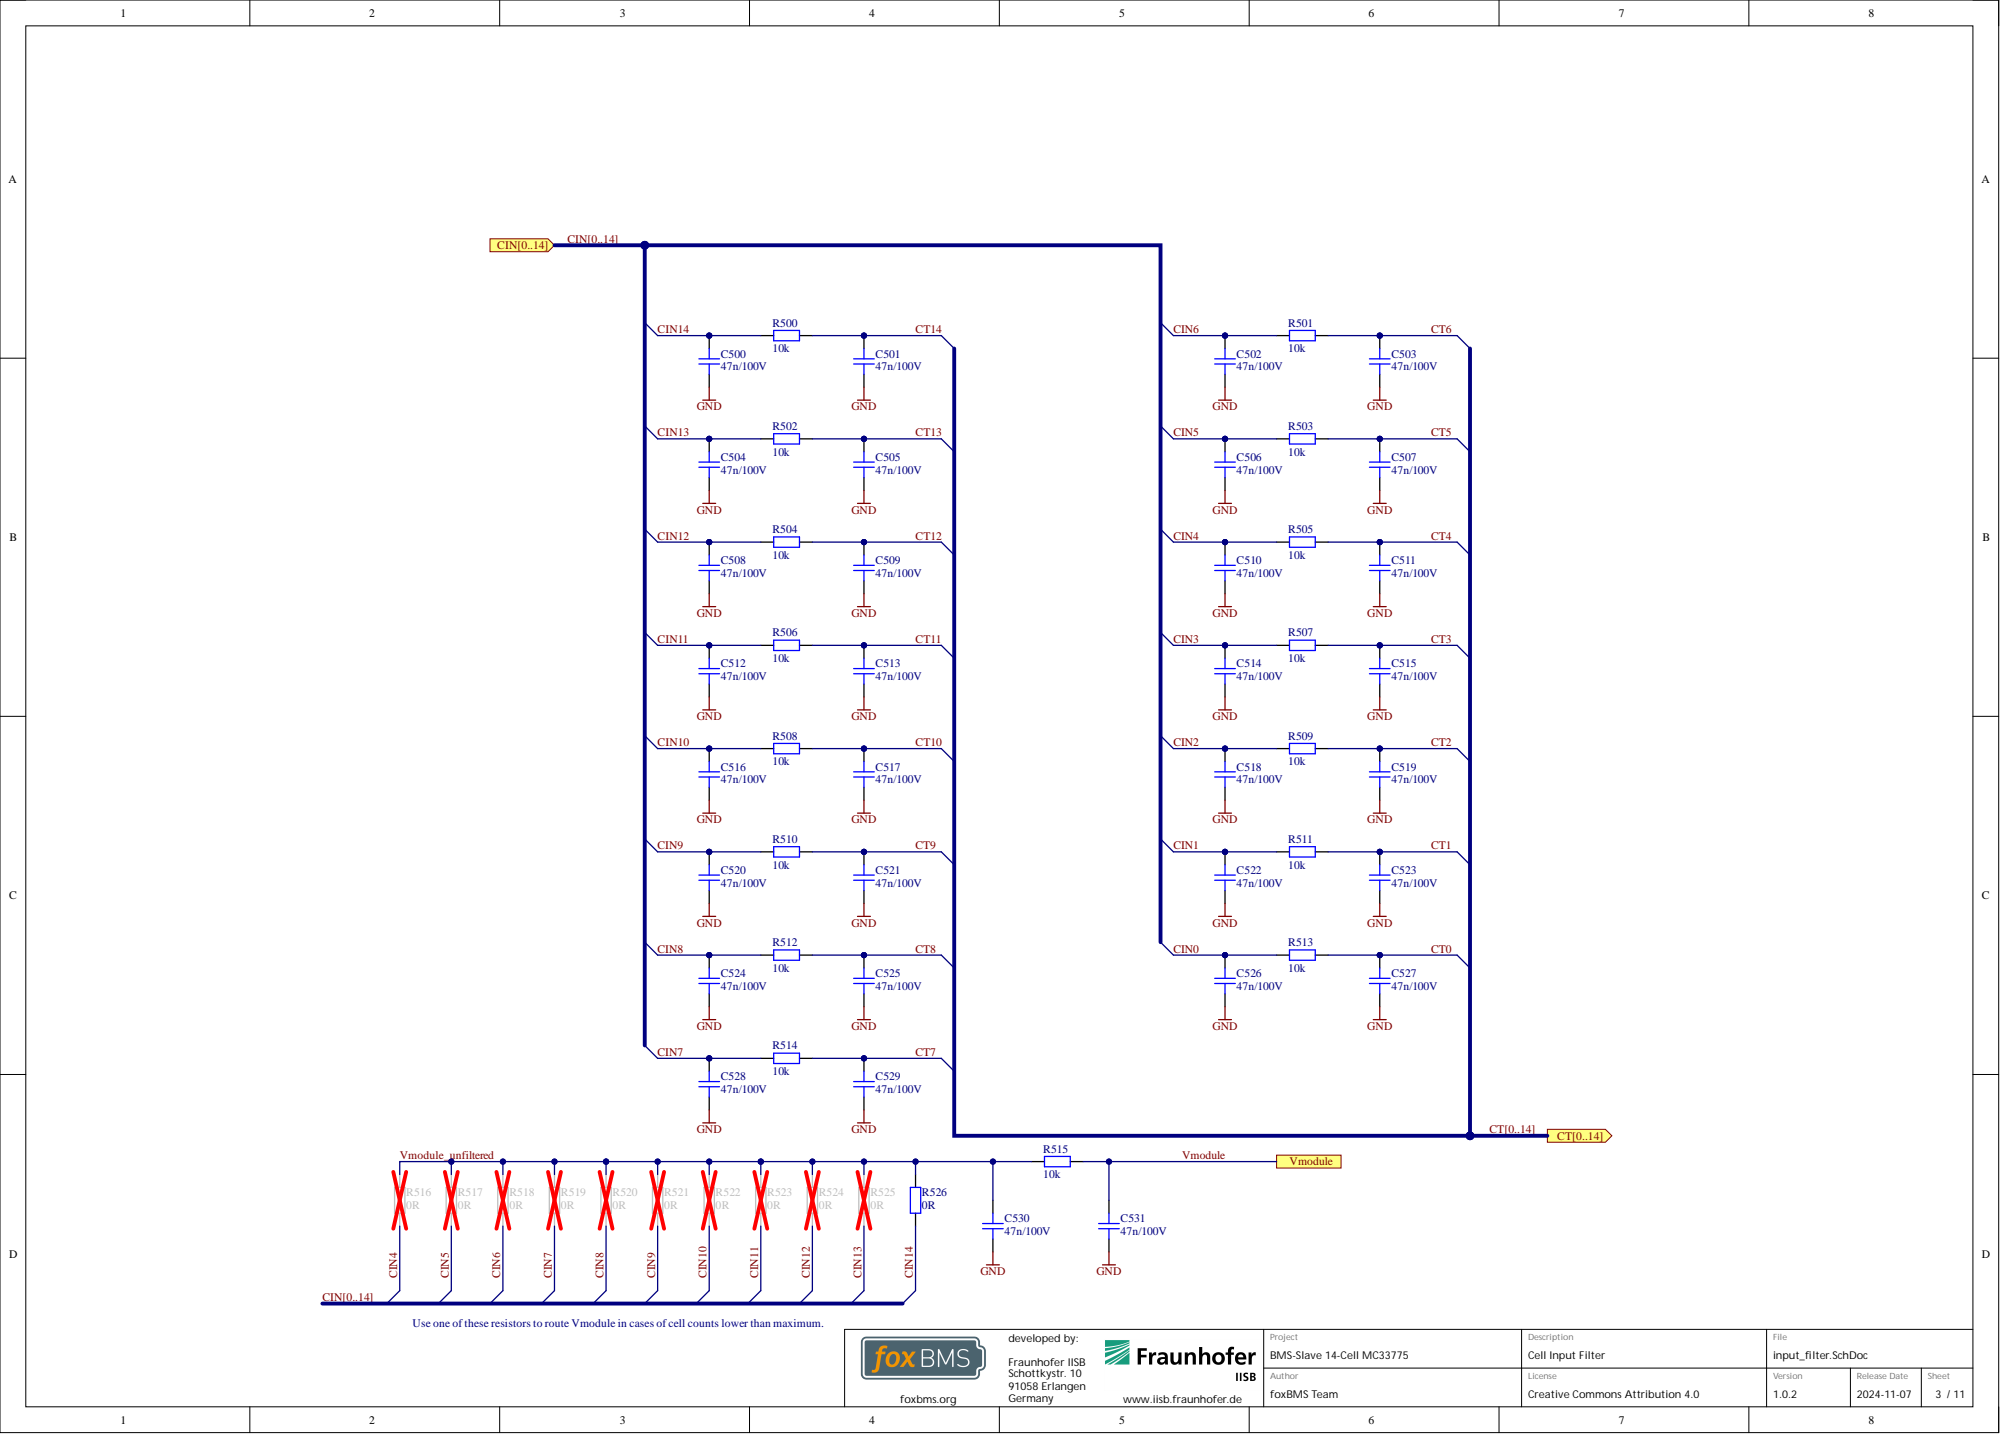
[picture p50: page 3]

Use one of these resistorsto route Vmodule in cases of cell counts lower than maximum.

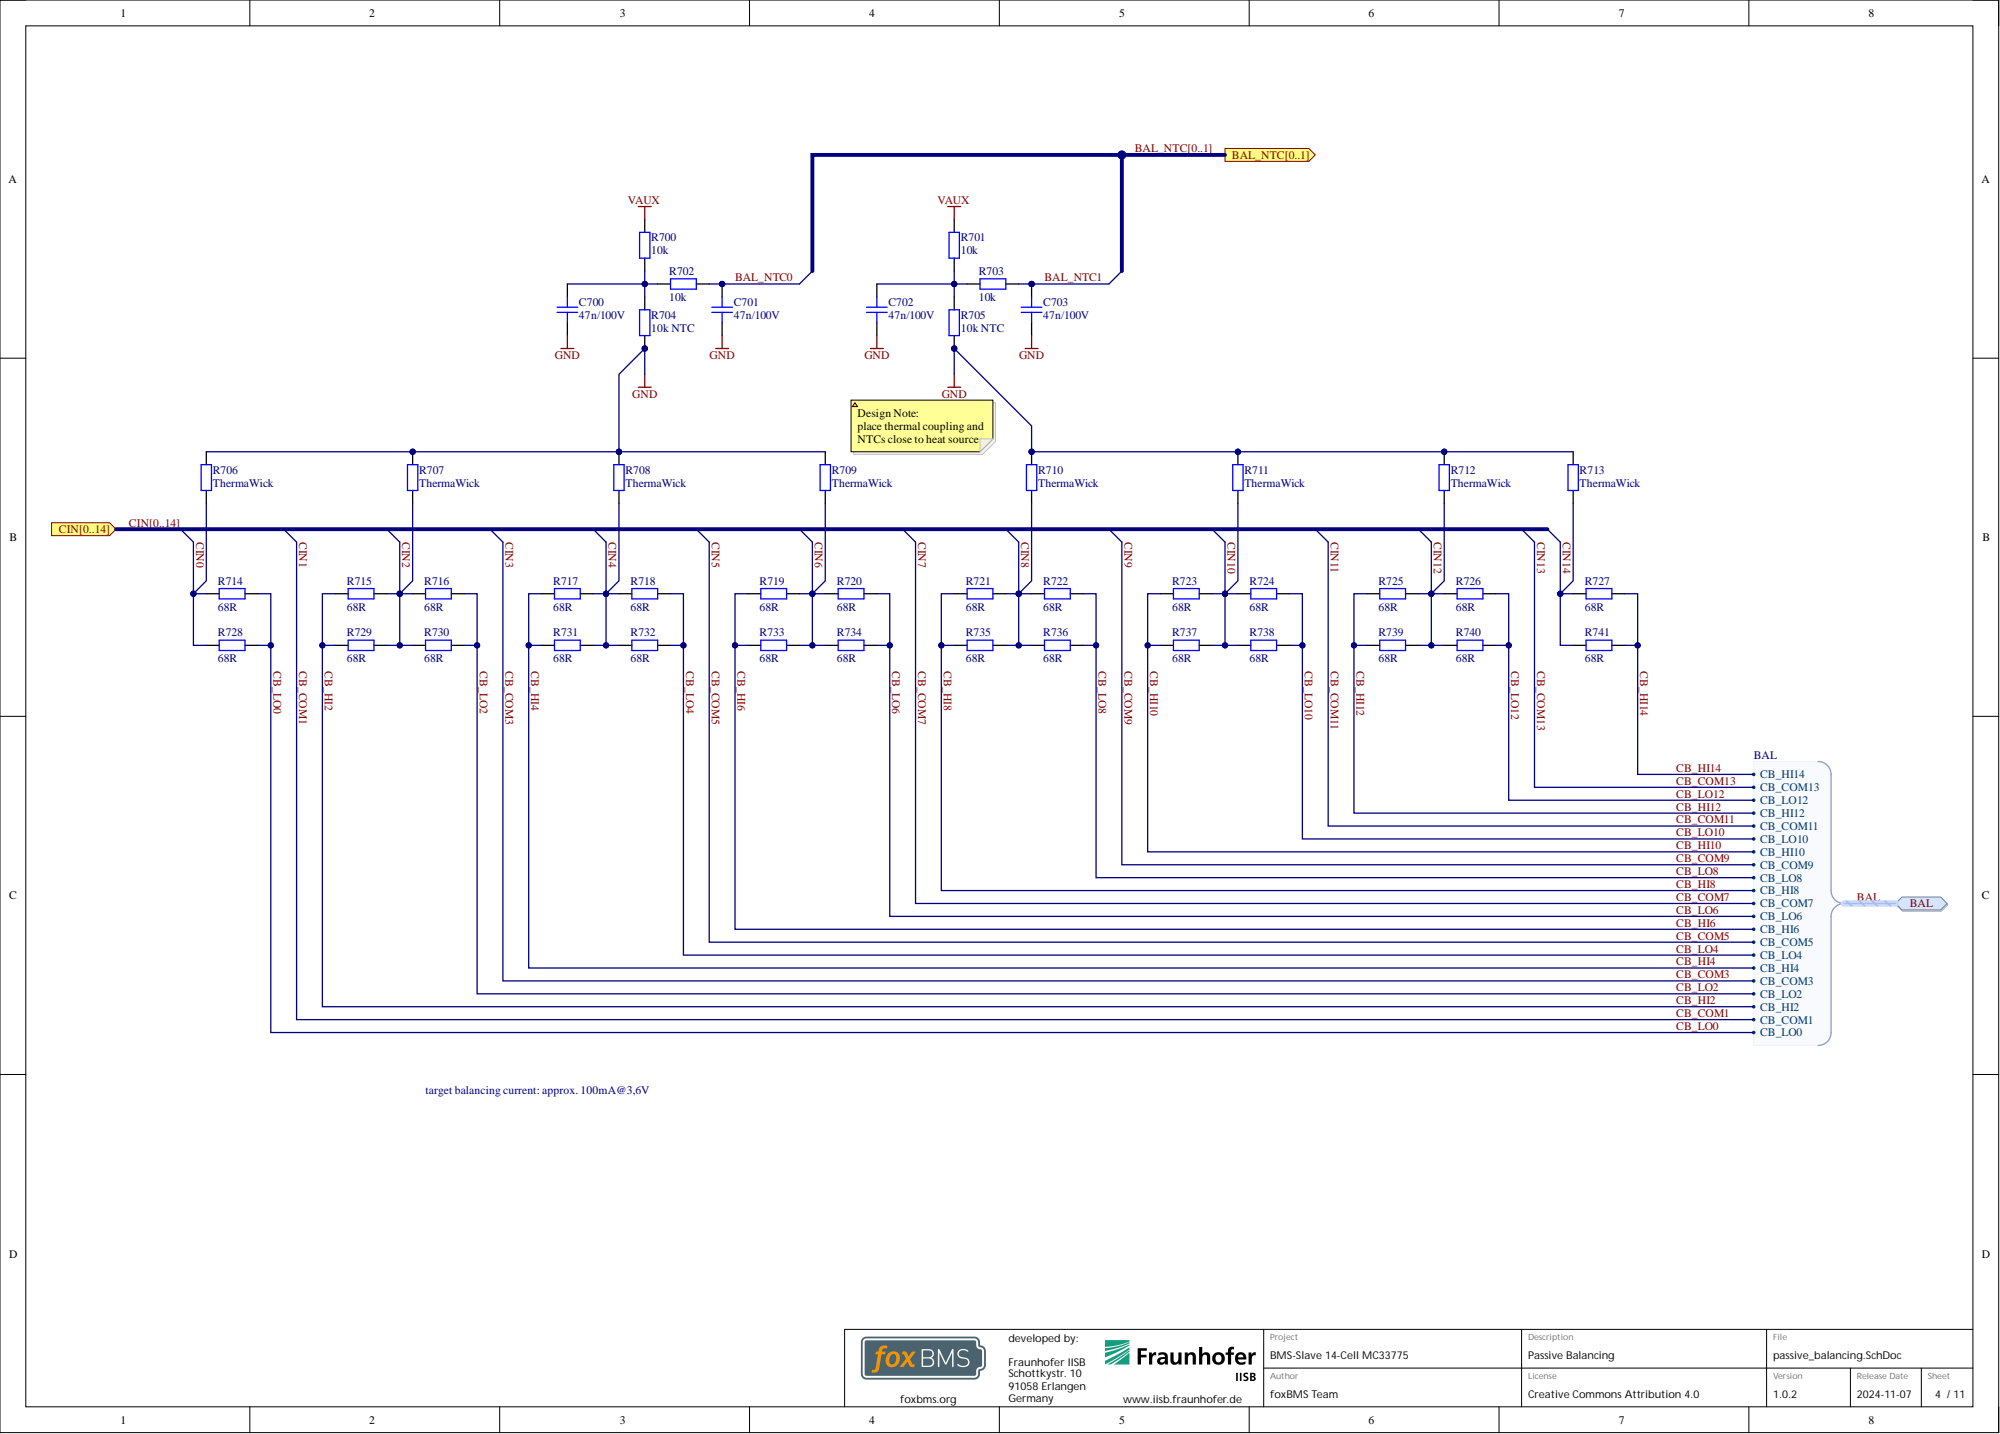
[picture p51: page 4]

Design Note:
place thermal coupling and
NTCs close to heatsource

target balancing current: approx. 100mA@3,6V

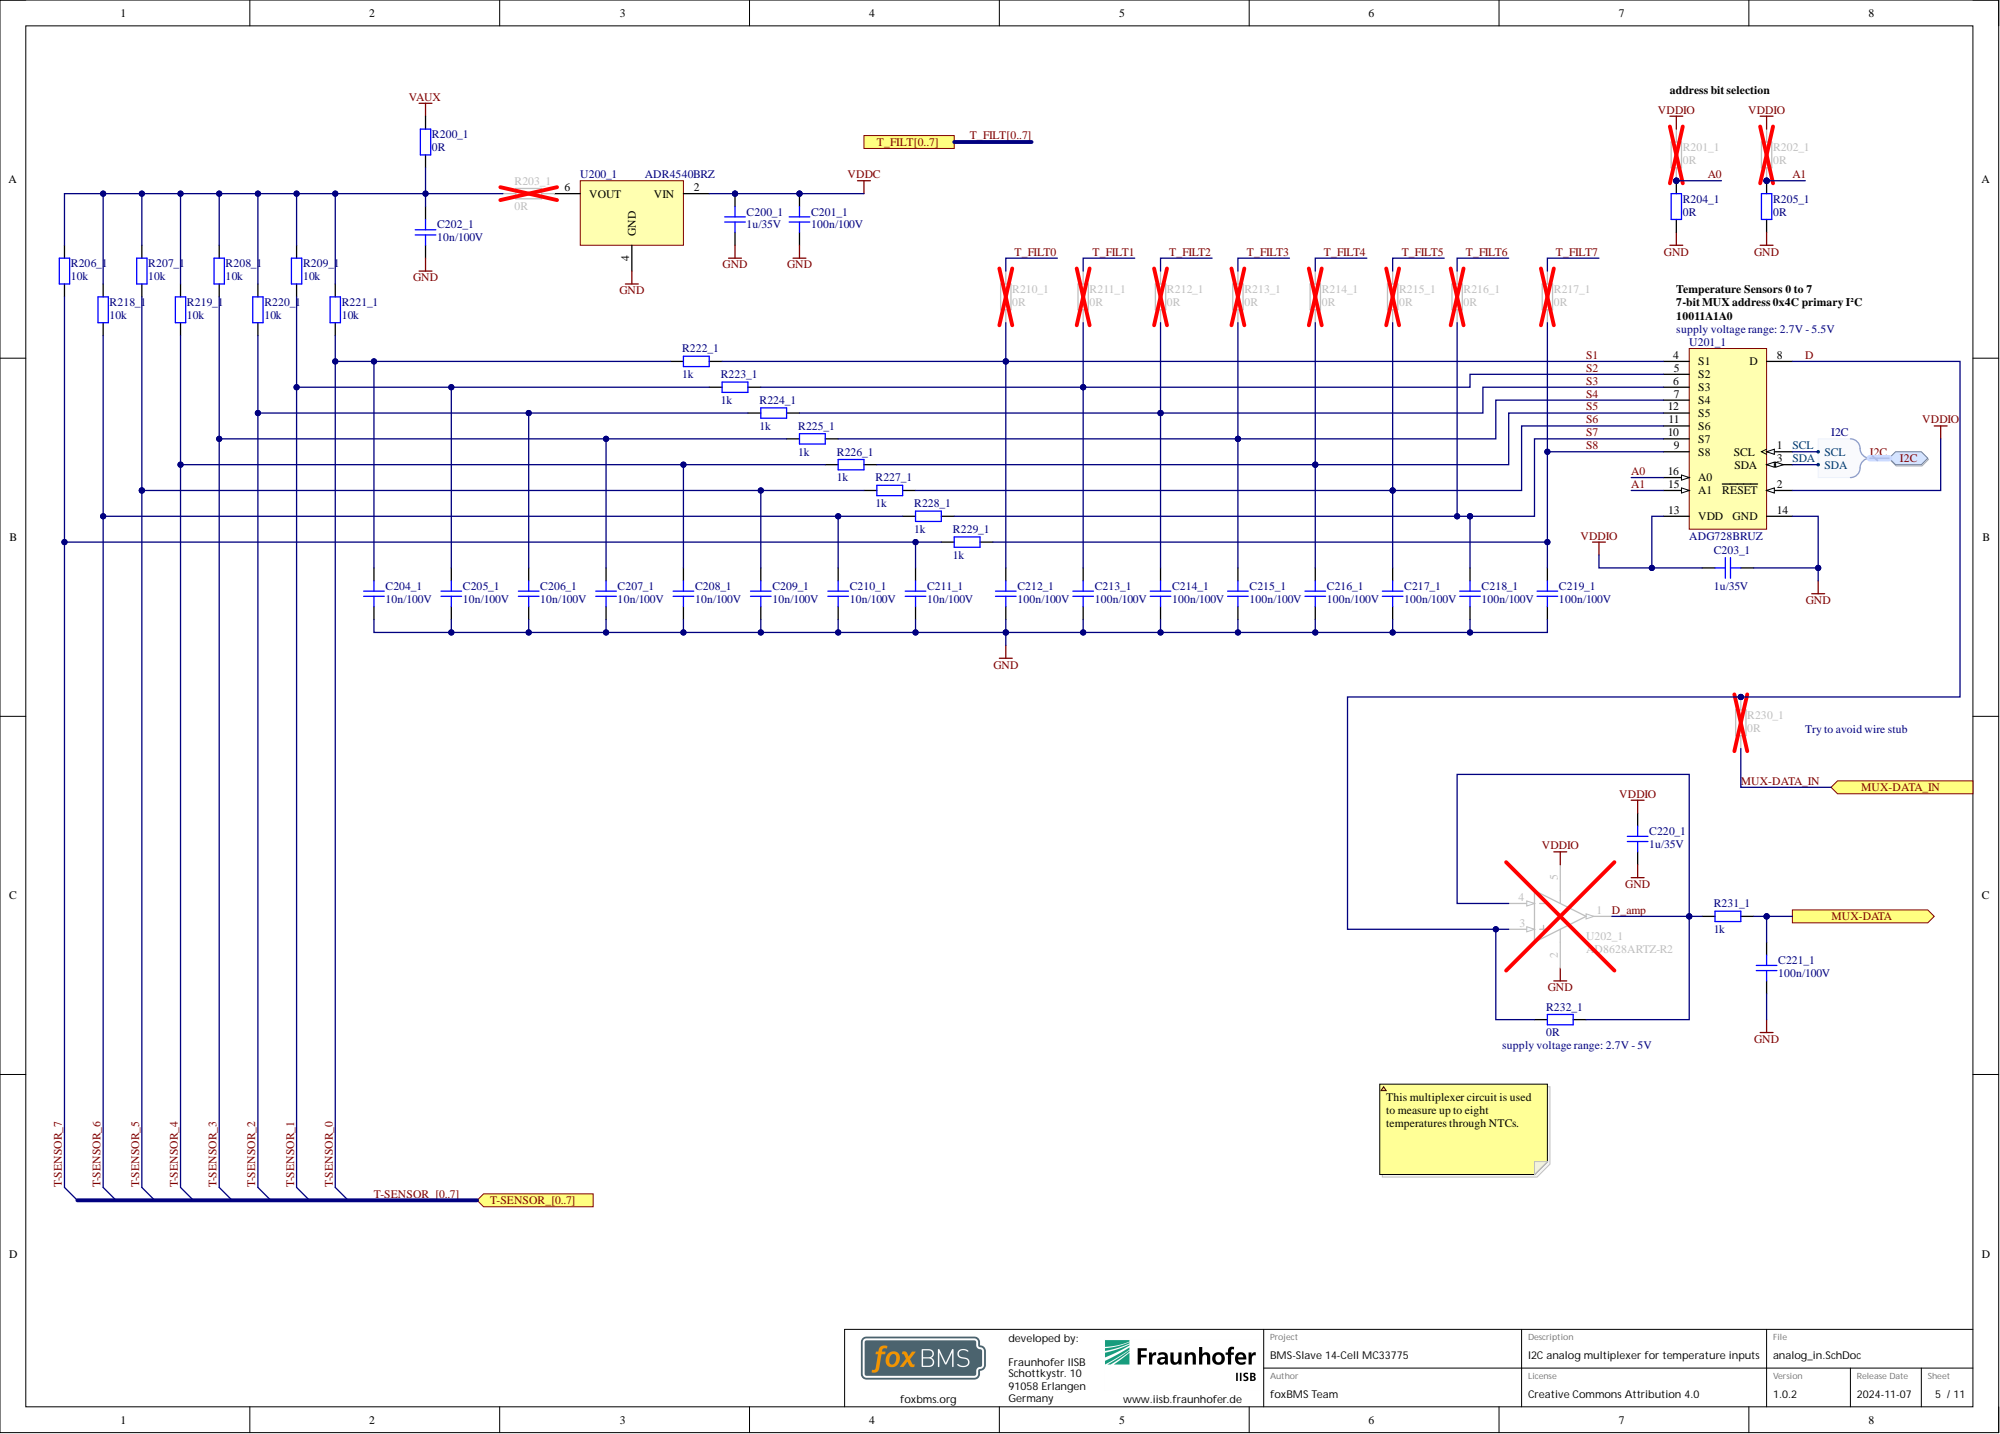
[picture p52: page 5]

S2 | S2 5 | VDDIO
S3 | | S3 6

This multiplexer circuit is used
to measure up to eight
temperaturesthrough NTCs.

I2C analog multiplexer for temperature inputs

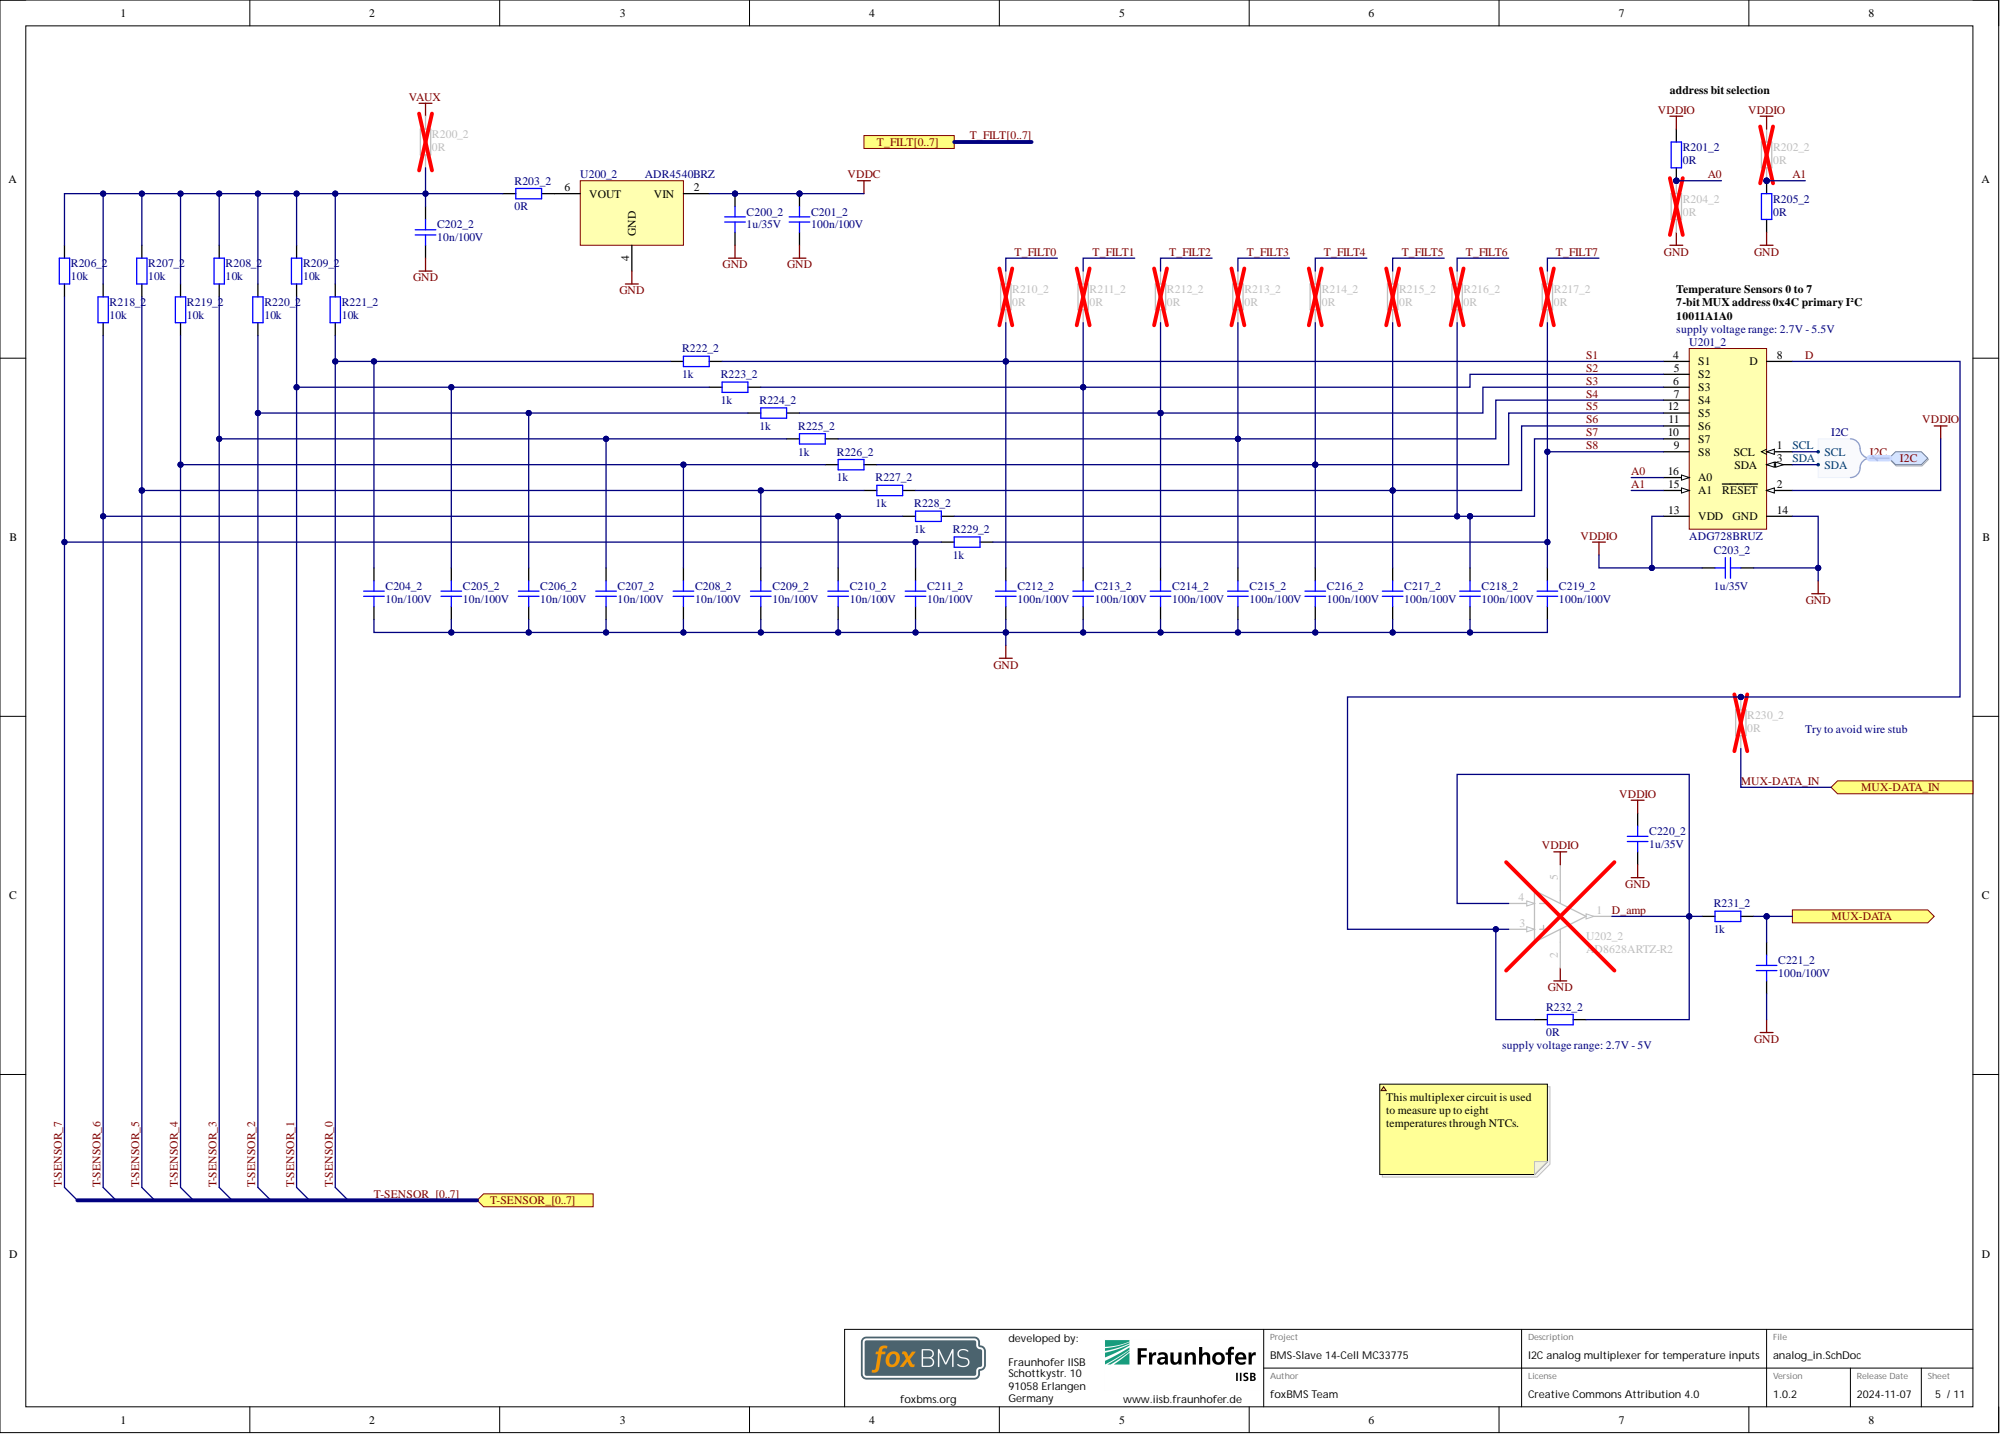
[picture p53: page 6]

S2 | S2 5 | VDDIO
S3 | | S3 6

This multiplexer circuit is used
to measure up to eight
temperaturesthrough NTCs.

I2C analog multiplexer for temperature inputs

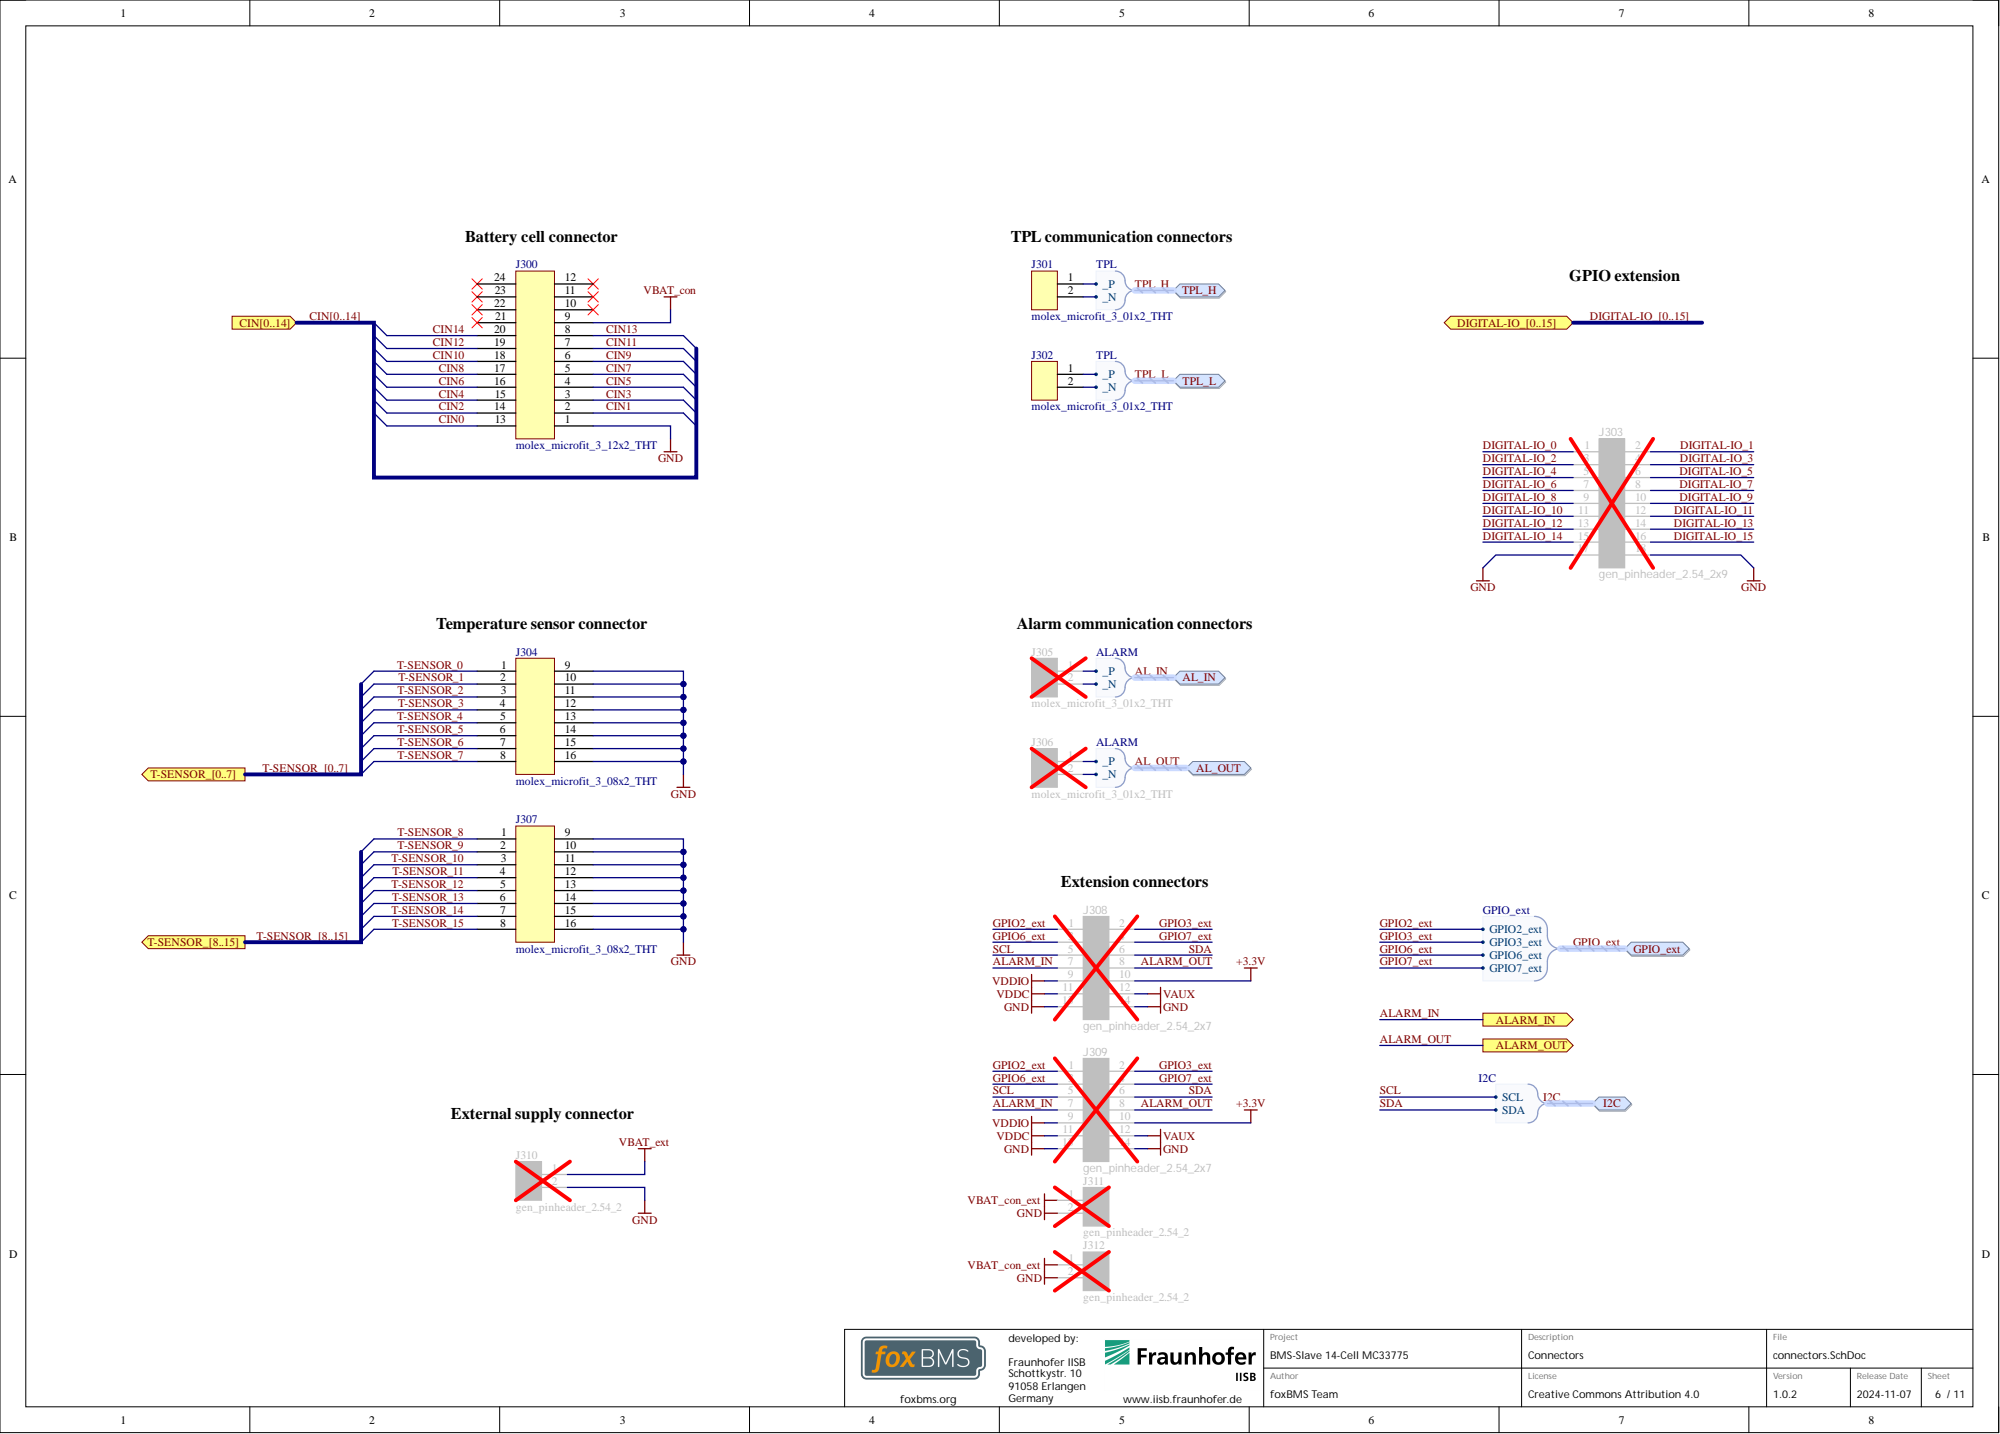
[picture p54: page 7]

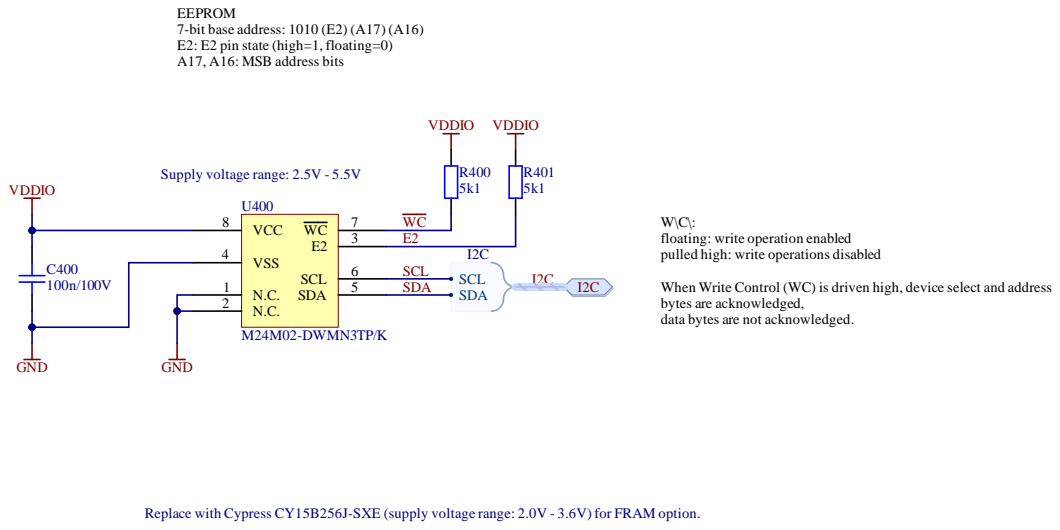
[picture p55: page 8]

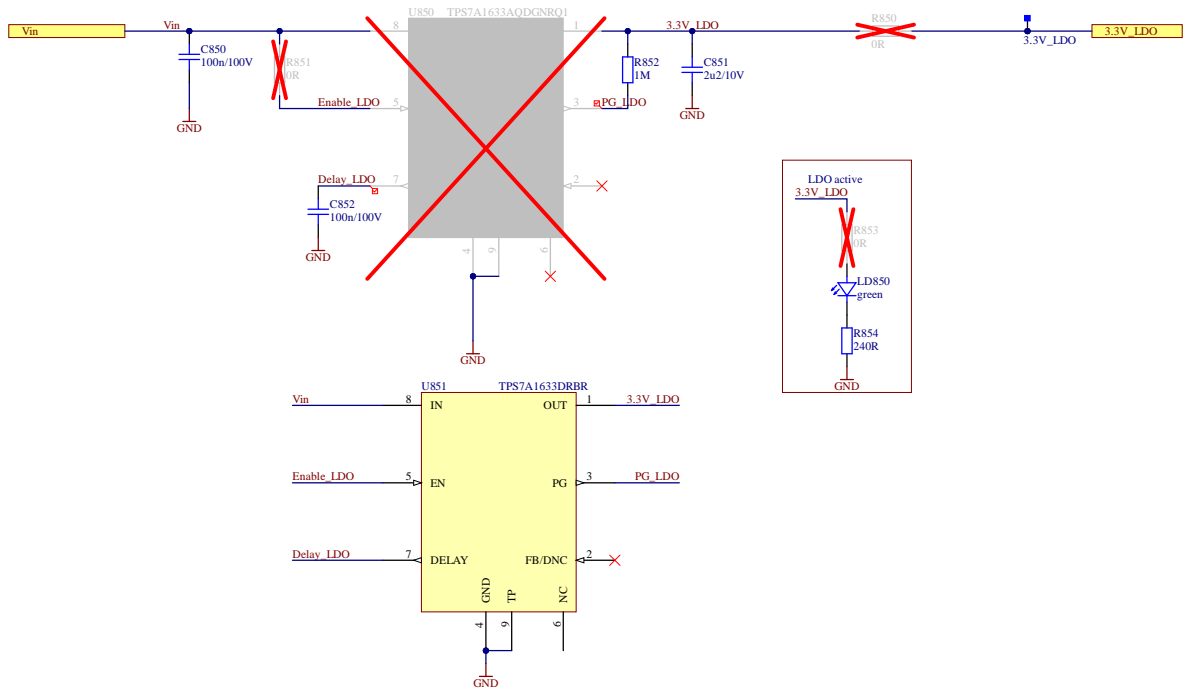
[picture p56: page 9]

LDO supply for VDDIO

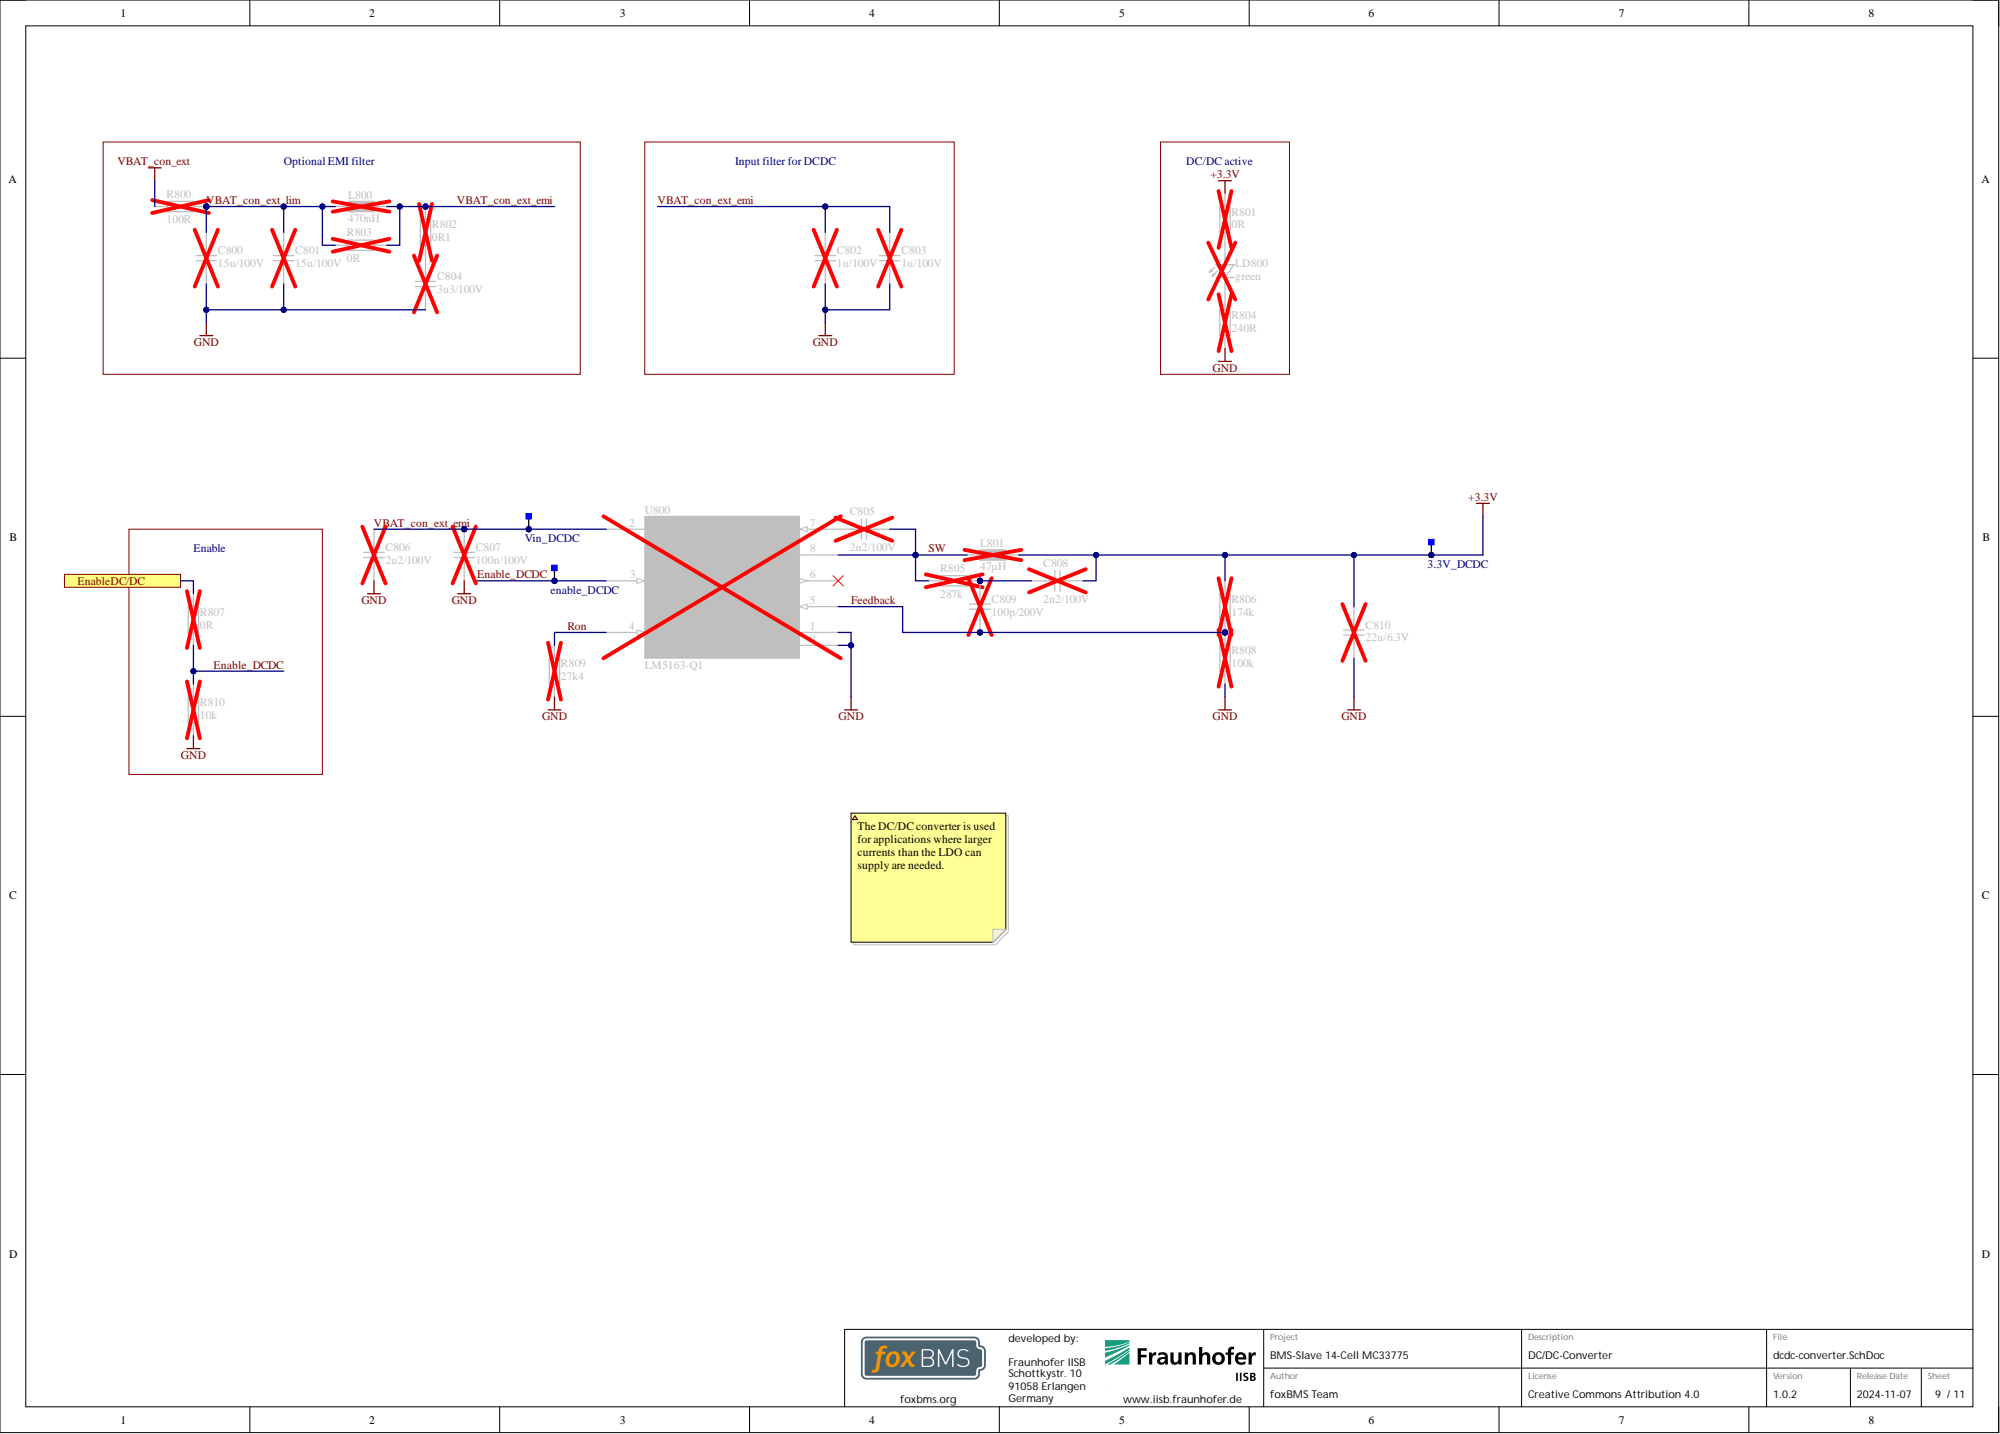
[picture p57: page 10]

Input filter for DCDC

EnableDC/DC

The DC/DC converter is used
for applications where larger
currents than the LDO can
supply are needed.

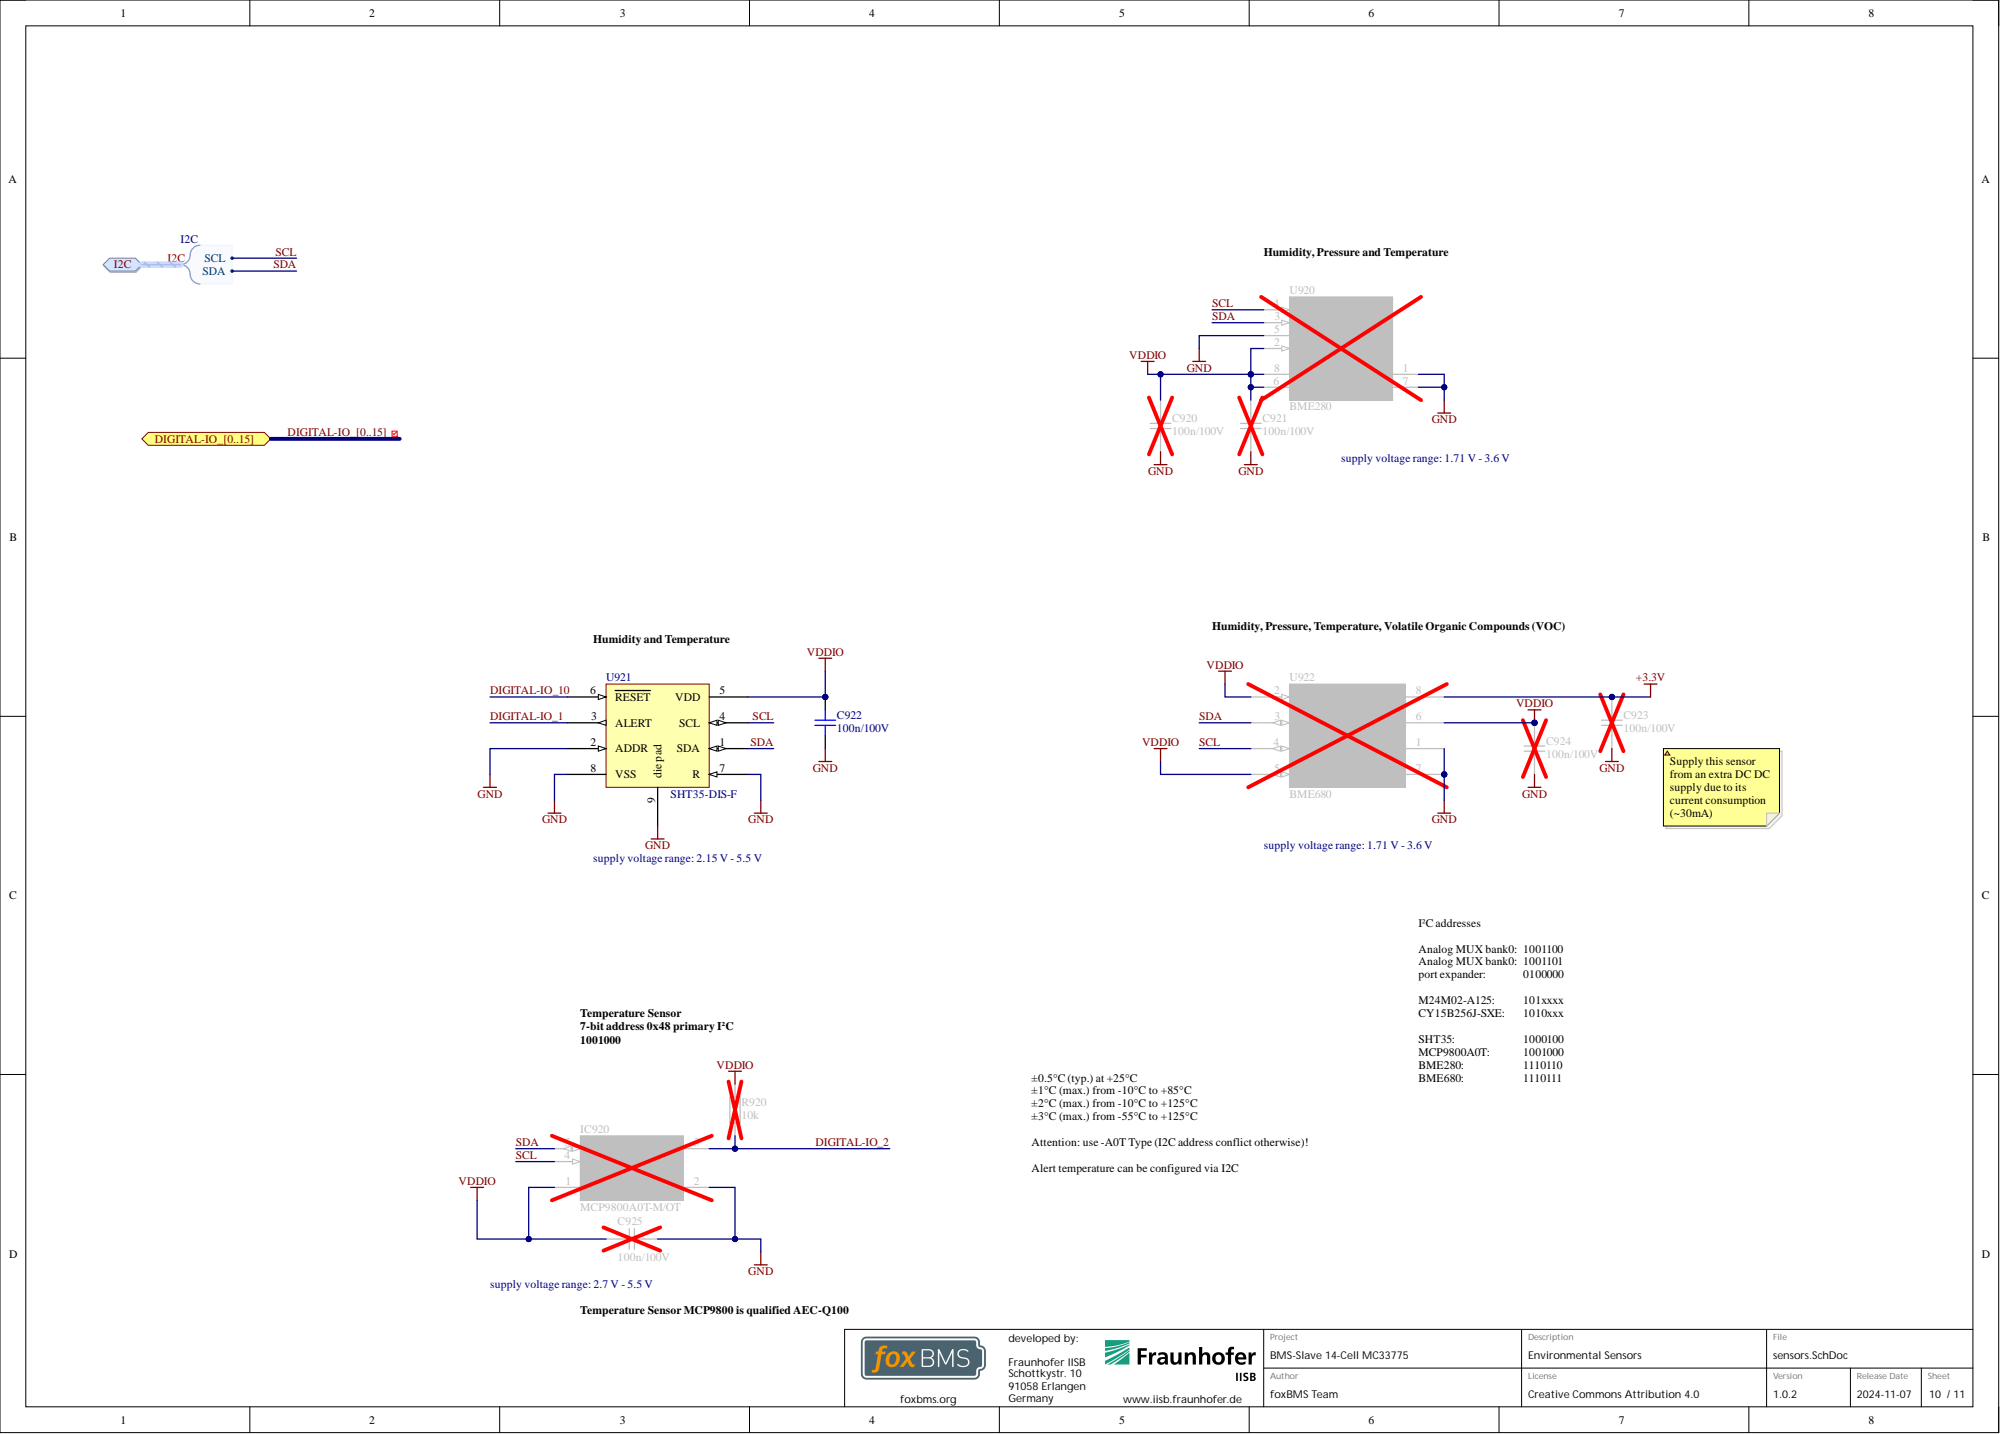
[picture p58: page 11]

Humidity, Pressure and Temperature

Humidity, Pressure, Temperature, Volatile Organic Compounds(VOC)

Supply this sensor
from an extra DC DC
supply due to its
current consumption

Temperature Sensor
7-bit address 0x48 primary I²C

Attention: use -A0T Type (I2C address conflict otherwise)!

Alert temperature can be configured via I2C

Temperature Sensor MCP9800 is qualified AEC-Q100

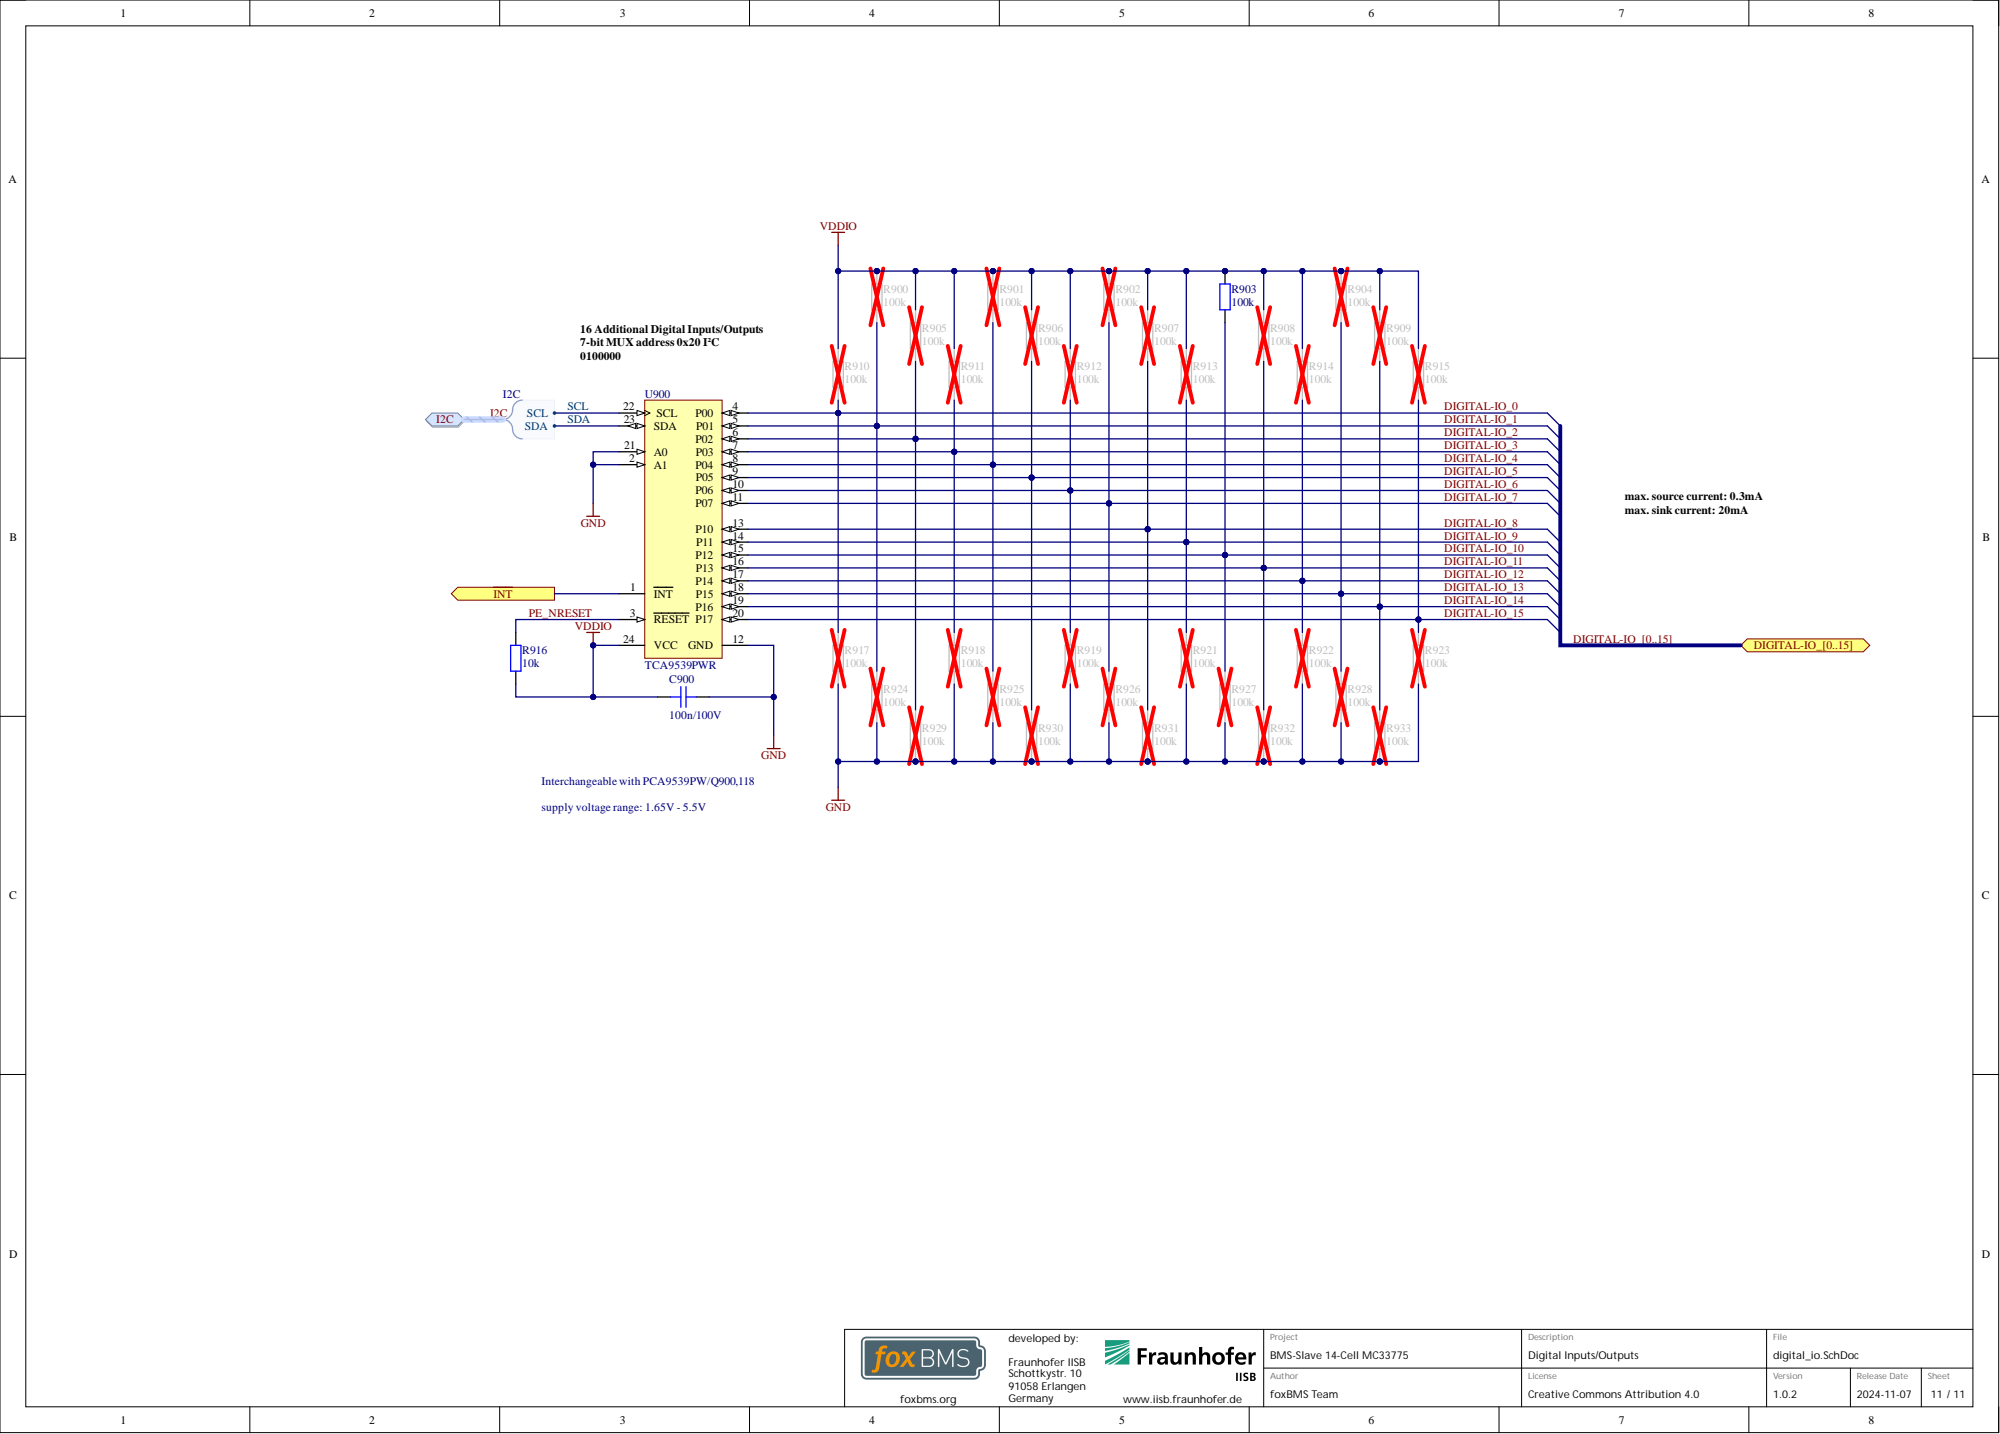
[picture p59: page 12]

16 Additional Digital Inputs/Outputs
7-bit MUX address 0x20 I²C
