emiln2002/BMS/slave_v2/Sources/pdf/placement-plan.PDF

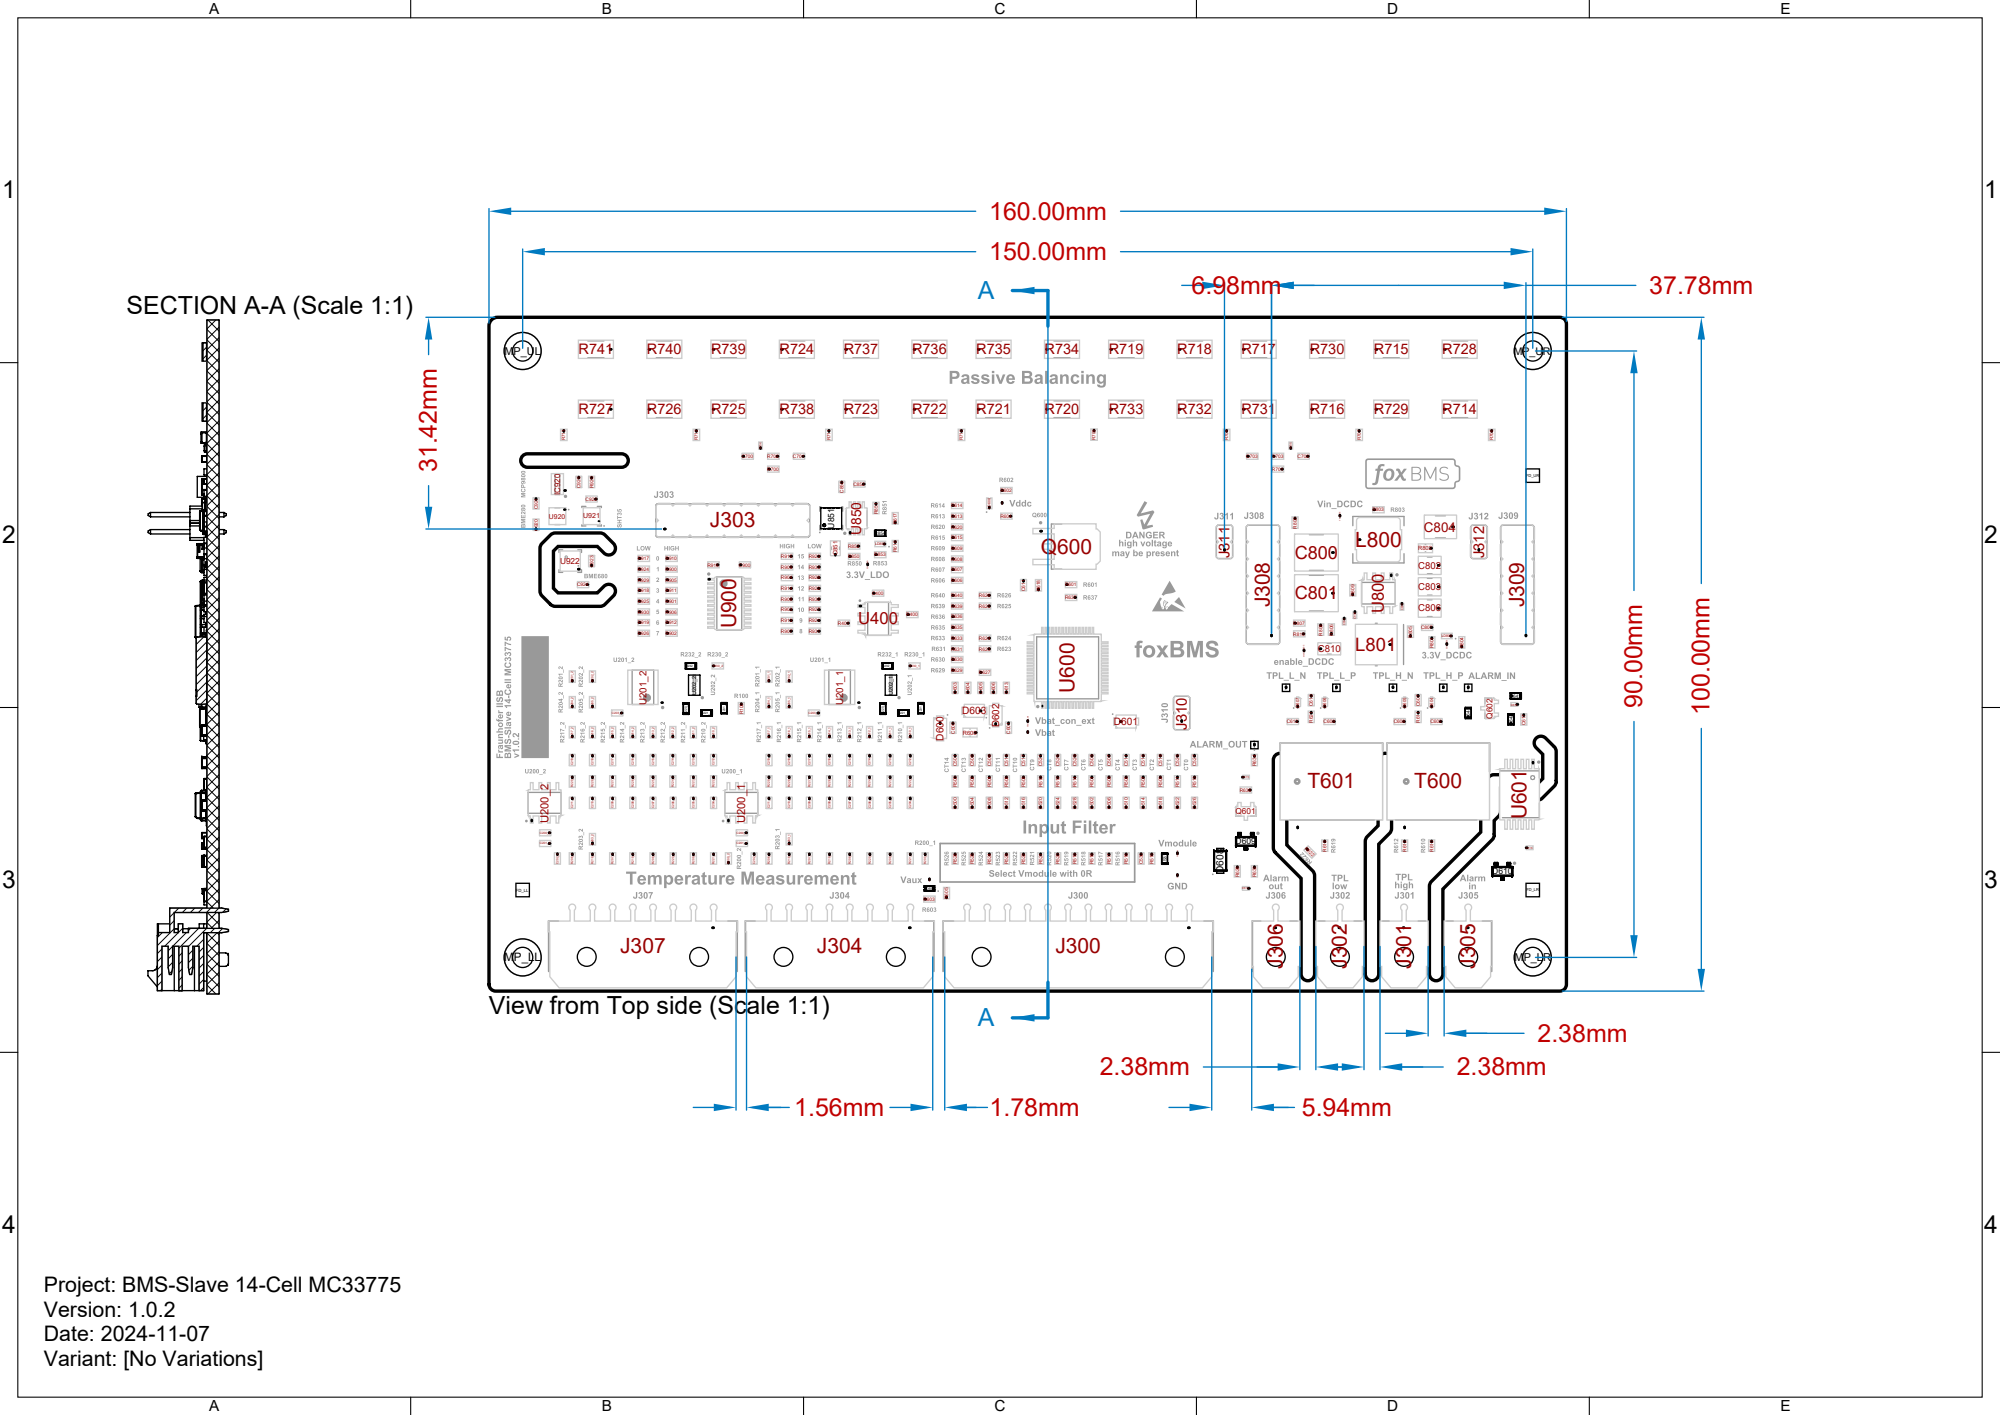
[picture p79: page 1]

A View from Top side (Scale 1:1)

Project: BMS-Slave 14-Cell MC33775
Version: 1.0.2
Date: 2024-11-07
Variant: [No Variations]

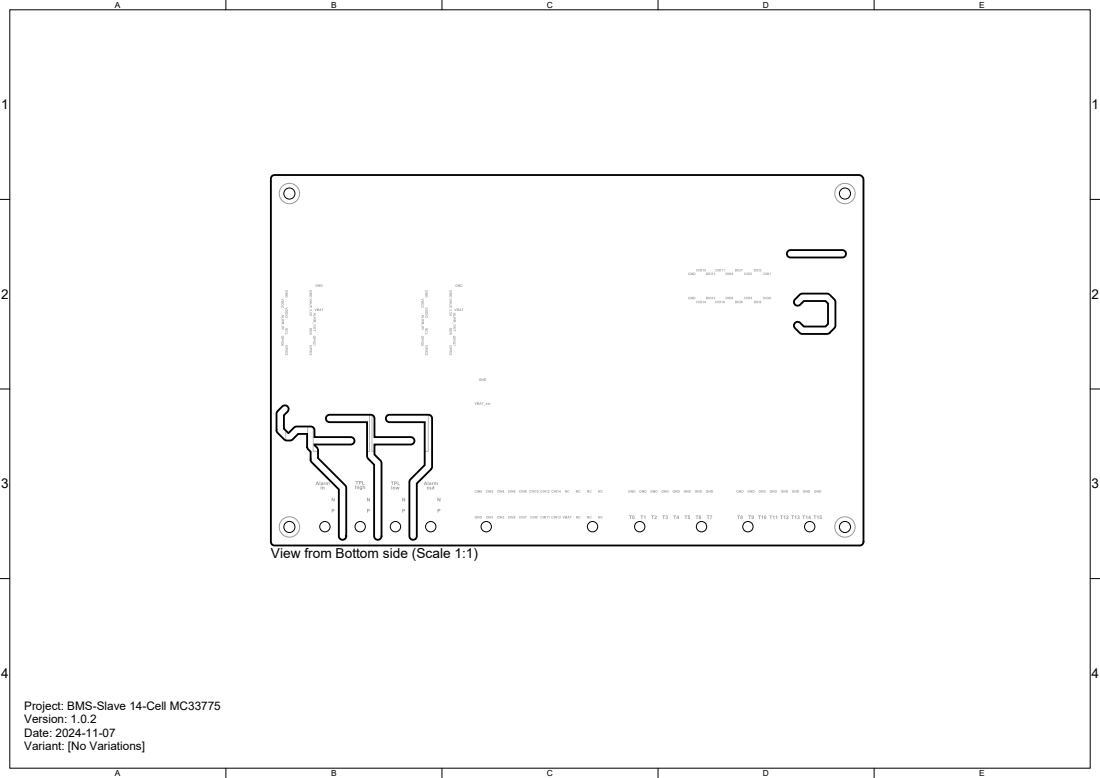
[picture p80: page 2]

View from Bottom side (Scale 1:1)

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
