emiln2002/BMS/interface-nxp-mc33664-v1.0.2/Assembly default-no-alarm/pdf/placement-plan.PDF

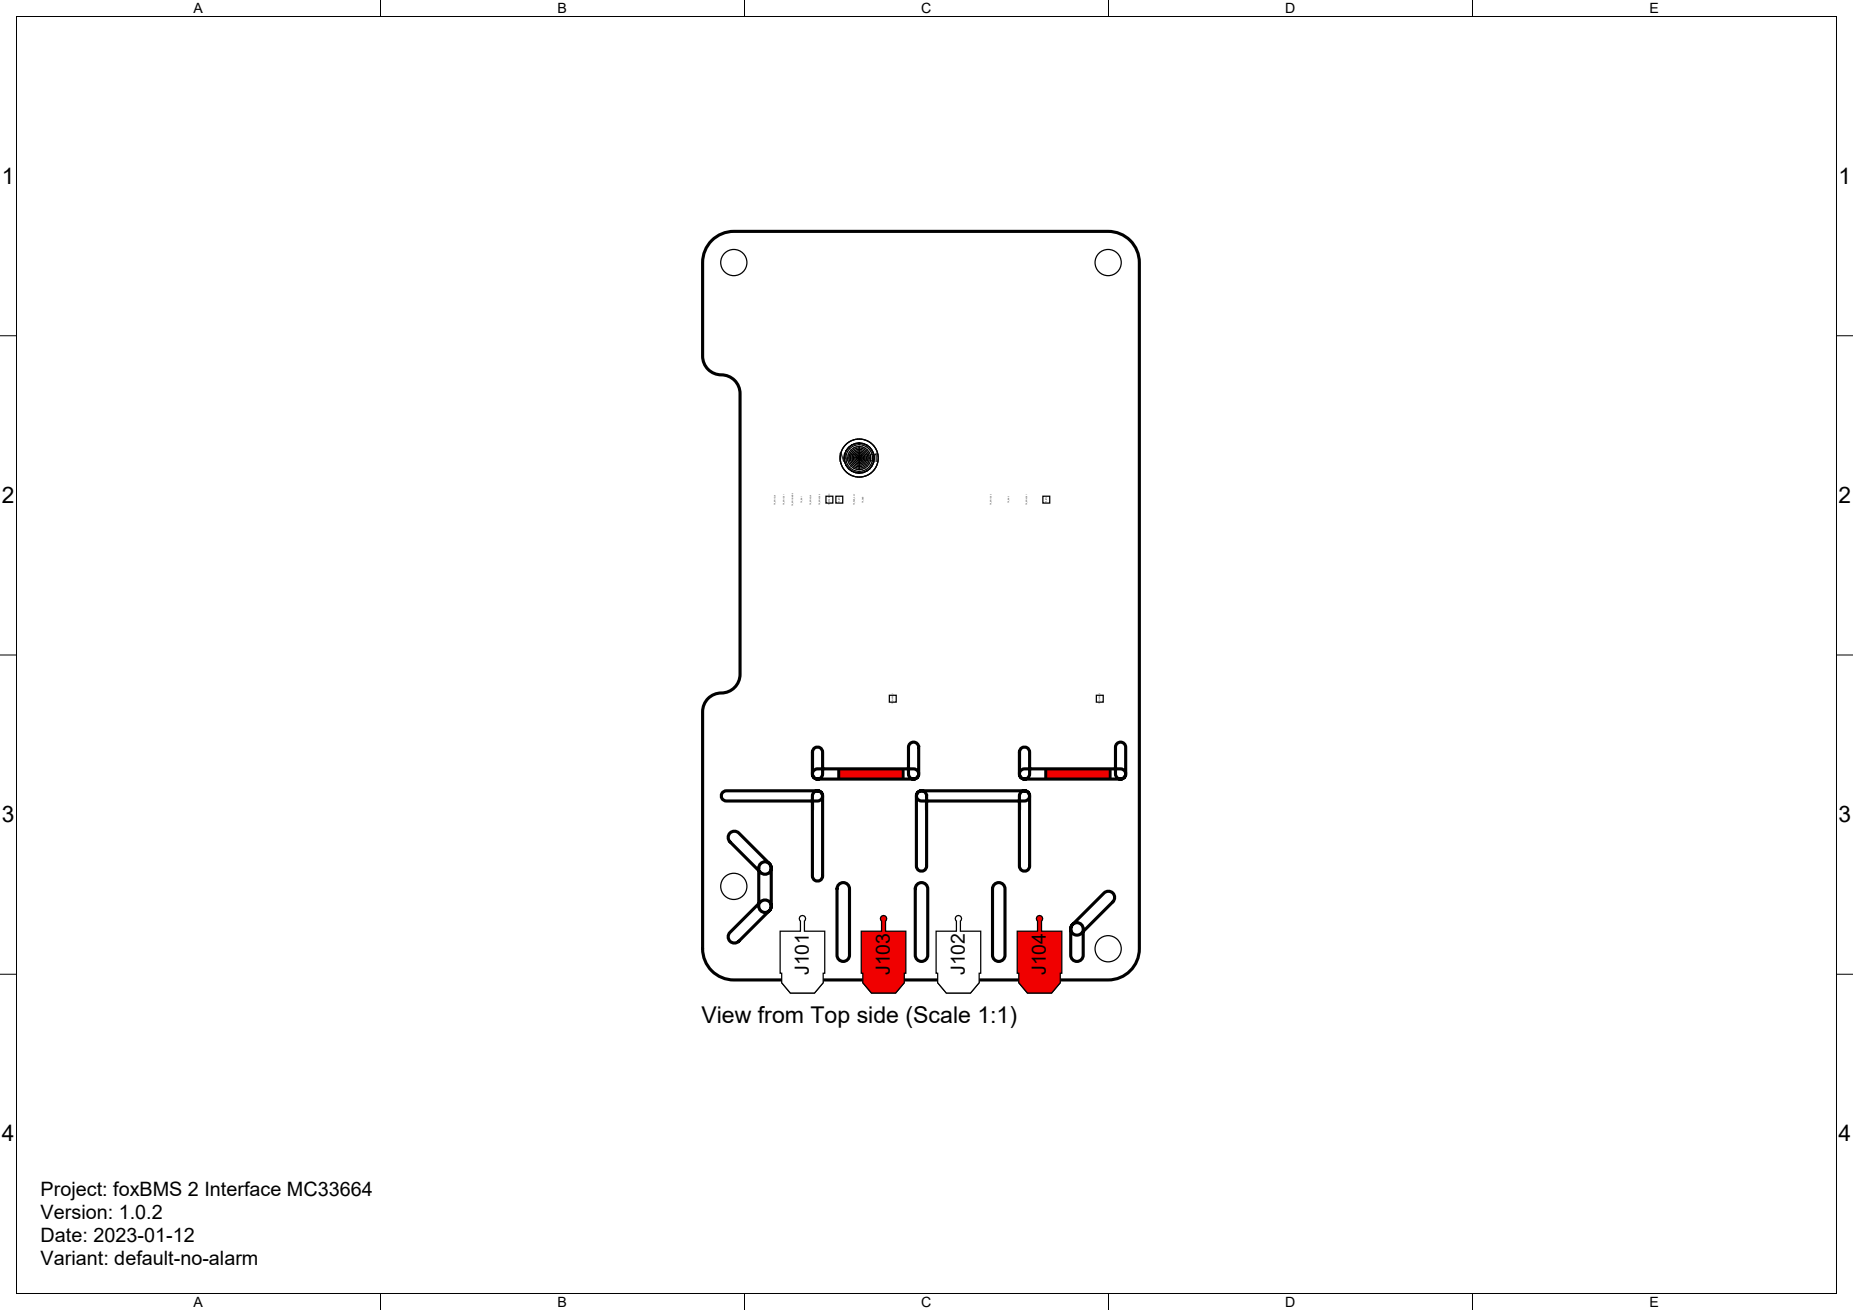
[picture p81: page 1]

View from Top side (Scale 1:1)

Project: foxBMS 2 Interface MC33664
Version: 1.0.2
Date: 2023-01-12
Variant: default-no-alarm

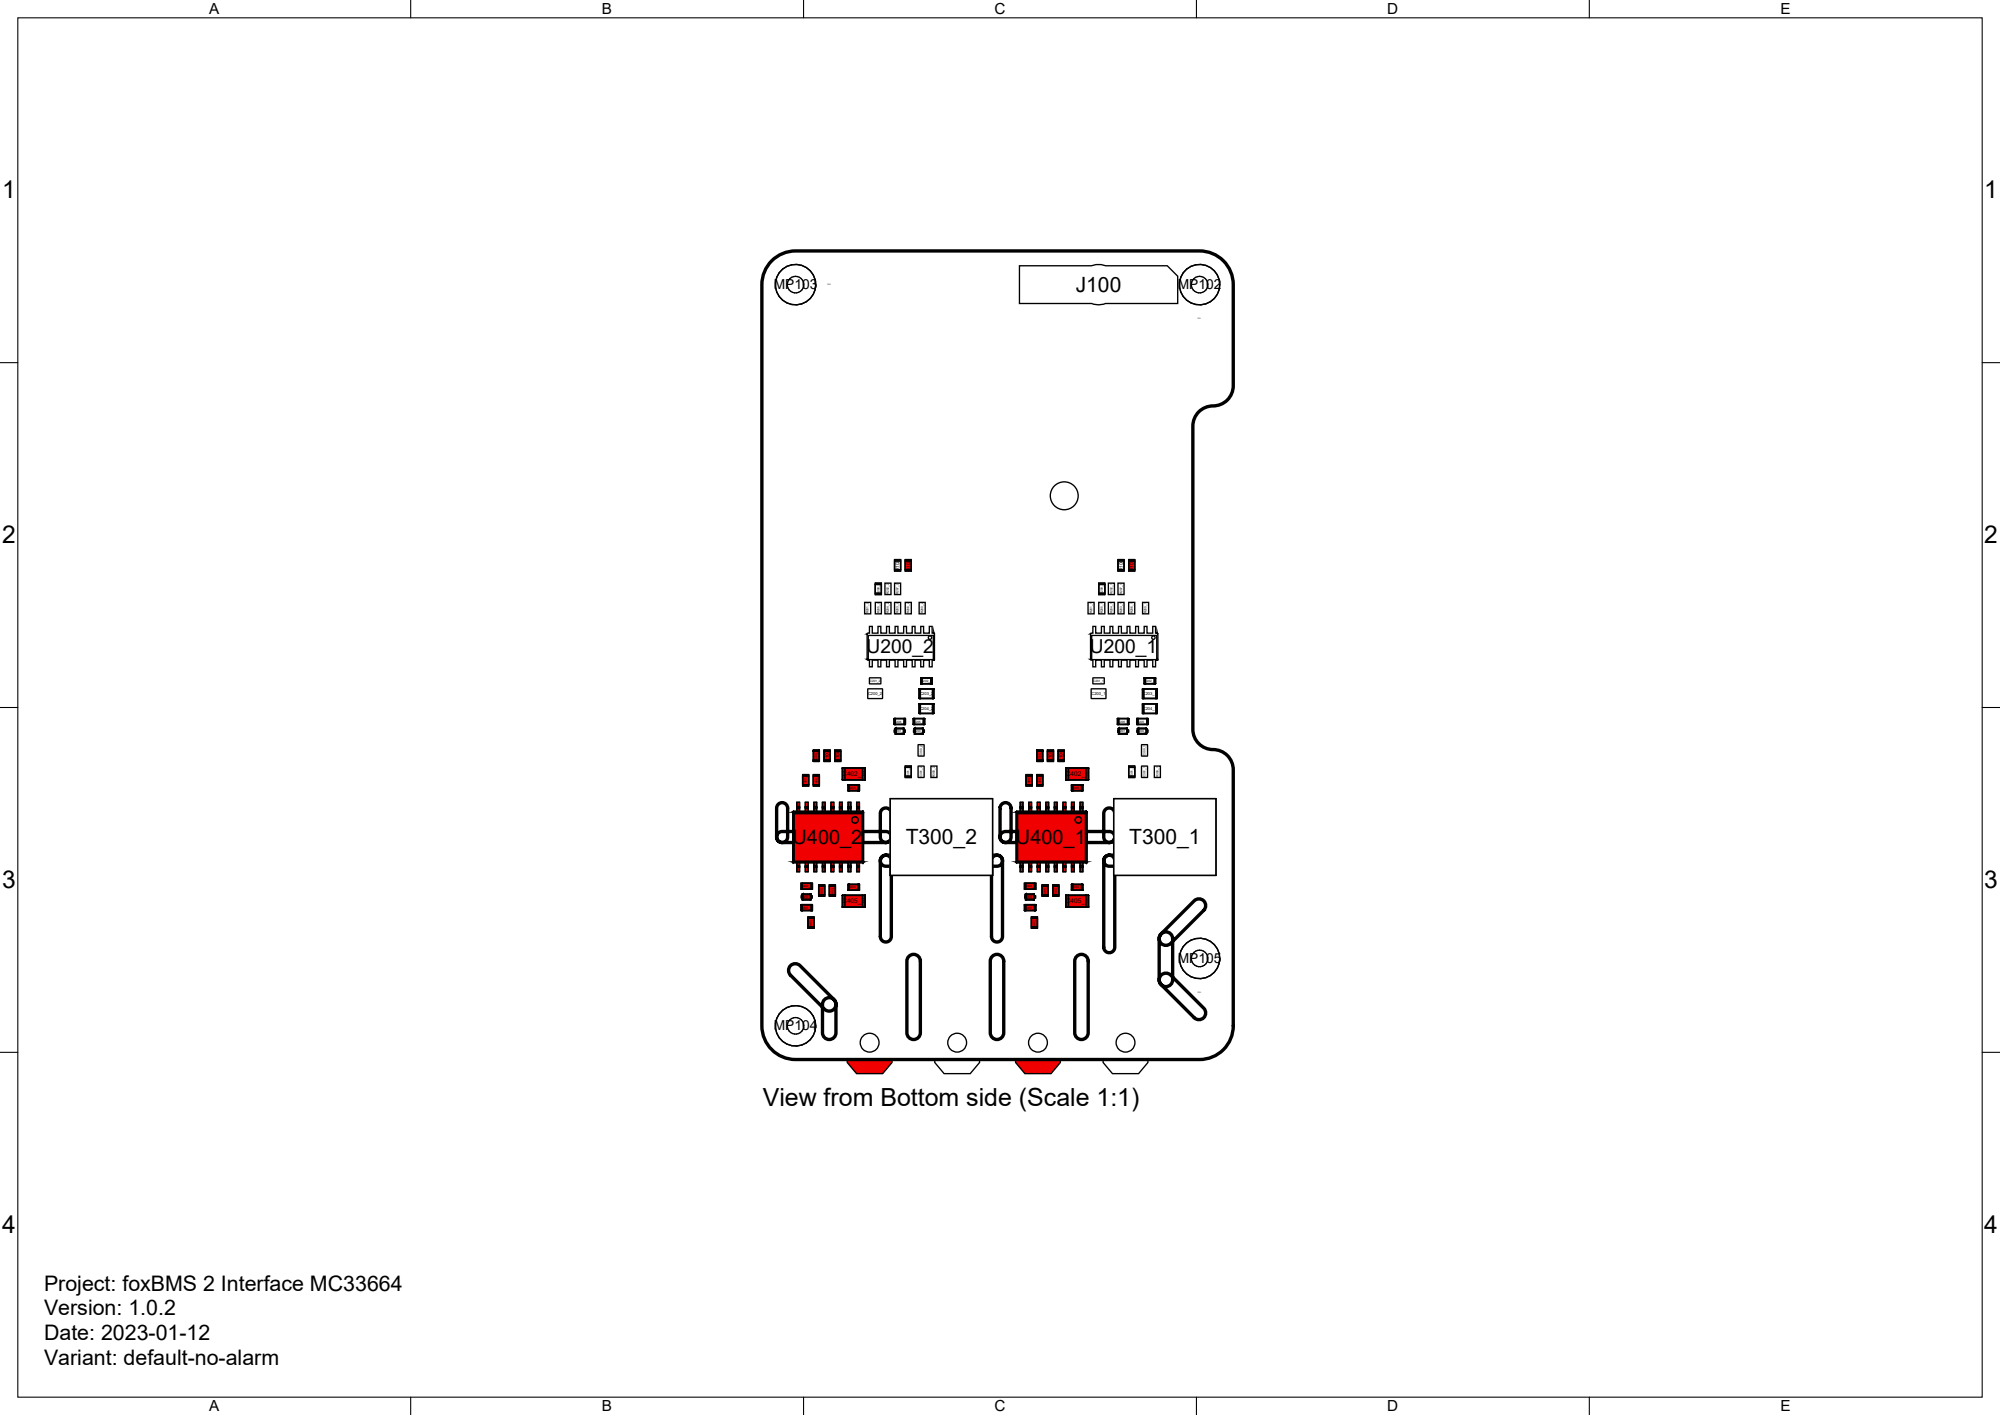
[picture p82: page 2]

View from Bottom side (Scale 1:1)

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
