emiln2002/BMS/interface-nxp-mc33664-v1.0.2/Assembly default-no-alarm/pdf/schematics.PDF

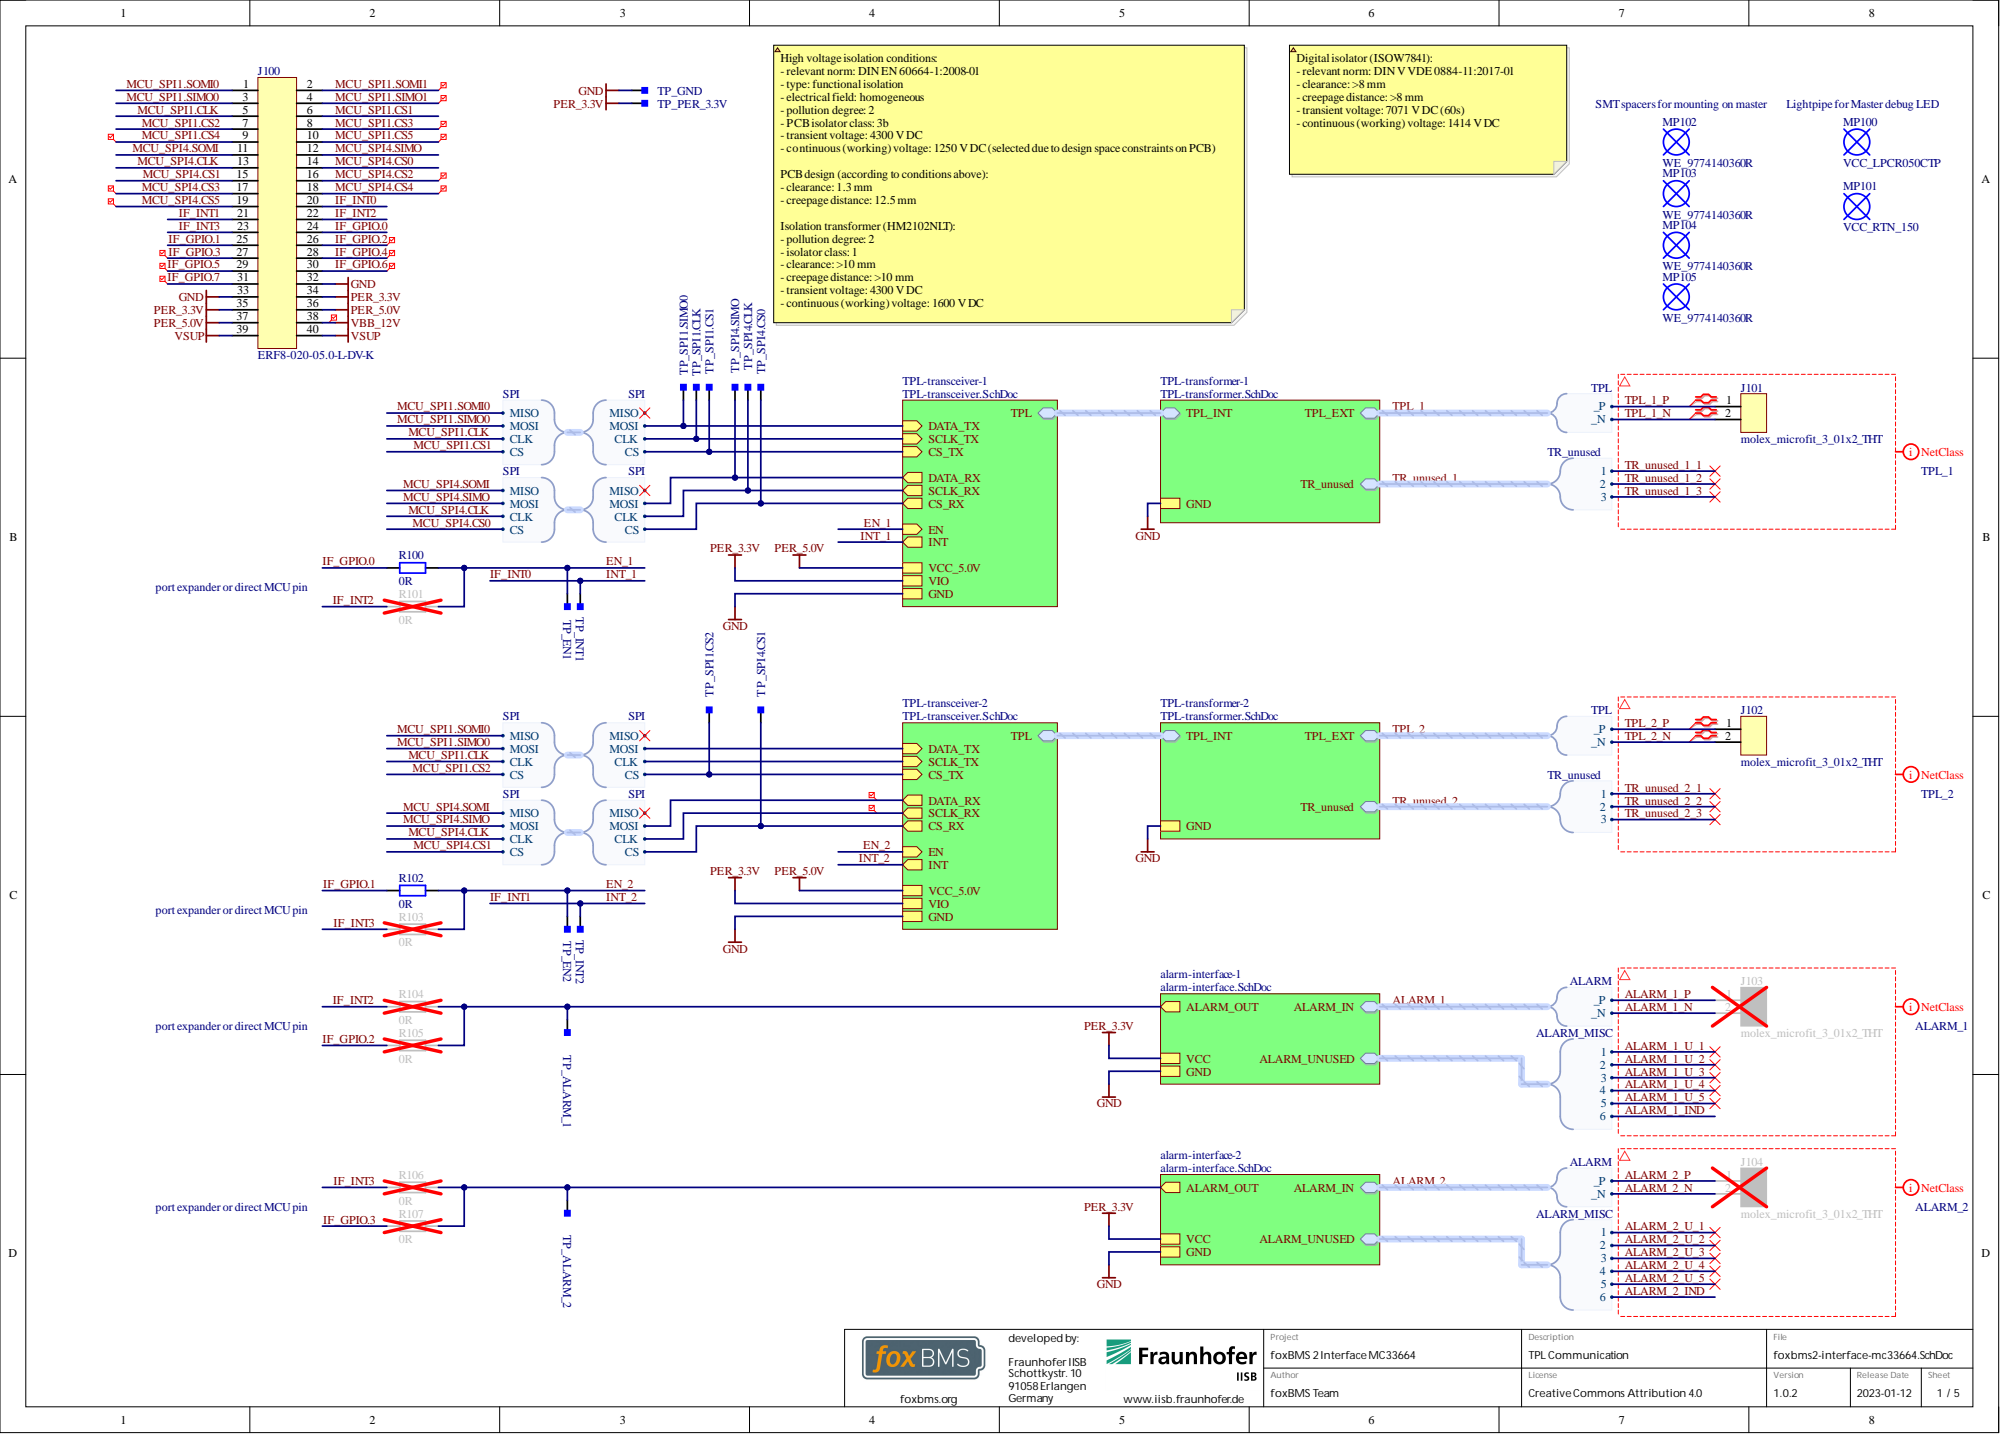
[picture p83: page 1]

cted due to de

35 | 36
37 | 38

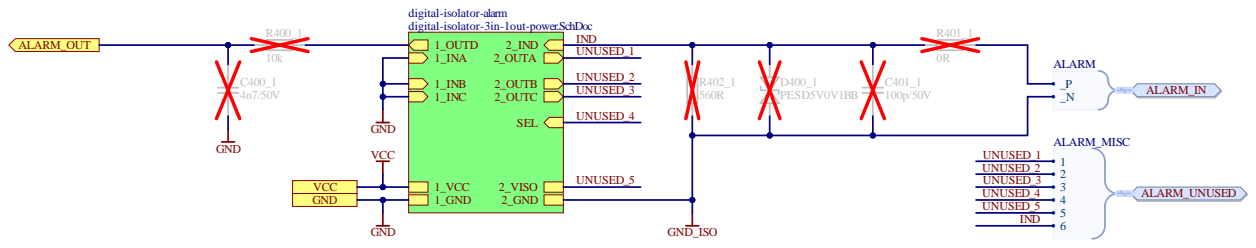
[picture p84: page 2]

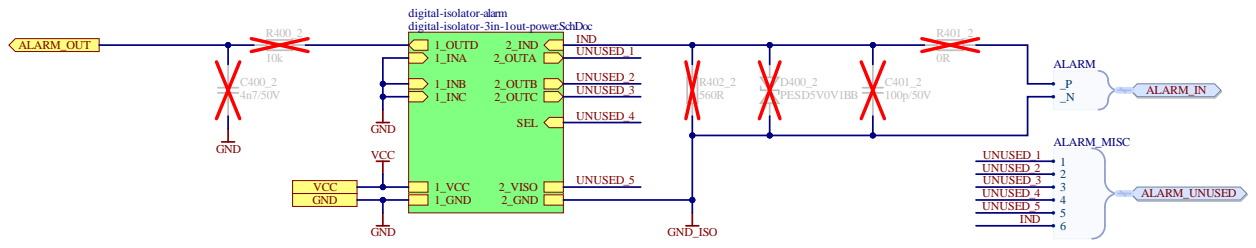
[picture p85: page 3]

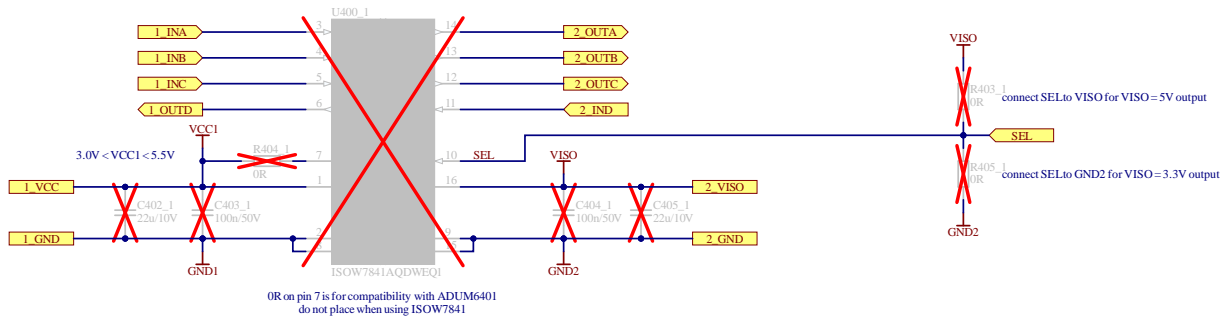
[picture p86: page 4]

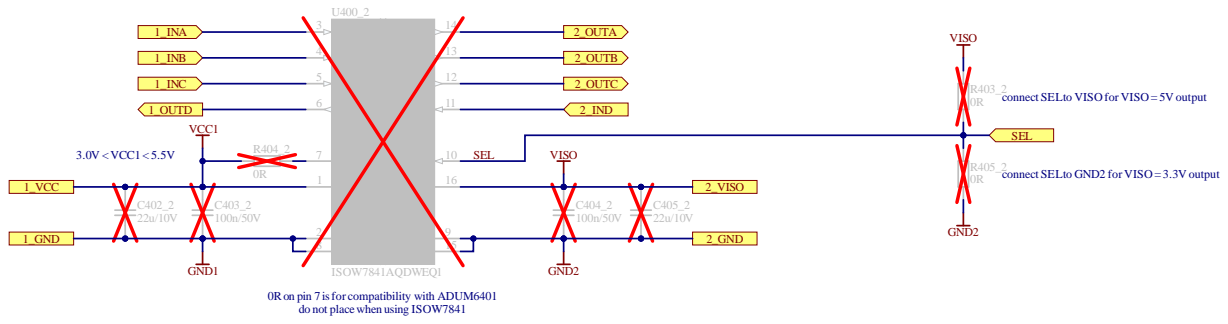
[picture p87: page 5]

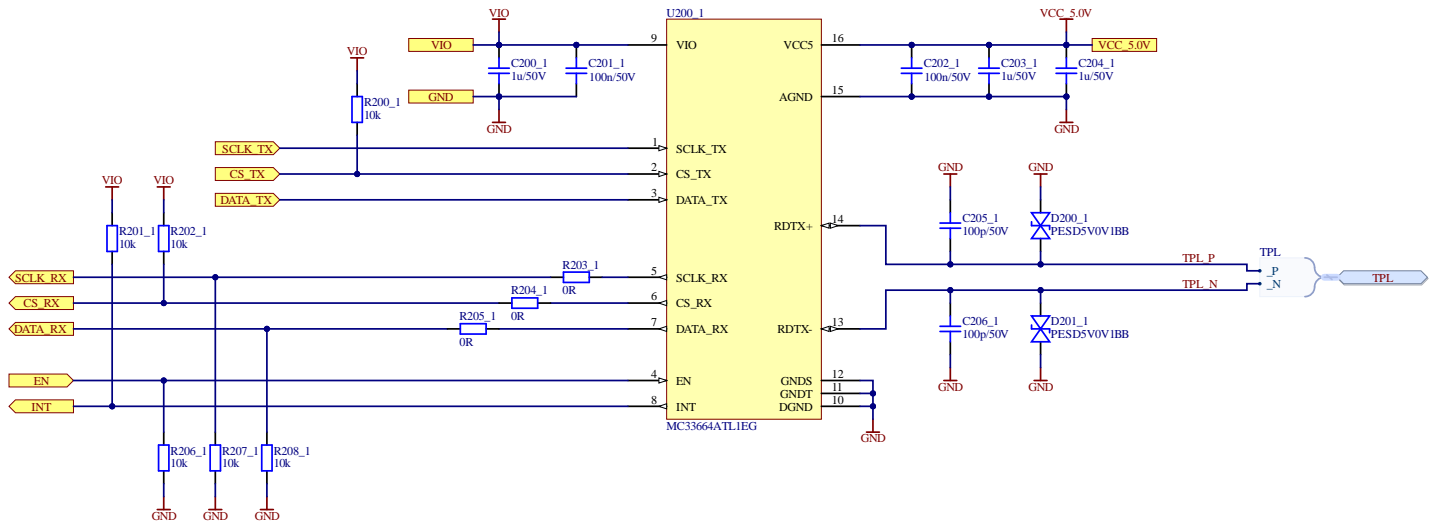
[picture p88: page 6]

www.iisb.fraunhofer.de

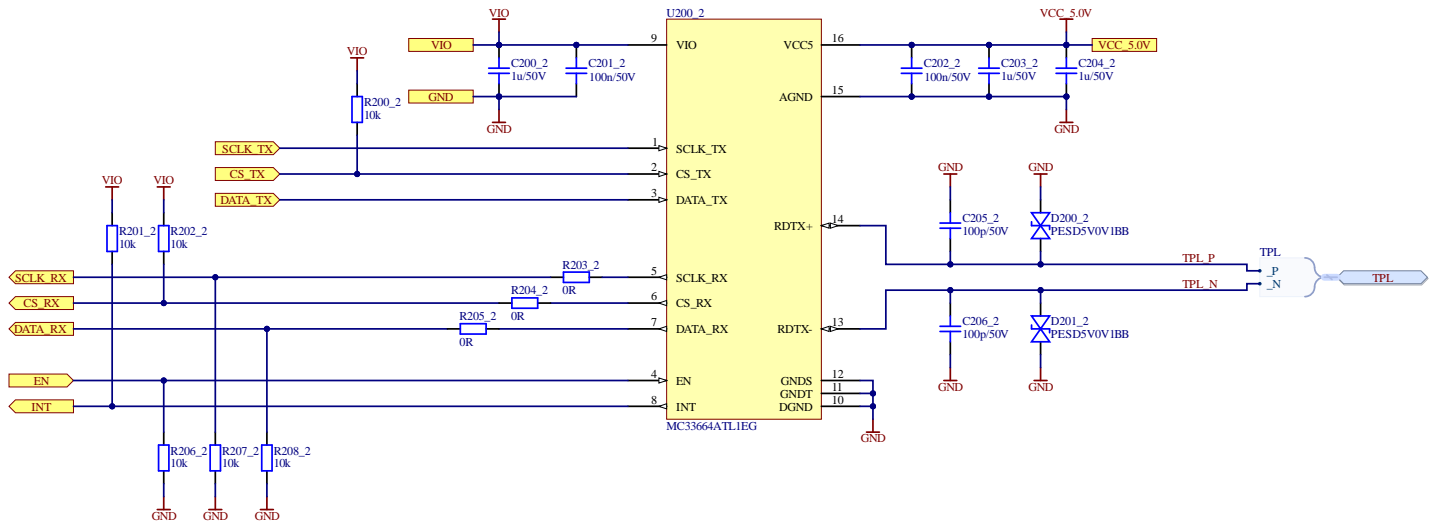
[picture p89: page 7]

www.iisb.fraunhofer.de

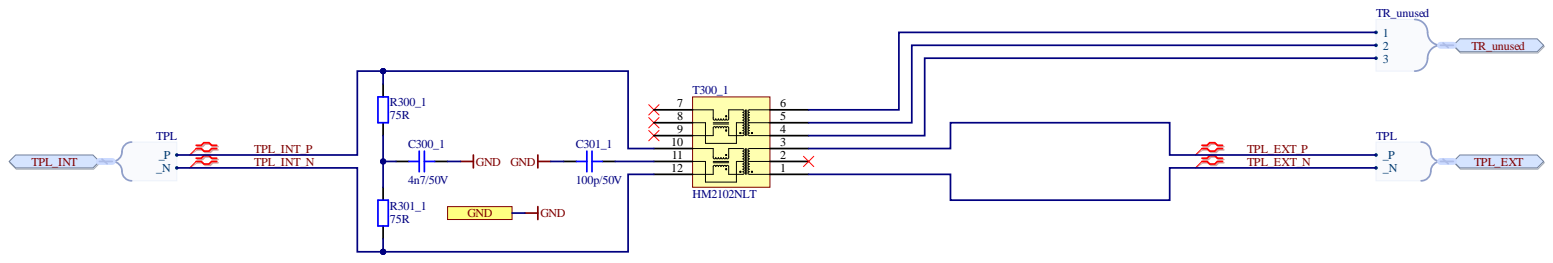
[picture p90: page 8]

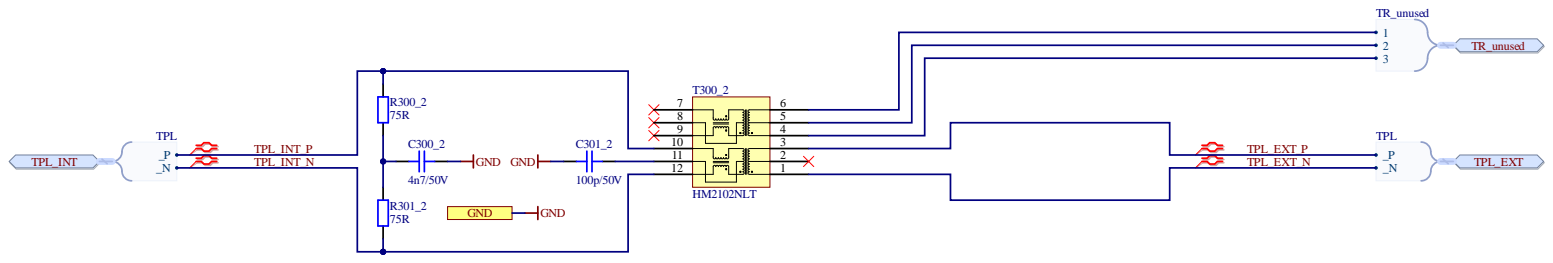
[picture p91: page 9]
