emiln2002/BMS/interface-nxp-mc33664-v1.0.2/Assembly default/pdf/placement-plan.PDF

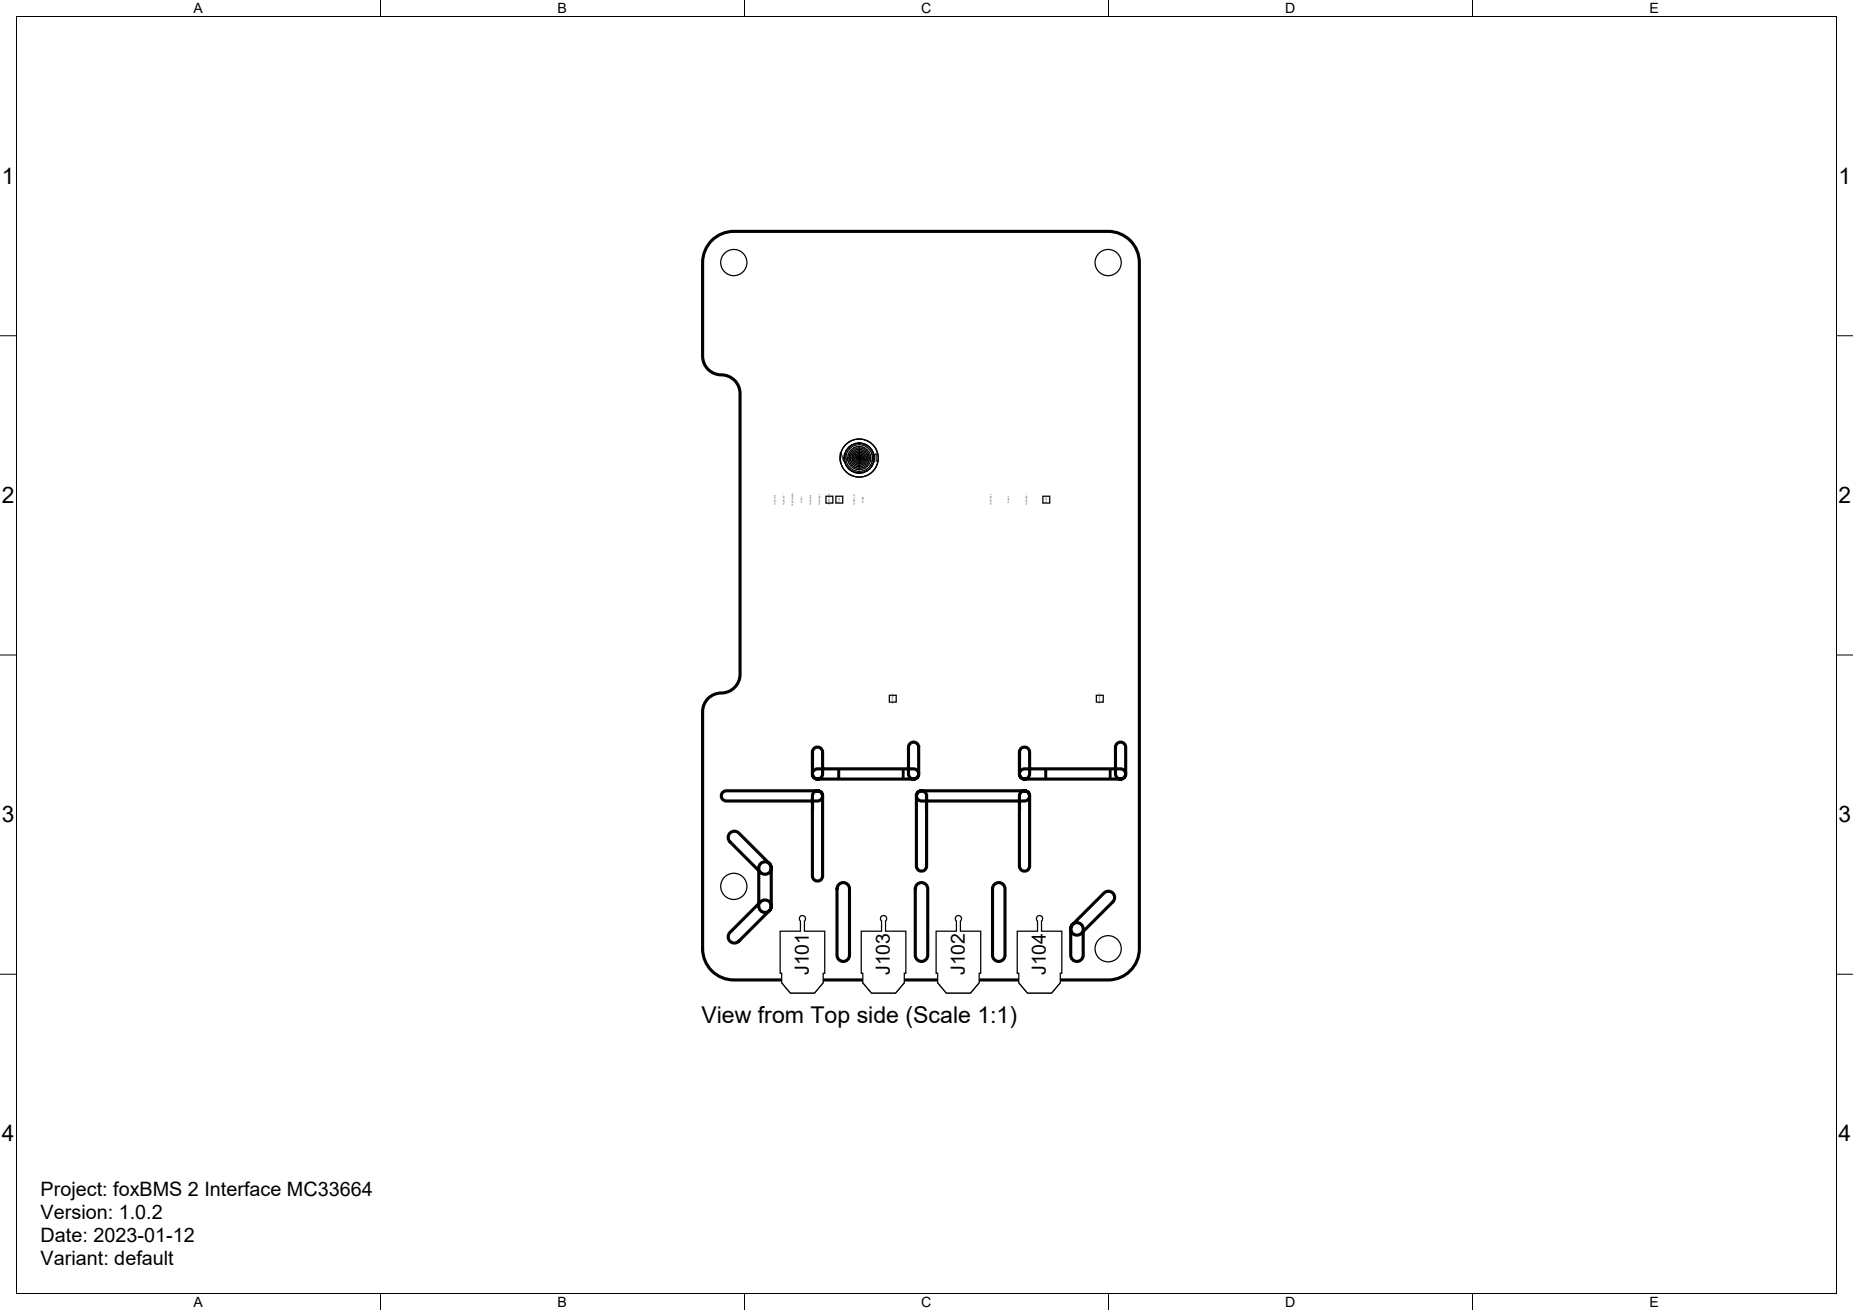
[picture p92: page 1]

View from Top side (Scale 1:1)

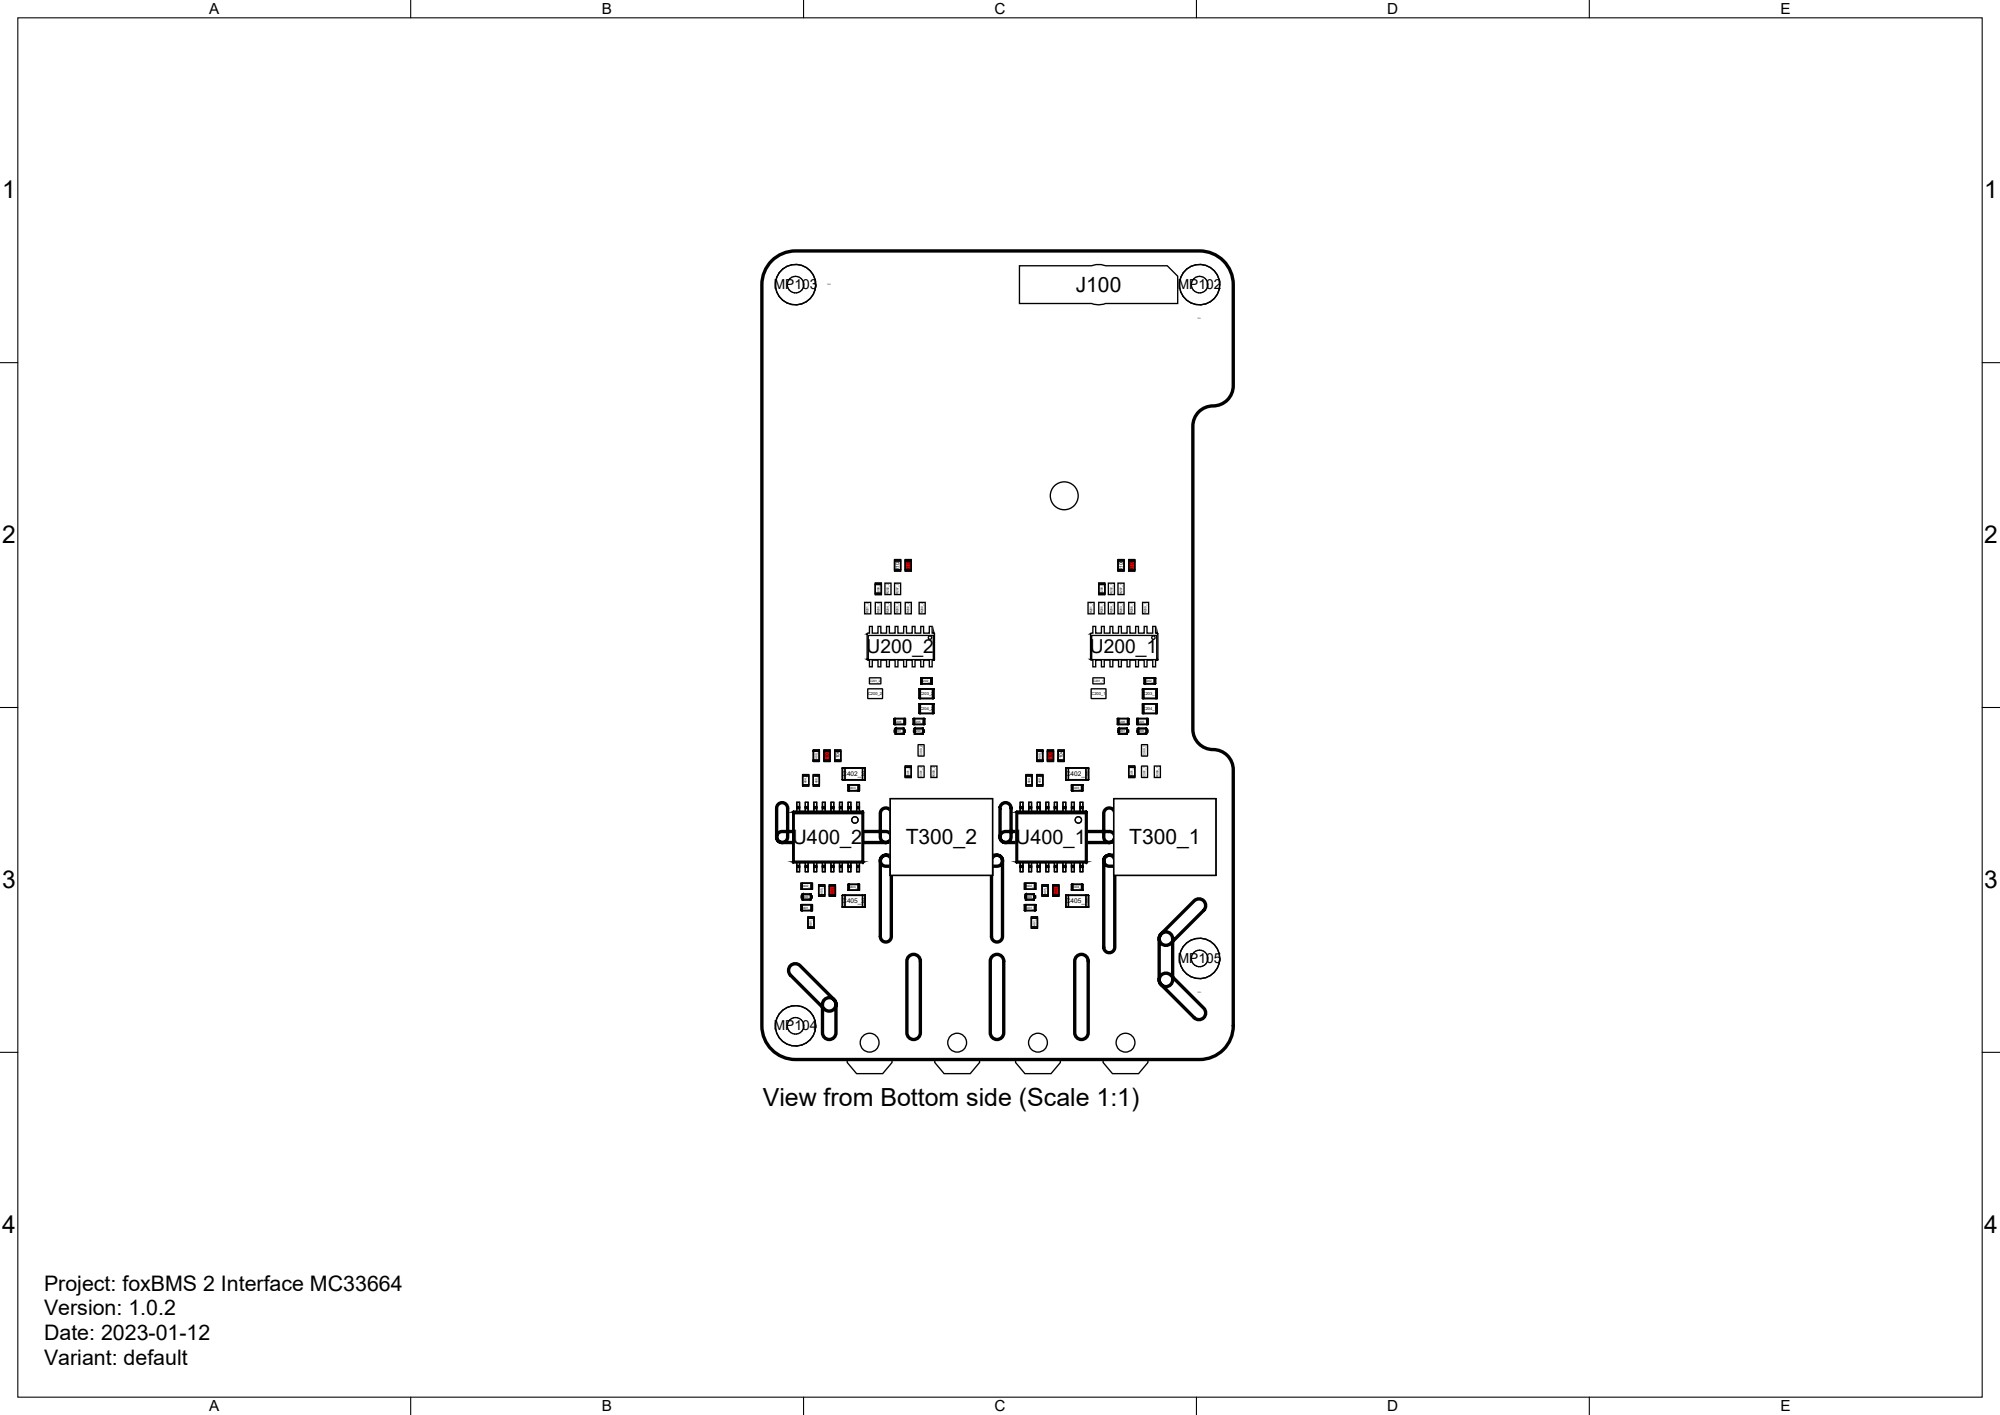
[picture p93: page 2]

View from Bottom side (Scale 1:1)
