emiln2002/BMS/interface-nxp-mc33664-v1.0.2/Assembly default/pdf/schematics.PDF

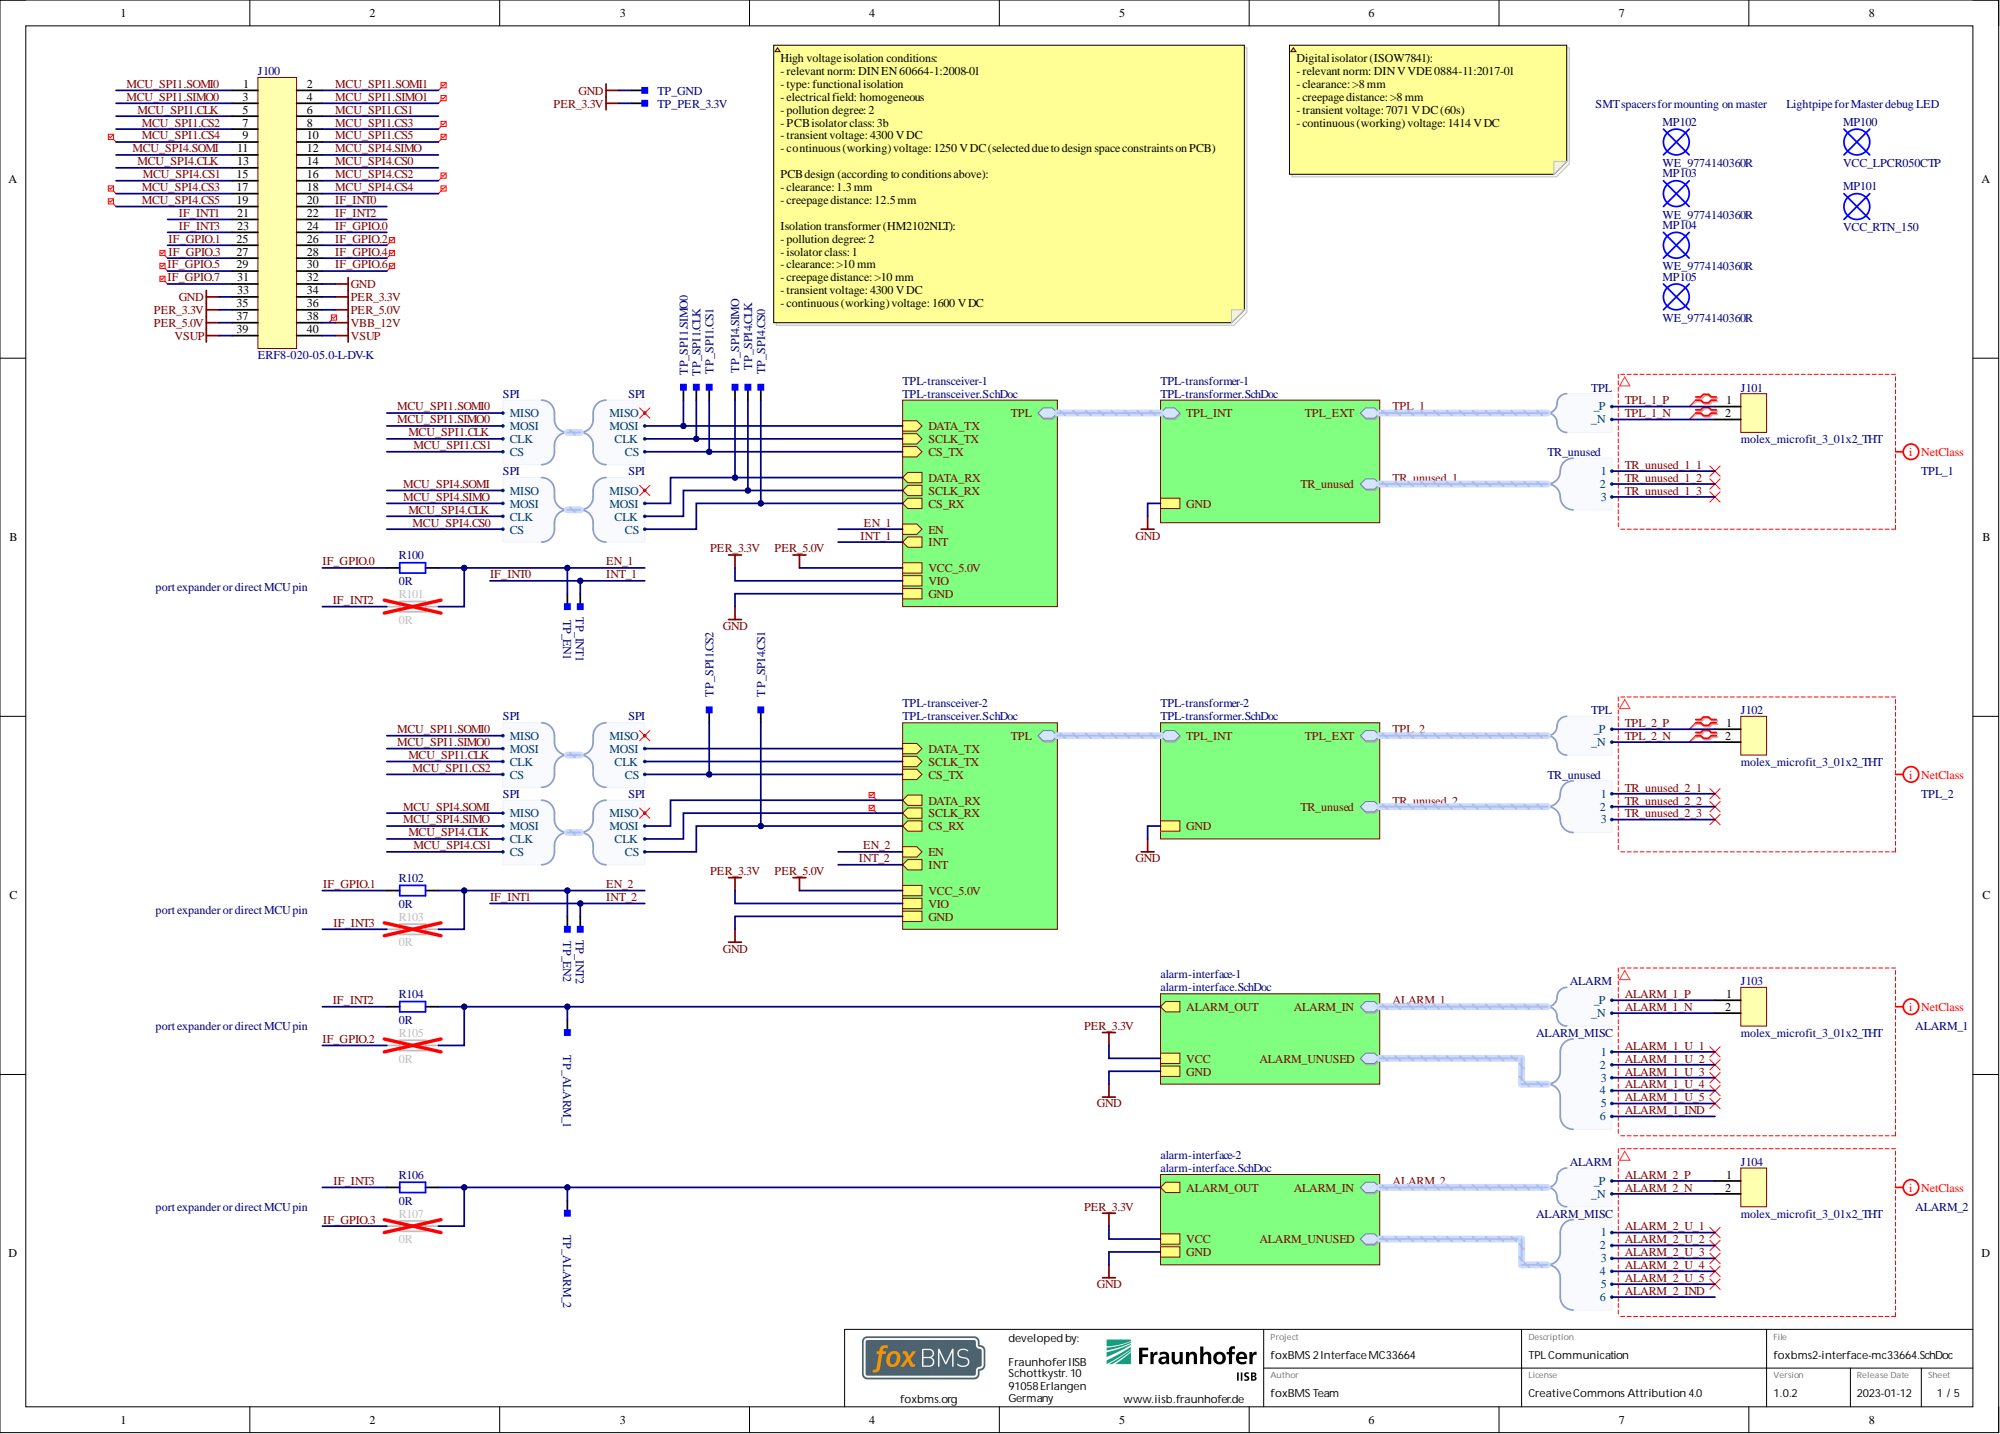
[picture p94: page 1]

cted due to de

35 | 36
37 | 38

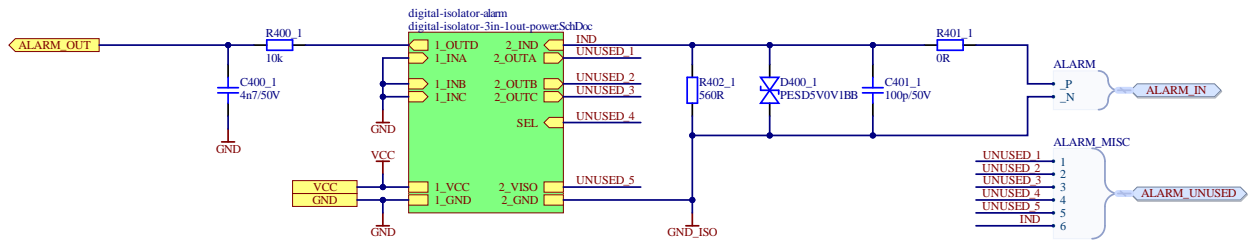
[picture p95: page 2]

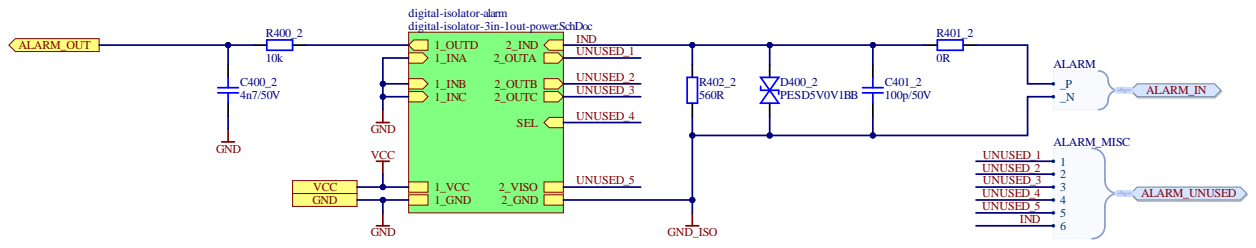
[picture p96: page 3]

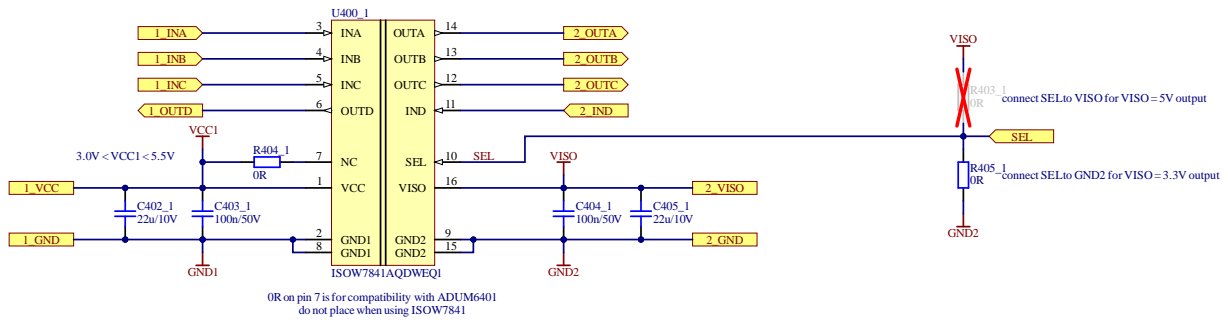
[picture p97: page 4]

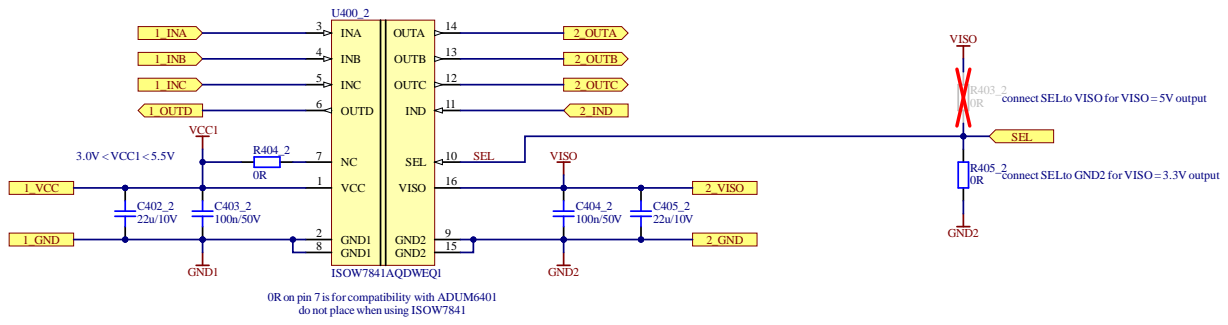
[picture p98: page 5]


www.iisb.fraunhofer.de


www.iisb.fraunhofer.de
