emiln2002/BMS/interface-nxp-mc33664-v1.0.2/Assembly/pdf/schematics.PDF

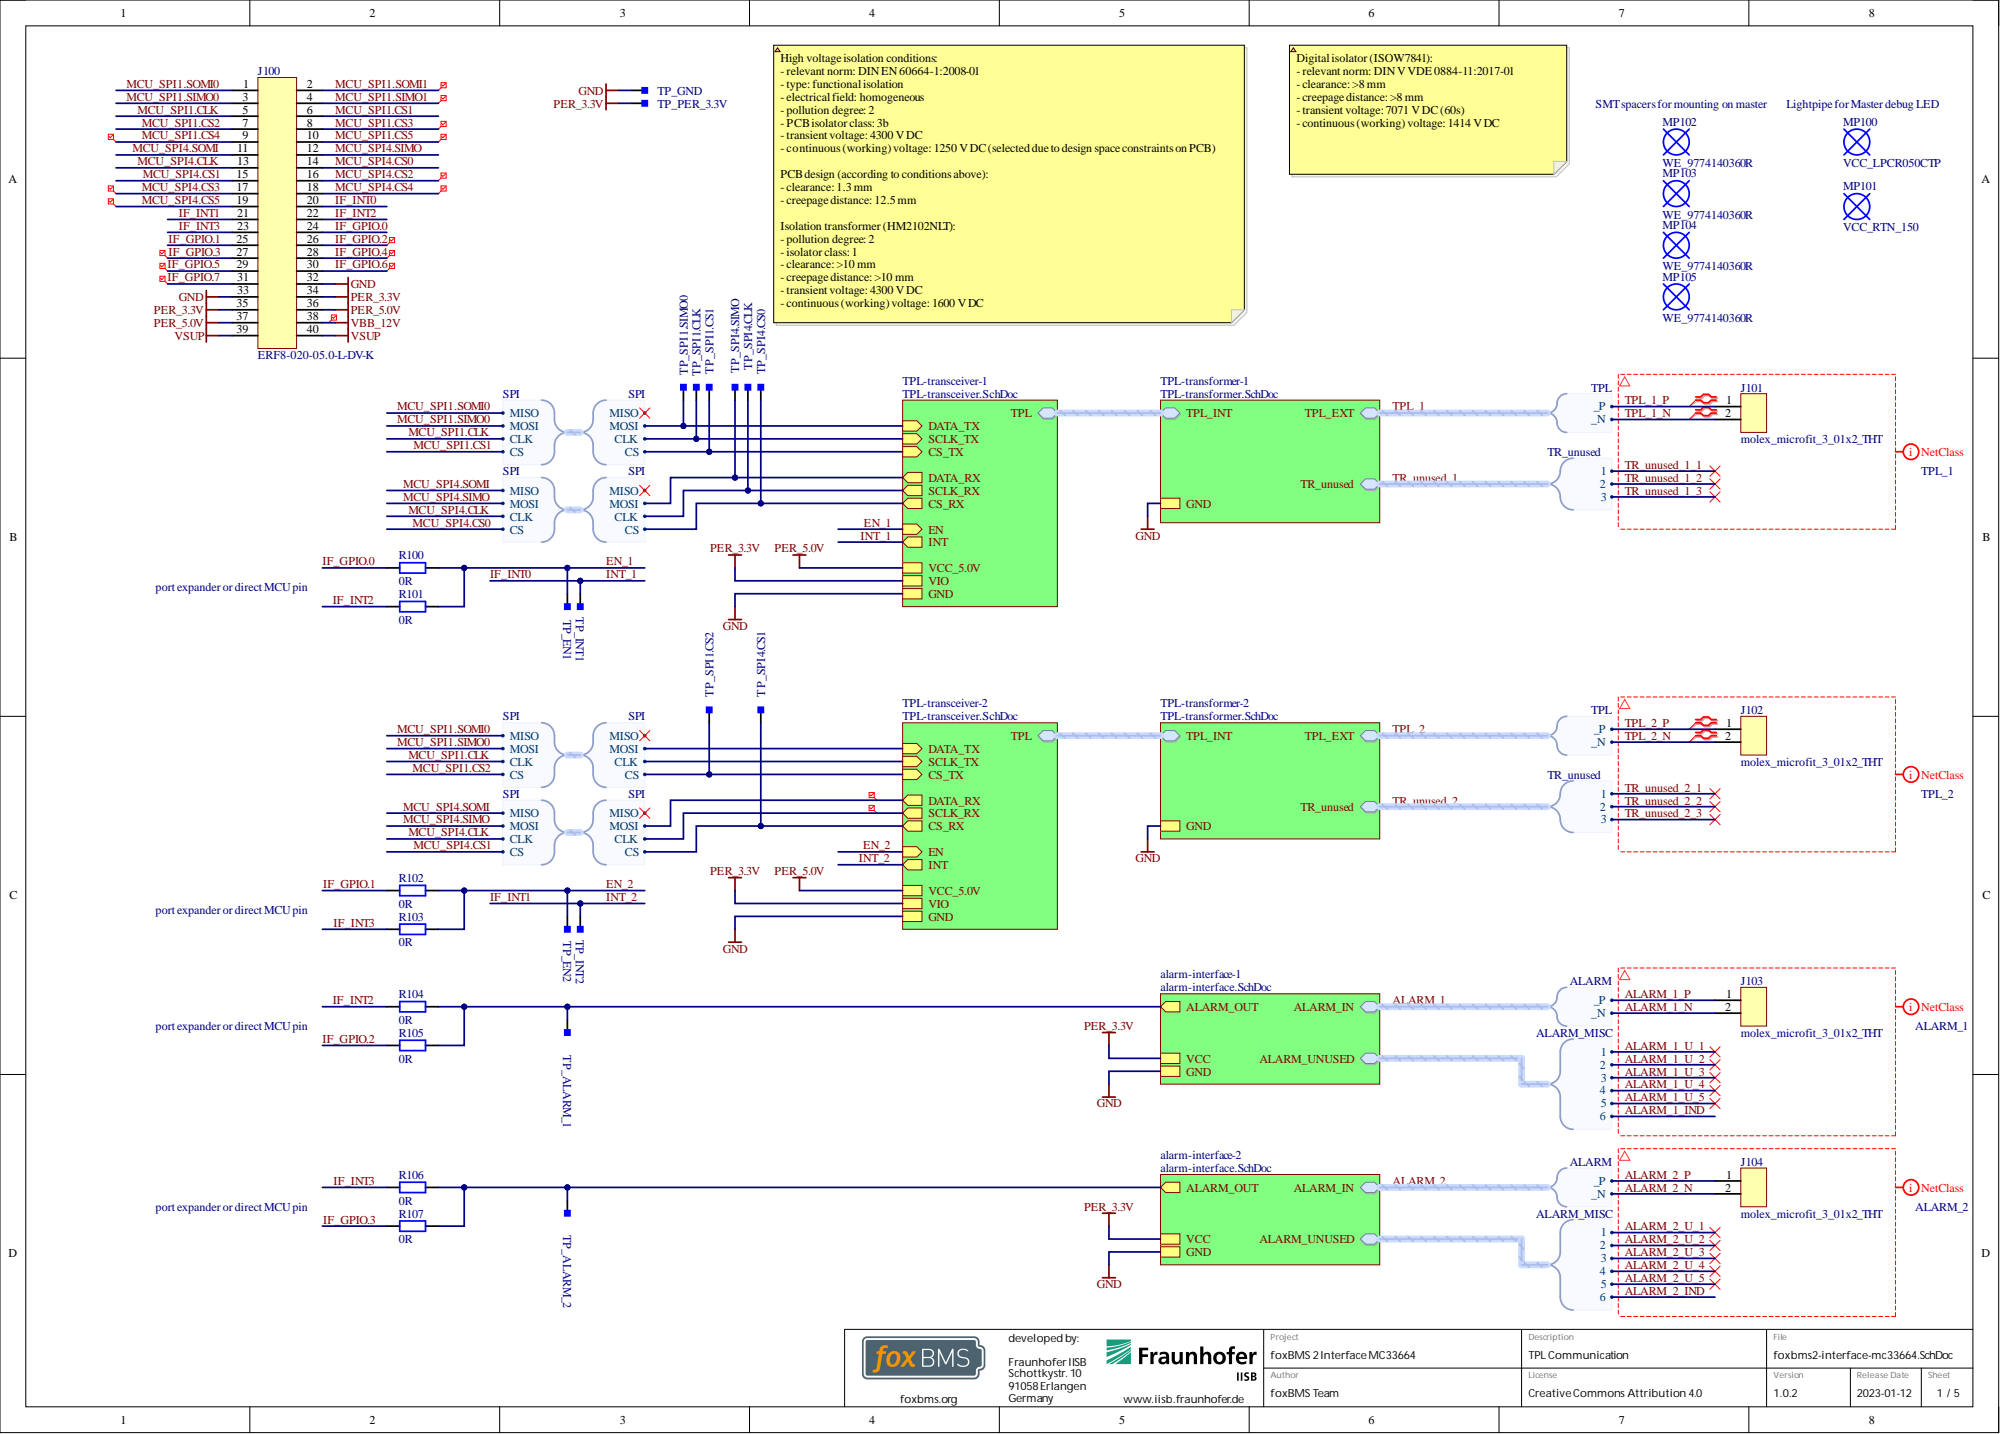
[picture p101: page 1]

cted due to de

35 | 36
37 | 38



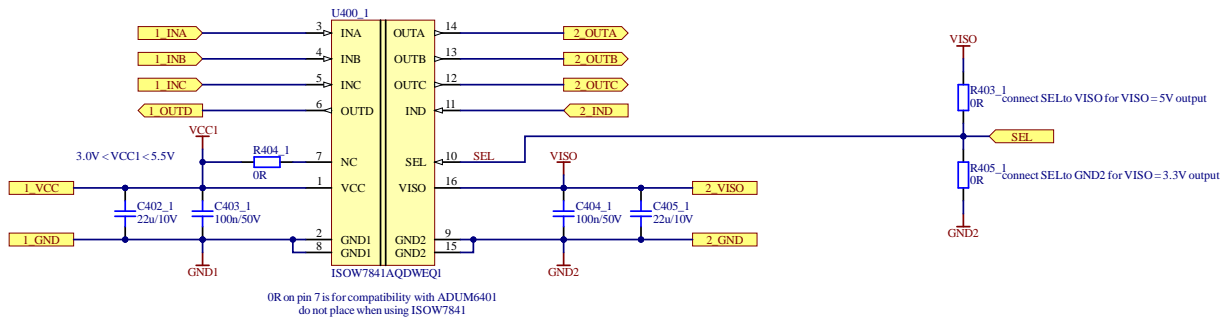
[picture p102: page 4]

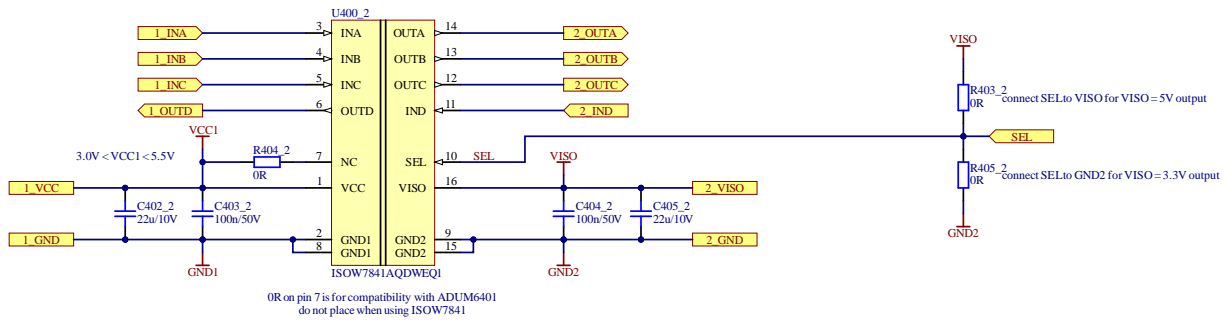
[picture p103: page 5]


www.iisb.fraunhofer.de


www.iisb.fraunhofer.de
