emiln2002/BMS/slave_v2/Assembly foxBMS_14cell_BMS-Slave_NXP775A/pdf/placement-plan.PDF

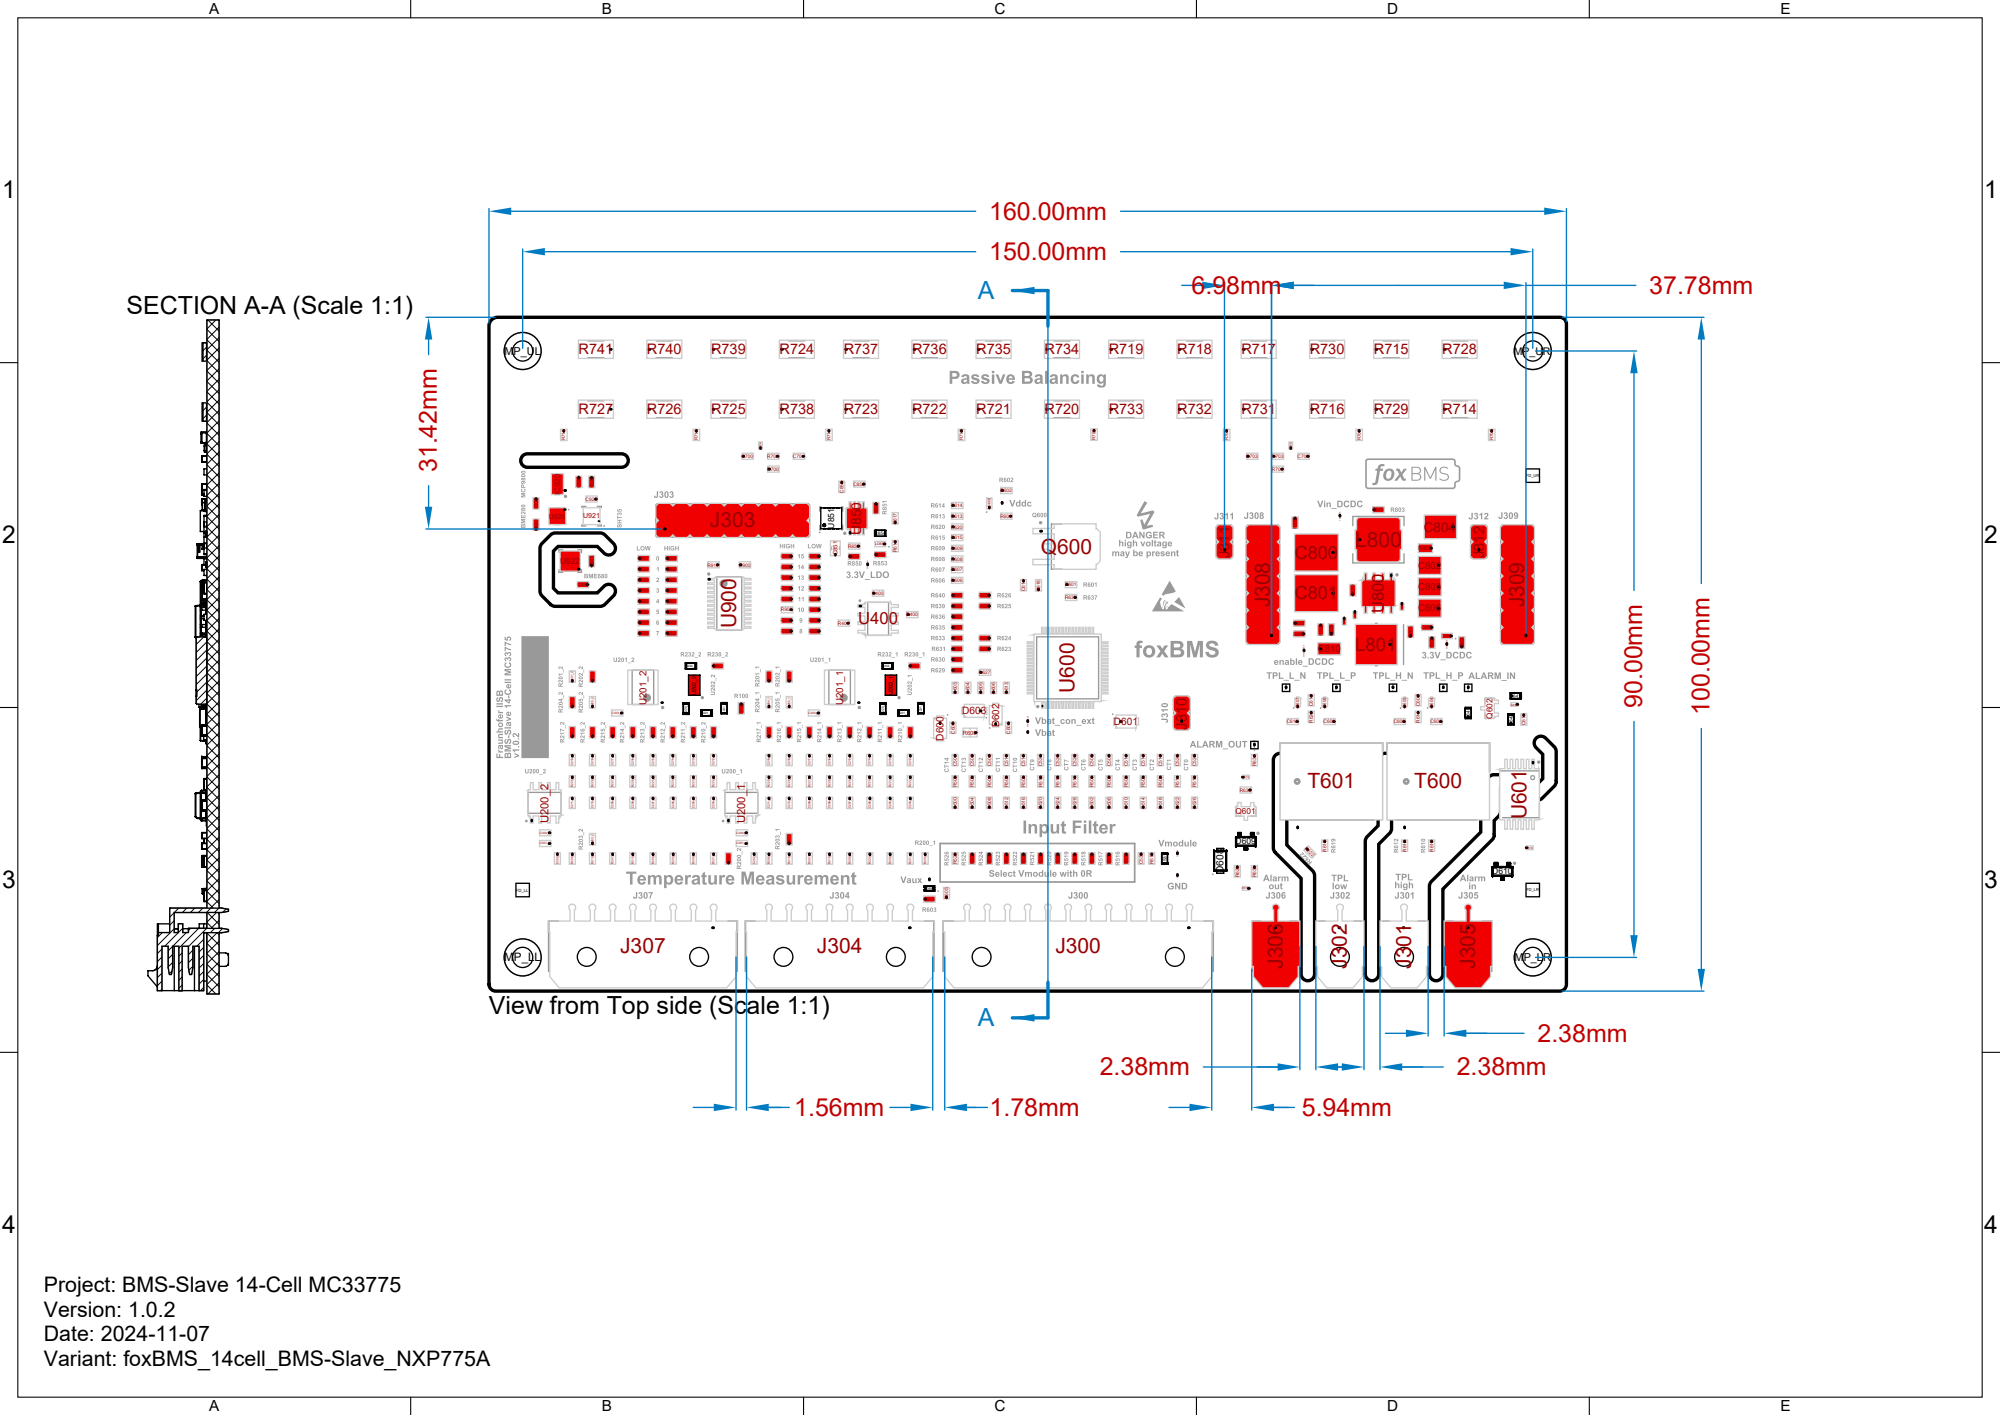
[picture p104: page 1]

A View from Top side (Scale 1:1)

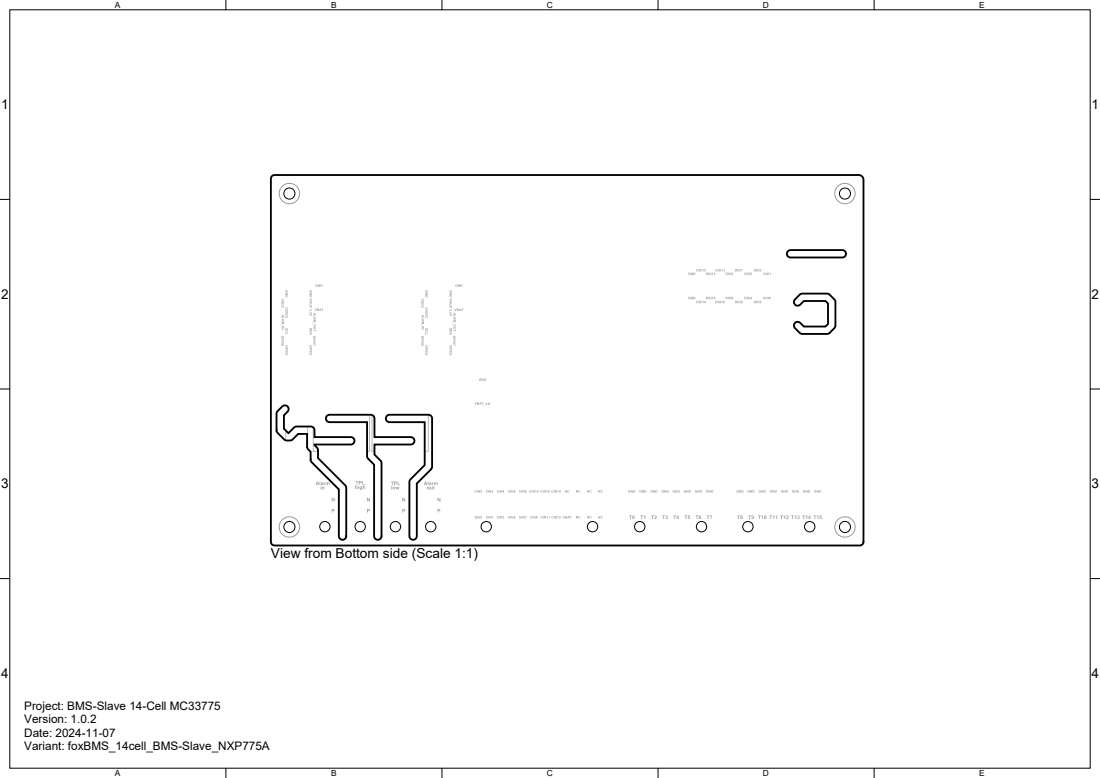
[picture p105: page 2]

View from Bottom side (Scale 1:1)
