emiln2002/BMS/(list of files, drawings)

Other design files:
interface-nxp-mc33664-v1.0.2/Sources/alarm-interface.SchDoc
interface-nxp-mc33664-v1.0.2/Sources/digital-isolator-3in-1out-power.SchDoc
interface-nxp-mc33664-v1.0.2/Sources/foxbms2-interface-mc33664.PrjPcb
interface-nxp-mc33664-v1.0.2/Sources/foxbms2-interface-mc33664.SchDoc
interface-nxp-mc33664-v1.0.2/Sources/TPL-transceiver.SchDoc
interface-nxp-mc33664-v1.0.2/Sources/TPL-transformer.SchDoc
master-v1.2.3-0/Sources/buck-boost-converter.SchDoc
master-v1.2.3-0/Sources/can-transceiver.SchDoc
master-v1.2.3-0/Sources/can.SchDoc
master-v1.2.3-0/Sources/clock.SchDoc
master-v1.2.3-0/Sources/communication.SchDoc
master-v1.2.3-0/Sources/connectors-extension.SchDoc
master-v1.2.3-0/Sources/connectors-external-old.SchDoc
master-v1.2.3-0/Sources/connectors-external.SchDoc
master-v1.2.3-0/Sources/connectors-interface.SchDoc
master-v1.2.3-0/Sources/connectors-internal.SchDoc
master-v1.2.3-0/Sources/contactor-feedback-divider.SchDoc
master-v1.2.3-0/Sources/contactor-feedback.SchDoc
master-v1.2.3-0/Sources/digital-isolator-3in-1out-power.SchDoc
master-v1.2.3-0/Sources/ethernet-phy.SchDoc
master-v1.2.3-0/Sources/ethernet.SchDoc
master-v1.2.3-0/Sources/flash.SchDoc
master-v1.2.3-0/Sources/foxbms2-master.PrjPcb
master-v1.2.3-0/Sources/foxbms2-master.SchDoc
master-v1.2.3-0/Sources/fram.SchDoc
master-v1.2.3-0/Sources/insulation-monitoring.SchDoc
master-v1.2.3-0/Sources/interlock.SchDoc
master-v1.2.3-0/Sources/io-devices.SchDoc
master-v1.2.3-0/Sources/io-matrix.SchDoc
master-v1.2.3-0/Sources/mcu-adc.SchDoc
master-v1.2.3-0/Sources/mcu-com-gpio-tim.SchDoc
master-v1.2.3-0/Sources/mcu-emif-etm-dmm.SchDoc
master-v1.2.3-0/Sources/mcu-misc.SchDoc
master-v1.2.3-0/Sources/mcu-supply.SchDoc
master-v1.2.3-0/Sources/mcu.SchDoc
master-v1.2.3-0/Sources/memory.SchDoc
master-v1.2.3-0/Sources/mram.SchDoc
master-v1.2.3-0/Sources/oscillator-20MHz.SchDoc
master-v1.2.3-0/Sources/oscillator-25MHz.SchDoc
master-v1.2.3-0/Sources/peripherals.SchDoc
master-v1.2.3-0/Sources/port-expander.SchDoc
master-v1.2.3-0/Sources/port-expanders.SchDoc
master-v1.2.3-0/Sources/rs232-rs485-transceiver.SchDoc
master-v1.2.3-0/Sources/rtc.SchDoc
master-v1.2.3-0/Sources/sbc-base.SchDoc
master-v1.2.3-0/Sources/sbcs.SchDoc
master-v1.2.3-0/Sources/sensor-hum-temp.SchDoc
master-v1.2.3-0/Sources/smart-switch.SchDoc
master-v1.2.3-0/Sources/smart-switches.SchDoc
master-v1.2.3-0/Sources/supply-protection.SchDoc
master-v1.2.3-0/Sources/supply.SchDoc
master-v1.2.3-0/Sources/uart.SchDoc
master-v1.2.3-0/Sources/voltage-reference-5.0V.SchDoc
master-v1.2.3-0/Sources/window-watchdog.SchDoc
Slave-18-cell/Sources/analog_in.SchDoc
Slave-18-cell/Sources/bat_connectors.SchDoc
Slave-18-cell/Sources/cell_fuses.SchDoc
Slave-18-cell/Sources/connectors.SchDoc
Slave-18-cell/Sources/daisy_chain_connectors.SchDoc
Slave-18-cell/Sources/dcdc_converter.SchDoc
Slave-18-cell/Sources/digital_io.SchDoc
Slave-18-cell/Sources/eeprom_temp_sens.SchDoc
Slave-18-cell/Sources/ext_supply.SchDoc
Slave-18-cell/Sources/ext_supply_con.SchDoc
Slave-18-cell/Sources/feedback.SchDoc
Slave-18-cell/Sources/hierarchy.SchDoc
Slave-18-cell/Sources/input_filter.SchDoc
Slave-18-cell/Sources/LTC.SchDoc
Slave-18-cell/Sources/passive_balancing.SchDoc
Slave-18-cell/Sources/slave-18-ltc6813-1.PrjPcb
Slave-18-cell/Sources/slave.PcbDoc
slave_v2/Sources/analog_in.SchDoc
slave_v2/Sources/connectors.SchDoc
slave_v2/Sources/dcdc-converter.SchDoc
slave_v2/Sources/digital_io.SchDoc
slave_v2/Sources/eeprom.SchDoc
slave_v2/Sources/input_filter.SchDoc
slave_v2/Sources/ldo.SchDoc
slave_v2/Sources/mc33775.SchDoc
slave_v2/Sources/passive_balancing.SchDoc
slave_v2/Sources/sensors.SchDoc
slave_v2/Sources/slave-14-mc33775.PcbDoc
slave_v2/Sources/slave-14-mc33775.SchDoc
slave_v2/Sources/slave_v2.PrjPcb
