emiln2002/BMS/BMS_Slave_KiCad/slave-14-mc33775.kicad_pcb

## KiCad design BMS_Slave_KiCad/slave-14-mc33775.kicad_pcb (2026-02-12)

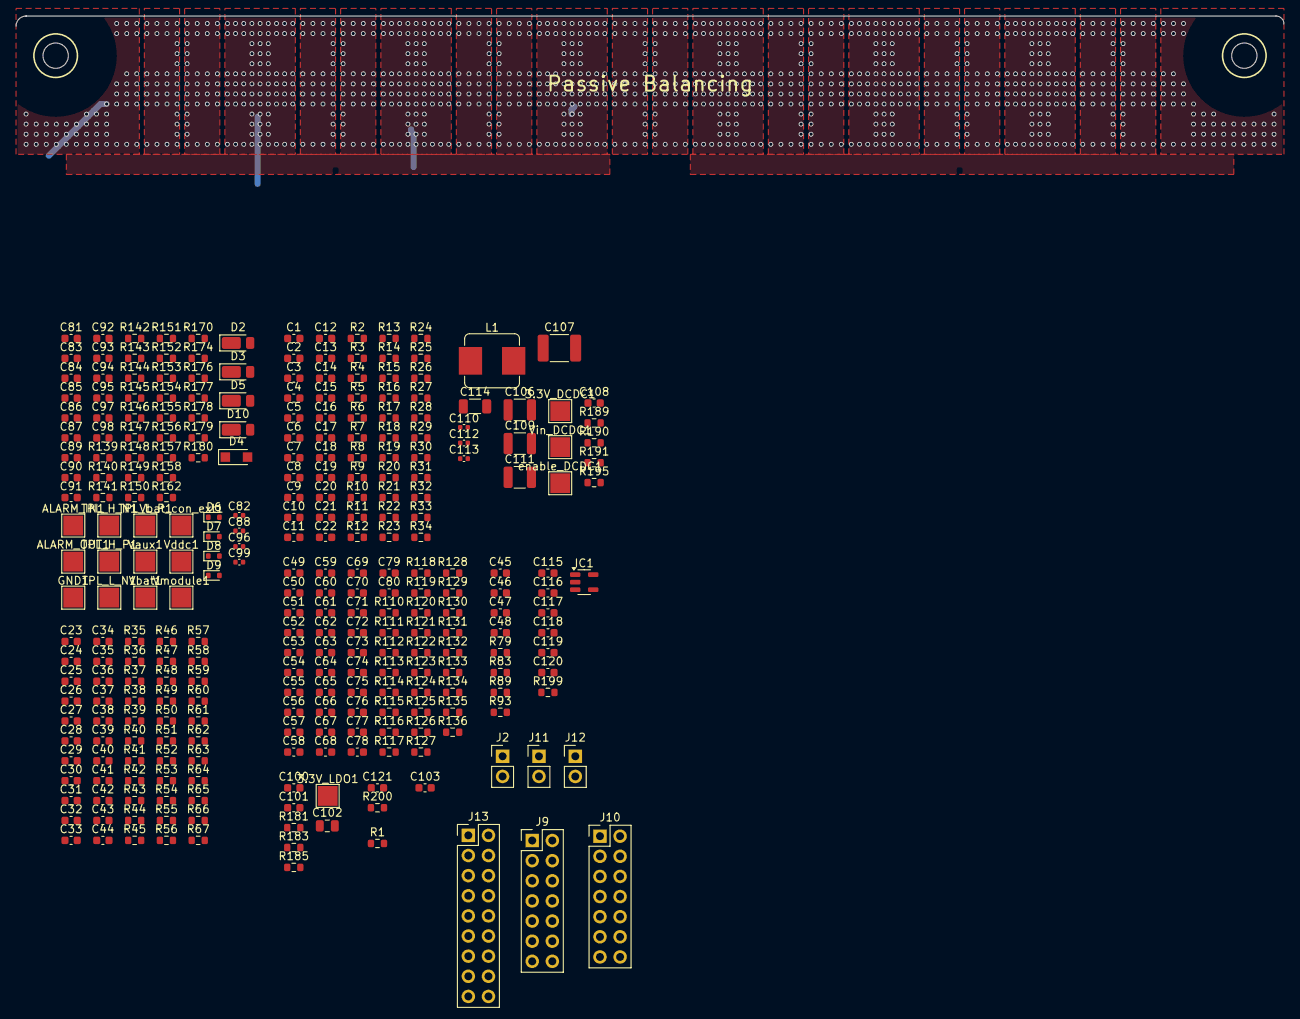
[picture p108: board slave-14-mc33775.kicad_pcb from above]

Board: 6 copper layers, 289 parts (0 on the bottom side), 123 nets.

Parts:
3.3V_DCDC1, 3.3V_LDO1: Testpoint_Square; TestPoint_Pad_2.5x2.5mm
ALARM_IN1: Testpoint_Square; TestPoint_Pad_2.5x2.5mm
ALARM_OUT1: Testpoint_Square; TestPoint_Pad_2.5x2.5mm
C1, C2, C3, C4, C5, C6, C7, C8, C9, C10, C11, C12, C13, C14, C15, C16, C17, C18, C19, C20, C21, C22, C23, C24, C25, C26, C27, C28, C29, C30, C31, C32, C33, C34, C35, C36, C37, C38, C39, C40, C41, C42, C43, C44, C45, C46, C47, C48, C49, C50, C51, C52, C53, C54, C55, C56, C57, C58, C59, C60, C61, C62, C63, C64, C65, C66, C67, C68, C69, C70, C71, C72, C73, C74, C75, C76, C77, C78, C79, C80, C81, C83, C84, C85, C86, C87, C89, C90, C91, C92, C93, C94, C95, C97, C98, C100, C101, C103, C108, C115, C116, C117, C118, C119, C120, C121: 10 nF; C_0603_1608Metric
C82, C88, C96, C99, C110, C112, C113: 22pF; C_0402_1005Metric
C102: 2.2uF; C_0805_2012Metric
C106, C109, C111: 2.2uF; C_1210_3225Metric
C107: 3.3uF; C_1812_4532Metric
C114: 22u; C_1206_3216Metric
D2, D3, D10: Schottky_100V_1A; D_PowerDI-123
D4: PTVS60VS1UR; Nexperia_CFP3_SOD-123W
D5: S1MSP1-7; D_PowerDI-123
D6, D7, D8, D9: PESD5V0V1BB; D_SOD-523
GND1: Testpoint_Square; TestPoint_Pad_2.5x2.5mm
IC1: MCP9800A0T-M/OT; SOT-23-5
J2, J11, J12: Pinheader_2x1_vertical; PinHeader_1x02_P2.54mm_Vertical
J9, J10: Pinheader_2x7_vertical; PinHeader_2x07_P2.54mm_Vertical
J13: Pinheader_2x9_vertical; PinHeader_2x09_P2.54mm_Vertical
L1: 470nH; L_Bourns_SRP7028A_7.3x6.6mm
MP_UL: Hole_3.2_Iso
MP_UR: Hole_3.2_Iso
R1, R10, R11, R20, R21, R22, R23, R24, R25, R26, R27, R28, R29, R30, R32, R33, R34, R43, R44, R53, R54, R55, R56, R57, R58, R59, R60, R61, R62, R63, R65, R66, R67, R110, R111, R112, R113, R114, R115, R116, R117, R126, R127, R128, R139, R140, R141, R142, R143, R144, R145, R146, R147, R148, R149, R150, R151, R152, R153, R154, R155, R156, R157, R158, R162, R170, R174, R176, R177, R178, R179, R180, R181, R183, R185, R189, R191, R195: 0; R_0603_1608Metric
R2, R3, R4, R5, R6, R7, R8, R9, R35, R36, R37, R38, R39, R40, R41, R42, R79, R83, R89, R93, R118, R119, R120, R121, R122, R123, R124, R125, R129, R130, R131, R132, R133, R134, R135, R136, R190, R199, R200: 10K; R_0603_1608Metric
R12, R13, R14, R15, R16, R17, R18, R19, R31, R45, R46, R47, R48, R49, R50, R51, R52, R64: 1K; R_0603_1608Metric
TPL_H_N1: Testpoint_Square; TestPoint_Pad_2.5x2.5mm
TPL_H_P1: Testpoint_Square; TestPoint_Pad_2.5x2.5mm
TPL_L_N1: Testpoint_Square; TestPoint_Pad_2.5x2.5mm
TPL_L_P1: Testpoint_Square; TestPoint_Pad_2.5x2.5mm
Vaux1: Testpoint_Square; TestPoint_Pad_2.5x2.5mm
Vbat1: Testpoint_Square; TestPoint_Pad_2.5x2.5mm
Vbat_con_ext1: Testpoint_Square; TestPoint_Pad_2.5x2.5mm
Vddc1: Testpoint_Square; TestPoint_Pad_2.5x2.5mm
Vin_DCDC1: Testpoint_Square; TestPoint_Pad_2.5x2.5mm
Vmodule1: Testpoint_Square; TestPoint_Pad_2.5x2.5mm
enable_DCDC1: Testpoint_Square; TestPoint_Pad_2.5x2.5mm

Connections:
+3.3V: 3.3V_DCDC1.1, C113.2, C114.2, C120.2, J9.10, J10.10, R195.2
/U_analog_in_bank0/A0: R29.1, R30.2
/U_analog_in_bank0/A1: R33.1, R34.2
/U_analog_in_bank0/D: R27.1, R32.1
/U_analog_in_bank0/D_amp: R27.2, R31.1
/U_analog_in_bank0/MUX-DATA_IN: R1.1, R32.2
/U_analog_in_bank0/S1: C12.2, R12.1, R20.1
/U_analog_in_bank0/S2: C13.2, R13.1, R21.1
/U_analog_in_bank0/S3: C14.2, R14.1, R22.1
/U_analog_in_bank0/S4: C15.2, R15.1, R23.1
/U_analog_in_bank0/S5: C16.2, R16.1, R24.1
/U_analog_in_bank0/S6: C17.2, R17.1, R25.1
/U_analog_in_bank0/S7: C18.2, R18.1, R26.1
/U_analog_in_bank0/S8: C19.2, R19.1, R28.1
/U_analog_in_bank0/T-SENSOR_0: C1.2, R9.1, R12.2
/U_analog_in_bank0/T-SENSOR_1: C3.2, R8.1, R13.2
/U_analog_in_bank0/T-SENSOR_2: C4.2, R7.1, R14.2
/U_analog_in_bank0/T-SENSOR_3: C5.2, R6.1, R15.2
/U_analog_in_bank0/T-SENSOR_4: C6.2, R5.1, R16.2
/U_analog_in_bank0/T-SENSOR_5: C8.2, R4.1, R17.2
/U_analog_in_bank0/T-SENSOR_6: C10.2, R3.1, R18.2
/U_analog_in_bank0/T-SENSOR_7: C11.2, R2.1, R19.2
/U_analog_in_bank0/T_FILT0: R20.2, R155.1
/U_analog_in_bank0/T_FILT1: R21.2, R141.1
/U_analog_in_bank0/T_FILT2: R22.2, R156.1
/U_analog_in_bank0/T_FILT3: R23.2, R142.1
/U_analog_in_bank0/T_FILT4: R24.2, R157.1
/U_analog_in_bank0/T_FILT5: R25.2, R143.1
/U_analog_in_bank0/T_FILT6: R26.2, R158.1
/U_analog_in_bank0/T_FILT7: R28.2, R144.1
/U_analog_in_bank1/A0: R62.1, R63.2
/U_analog_in_bank1/A1: R66.1, R67.2
/U_analog_in_bank1/D: R60.1, R65.1
/U_analog_in_bank1/D_amp: R60.2, R64.1
/U_analog_in_bank1/S1: C34.2, R45.1, R53.1
/U_analog_in_bank1/S2: C35.2, R46.1, R54.1
/U_analog_in_bank1/S3: C36.2, R47.1, R55.1
/U_analog_in_bank1/S4: C37.2, R48.1, R56.1
/U_analog_in_bank1/S5: C38.2, R49.1, R57.1
/U_analog_in_bank1/S6: C39.2, R50.1, R58.1
/U_analog_in_bank1/S7: C40.2, R51.1, R59.1
/U_analog_in_bank1/S8: C41.2, R52.1, R61.1
/U_analog_in_bank1/T-SENSOR_0: C23.2, R42.1, R45.2
/U_analog_in_bank1/T-SENSOR_1: C25.2, R41.1, R46.2
/U_analog_in_bank1/T-SENSOR_2: C26.2, R40.1, R47.2
/U_analog_in_bank1/T-SENSOR_3: C27.2, R39.1, R48.2
/U_analog_in_bank1/T-SENSOR_4: C28.2, R38.1, R49.2
/U_analog_in_bank1/T-SENSOR_5: C30.2, R37.1, R50.2
/U_analog_in_bank1/T-SENSOR_6: C32.2, R36.1, R51.2
/U_analog_in_bank1/T-SENSOR_7: C33.2, R35.1, R52.2
/U_connectors/ALARM_IN: ALARM_IN1.1, J9.7, J10.7, R146.1
/U_connectors/ALARM_OUT: ALARM_OUT1.1, J9.8, J10.8
/U_connectors/CIN0: C73.2, R136.2
/U_connectors/CIN1: C72.2, R135.2
/U_connectors/CIN2: C71.2, R134.2
/U_connectors/CIN3: C70.2, R133.2
/U_connectors/CIN4: C69.2, R110.1, R132.2
/U_connectors/CIN5: C68.2, R111.1, R131.2
/U_connectors/CIN6: C67.2, R112.1, R130.2
/U_connectors/CIN7: C56.2, R113.1, R125.2
/U_connectors/CIN8: C55.2, R114.1, R124.2
/U_connectors/CIN9: C54.2, R115.1, R123.2
/U_connectors/CIN10: C53.2, R116.1, R122.2
/U_connectors/CIN11: C52.2, R117.1, R121.2
/U_connectors/CIN12: C51.2, R120.2, R126.1
/U_connectors/CIN13: C50.2, R119.2, R127.1
/U_connectors/CIN14: C49.2, R118.2, R128.1
/U_connectors/DIGITAL-IO_2: IC1.3 (ALERT), J13.3, R199.1
/U_connectors/GPIO2_ext: J9.1, J10.1
/U_connectors/GPIO3_ext: J9.2, J10.2
/U_connectors/GPIO6_ext: J9.3, J10.3
/U_connectors/GPIO7_ext: J9.4, J10.4
/U_connectors/SCL: J9.5, J10.5
/U_connectors/SDA: J9.6, J10.6
/U_dcdc-converter/EnableDC/DC: R176.2, R189.1
/U_dcdc-converter/Enable_DCDC: R189.2, R190.1, enable_DCDC1.1
/U_dcdc-converter/VBAT_con_ext_emi: C106.2, C108.2, C109.2, C111.2, L1.2, R191.2, Vin_DCDC1.1
/U_dcdc-converter/VBAT_con_ext_lim: L1.1, R191.1
/U_input_filter/CT0: C80.2, R136.1
/U_input_filter/CT1: C79.2, R135.1
/U_input_filter/CT2: C78.2, R134.1
/U_input_filter/CT3: C77.2, R133.1
/U_input_filter/CT4: C76.2, R132.1
/U_input_filter/CT5: C75.2, R131.1
/U_input_filter/CT6: C74.2, R130.1
/U_input_filter/CT7: C64.2, R125.1
/U_input_filter/CT8: C63.2, R124.1
/U_input_filter/CT9: C62.2, R123.1
/U_input_filter/CT10: C61.2, R122.1
/U_input_filter/CT11: C60.2, R121.1
/U_input_filter/CT12: C59.2, R120.1
/U_input_filter/CT13: C58.2, R119.1
/U_input_filter/CT14: C57.2, R118.1
/U_input_filter/Vmodule_unfiltered: C65.2, R110.2, R111.2, R112.2, R113.2, R114.2, R115.2, R116.2, R117.2, R126.2, R127.2, R128.2, R129.2
/U_mc33775/BAL_NTC0: C46.2, R83.1, R149.1
/U_mc33775/BAL_NTC1: C48.2, R93.1, R150.1
/U_mc33775/GPIO0: R145.2, R155.2
/U_mc33775/GPIO1: R141.2, R146.2
/U_mc33775/GPIO2: R147.2, R153.2, R156.2
/U_mc33775/GPIO3: R139.2, R142.2, R149.2
/U_mc33775/GPIO4: R151.2, R157.2
/U_mc33775/GPIO5: R143.2, R152.2
/U_mc33775/GPIO6: R148.2, R154.2, R158.2
/U_mc33775/GPIO7: R140.2, R144.2, R150.2
/U_mc33775/MUX_DATA: C22.2, R31.2, R145.1
/U_mc33775/MUX_DATA2: C44.2, R1.2, R64.2, R147.1
/U_mc33775/RXTXH_N: C93.1, D7.1 (C), TPL_H_N1.1
/U_mc33775/RXTXH_P: C92.2, D6.1 (C), TPL_H_P1.1
/U_mc33775/RXTXL_N: C95.1, D9.1 (C), TPL_L_N1.1
/U_mc33775/RXTXL_P: C94.2, D8.1 (C), TPL_L_P1.1
GND: C1.1, C2.1, C3.1, C4.1, C5.1, C6.1, C7.1, C8.1, C9.1, C10.1, C11.1, C12.1, C13.1, C14.1, C15.1, C16.1, C17.1, C18.1, C19.1, C20.1, C21.1, C22.1, C23.1, C24.1, C25.1, C26.1, C27.1, C28.1, C29.1, C30.1, C31.1, C32.1, C33.1, C34.1, C35.1, C36.1, C37.1, C38.1, C39.1, C40.1, C41.1, C42.1, C43.1, C44.1, C45.1, C46.1, C47.1, C48.1, C49.1, C50.1, C51.1, C52.1, C53.1, C54.1, C55.1, C56.1, C57.1, C58.1, C59.1, C60.1, C61.1, C62.1, C63.1, C64.1, C65.1, C66.1, C67.1, C68.1, C69.1, C70.1, C71.1, C72.1, C73.1, C74.1, C75.1, C76.1, C77.1, C78.1, C79.1, C80.1, C81.1, C83.1, C84.1, C85.1, C86.1, C87.1, C88.1, C89.1, C90.1, C91.1, C92.1, C93.2, C94.1, C95.2, C96.1, C97.1, C98.1, C100.1, C101.1, C102.1, C103.1, C106.1, C107.1, C108.1, C109.1, C111.1, C114.1, C115.1, C116.1, C117.1, C118.1, C119.1, C120.1, C121.1, D4.2 (A), D6.2 (A), D7.2 (A), D8.2 (A), D9.2 (A), GND1.1, IC1.2 (GND), J2.2, J9.13, J9.14, J10.13, J10.14, J11.2, J12.2, J13.17, J13.18, R30.1, R34.1, R63.1, R67.1, R190.2
unnamed: C2.2, R2.2, R3.2, R4.2, R5.2, R6.2, R7.2, R8.2, R9.2, R10.1, R11.1
unnamed: C24.2, R35.2, R36.2, R37.2, R38.2, R39.2, R40.2, R41.2, R42.2, R43.1, R44.1
unnamed: C45.2, R79.1, R83.2
unnamed: C47.2, R89.1, R93.2
unnamed: C112.2, C113.1
VAUX: C85.2, C87.2, C89.2, C91.2, J9.12, J10.12, R10.2, R43.2, R79.2, R89.2, R174.2, Vaux1.1
VBAT: C83.2, Vbat1.1
VBAT_con_ext: C81.2, D2.1 (K), D3.1 (K), D4.1 (C), D5.1 (K), J11.1, J12.1, Vbat_con_ext1.1
VBAT_ext: D3.2 (A), J2.1
VDDC: C7.2, C9.2, C29.2, C31.2, C84.2, C86.2, C100.2, D10.2 (A), J9.11, J10.11, R162.2, R170.2, R176.1, R181.2, Vddc1.1
VDDIO: 3.3V_LDO1.1, C20.2, C21.2, C42.2, C43.2, C102.2, C103.2, C115.2, C116.2, C117.2, C118.2, C119.2, C121.2, IC1.1 (VDD), J9.9, J10.9, R29.2, R33.2, R62.2, R66.2, R162.1, R183.2, R185.1, R185.2, R199.2, R200.1
VMODULE: C66.2, R129.1, Vmodule1.1
