emiln2002/BMS/(commit log)

2025-12-10 addet output files
    [foxbms2-master.PrjPcb, slave-14-mc33775.PrjPcb]
2026-01-15 Commit update
    [foxbms2-master.SchDoc]
2026-02-12 nu i KiCad
    [analog_in.kicad_sch, connectors.kicad_sch, dcdc-converter.kicad_sch, digital_io.kicad_sch, eeprom.kicad_sch, input_filter.kicad_sch, ldo.kicad_sch, mc33775.kicad_sch]
2026-02-12 noget af diagram tegningen er opdateret, vi fortsætter
    [KCM55WR72A156MH01K.step, analog_in.kicad_sch, dcdc-converter.kicad_sch, digital_io.kicad_sch, eeprom.kicad_sch, input_filter.kicad_sch, ldo.kicad_sch, mc33775.kicad_sch]
2026-02-12 Updated footprints - halfway done
    [Fabrication Testpoint Report for slave-14-mc33775.csv, Pick Place for foxbms2-master.csv, Pick Place for slave-14-mc33775(foxBMS_14cell_BMS-Slave_NXP775A).csv, Pick Place for slave-14-mc33775(foxBMS_14cell_BMS-Slave_NXP775A_minimal).csv, Pick Place for slave-14-mc33775.csv, analog_in.SchDoc, bom-online-slave-14-mc33775(foxBMS_14cell_BMS-Slave_NXP775A).xlsx, bom-online-slave-14-mc33775(foxBMS_14ce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]
2026-02-16 jeg har tilføjet 18 celles bms slave, men jeg har problemer med altium og kan derfor ikke redigere det... Der er 6 2-pins stik, 2 16-pins og 1 24-pins stik der skal laves om til wurt stik. Det bør ku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
    [Fabrication Testpoint Report for slave.csv, LTC.SchDoc, Pick Place for slave(automotive).csv, Pick Place for slave(automotive_single-AFE).csv, analog_in.SchDoc, bat_connectors.SchDoc, bom-online-slave-18-ltc6813-1(automotive).xlsx, bom-online-slave-18-ltc6813-1(automotive_single-AFE).xlsx]
2026-03-07 Skiftet connektors på slave
    [bat_connectors.SchDoc, cell_fuses.SchDoc, connectors.SchDoc, daisy_chain_connectors.SchDoc, ext_supply.SchDoc, ext_supply_con.SchDoc, slave-18-ltc6813-1.PrjPcb, slave.PcbDoc]
2026-03-08 Jeg har conetet de nederste stik hvor de skal være, så skal der laves plads til de 3 sidste (X400, X401, X900). Jeg er i gang med X400 og X401.
    [bat_connectors.SchDoc, connectors.SchDoc, slave-18-ltc6813-1.PrjPcb, slave.PcbDoc]
2026-03-18 De sidste stik er routed, der mangler stadig noget oprydning og så skal der findes en god måde at måle den præcise lokation på.
    [ext_supply.SchDoc, slave-18-ltc6813-1.PrjPcb, slave.PcbDoc]
2026-04-08 all relevent problems from drc is fixed, shoud be redy for rewiv
    [slave.PcbDoc]
2026-05-06 Depopulation of components
    [Pick Place for slave(automotive).csv, Pick Place for slave(automotive_single-AFE).csv, slave-18-ltc6813-1.PrjPcb, slave.PcbDoc]
